huatanshaonian/EL-center/README.md

# MIS-01 复古终端：第一轮布局与零件模型

> **2026-10-20 注意：本文第 2、3 节描述的是第一轮布局，已经过时。** 现行资料：面板与斜面布局见 `面板方案.md`（布局 E11），整机分层与电源控制见 `MIS-01整机架构.md`，零件与型号见 `parts_list.csv`，机内空间见 `PCB安装与空间规划建议.md`，EL 显示见 `Sharp_LJ64K052_HDMI_EL_Engineering_Design_Note.md`。
> 与现状不符的主要几处：电源已是 **LRS-200-24 + NID100-12 + NID100-5**（不是 LRS-150-24 / NID65-12）；编码器等操作件已移到前下方斜面；盖革管定为 J305 + 自制盖革板（不是 SI-3BG / SBM-21）；仪表层控制器是 **ESP32-S3**。

单位均为 mm。生成工具为 CadQuery 2.8，所有零件都是参数化脚本，改 `parts.py` 里的 `SPEC` 后重新运行 `build_parts.py` 和 `assembly.py` 即可重新生成。

## 1. 文件

| 文件 | 内容 |
|---|---|
| `step/MIS-01_layout_assembly.step` | 整机布局装配体（AP214，105 个零件，带颜色）。SolidWorks 2020 中“打开 → STEP”会以装配体形式导入 |
| `step/parts/P01…P30_*.step` | 单个零件，局部坐标约定见 `parts.py` 文件头 |
| `png/` | 零件一览图、前/后等轴图、正视图、侧视图 |
| `parts.py` / `assembly.py` | 源码（每个零件函数里的 `SPEC` 是尺寸表） |

## 2. 布局方案（外形 320 W × 220 D × 420 H，2020 型材框架）

全局坐标：X 向右，Y 由前向后，Z 向上。框架前沿在 Y = 0，前面板外表面在 Y = −2。

| 区域 | Z 范围 | 内容 |
|---|---|---|
| 顶部 | 178–398 | **Sharp LJ64K052**，居中，前面板开有效显示区视窗；两侧 Z 形铝托架固定在立柱内侧槽上 |
| 管带 | 92–170 | 左侧 6 支 **IN-14**（管心 X = 33/56/83/106/133/156，按 HH:MM:SS 两两分组，管距 23），右侧水平放置的 **IV-18**（X 178–293）；前面板开 276 × 70 管窗 |
| 甲板（Z 90 处 2 mm 铝板） | 92–132 | 管后方是辉光管驱动板（6 片 K155ID1 + NCH6100HV），外加亚克力高压罩；IV-18 电源放在右侧 |
| 下舱 | 0–70 | 前部依次为 2 个 EC11 编码器、盖革管窗（SI-3BG + SBM-21，格栅开孔）、2 个按钮、2 个 SMA；后部左边是 **LRS-200-24**（端子端加亚克力罩），右边是 24 V 配电板 + NID100-12/NID100-5 载板 |
| 电脑层（Z 260 处铝板） | 262–300 | **Orange Pi 4**（接口朝后）、**Tang Primer 20K Dock + 核心板**（接口朝后）；后面板对应开接口窗 |
| 后面板 | — | 2 个 60 mm 排风扇（Z ≈ 340）、IEC C14 插座预留口（右下）、2 个 SMA 预留孔 |

这样布置的考虑：
- **高压隔离**：市电（LRS 端子）留在下舱后部，170 V 辉光管高压在甲板中部，两处都有罩子；前面板操作件只连接低压。
- **散热**：发热较多的 OPi、FPGA 和 EL 驱动板都在上层，靠后面板风扇排风、顶板开孔进风。LRS-200 是自然对流电源，放在底层，上方要留空间。
- **维护**：取下后面板就能拔插电脑层的线缆，三层托板各自可以独立拆装。

当前问题：屏幕背后（Y 30–200，Z 92–260）有大片空间没有利用。如果以后想把机身做小，可以把深度从 220 改到 180 左右，或者把电脑层降到甲板上。对应 `assembly.py` 里的 `D` 和 `Z_SHELF` 两个参数。

## 3. 零件状态（C = 资料确认，T = 暂定，需实物测绘或换官方模型）

| # | 零件 | 建模尺寸 | 状态与依据 | 建议 |
|---|---|---|---|---|
| P01 | Sharp LJ64K052 | 267×220×22 | 外形采用你提供的原厂图（C）；有效区 211.2×158.4 是按 640×480、0.33 点距推算的（T）；安装孔、接口位置为 T | 按原厂机械图修改 `SPEC`：孔位、有效区、接口 |
| P02 | Tang Primer 20K 核心板 | **67.6×30**×1.0 | 长宽为 C（Sipeed Datasheet V1.0，你表中写的 20 应为 30）；厚度和元件高度为 T | 用官方 3D 模型替换 |
| P03 | Tang Primer 20K Dock | 110×80 | **全部为 T**（官方页面没有给出板框尺寸） | **必须**用官方 3D 或实测数据替换 |
| P04 | Orange Pi 4 | 91×56 | 外形为 C；孔位暂按 58×49 孔距，接口位置为 T | 实测 |
| P05 | IN-14 | Ø19×55，13 根引线、长 35 | 外形、引线数为 C（tube-tester.com）；引线分布圆 Ø12 为 T | 实测引线分布 |
| P06 | IV-18 | 总长 115，Ø19 | 为 C（radiomuseum）；引线分布为 T | 实测 |
| P07 | SI-3BG | Ø10×55 | C（pocketmagic）；端帽为 T | — |
| P08 | SBM-21 | Ø6×16，总长 21 | C（pocketmagic） | — |
| P09 | K155ID1 | DIP-16 | 标准封装 | — |
| P10 | LRS-200-24（原 LRS-150-24） | 215×115×30 | 外形按规格书（见 parts_list.csv）；端子位置待实物核对 | 用 TraceParts STEP 替换 |
| P11/12 | NID100-5 / NID100-12（原 NID65-12；明纬正式型号是 NID100-5，没有"-05"） | 50.8×27.5×12 / 50.8×26×11 | 外形为 C；13 针 SIP、2.54 节距为 C；针在长边上的起始位置为 T | 按明纬图纸核对 |
| P13–15 | NCH6100HV、IV-18 电源、盖革高压 | 包络 | T（尚未选型） | 选型后替换 |
| P16, P26–30 | 配电板、EL 托架、管座 PCB、IV-18 PCB、驱动板、盖革 PCB | — | 自设计初版，尺寸由布局反推 | 导入嘉立创 EDA 作为板框参考 |
| P17–25 | 2020 型材、角码、T 螺母、铜柱、EC11、Ø16 按钮、SMA、风扇 | — | 截面和外形按常见规格简化 | 定下供应商后用厂家 CAD 替换 |

## 4. 需要自行下载的官方模型（本环境无法访问这些站点）

- Tang Primer 20K（核心板 + Dock）3D：https://dl.sipeed.com/shareURL/TANG/Primer_20K/08_Dimensions ，尺寸图在 `05_Dimensional_drawing`
- LRS-200-24 STEP：TraceParts 搜索 “LRS-200-24”，或者在明纬官网产品页下载
- 2020 型材、角码：MISUMI 型号 HFS5-2020 系列，或者你选定的国产供应商（注意 6 槽和 8 槽不通用）

替换方法：在 SolidWorks 中打开装配体，右键对应零件选择“替换零部件”，再按局部坐标约定重新配合。

## 5. 安全相关（布局阶段必须保留的）

- LRS 市电端子、IEC 插座到电源之间的走线全程绝缘，并且只在下舱后部走线；整机金属框架接 PE（FG 端子）。
- 170 V 辉光管电源、IV-18 的 20–30 V 电源，以及盖革管 350–460 V 电源都要加罩或者灌封，并在前面板背面留出爬电距离。
- 盖革管工作电压：SI-3BG 380–460 V，SBM-21 350–475 V（来源均为 pocketmagic）。两管电压范围有重叠，可以共用一路约 400 V 高压，但要各自串接阳极电阻。

## 参考

- Sipeed, *Tang Primer 20K Datasheet V1.0*（核心板 67.60 × 30.00 mm）
- MEAN WELL, *LRS-200 Series Specification*；*NID100 Series Specification*
- tube-tester.com, IN-14 data
- radiomuseum.org, IV-18
- pocketmagic.net, SI-3BG / SBM-21
