huatanshaonian/EL-center/Sharp_LJ64K052_HDMI_EL_Engineering_Design_Note.md

# Sharp LJ64K052：HDMI → EL 显示驱动工程设计笔记

版本：v0.3，设计输入 + PCB 任务书  
整理日期：2026-10-17 初稿；2026-10-18 按调研结果修订；2026-10-19 按 EL-IF D1.2 第一版 PCB 同步（Asia/Shanghai）  
目标平台：Orange Pi 4（HDMI 信号源）+ Tang Primer 20K 核心板 + Dock 底板 + 自制低压转接/电源板  
用途：作为原理图、PCB、FPGA 模块划分和分阶段调试的设计依据。**第 15 节是交给画板方（人或 AI）的完整 PCB 任务书，第 16 节是打板前的面包板验证方案。**

> **设计状态：架构已可展开；Dock 引脚分配已按官方原理图 3713 版给出（EL 用到的 Bank 3/7 VCCIO 已按原理图核实为 3.3 V，见 11.2.1）；电源方案已按实际库存（LRS-200-24 + NID100-12 + NID100-5）改写。上电波形验证完成前，不作为已验证的通电定稿。**
>
> **2026-10-20 实测：手上的 Dock 是 v3714，其 HDMI 口没有接收端接，不能直接收 Orange Pi 的 HDMI（见下方 v0.3.1）。**

### v0.3.1 实测更正（2026-10-20，FPGA 首次上板）

1. **Dock 实物为 v3714**（版本丝印在核心板插槽中间，要拔下核心板才看得到）。Sipeed 3714 原理图（2026-05-20，修改说明 "DVI optimize, SW0 and KEY4 pins were swapped"）与 3713 逐页对比：[S9]
   - **P004 HDMI：R15–R22 由 3713 的 49.9 Ω 上拉到 HDMI_3V3（接收端接）改为 499 Ω 下拉到 GND**（只适合做 HDMI 输出）。没有端接时 TMDS 线上没有摆幅：实测 Orange Pi 的 dw-hdmi PHY_STAT0 = 0x03（HPD=1、PHY 锁定、RX_SENSE 全 0），FPGA 的 TMDS 时钟脚完全没有信号（tang-monitor m5 调试程序报 PLL 未锁、重捕获次数 0）。v0.3 写的"3714 小改，此处相同"有误。
   - 第 5 颗键（丝印 S4）改接 **B10 = RECONFIG_N**，按下 FPGA 会重新从 Flash 加载；1 号拨码改接 C7（普通 IO）。"1 号拨码必须拨下"只对 3713 及更早成立。
   - S0–S2（T10/T3/T2）、6 个 LED、PMOD J5/J6/J14、HDMI 引脚分配、Bank 电压与 3713 相同，11.2.1 的分配不受影响。
   - tang-monitor 依据的是 3709 版原理图，它说的"零硬件改动"只在有 49.9 Ω 上拉的老板子上成立。
   - 对策：在 Orange Pi → Dock 的 HDMI 链路上补 8 × 约 50 Ω 上拉到 3.3 V，同时断开 18 脚（见 5.1）。
2. **U12 关闭**：Orange Pi 4（Armbian 26.11 trunk，内核 6.18.56）读得到 FPGA 的 EDID，但拒绝 25.175 MHz 的 640×480（模式列表为空、不输出）；换 27 MHz 自定义时序（总 858×525）后被接受，VPLL 与 dclk_vop0 均为 27 MHz。el_hdmi 给 Orange Pi 用时用 27 MHz 版 EDID。
3. **HDMI 18 脚反向供电**：Dock 的 HDMI_5V 由 +5V 经 D5 送到 18 脚。D5 只挡外部电流倒灌进 Dock，挡不住 Dock 往外送；Orange Pi 没上电时会被 Dock 经 18 脚供电（Pi 电源灯亮）。Pi 开机后它自己的 5V 更高，D5 截止。整机里这条 HDMI 链路应断开 18 脚。
4. apicula 生成的 .fs 缺少高云 `//` 注释头，高云 Programmer 加载不完成（报 "Error found!"）；`fpga/build.sh` 已自动补上（`fpga/scripts/fs_header.py`）。按键、LED（丝印编号与程序编号反序）、串口命令、帧缓存自检均已在实物上通过，详见 `fpga/el_hdmi/使用说明.txt` 第 8 节。

### v0.3 修订摘要（2026-10-19）

与 EL-IF D1.2 原理图和第一版 PCB 同步（详见 `el_driver/D1.2/变更记录_D1.2.txt`）：

1. PCB-1 尺寸由"≤ 80 × 60 mm"改为实际的 **100 × 100 mm**，安装孔中心距板边 5 mm（15.3）。
2. U_VD 限流电阻 RIL12 由 1.3 kΩ（无现货）改为 **1.2 kΩ**，限流 ≈ 2.78 A（原 ≈ 2.56 A）（10.1、15.3）。
3. J_PF 由 2 针改为 **3 针**：增加斜面"屏幕"开关输入 SCR_EN_3V3，开关拨到关时经 D4 硬件关 VD，并经 P3-12（J14-12）告诉 FPGA（11.2.1、15.2、15.3、15.5、15.7）。
4. 新增 J_LAMP：面板"屏幕供电"12 V 指示灯，跟随 +12V_EL（15.3）。
5. （2026-10-20）U03 关闭：按 Sipeed 核心板与 Dock 官方原理图，J5/J6/J14 所在 Bank 3/7 的 VCCIO 为 3.3 V，LVCMOS33 约束正确；v0.2 把 Bank 1 记成 2.5 V 有误，已更正（11.2.1、13）。

### v0.2 修订摘要（2026-10-18）

1. 查阅 Dock 官方原理图（3713）：HDMI 页标注 **HDMI_TX/RX**，接口侧 8 线各有 49.9 Ω 上拉到 HDMI_3V3（接收端接）、交流耦合电容、HPD/DDC/CEC 均接 FPGA；HDMI 5V 由 Dock 经肖特基 D5 输出，信号源 5V 不会反灌 Dock。tang-monitor 声称"零改动"可接收 640×480。[S9][S2]
2. tang-monitor 只报告了 Apple Silicon Mac 作信号源；**Orange Pi 4（RK3399）未验证**，旧版 Rockchip 内核对 25.175 MHz 像素时钟可能拒绝（见 5.1）。[S12]
3. Dock PMOD 电压已查清：J5、J6（B0–B4/HSYNC）、J14 在 Bank 3/7（3.3 V）；J6 的 VSYNC/DE 在 Bank 1（2.5 V），J12 为 DVP（可能 2.5 V）。引脚分配见 11.2。
4. 电源改为实际库存：LRS-200-24 → NID100-12（12 V 7.5 A）/ NID100-5（5 V 11 A）；Dock 自带 12 V DC 插座。见第 10 节。
5. 补充原厂遗漏点：模组内部保险 F1 800 mA、F2/F3 1.6 A（慢断），大容量电源或继电器直通上电的浪涌可能熔断 → **VD、VL 都必须软启动**。[S1，规格 p.16]
6. BSRAM 按块计算后双帧约占 38–40/46 块，偏紧（见 7.1）。
7. 屏型号已由用户确认为 **LJ64K052**（2026-10-18）；`parts.py`、`assembly.py`、`build_parts.py`、`parts_list.csv`、README、面板方案中的 LJ64H052 已统一改为 LJ64K052（3D 尺寸未改，见 11.3）。
8. 新增第 15 节 PCB 任务书、第 16 节面包板验证方案。
9. 术语："Dock"指 Tang Primer 20K 套件中的**扩展底板**（Sipeed 官方名 Tang Primer 20K Dock），FPGA 芯片在插于其上的 SO-DIMM 核心板上。本文"Dock 的 HDMI/PMOD"即底板上的接口。
10. 用户已有示波器，可调电源即将到位（2026-10-18），第 16 节据此调整。

## 1. 阅读规则与资料边界

全文使用以下标记，防止把参考实现和推算误当成屏幕规格：

- **[原厂]**：本次逐页查阅的 Sharp LJ64K052 原厂规格书中的事实，附章节/页码。
- **[参考]**：开源作者或开发板厂商对其板卡/项目的说明，仅在其适用范围内成立。
- **[方案]**：本工程建议采用的实现方式、器件候选和计算结果，尚未经本机实测。
- **[待核实]**：需要实物、完整电路审查、综合报告或仪器测试才能确定的内容。

对话来源为“确认UT61E加光耦USB”，会话 ID：`6ad23500-53d0-83ea-9579-66e5fe57986c`。本次读取接口只返回最后五轮，较早的屏幕讨论、原始上传件与助手正文未取回。因此：本文保留本次任务明确指定的 Tang Primer 20K + Dock、tang-monitor、HDMI2EL 路线；对引脚和参数重新查验公开原始资料，不声称完整复原了旧对话。末尾可见用户选定 ESP32-S3 开发板，但它在显示系统中的接口和职责尚不能从可见历史确认。

本次核心原厂资料为 **Sharp LJ64K052，LA-08203B，2000-08-08**，由第三方镜像保存的原厂扫描件，全文 25 个 PDF 页面。下文“规格 p.N”指纸面右上角页码，**PDF 页码 = 规格页码 + 4**。本文只摘录必要工程事实，原图、完整条件和公差仍以原件为准。[S1]

## 2. 首版设计结论

1. **[原厂]** LJ64K052 是 640 × 480 EL 自发光模组，已有显示控制和高压驱动电路；外部提供 +5 V、+12 V 和 11 路数字输入。项目以完整原装模组为前提，无需自行生成 EL 高压。[S1，规格 p.1、11]
2. **[方案]** 使用 Tang Primer 20K + **Dock** 的 HDMI 接口接收 640 × 480 视频；FPGA 内做单色化、整帧缓存和上下半屏并行扫描；外部转接板完成 5 V 电平输出、CN5 接线和电源控制。
3. **[原厂]** 该模组输入高电平下限为 **3.5 V**，低电平上限为 **1.5 V**。因此 FPGA 常见的 3.3 V/2.5 V 输出不能直接作为有保证的屏幕高电平，应做电平转换。[S1，规格 p.8]
4. **[原厂]** 8 路数据为 `UD[3:0]`、`LD[3:0]`，加 `CP2`、`CP1`、`S`；每个 CP2 下降沿同时送上、下半屏各 4 个像素；每行对 160 次传输，每帧 240 次行锁存。[S1，规格 p.6–9]
5. **[方案]** 首版采用 **1 bit/像素、双整帧缓存**；只做空间二值化/空间抖动。DDR3、时域灰度、更多输入分辨率暂留为扩展，避免首轮同时增加多个调试变量。
6. **[待核实]** 当前没有用户实物照片、板卡版本、负载波形和已验证 bitstream；本文提供设计依据和验收步骤，不代表该屏已点亮。

## 3. LJ64K052 原厂参数

### 3.1 面板与模组

| 项目 | 原厂规格 | 依据/说明 |
|---|---|---|
| 像素阵列 | 640 × 480 | 规格 p.1 |
| 有效区 | 211.1 × 158.3 mm | 规格 p.1、12；不采用简版目录中不同的舍入数值 |
| 点距 | 0.33 × 0.33 mm | 规格 p.1 |
| 模组外形 | 267 × 220 × 23.5 mm | 规格 p.1；详细公差、最大厚度见 p.12 |
| 质量 | 800 g | 规格 p.1 |
| 亮度 | 最小 25、典型 40 cd/m² | 规格 p.4，25°C、120 Hz、全亮条件；二手屏不保证仍达到此值 |
| 对比度 | 最小 33:1、典型 50:1 | 规格 p.4–5，指定测量条件 |
| 工作温度 | -5 至 +55°C | 规格 p.2 |
| 储存温度 | -40 至 +80°C | 规格 p.2 |
| 帧率 | 60–120 Hz | 规格 p.7；不要把 120 Hz 写成唯一允许值 |
| 供电 | 逻辑 +5 V；面板驱动 +12 V | 规格 p.1、3 |

以上为 **[原厂]** 数据。[S1]

### 3.2 电源与逻辑限制

| 项目 | 规定值 | 设计含义 |
|---|---|---|
| VL 正常工作范围 | 4.75–5.25 V | 在屏幕 CN5 引脚处验收，包含线束/开关压降 |
| VD 正常工作范围 | 11.4–12.6 V | 同上，不能只量适配器空载端 |
| IL | 30–300 mA，VL=5 V | 电源设计至少覆盖上限，另计转换器等负载 |
| ID | 最大 1800 mA，VD=12 V | 启动浪涌、动态峰值需另测 |
| 模组总功率 | 典型 12 W | 表格条件为 25°C、120 Hz；不是最大功率承诺 |
| 输入 VIH / VIL | ≥3.5 V / ≤1.5 V | 数字输入须有可靠的 5 V 电平驱动 |
| 信号绝对范围 | 下限 -0.3 V，上限 VL+0.3 V | 包括过冲、掉电时的外部驱动 |
| VL / VD 绝对最大值 | +7 V / +14 V | 不是允许长期工作的供电值 |

以上为 **[原厂]** 数据，规格 p.1、3、8。[S1] 数据表还注明输入信号停止时面板驱动电流约 10–20 mA，但这不能作为任意异常时序下都安全或“全黑功耗”的保证。

**[原厂] 模组内部保险（规格 p.16）：** F1 800 mA、F2 1.6 A、F3 1.6 A，均为慢断（S.O.C 制 MMCT）。原厂注明：电源容量大，或用继电器直接给模组上电时，浪涌电流可能使保险熔断；建议电源能提供保险额定值 1.5–2 倍的电流。**[方案]** 因此 VD、VL 两路都必须有受控软启动（dV/dt 限制），禁止用继电器/普通开关直接把 NID 模块输出接到 CN5。

**[原厂]** 模组内部存在约 200 V 的交流脉冲，断电后也可能残留高压；禁止带电插拔输入线束，不触碰背面驱动板。[S1，规格 p.13] 本工程测试点只布置在外部低压电源和逻辑接口，不把原模组高压部分引到自制板。

## 4. CN5 接口：可用于绘制屏幕侧符号的已核对引脚

以下为 **[原厂]** CN5 引脚分配，来自规格 p.10，**不是其他 Sharp EL 型号的通用接线表**。[S1]

| CN5 针号 | 信号 | 相对屏幕方向 | 建议网络名 |
|---:|---|---|---|
| 1 | UD1 | 输入 | EL_UD1_5V |
| 2 | UD0 | 输入 | EL_UD0_5V |
| 3 | UD3 | 输入 | EL_UD3_5V |
| 4 | UD2 | 输入 | EL_UD2_5V |
| 5 | LD1 | 输入 | EL_LD1_5V |
| 6 | LD0 | 输入 | EL_LD0_5V |
| 7 | LD3 | 输入 | EL_LD3_5V |
| 8 | LD2 | 输入 | EL_LD2_5V |
| 9 | CP2 | 输入，数据时钟 | EL_CP2_5V |
| 10 | GND | 电源回流/逻辑参考 | GND |
| 11 | CP1 | 输入，行锁存/扫描推进 | EL_CP1_5V |
| 12 | GND | 电源回流/逻辑参考 | GND |
| 13 | S | 输入，扫描起始 | EL_S_5V |
| 14 | GND | 电源回流/逻辑参考 | GND |
| 15 | GND | 电源回流/逻辑参考 | GND |
| 16 | GND | 电源回流/逻辑参考 | GND |
| 17 | +5 V | VL 电源输入 | +5V_EL |
| 18 | +5 V | VL 电源输入 | +5V_EL |
| 19 | +12 V | VD 电源输入 | +12V_EL |
| 20 | +12 V | VD 电源输入 | +12V_EL |

原厂排列图按行显示如下；此图仅说明编号关系，**不能替代实物插合视角和线束图**：

```text
奇数排： 1   3   5   7   9  11  13  15  17  19
偶数排： 2   4   6   8  10  12  14  16  18  20
```

### 4.1 连接器与线束

- **[原厂]** 模组侧针座：Hirose `DF11-20DP-2DS` 或等效品；配套线端壳：`DF11-20DS-2C`；规格书列出的压接端子：`DF11-2428SC`。[S1，规格 p.10]
- **[参考]** Hirose DF11 系列为 **2.0 mm 间距、双排**；20 位线端壳页面及系列资料见 [S7]。它不是普通 2.54 mm IDC 插头。
- **[原厂]** 电缆长度不超过 **50 cm**；全部信号、电源和 GND 端子均须连接。[S1，规格 p.10]
- **[方案]** 原型优先使用短线束，建议约 10–20 cm；分别并接 17/18、19/20，所有 GND 都落地。电源线径按总电流、温升和所选压接端子适配线规确定。
- **[待核实]** 确认屏幕实物是否保持原装 CN5；核对防呆结构、1 脚标记、线端出线面与插合面是否镜像。购买端子时核对完整后缀、镀层、线规和压接工具，不仅凭壳体名称。
- **[参考]** DF11-2428SC 端子额定 2 A/针，适配 AWG24–28；19/20 两针并联承载 VD 最大 1.8 A 有余量，电源线建议 AWG24。有分销商标注该端子停产，下单前确认货源（可买预压端子线）。[S14]
- **[方案]** 线束两端都用 DF11-20DS-2C 壳 + 端子，**按针号 1↔1 … 20↔20 直连**（按编号接线，不存在镜像问题）；自制板上用与模组相同的 DF11-20DP-2DS 针座。

线束交付件应有：两端连接器视图、1 脚位置、每根线的针号/网络、线色、线径、长度、通断测试表。CN5 带有 +12 V，方向错误可能直接损坏逻辑电路。

## 5. 系统架构与职责

以下整体为 **[方案]**：

```text
电脑 / NAS 配套主机的 HDMI 输出
              │ TMDS + DDC/EDID + HPD
              ▼
Tang Primer 20K + Dock（沿用板上 HDMI 电路）
  ├─ EDID/HPD 状态机：首版宣告 640×480 标准视频模式
  ├─ TMDS 时钟恢复、解串、字对齐、RGB/DE/同步解码
  ├─ 几何检查与 RGB → 单色二值化（可选空间抖动）
  ├─ BSRAM：1 bpp 双整帧缓存 + 跨时钟域所有权交接
  └─ 独立 EL 扫描：UD/LD + CP2 + CP1 + S
              │ 11 路，按实际 VCCIO 输出
              ▼
自制转接板
  ├─ 11 路单向 5 V 电平缓冲、默认关闭、源端串阻预留
  ├─ 屏幕电源开关 / 电源良好检测 / 故障处理
  ├─ 5 V 与 12 V 滤波、保护、测试点
  └─ CN5 对应的 20 芯线束接口
              ▼
原装 LJ64K052 模组（保留显示控制及高压电路）

LRS-200-24（24 V）→ PCB-3 配电板
   ├→ NID100-12（12 V）→ PCB-1 eFuse 软启动 → +12V_EL（VD）
   │                  └→ Dock 12 V DC 插座（Dock 自带降压到 5 V）
   ├→ NID100-5（5 V） → PCB-1 eFuse 软启动 → +5V_EL（VL、缓冲器）
   └→ 24 V 掉电预警比较器 → PFAIL_N → PCB-1（立即关 VD）/ Orange Pi

可选 ESP32-S3 ── UART / SPI ── FPGA：设置、状态、联网控制
```

首版建议把主机视频生成与硬件扫描分开：主机负责界面和动画，FPGA 负责稳定接收、缓存和点屏。**ESP32-S3 暂列可选控制器**，不放在 HDMI 实时解码或必需扫描链路中；其 Wi-Fi/NAS 协调功能可在主链路工作后加入。不得把可见历史中的开发板购买选择等同于已确定的 SPI 协议或接线。

### 5.1 HDMI 前端的边界

- **[参考]** tang-monitor 作者在 Tang Primer 20K + Dock 上报告了 HDMI 接收、EDID 和 TMDS 解码成功；原输出目标是 480 × 272 RGB LCD，不是 EL。[S2]
- **[方案]** 移植其 HDMI 前端和调试方法，在 RGB/DE 解码后接本工程缓存；移除其 480 × 272 缩放/LCD 输出路径。首版输入保持 640 × 480，不必缩放。
- **[待核实]** Dock 和核心板硬件版本、HDMI 接口耦合/终端/偏置、各 Bank 实际电压、所选工具链能否复现接收。接收成功经验不是 HDMI 电气合规认证。
- **[实测，2026-10-20]** 手上的 Dock 是 **v3714，HDMI 口无接收端接**（R15–R22 为 499 Ω 下拉，见 v0.3.1）。HDMI 信号源（RK3399 等）是电流型开漏输出，必须由接收端经 50 Ω 上拉到 3.3 V 才有摆幅。**[方案，待讨论]** 在 Orange Pi → Dock 链路的 Dock 端补 8 × 49.9 Ω 上拉到 3.3 V（3.3 V 由 Dock 18 脚 5V 经 LDO 得到，约 0.1 A），18 脚不往 Pi 方向传。Dock 上的 499 Ω 下拉保留时，线上静态约 3.0 V、单端摆幅约 450 mV，仍在 HDMI 接收范围内。临时验证可用 HDMI 公/母转接板手工连接。
- **[方案]** 初版限定未加密、兼容 DVI 视频的视频流；音频、CEC、HDCP、HDR 和高分辨率输入不列入验收目标。
- **[方案]** 无 HDMI 或失锁时继续输出本地黑场/测试图，不让外部视频失锁直接破坏 EL 行/帧时序。

**v0.2 补充：**

- **[参考/原理图]** Dock 3713 原理图 P004 页标题为 "HDMI_TX/RX"：接口侧 HD0–2/HCK 各有 49.9 Ω 上拉到 HDMI_3V3（+3V3 经 1N5819WS 得到），100 nF 交流耦合，FPGA 侧差分对之间 100 Ω；HPD 由 FPGA 经 22 Ω/5.1 kΩ 驱动；DDC/CEC 经 2N7002 电平转换，DDC 上拉到 HDMI_5V；HDMI_5V 由 +5V 经 1N5819WS（D5）提供，**信号源的 5V 不会反灌进 Dock**。[S9]
  **[2026-10-20 更正]** 以上 49.9 Ω 上拉只适用于 3713 及更早；**3714 改成了 499 Ω 下拉到 GND，没有接收端接**。另外 D5 不阻止 Dock 往 18 脚送 5V，未上电的信号源会被反向供电（v0.3.1）。
- **[参考]** tang-monitor README：直接把电脑插 Dock HDMI 口，零硬件改动；EDID 宣告 640×480 DVI-only；用 TLVDS_IBUF + rPLL ×5 + CLKDIV + IDES10；开源工具链 yosys/nextpnr-himbaechel/apicula；作者测试信号源为 Apple Silicon Mac；MIT 许可。其 pinmap 记录 HDMI 在 Bank 0/1（2.5 V），TMDS 时钟对不在 GCLK 脚上。[S2][S3]
- **[原厂，v0.3 更正]** 按核心板原理图，Bank 0/1 共用 VCCO0&1 = **3.3 V**，板上没有 2.5 V。约束里的 `BANK_VCCIO=2.5` 沿用自 Sipeed Cam2HDMI 例程，是写给工具看的标签，不是实际电压。Sipeed 的 `HDMI/dk_video.cst` 对同样的球位就用 LVCMOS33。Gowin DS102 表 2-2 允许 3.3 V bank 使用 LVDS25 差分输入；2.5 V 只是 LVDS 输出的要求。el_hdmi 暂时保持与 tang-monitor 相同的声明，因为电气上无害，而且已有实测成功的先例。等第一次上板 HDMI 锁定以后，再试改成 `BANK_VCCIO=3.3`。
- **[实测，U12 已关闭（2026-10-20）]** 旧版 Linux `dw_hdmi-rockchip.c` 的 `mode_valid` 要求像素时钟与 MPLL 表项**完全相等**，表项从 27 MHz 起，640×480 的 25.175 MHz 可能被拒。[S12] 实测 Orange Pi 4 的 Armbian 内核 6.18.56 仍然拒绝 25.175 MHz（读到 EDID 但模式列表为空），接受下面的 27 MHz 时序。
- **[方案，已采用] 27 MHz 时序：** EDID 只宣告一个自定义详细时序——有效 640×480、总 858×525、像素时钟 27.000 MHz（59.94 Hz）。FPGA 只按 DE 取有效像素，不受总时序影响。
- **[参考]** HDMI2EL 经验：Windows ClearType 灰边二值化后字体断笔（Linux 侧用点阵控制台字体/关闭抗锯齿）；BRAM 读延迟导致每行首组像素丢失（作者未修复）；输入 PTC 发热造成闪烁（作者短接了 PTC，本工程不照搬，改用 eFuse）；一片电平转换芯片损坏出现竖线。[S4]

## 6. 两个开源项目的复用范围

| 项目 | 已核对的参考范围 | 本工程拟复用 | 不可直接沿用 |
|---|---|---|---|
| [tang-monitor](https://github.com/kami4ka/tang-monitor) | 作者报告 Primer 20K + Dock 接收 HDMI，驱动 480×272 LCD | EDID/DDC、HPD、TMDS 接收、分层调试、Bank/约束排查 | LCD 时序、缩放比例、16 行环形缓存、genlock 比例 |
| [HDMI2EL](https://github.com/MNDJ777/HDMI2EL) | 作者目标是 LJ64HB34，640×400、120 Hz，Zynq-7020 平台 | EL 扫描发生器和帧数据组织的思路、转接板参考 | 屏幕型号、400 行、半屏 200 行、Xilinx IP/原语、引脚、供电实测值 |

以上为 **[参考]**，迁移策略为 **[方案]**。[S2][S4]

HDMI2EL 的 `rtl/timing_gen.v` 明确写有半屏 `Y_RES=200`，并有位序反转、固定地址计算和 RAM 延迟补偿。移植时必须检查全部相关计数宽度、地址深度、半屏偏移和同步条件；仅把一个参数改为 240 不等于完成适配。[S5]

**缓存差异是架构差异：** tang-monitor 的少量行缓存依赖其特定 LCD 扫描/同步关系。本屏同一时刻需要图像第 y 行和第 y+240 行的数据，首版使用整帧缓存更直接；不能把该项目“不需要整帧缓存”的结论照搬到本工程。

**[方案]** 开始 RTL 移植前固定两个仓库的 commit、工具链版本和板卡版本，存入工程 README；当前本文链接为可变的 `main`/仓库入口，未固定 commit。代码复用须按实际仓库 LICENSE 保留相关说明。

## 7. 帧缓存与单色化

### 7.1 容量核算

以下均为 **[方案/推算]**，1 KiB = 1024 bytes：

| 组织 | 容量 | 对本平台的意义 |
|---|---:|---|
| 640×480，1 bpp，单帧 | 307,200 bit = 38,400 B = 37.5 KiB | 可用于最初缓存测试 |
| 640×480，1 bpp，双帧 | 614,400 bit = 76,800 B = 75 KiB | 首版目标 |
| 640×480，2 bpp，单帧 | 614,400 bit = 75 KiB | 已等于 1 bpp 双帧；更多灰度会增加存储压力 |
| 640×480，8 bpp，单帧 | 2,457,600 bit = 300 KiB | 超过该 FPGA 的片上 BSRAM 规模 |

**[参考]** Sipeed 列出 GW2A-LV18PG256C8/I7 有 46 块 BSRAM、总量标为 828K bit。[S6] 不能把该值误读为 828 KB。1 bpp 双帧在原始容量上可行，但 RAM 宽深配置、块取整、接收 FIFO、EDID 和其他模块会额外占用资源；以实际综合和布局报告确认可用余量。

**[方案/推算] 按块取整：** 每块 18 Kbit，按 2K×8 配置时，把 UD nibble 与 LD nibble 拼成 8 bit 存同一地址，每帧 38,400 字 → 38,400/2,048 = 18.75 → **19 块/帧，双帧 38 块**；按 4K×4 分上下半屏存则每半屏 10 块，双帧 40 块。剩余 6–8 块给 EDID ROM 与接收侧，可行但偏紧。退路依次为：① 单帧缓存 + EL 帧率锁定输入（genlock，允许少量撕裂）；② 使用核心板 DDR3。

### 7.2 建议的存储布局

采用 A/B 两帧，每帧再分 upper/lower 两个半屏存储区，每个半屏：

```text
240 行 × 每行 160 组 × 每组 4 bit = 153,600 bit
地址 a = 160*y + g
y = 0..239，g = 0..159，地址范围 0..38,399（至少 16 bit）

upper[a] 保存整幅图像行 y、列 4*g..4*g+3
lower[a] 保存整幅图像行 y+240、列 4*g..4*g+3
```

写端按 HDMI 有效像素计数，4 像素聚成一个 nibble 再写入对应半屏；读端用同一地址同时取得 UD/LD 两组数据。两个视频时钟域通过双时钟 RAM 和明确的帧所有权协议隔离。也可用 8 bit 存储打包两个 nibble，但要重新核对读写宽度、读延迟和块资源；不能把存储布局变化隐含在位序接线里。

### 7.3 双缓存与跨时钟域交接

1. 写端只写 back buffer；只有接收完整、尺寸正确的一帧后才发布 `frame_ready` 和稳定的 buffer ID。
2. 读端只在 **EL 帧边界**切换 front buffer；前后两半屏必须同时切换。
3. 使用 request/acknowledge 或等效 toggle 同步协议；buffer ID 在握手期间保持不变，不能逐位随意同步一个正在变化的多位总线。
4. 写端收到“旧 front 已释放”的确认后才可复用它；未释放时跳过整幅输入帧，不能覆盖正在显示的帧或只写半帧。
5. 没有新完整帧就重复当前 front；HDMI 丢锁、截断帧和尺寸异常均不发布 `ready`。
6. 两域分别同步释放复位；RAM 未初始化时先显示本地图案，等待完整帧就绪。

60 Hz 输入、120 Hz 输出通常会重复图像，但真实输入可能是 59.94 Hz，不能依赖“每两次 EL 刷新一定对应一次新帧”。独立时钟下允许整帧丢弃/重复，验收目标是完整帧和无撕裂，而不是默认锁频。

### 7.4 像素处理

**[方案]** 首先使用可调阈值。可选整数亮度近似：`Y = (77*R + 150*G + 29*B) >> 8`，再用 `Y >= threshold` 产生单色像素。该公式为实现建议，不是面板要求。后续增加固定空间 Bayer 抖动；时域灰度需另行验证闪烁、帧率、亮度与功耗，不纳入首版。

## 8. 双扫描映射与 EL 时序

### 8.1 已核对的像素位序

**[原厂]** 根据规格 p.9，屏幕从左到右的每组四个像素依次对应 **UD3、UD2、UD1、UD0**，下半屏相同。[S1]

以软件/缓存采用零基坐标 `P(x,y)` 为例：

```text
UD3 = P(4*g + 0, y)       LD3 = P(4*g + 0, y + 240)
UD2 = P(4*g + 1, y)       LD2 = P(4*g + 1, y + 240)
UD1 = P(4*g + 2, y)       LD1 = P(4*g + 2, y + 240)
UD0 = P(4*g + 3, y)       LD0 = P(4*g + 3, y + 240)

g = 0..159；y = 0..239
```

第一组是原厂一基编号的上半屏第 1 行第 1–4 列与下半屏第 241 行第 1–4 列；最后一行对为第 240/480 行。不是奇偶行交织，也不是上下两半屏轮流发送。

若缓存定义 `nibble[3:0] = {最左、次左、次右、最右}`，则可直接对接 `UD[3:0]`/`LD[3:0]`；若缓存定义相反，要在读出端明确翻转一次。禁止在打包、RTL、原理图三处重复“纠正位序”。

### 8.2 信号含义与原厂时序边界

- **[原厂] CP2**：UD/LD 在下降沿被采样；数据 H 为亮、L 为灭。
- **[原厂] CP1**：下降沿进行行数据锁存并控制逐行扫描。
- **[原厂] S**：扫描起始信号，须在对应 CP1 下降沿前后满足建立/保持要求；不能简单当成标准 VGA VSYNC。
- **[原厂]** 每行对有 160 个 CP2 脉冲，每帧保留 240 个 CP1 脉冲；应尽量缩短垂直空白，以免中间第 240/241 行附近闪烁。

依据：规格 p.6–9。[S1]

| 量 | 原厂下限/范围 | 说明 |
|---|---:|---|
| 帧率 | 60–120 Hz | 完整 EL 帧 |
| CP2 周期 | ≥154 ns | 由此推算 CP2 上限约 6.49 MHz；不是建议贴近上限工作 |
| CP2 高、低电平宽度 | 各 ≥60 ns | 还需满足边沿要求 |
| CP1 周期 | ≥31 µs | 一次行对扫描的周期 |
| CP1 高电平宽度 | ≥60 ns | 不等于 CP1 的整个周期 |
| 数据建立时间 tSU | ≥50 ns | UD/LD 对 CP2↓；S 对 CP1↓，见图 |
| 数据保持时间 tH | ≥40 ns | 同上 |
| CP2↓ → CP1↑，tS21 | ≥0 ns | 最后一组数据与锁存的相对关系 |
| CP1↓ → CP2↓，tS12 | ≥200 ns | 下一行对首个采样边沿 |
| CP1↓ → CP2↑，tS13 | ≥100 ns | 下一行对首个时钟上升沿 |
| 时钟上升/下降时间 | ≤30 ns，且受周期公式约束 | 规格 p.7：`(TCP2 - tCWH - tCWL)/2` 不超过 30 ns |

所有时序验收点均为**经过电平转换和线束后的屏幕接口**，不能只量 FPGA 引脚。原厂时序图见 [S1，PDF 第 12 页/规格 p.8]。

### 8.3 可实施的首版时序候选

以下全部是 **[方案/推算]**，用于写状态机和检查预算，不是原厂推荐寄存器值：

- FPGA 内部 EL 时钟候选 54 MHz，由板上参考时钟生成；实际 PLL 参数和稳定性待验证。
- CP2 每周期 10 个内部 tick，高 5 tick、低 5 tick，得到 5.4 MHz；周期约 185.19 ns，高/低约 92.59 ns。
- 数据在 CP2 上升沿附近更新，下一下降沿采样。名义建立/保持约 92.59 ns，仍要扣除寄存器、缓冲延迟差和线束偏差。
- 一行对发 160 组，有效传输预算约 29.63 µs。
- 60 Hz：每行对 3750 tick，约 69.444 µs；120 Hz：每行对 1875 tick，约 34.722 µs；每帧固定 240 行对，无额外垂直空白。
- CP1 高脉冲可取 8 tick，约 148.15 ns；数据传完以后、行末产生 CP1 下降沿。
- 以 CP1↓ 为新行周期起点，至少等待 8 tick（148.15 ns）再发首个 CP2↑；再过 5 tick 才发生 CP2↓，合计约 240.74 ns，名义上覆盖 tS13/tS12 下限。
- 当刚传输完的行为 `y=0` 时，S 跨越其锁存 CP1↓ 为高；其他行锁存时为低。S 建立/保持均留出大于 50/40 ns 的余量。

状态机流程：`等待/保持 → 预取并输出160组UD/LD → 锁存前间隔 → CP1高 → CP1下降沿锁存 → 下一行对`。S 与首次有效行对锁存对齐；复位后先装载第一行数据再开始有效帧，不把 RAM 预取延迟造成的空数据当成第一行。

首轮在 60 Hz 下验证，之后再切到 120 Hz 检查电流、亮度和温升。不得把 HDMI 的 800×525 总时序或输入 H/V 消隐直接复制到 EL。

## 9. 电平转换与输出保护

### 9.1 器件候选

**[方案]** 使用两片 `SN74AHCT245`，共 16 路，覆盖 11 路单向输出；A 接 FPGA，B 接屏幕，DIR 固定为 A→B。一片处理 8 路 UD/LD，另一片处理 CP2/CP1/S；其余输入固定到有效电平，未用输出悬空。

**[参考]** TI 数据手册给出的 SN74AHCT245 工作电源为 4.5–5.5 V，VIH 最低 2 V，适于把 3.3 V 数字信号转换为 5 V 输出；DIR=H、/OE=L 时为 A→B。[S8] 其规格可支持此处的器件候选，但本板电压、温度、负载和时序仍须验算。

具体要求：

- 缓冲器电源采用与屏幕逻辑电源关联的 `+5V_EL`，防止屏幕 VL 断电但缓冲仍向其灌入高电平。
- FPGA 侧优先选择已确认的 3.3 V Bank；若使用 2.5 V 引脚，也必须核算 FPGA 最坏 VOH 对 2 V 输入门限的余量。1.5 V Bank 不能据此直接驱动 AHCT 输入。
- /OE 在 FPGA 未配置、复位、掉电和故障状态必须保持关闭（或输出恒低）。**v0.2 定案：** /OE 由 FPGA 的 OE_N 直接驱动、10 kΩ 上拉到 Dock 3V3，见本节末"v0.2 补充"；不要把 /OE 上拉到 5 V 再接 FPGA IO。
- /OE 的逻辑条件 `FPGA_CONFIGURED AND EL_TIMING_VALID AND NO_FAULT` 由 FPGA 内部实现；VL 条件由"缓冲器由 +5V_EL 供电"天然保证。
- 每片就近放置 100 nF 去耦，旁边预留局部储能电容；DIR、未用输入不得悬空。
- 输出靠缓冲器预留独立串阻焊位，初选 22–47 Ω/可替换 0 Ω；数值以屏幕端波形决定。屏幕原厂输入示意已有 11 路各 390 Ω 串联电阻，[S1，规格 p.15] 不应盲目叠加大阻值或电容。
- 两片器件间的传播延迟差、通道负载差须计入数据与 CP2 的建立/保持预算。

**[待核实]** 实际采购厂商、完整型号、封装、电源关断容忍能力、输出 VOH/VOL 与所选下拉电阻负载。本文不假定任意“74AHCT245 兼容品”都有相同掉电行为。普通 5 V 供电的 74HC 系列不能只凭名称相似替代 AHCT；开漏 I²C 小板也不作为此 11 路推挽视频接口的默认实现。

**v0.2 补充：**

- **[方案]** 74**HCT**245（VIH 2.0 V）与 74AHCT245 都可用；面包板阶段用 DIP-20 直插版，PCB 用 SOIC-20。
- **[方案]** 缓冲器由 +5V_EL 供电，其输出不可能高于 VL，"信号 ≤ VL+0.3 V"天然满足，因此 /OE 不需要再与 VL 状态做硬件与门。
- **[方案]** 缓冲器 A 侧（FPGA 侧）每路串 **1 kΩ**：若 AHCT 未上电而 FPGA 已输出 3.3 V，限制经输入保护结构的电流（≤3 mA）；1 kΩ × 约 4 pF ≈ 4 ns，对时序无影响。若确认所选器件规定了 Ioff 掉电隔离，可换 0 Ω。A 侧每路 100 kΩ 下拉，Dock 断电时输入为确定低电平。
- **[方案]** /OE 直接由 FPGA 的 **OE_N（低有效）** 驱动，10 kΩ 上拉到 Dock PMOD 的 3V3。FPGA 配置期间 Gowin IO 默认弱上拉 → /OE 为高 → 关闭，天然失效安全；Dock 断电时 /OE 为低但 A 侧全为 0，输出恒低，等同"无信号"。
- **[方案]** 不可用的器件：CD4000 系列（5 V 供电时 VIH≈3.5 V，3.3 V 认不出，且边沿远慢于 30 ns）；分立三极管电平转换（饱和存储时间 + 上拉 RC，边沿上百 ns，CP2 不满足 ≤30 ns）。

### 9.2 默认电平与控制信号

**[方案]** 预留屏幕侧弱下拉，使缓冲关闭时数据为 0、CP1/CP2/S 不浮动；候选 47–100 kΩ，最终按输入漏电、噪声和输出负载确认。配置前停止扫描且 VD 关闭，进入正常显示后持续产生完整时序；停机时先关 VD，再停止信号，最后关 VL。

除 11 路显示输出外，原理图还应预留缓冲使能、VD 开关使能及电源状态输入。HDMI、JTAG、调试 UART 与可选 MCU 的 IO 均须在引脚预算中单列。

## 10. 电源架构与上/下电

### 10.1 功率预算与电源树

> **v0.2：本节原"12 V 主电源 + 降压 5 V"方案作废，按实际库存改为下列电源树；原预算公式仍有效。**

**[参考] 库存电源（明纬 NID100 规格书 2024-10-30）[S10]：**

| 模块 | 输出 | 输入范围 | Remote（RC 对 COM） | 其他 |
|---|---|---|---|---|
| LRS-200-24 | 24 V / 8.8 A | AC 115/230 V | — | 市电侧必须接 PE |
| NID100-12 | 12 V / 7.5 A（90 W） | **20–53 V** | 1.2–12 V 或悬空 = 开；<0.4 V 或短路 = 关 | 过载 120–300 % 打嗝；建议输入保险 8 A |
| NID100-5 | 5 V / 11 A（55 W） | **10.5–53 V** | 同上 | 同上 |

**[方案] 电源树：**

```text
AC → LRS-200-24 → 24V ──┬─ F(8A) → NID100-12 → 12V ─┬─ PCB-1 U_VD(eFuse, 软启动, 限流≈2.8A) → +12V_EL → CN5 19/20
                        │                            ├─ Dock 12V DC 插座（DC-036A，Dock 板载降压到 5V）
                        │                            └─ 其他 12V 负载（按整机计划）
                        ├─ F(8A) → NID100-5 → 5V ───┬─ PCB-1 U_VL(eFuse, 软启动, 限流≈0.8A) → +5V_EL → CN5 17/18 + 缓冲器
                        │                            └─ Orange Pi 4 / 其他 5V 负载
                        └─ PFAIL 比较器（24V < 约21V → PFAIL_N 拉低）→ PCB-1 关 VD；另一路给 Orange Pi
```

**[推算] 掉电顺序天然有利：** NID100-12 输入低于 20 V 即失稳，NID100-5 可工作到 10.5 V，所以 24 V 跌落时 12 V 先掉、5 V 后掉，符合原厂"VD 先关、VL 最后关"。PFAIL 比较器在 21 V 时就硬件关 VD，使 VD 在信号停止前关闭（T4≥0）；Dock 由 12 V 供电，其板载降压在 12 V 塌陷后才停，信号随后停止；VL 最后掉（T2≥0）。以上为推算，须按阶段 B 实测波形确认。

**[参考/原理图]** Dock 3713 原理图 P007 页：DC-IN 插座 J13（DC-036A-2.5A-2.0）→ EUP3458 降压 → 经 DSK24 肖特基并入 +5V，与 USB 5V 二极管或接。[S9] 因此 Dock 可直接由 12 V 供电。**[待核实]** 12 V 与 USB 同时连接时，降压输出经 DSK24 并入 +5V 后是否会向电脑 USB VBUS 反灌，未从原理图确认（USB 口 VBUS 接法未逐网核对），按阶段 B 实测。

原"12 V 主电源"方案的器件选型要求（额定值、限流、浪涌、压降、热）仍适用于上述 eFuse 和端子。

按原厂各支路电流上限作保守预算：

```text
面板12V支路预算：12 V × 1.8 A = 21.6 W
面板5V逻辑预算： 5 V × 0.3 A = 1.5 W
合计支路预算：23.1 W（不等于原厂“最大总功率”规格）

12V输入电流预算 = 1.8 A
                + (面板5V功率 + Dock功率 + 缓冲/控制器功率)/(12 V × 降压效率)
                + 启动/动态余量
```

Dock 和可选 ESP32-S3 功耗尚未实测，5 V 降压器、输入保护、插头和线径不能在缺少此项时最终冻结。电源开关、保险/电子保险、降压器须同时检查额定值、限流特性、浪涌、压降及热条件。

**[方案]** 使用分支保护：输入反接/过流保护 → 原始 12 V；一路经受控高边开关到 `+12V_EL`，一路降压到 5 V，再分屏幕/缓冲与开发板支路。分别预留电流测量位置和电源良好信号；信号地和各供电回流共参考，避免 EL 大电流回流与 HDMI/逻辑共用细窄路径。

Dock 供电要核对官方原理图和 USB 接线，尤其是外部 5 V 与电脑 USB VBUS 是否可能互相反灌。HDMI 的 5 V 引脚不承担屏幕供电；PMOD 电源针也不直接承担 EL 的整机负载。

### 10.2 原厂明确要求的电源时序

**[原厂]** 规格 p.16 要求 T1–T4 ≥0，含义是：VL (+5 V) 的有效供电时间覆盖输入信号及 VD (+12 V) 的有效时间。图中没有给出一个通用的“必须延迟 10 ms”数值，也不能由此断言必须固定采用某个信号与 VD 的先后间隔。[S1]

**[方案]** 可按以下顺序实现，并在掉电/欠压时由硬件支持：

```text
上电：保持VD关闭、/OE关闭
   → 建立屏幕VL，确认稳定
   → FPGA配置完成，准备完整黑场扫描
   → 使能缓冲并确认时序有效
   → 使能VD

正常关机：关闭VD并确认下降
       → 停止/隔离输入信号
       → 最后关闭VL
```

若 12 V 主电源突然拔出，降压后的 5 V 可能比 VD 更早跌落，因此不能仅靠软件关机顺序。应设计 VD 快速关断、5 V 保持/放电、反向隔离或其他合适措施，使实际波形仍满足原厂关系；保持电容可按 `C ≥ I × Δt / ΔV` 初算，再结合整个支路、开关和欠压阈值验证。仅给电源网络命名不能保证时序。

**[原厂]** 规格 p.17 对 5 V 电源穿越 2.5–4.5 V 区域的上升/下降过程建议 ≤100 ms，图示掉电/重启间隔 `ti ≥1 ms`。[S1] 应按原图定义测量，不能把 ti 当成“任何节点低电平维持 1 ms 即可”。

**[待核实]** 软启动、限流阈值、保险型号、VD 放电、5 V 保持时间及原模组保险状态。HDMI2EL 的其他型号实测功率和其 PTC 调试处理不能用作本机电源定额，也不作为短接保险的设计依据。

**[方案] v0.2 硬件时序实现（详细电路见 15.3）：**

| 原厂要求 | 实现方式 |
|---|---|
| T1：VL 先于输入信号 | 缓冲器由 +5V_EL 供电，VL 不在时输出不可能有电平 |
| T3：输入信号先于 VD | VD 的 eFuse 使能 = FPGA 发出 `VD_ON_N=0`（FPGA 先输出完整黑场时序再开 VD）AND VL 正常 AND 24V 正常 |
| T4：VD 先于输入信号关闭 | FPGA 关机流程先置 `VD_ON_N=1`；突然掉电时由 PFAIL_N 硬件关 VD |
| T2：输入信号先于 VL 关闭 | VL 来自最后掉电的 NID100-5；VL 欠压监控同时硬件关 VD |
| 浪涌（保险 F1–F3） | 两路 eFuse 的 dV/dt 软启动 + 限流 |
| 5V 穿越 2.5–4.5 V ≤100 ms、ti ≥1 ms | U_VL 软启动时间取约 5 ms；阶段 B 实测掉电/重启 |

## 11. 原理图和 PCB 工作包

### 11.1 建议的原理图分页

| 页面 | 应包含内容 | 当前状态 |
|---|---|---|
| 01 系统/电源树 | 电源源头、使能关系、模块边界、接口方向 | 可按本文展开 |
| 02 FPGA/Dock 接口 | 11 路显示输出、OE/VD控制、状态、调试串口 | v0.2 已按 11.2.1 分配；VCCIO 已核实 3.3 V（v0.3） |
| 03 电平缓冲 | 两片 AHCT245、DIR/OE、去耦、串阻、默认电平 | 器件候选，待电气审查 |
| 04 EL/CN5 | 第4节20针映射、并联电源/地、线束接口 | 面板逻辑针号已核对；方向待实物复核 |
| 05 电源/保护 | 12 V输入、5 V降压、VL/VD时序、欠压处理 | 需预算、器件与波形定稿 |
| 06 可选 MCU | ESP32-S3、UART/SPI、复位与隔离 | 扩展预留，首版可不装 |

### 11.2 Dock 连接方案的冻结条件

**[方案]** 首选核对过电压与占用的 GPIO/PMOD 引出 11 路显示信号，通常需要超过一个 8 信号位的 PMOD。具体连接器编号、FPGA 球位和约束文件**尚未冻结**。也可使用 Dock RGB FPC 引出部分信号，但它包含 LCD 电源/背光相关针位，不能把 40P RGB 接口直接当成 EL 插座。

**[参考]** tang-monitor 的 `docs/pinmap.md` 提醒其板卡有 2.5 V、3.3 V、1.5 V Bank 混用及约束标注问题；官方 Wiki 又列出特定核心板默认供电说明。这些资料适用板卡/版本可能不同，应回到实际原理图并实测 VCCIO。[S3][S6]

引脚表冻结前逐项填写：

| 必填字段 | 内容 |
|---|---|
| 逻辑网络 | UD0–3、LD0–3、CP2、CP1、S、OE、VD_EN、PGOOD等 |
| Dock 端 | 连接器编号、针号、插合视图、板卡版本 |
| FPGA 端 | 球位、Bank、实测VCCIO、IO_TYPE、驱动强度 |
| 占用检查 | HDMI、DDR、JTAG、UART及板上外围是否共享 |
| 外部链路 | 缓冲器通道、串阻编号、CN5针号、默认状态 |

在以上字段完成之前，不填猜测的 PMOD 针号或复制 LCD 的球位来补空表。

#### 11.2.1 v0.2 引脚分配（依据 Dock 3713 原理图逐针核对）[S9]

**[参考/原理图]** Dock 共有 4 个 2×6、2.54 mm PMOD：J5、J6（RGB LCD 信号复用）、J12（DVP）、J14（麦克风阵列）。Sipeed 的 PMOD 针序与 Digilent 标准**不同**：**1、2 脚 = +3V3，3、4 脚 = GND，5–12 脚为信号**（奇数一排、偶数一排）。

**[方案] 选用 J5、J6、J14；不用 J12（DVP Bank 可能为 2.5 V）。** 使用这些引脚时不得插 40P RGB 屏 FPC（J7）和麦克风阵列 FPC（J15），因为它们共用同一组 FPGA 引脚。

| Dock 接口/针 | 原理图网络 | FPGA Bank/IO/球位 | 本工程网络 | 方向 |
|---|---|---|---|---|
| J5-5 | RGB_LCD_R0 | 3/IOR40B/**L9** | EL_LD3_3V3 | FPGA→板 |
| J5-6 | RGB_LCD_R1 | 3/IOR40A/**N8** | EL_LD1_3V3 | FPGA→板 |
| J5-7 | RGB_LCD_R2 | 3/IOR36B/**N9** | EL_LD2_3V3 | FPGA→板 |
| J5-8 | RGB_LCD_R3 | 3/IOR47B/**N7** | EL_LD0_3V3 | FPGA→板 |
| J5-9 | RGB_LCD_R4 | 3/IOR51A/**N6** | EL_UD0_3V3 | FPGA→板 |
| J5-10 | RGB_LCD_G0 | 7/IOL22A/**D11** | EL_UD3_3V3 | FPGA→板 |
| J5-11 | RGB_LCD_G1 | 7/IOL15A/**A11** | EL_UD1_3V3 | FPGA→板 |
| J5-12 | RGB_LCD_G2 | 7/IOL13A/**B11** | EL_UD2_3V3 | FPGA→板 |
| J6-5 | RGB_LCD_B0 | 7/IOL7B/**B12** | 不连接 | — |
| J6-6 | RGB_LCD_B1 | 7/IOL7A/**C12** | VD_HI_N_3V3 | 板→FPGA |
| J6-7 | RGB_LCD_B2 | 7/IOL8A/**B13** | 不连接 | — |
| J6-8 | RGB_LCD_B3 | 7/IOL8B/**A14** | VD_ON_N（低有效） | FPGA→板 |
| J6-9 | RGB_LCD_B4 | 7/IOL2A/**B14** | EL_CP2_3V3 | FPGA→板 |
| J6-10 | RGB_LCD_HSYNC | 7/IOL2B/**A15** | OE_N（低有效） | FPGA→板 |
| J6-11 | RGB_LCD_VSYNC | **1**/IOT44A/**D14** | EL_CP1_3V3（Bank 1，约束 LVCMOS25，见下） | FPGA→板 |
| J6-12 | RGB_LCD_DE | **1**/IOT44B/**E15** | EL_S_3V3（Bank 1，约束 LVCMOS25，见下） | FPGA→板 |
| J14-5 | MIC_LED_CLK | 3/IOR38B/**P9** | UART_TX（FPGA→Orange Pi） | FPGA→板 |
| J14-6 | MIC_LED_DAT = WS2812-DAT | 3/IOR38A/T9 | **不连接**（与板载 WS2812 共用） | — |
| J14-7 | MIC_DAT1 | 3/IOR42B/**T8** | SCR_EN_3V3（斜面"屏幕"开关，高 = 允许开屏） | 板→FPGA |
| J14-8 | MIC_DAT0 | 3/IOR42A/**P8** | VD_FLT_N_3V3 | 板→FPGA |
| J14-9 | MIC_DAT2 | 3/IOR29B/**R8** | VL_FLT_N_3V3 | 板→FPGA |
| J14-10 | MIC_DAT3 | 3/IOR29A/**T7** | VL_OK_3V3 | 板→FPGA |
| J14-11 | MIC_BCK | 3/IOR53B/**T6** | UART_RX（Orange Pi→FPGA） | 板→FPGA |
| J14-12 | MIC_WS | 3/IOR53A/**P6** | PFAIL_N_3V3 | 板→FPGA |
| J5/J6/J14 的 1、2 脚 | +3V3 | — | 3V3_FPGA（仅作上拉参考，**不得与任何 5V/12V 网络相连，不从此取大电流**） | — |
| J5/J6/J14 的 3、4 脚 | GND | — | GND | — |

**[方案，2026-10-22 起按 EL-IF D1.3]** 上表是 D1.3 的脚序：EL-IF 的 P1–P3 原来是 U 形编号，与 Dock 的奇偶交错编号不一致，用 2×6 延长线直插会让 3V3 对地短路；D1.3 改成和 Dock 一样的编号、1 脚对 1 脚连接，并为少改走线重排了信号（`el_driver/D1.3/变更记录_D1.3.txt`）。球号按 Dock 3714 原理图总图逐根连线核对。J6-11/12（D14/E15）在 Bank 1，与 HDMI 的 LVDS25 输入、LED0–3 同 bank，工具链要求同 bank 声明一致，CP1、S 约束为 LVCMOS25。Bank 1 实际 VCCIO 按下表为 3.3 V，输出高电平仍为 3.3 V；即使为 2.5 V，AHCT245 VIH 2.0 V 也满足。面包板实验 3 时用示波器量 CP1 高电平确认。

**[原厂，U03 已关闭（2026-10-20）]** Bank 电压按 Sipeed 官方原理图核实（核心板 `Tang_Primer_20K_SOM-3961_Schematic.pdf`、Dock `Tang_Primer_20K_Dock-3713_Schematics.pdf`，dl.sipeed.com/fileList/TANG/Primer_20K/02_Schematic；3710–3713 同一原理图。3714 已逐页对比：本表与上表引脚分配相同，但 HDMI 端接和 S4/1 号拨码有改动，见 v0.3.1）：

| Bank | VCCIO 来源 | 电压 |
|---|---|---|
| 3（J14、部分 J5） | 核心板直接接 +3V3 | **3.3 V**，固定 |
| 7（J6、部分 J5） | 核心板 R9（0 Ω）接 +3V3；SO-DIMM 170/174 在 Dock 上悬空 | **3.3 V**（只有拆 R9 才会变） |
| 0、1（含 J6-11/12 的 D14/E15） | 核心板 R5（0 Ω）接 +3V3，Dock 经 SO-DIMM 164/166 也给 +3V3 | 3.3 V |
| 2 | 核心板直接接 +3V3（JTAG） | 3.3 V，固定 |
| 4、5、6 | +1V5，与 DDR3 共用 | 1.5 V |

- Sipeed Wiki 的"bank 0、1、7 默认 3.3 V"只是因为这三个 bank 可以通过 R5/R9 改电压，并不表示其他 bank 不是 3.3 V。
- tang-monitor 记录的"Bank 6 为 3.3 V"不对（Bank 6 是 1.5 V），但本设计没有用 Bank 6。
- Sipeed 官方例程（TangPrimer-20K-example 的 `RGB_lcd/.../lcd.cst`、`Micarray/.../top.cst`）对 J5/J6/J14 这些球位都用 `IO_TYPE=LVCMOS33`。本工程 `el_hdmi.cst` 中 EL 相关输出/输入均为 LVCMOS33，与此一致。
- 唯一会改变电压的情况是有人改动过核心板 R5/R9。上电后量一个已输出高电平的 Bank 7 脚（D1.3 起如 J6-8 VD_ON_N，未开 VD 时为高）作最后复核即可。

### 11.3 PCB与装配约束

- **[方案]** 首版只做低压转接、电平缓冲和电源控制；HDMI 高速部分保留在现成 Dock 上。
- 转接板保持完整地参考，缓冲器靠输出连接器，CP2/CP1/S 与数据线短而清晰；串阻靠近驱动源放置。
- 去耦紧贴电源脚；降压器开关热回路远离 EL 时钟、FPGA 引线和 HDMI 接口区域。
- 12 V/5 V/GND 按最坏负载、铜厚和允许温升设计，连接器附近避免细颈；并联电源针均接入供电面。
- CN5 丝印标出型号、1脚、5V/12V方向；低压FPGA接口与CN5采用明显不同的外观/防呆，避免误插。
- 预留测试点：原始12V、+12V_EL、+5V_EL、GND、/OE、VD_EN、PGOOD、CP2/CP1/S及全部数据；示波器接地点靠信号测试点。
- **[原厂]** 模组安装使用8个通孔中的4个，具体孔径与位置见规格 p.12。[S1] **[待核实]** 外壳、支撑柱、CN5插拔空间、原板最高器件和背部高压区域的机械间隔。
- **[原厂] v0.2 摘录（规格 p.12）：** 外形 267±0.5 × 220 × 最大 23.5 mm（现 3D 模型按 22 mm，需改）；安装孔两组，Ø3.5 孔距 257×208（对称），Ø4.4 孔距 238×187（对称）；CN5 位于背面竖直中心线上、距中心约 59 mm（下方），背部元件区以中心为界上下各 63 mm。
- **[方案]** 即使机箱开放，也须让原模组背部高压部分免于手指/金属工具误触；电源切断后按实测放电情况安排操作。

### 11.4 首版 BOM 类别

Tang Primer 20K + Dock；两片指定厂商 AHCT245；匹配 DF11 壳体/端子与线束；合适的12 V电源；5 V降压器；VD高边开关及电源监控/保护器件；OE开漏控制器件；去耦/储能电容；串阻和默认电平电阻；调试接头和测试点。具体完整料号、封装、额定值和数量须随原理图定稿，本文不生成未经核验的采购清单。

## 12. 分阶段点亮与验证清单

以下均为 **[方案]**；每阶段保存波形、照片、构建版本和测试记录。检查项当前均未执行。

### 阶段 A：断电检查与资料冻结

- [ ] 核对实物铭牌 LJ64K052，原装控制/高压板完整；拍摄连接器与方向标记。
- [ ] 固定 LA-08203B 或实物对应规格版本；若发现修订差异，先更新本笔记。
- [ ] 完成20芯线束逐针通断、相邻针短路和反向检查，尤其是17–20脚。
- [ ] 核对 Dock/核心板版本，完成 IO/Bank/VCCIO 表，确认无 HDMI/JTAG 冲突。
- [ ] 电平缓冲方向、默认关闭和故障使能路径审查通过。

通过条件：所有电源/地/信号有明确对应，不存在靠插头外观猜编号的接线。

### 阶段 B：电源与缓冲独立测试（先不接屏）

- [ ] 用等效负载检查 VL、VD 在设计电流下的压降和温升。
- [ ] 记录开机、关机、拔电、欠压和复位时 VL/VD/OE 的相对波形。
- [ ] 验证 FPGA 未配置时缓冲关闭、无反灌、无意外 CP1/CP2 脉冲。
- [ ] 检查 USB 与外部电源同时连接的供电路径。
- [ ] 在连接器端检查5 V缓冲后的全部11路电平、过冲、边沿和默认状态。

通过条件：电源满足第3节范围，时序关系满足第10节，缓冲/线束不存在把5/12 V引到FPGA的路径。

### 阶段 C：FPGA基础与EL时序（仍先不接屏）

- [ ] LED/调试 UART、参考时钟、PLL与复位工作；Dock 核心使能开关按官方资料设置。[S6]
- [ ] 对扫描状态机检查每行160次CP2、每帧240次CP1、S只标记首行对。
- [ ] 仿真首/末行、首/末组、复位、60/120 Hz切换及RAM预取延迟。
- [ ] 屏幕端测点满足第8节建立/保持、脉宽、边沿和行/帧周期要求。

通过条件：波形与规格书一致；此阶段完成后再连接昂贵/不可替换的面板。

### 阶段 D：原装屏本地图案点亮

- [ ] 断电接屏，按上电顺序启动，先黑场，再短时低占空比图案。
- [ ] 显示单点/单列、左上标记和右下标记，确认方向和四像素位序。
- [ ] 上半屏亮/下半屏灭，再反向，确认UD/LD分配。
- [ ] 检查行0、239、240、479；重点观察屏幕中缝第240/241行。
- [ ] 用 `1000/0100/0010/0001` 周期条纹检查 nibble 是否镜像。
- [ ] 短时全亮记录两路电流、屏幕端电压、连接器/电源温升；之后恢复变化图案。
- [ ] 先60 Hz，验证后再120 Hz；异常闪烁、异响、过流或温升时关闭VD并检查。

通过条件：全幅640×480映射正确，无半屏交换/四点倒序/首末行错位，负载条件下电源稳定。

### 阶段 E：帧缓存与跨域验证

- [ ] 先用本地递增行号/帧号图案写缓存，核对所有地址和两半屏边界。
- [ ] 在快慢不同时钟下验证握手，正在显示的缓冲绝不被写覆盖。
- [ ] 检查RAM实际读延迟，无首组丢失、末组重复和偏移一组。
- [ ] 资源报告确认双帧+接收前端有余量；时序收敛，无未处理CDC问题。
- [ ] 输入中断/复位/不完整帧时，只保留完整旧帧或切换本地安全图案。

通过条件：移动斜线和帧号不撕裂，上下半屏显示同一帧。

### 阶段 F：HDMI前端独立复现与集成

- [ ] 先复现 tang-monitor 的 EDID/HPD、时钟恢复、三通道对齐和解码里程碑；不必先依赖其LCD输出。
- [ ] 主机读取EDID并选择640×480；核对实际分辨率、帧率和有效像素计数。
- [ ] RGB阈值图案、灰阶条、文字输入正确；必要时增加空间抖动。
- [ ] 将有效像素写入back buffer，在EL帧边界换帧。
- [ ] 测试HDMI插拔、源设备重启、失锁、模式改变、FPGA重配。
- [ ] 不支持的输入不发布错误帧；EL仍有稳定时序和清晰故障状态。

通过条件：主机桌面/图像稳定显示，重插可恢复，不需要手工重接屏幕线束。

### 阶段 G：整机与长期运行

- [ ] 在目标机箱和线束长度下测温升、压降、噪声及连续运行表现。
- [ ] 对黑场、稀疏图案、棋盘、全亮及视频分别记录电流。
- [ ] 检查掉电、快速重启和异常电源恢复，原厂时序关系始终成立。
- [ ] 验证避免长期固定高亮图案的界面策略；原厂提示亮度老化与图案残留风险。[S1，规格 p.13]
- [ ] 仅在主显示链路稳定后加入ESP32-S3通信/联网功能。

## 13. 待核实事项与冻结门槛

| ID | 未决项 | 决定方式 | 影响 |
|---|---|---|---|
| U01 | 实物屏版本、原板是否改动 | 铭牌/照片、CN5通断与规格比对 | 接线和供电前必须解决 |
| U02 | CN5实物方向、线束端子完整料号 | 插合图、样件压接、逐针验线 | 封装与线束下单前解决 |
| U03 | ~~Dock/Core板版本、全部输出球位及VCCIO~~ **已关闭（2026-10-20，原理图核实）**：EL 用到的 Bank 3/7 均为 3.3 V，见 11.2.1 末尾；上电时顺手量一下 J6-8（D1.3 起 VD_ON_N）输出高电平作复核 | 原理图、板上测量、约束审查 | FPGA接口PCB冻结前解决 |
| U04 | tang-monitor在本工具链和本板复现 | 分层构建与实测 | HDMI可用性 |
| U05 | 双帧缓存的实际BSRAM占用和RAM延迟 | 综合、布局时序、RAM仿真 | 是否保留DDR3后备路线 |
| U06 | OE、VD_EN及欠压硬件处理 | 电路审查、断电波形 | 上/下电可靠性 |
| U07 | 电源/开关/线束的连续和浪涌能力 | 负载、启动、全亮测试 | 电源及保护完整选型 |
| U08 | 缓冲器完整料号、负载、串阻与掉电行为 | 厂商规格、屏幕端波形 | 电气裕量 |
| U09 | 首版最终EL帧率与HDMI实际模式 | 60/120 Hz亮度、功耗、刷新比较 | 最终参数和EDID |
| U10 | ESP32-S3型号拼写、接口与供电职责 | 核对已购板资料及控制需求 | 扩展接口，不阻塞初次本地点亮 |
| U11 | 外壳支撑、高压防触碰及散热 | 机械样件和整机运行 | 装配与长期运行 |
| U12 | ~~Orange Pi 4（Armbian 内核）能否输出 640×480@60~~ | **已关闭（2026-10-20）：内核 6.18.56 拒绝 25.175 MHz，接受 27 MHz 自定义 EDID 时序；el_hdmi 用 27 MHz 版** | HDMI 链路 |
| U13 | AHCT245 未上电时 A 侧被 3.3 V 驱动是否安全（Ioff） | TI 数据手册；当前用 1 kΩ 串阻兜底 | 电气裕量 |
| U14 | Dock 板版本（3713 修正了 PMOD 间距） | **2026-10-20 确认为 v3714**（丝印在核心板插槽中间）；3714 的 PMOD 引脚与 3713 相同，"直插 Dock"仍需实测 J5/J6/J14 的相对位置 | 仅影响"直插 Dock"备选方案；默认排线连接不受影响 |
| U15 | ~~屏型号 LJ64K052 还是 LJ64H052~~ | **已关闭（2026-10-18）：用户确认为 LJ64K052** | 项目文件已统一改名 |
| U16 | NID100 RC 脚开路电压与短路电流 | 万用表实测 | 面包板阶段用 RC 控制 VD 时的下拉电阻取值 |
| U17 | eFuse 完整型号、EN 阈值、FLT/放电特性、国内货源 | TI 数据手册 + 立创查货 | PCB-1 BOM |
| U18 | ~~Dock 上 R15–R22（49.9 Ω）是否贴装~~ | **已关闭（2026-10-20）：v3714 上 R15–R22 是 499 Ω 下拉到 GND，无接收端接；需在 HDMI 链路上外加端接（5.1）** | HDMI 接收端接 |

**可以立即开展：** CN5符号、功能框图、两片缓冲器逻辑页、电源时序框架、缓存/扫描RTL模块和测试图案。

**原理图/PCB冻结前至少完成：** U01–U03、U06–U08 的设计审查与必要样件验证；把未决参数落为完整料号和明确连线。**接屏前必须完成：** 阶段A–C。**宣称整机验证完成前必须完成：** 阶段D–G中本版适用项目。

## 14. 参考资料与可追溯链接

以下均于2026-10-17查阅。标注“补充”者是本次重新查验增加的来源，无法证明曾在较早对话中逐一讨论。

- **[S1] Sharp LJ64K052 原厂规格书 LA-08203B，2000-08-08（补充核验原件）**：第三方保存的[完整PDF扫描件](https://www.beyondinfinite.com/lcd/Library/Sharp/LJ64K052.pdf)。关键定位：[机械/电气绝对值，PDF5](https://www.beyondinfinite.com/lcd/Library/Sharp/LJ64K052.pdf#page=5)、[工作电源，PDF7](https://www.beyondinfinite.com/lcd/Library/Sharp/LJ64K052.pdf#page=7)、[时序限值，PDF11](https://www.beyondinfinite.com/lcd/Library/Sharp/LJ64K052.pdf#page=11)、[时序图与逻辑门限，PDF12](https://www.beyondinfinite.com/lcd/Library/Sharp/LJ64K052.pdf#page=12)、[像素映射，PDF13](https://www.beyondinfinite.com/lcd/Library/Sharp/LJ64K052.pdf#page=13)、[CN5与线束，PDF14](https://www.beyondinfinite.com/lcd/Library/Sharp/LJ64K052.pdf#page=14)、[机械图，PDF16](https://www.beyondinfinite.com/lcd/Library/Sharp/LJ64K052.pdf#page=16)、[电源时序，PDF20](https://www.beyondinfinite.com/lcd/Library/Sharp/LJ64K052.pdf#page=20)、[VL变化，PDF21](https://www.beyondinfinite.com/lcd/Library/Sharp/LJ64K052.pdf#page=21)。
- **[S2] tang-monitor**：本次任务指定的[仓库与README](https://github.com/kami4ka/tang-monitor)。它提供此开发板HDMI接收路线的参考，不是LJ64K052验证报告。
- **[S3] tang-monitor 接线/Bank排查资料**：[docs/pinmap.md](https://github.com/kami4ka/tang-monitor/blob/main/docs/pinmap.md)。属于项目作者的板卡分析，需与实物版本交叉核对。
- **[S4] HDMI2EL**：本次任务指定的[仓库与README](https://github.com/MNDJ777/HDMI2EL)、[硬件目录](https://github.com/MNDJ777/HDMI2EL/tree/main/hardware)。目标屏LJ64HB34，不能作为LJ64K052规格替代。
  - **v0.2 硬件对照（2026-10-18 拉取 commit b3d9261，解析 `hardware/ProProject_EL_Driver_2024-06-29.epro` 网表，"EL Display_Con Rev.A"）：**
    - 电平转换：6 片 SN74LVC2T45DCU（VCCA=3V3 取自 PMOD，VCCB=5V，DIR 固定接 3V3），共 11 路；B 侧每路 33 Ω 串阻。无 /OE、无下拉，FPGA 一上电就直接驱动屏。
    - 屏侧 2×10 排针 CN1 针序与本文第 4 节 CN5 表**逐针一致**（1 UD1、2 UD0、3 UD3、4 UD2、5 LD1、6 LD0、7 LD3、8 LD2、9 CP2、11 CP1、13 S；10/12/14/15/16 GND；17/18 +5V；19/20 +12V），与 S15 互相印证。
    - 供电：USB-C 5V（CC 5.1 kΩ 下拉，丝印 "5V 3A MAX"）→ 1812L300 自恢复保险（3 A）→ 600 Ω 磁珠 → +5V（VL 与缓冲器）；同一 5V 经 SY7304 非同步升压（SS54 肖特基，反馈 200k/10.5k，0.6 V 基准 → 12.03 V）得 +12V_EL；升压芯片使能端接 10 kΩ/100 nF RC（约 1 ms 延时，按网表推断）；输出 4×22 µF + 屏端 220 µF；9.1 V 稳压管 + LED 作 "+12VOK" 指示。
    - 与本方案的差别：没有 eFuse 软启动、没有 VD/VL 时序保护、没有掉电预警；非同步升压在使能前就把约 4.6 V 经二极管送到 VD。该作者的屏在此条件下能工作，只是单个样本、不同型号，不作为放宽第 3 节时序要求的依据。
  - **README 记录的问题（可借鉴）：**
    - 早期用 2 A 自恢复保险，发热、压降大，导致升压掉压、闪屏，后来短接了该保险。启示：VD/VL 串联元件必须按满屏电流选型，不用自恢复保险。
    - 一片电平转换芯片内部失效，间歇输出高电平，造成不规则竖线。启示：缓冲器输出要留测试点，DIP 阶段可用插座。
    - LJ64HB34 满屏实测约 13 W。
    - 自定义 EDID 后可直接输出原生 640×400@120 Hz。
    - 二值化后，Windows ClearType 的灰边会让文字断续，关闭抗锯齿可解决。Linux 侧同理，用位图字体或关闭字体抗锯齿。
    - BRAM 读出有一拍延迟，导致每半屏第一组像素丢失。RTL 移植时注意地址对齐。
- **[S5] HDMI2EL RTL**：[timing_gen.v](https://github.com/MNDJ777/HDMI2EL/blob/main/rtl/timing_gen.v)、[display_ctrl.v](https://github.com/MNDJ777/HDMI2EL/blob/main/rtl/display_ctrl.v)。用于扫描/存储组织参考，迁移时重审全部地址、延迟和器件相关部分。
- **[S6] Sipeed 官方资料（补充）**：[Tang Primer 20K Wiki](https://wiki.sipeed.com/hardware/en/tang/tang-primer-20k/primer-20k.html)、[官方例程](https://github.com/sipeed/TangPrimer-20K-example)、[原理图下载目录](https://dl.sipeed.com/shareURL/TANG/Primer_20K/02_Schematic)。本次查阅Wiki/例程页面，未完成特定实物版本原理图逐网审查。
- **[S7] Hirose 原厂连接器资料（补充）**：[DF11-20DS-2C 产品页及图纸入口](https://www.hirose.com/en/product/p/CL0543-0509-7-00)。用于连接器系列、间距和配套图纸核对，不替代线束端子的完整选型。
- **[S8] TI 原厂器件规格（补充）**：[SN74AHCT245 数据手册](https://www.ti.com/lit/ds/symlink/sn74ahct245.pdf)，重点看推荐工作条件、电气特性、功能表和封装，不凭商品页标题选型。
- **[S9] Tang Primer 20K Dock 原理图 3713（2023-09-12，Rev 1.1，v0.2 逐页查阅）**：[下载目录](https://dl.sipeed.com/fileList/TANG/Primer_20K/02_Schematic/)，文件 `Tang_Primer_20K_Dock-3713_Schematics.pdf`。第 1 页总图（PMOD/LCD/MIC 网络到 FPGA 球位）、第 3 页 HDMI_TX/RX、第 4 页 RGB LCD 与 J5/J6、第 8 页 DVP 与 J12、第 9 页 DC-IN/按键/J14。**3714 版**（2026-05-20，Rev 1.3）：同目录 `Tang_Primer_20K_Dock_3714_Schematics.pdf`，2026-10-20 与 3713 逐页对比，差别见 v0.3.1。
- **[S10] 明纬 NID100 规格书（2024-10-30）**：[NID100-SPEC.PDF](https://www.meanwell.com/Upload/PDF/NID100/NID100-SPEC.PDF)。输出、输入范围、Remote 逻辑、建议保险、外接电容。
- **[S11] TI TPS25947 eFuse**：[产品页](https://www.ti.com.cn/product/zh-tw/TPS25947)。2.7–23 V、5.5 A、28 mΩ，电容设定斜率，限流可调，ILIM 兼作电流监测，FLT 输出。PG/EN 细节以数据手册为准。
- **[S12] Rockchip dw_hdmi mode_valid**：[Linux v4.19 源码](https://elixir.free-electrons.com/linux/v4.19.31/source/drivers/gpu/drm/rockchip/dw_hdmi-rockchip.c)、[删除精确匹配检查的补丁](https://patches.ctt.linaro.org/patch/554899)。
- **[S13] 7400.me《用ESP32驱动夏普LJ64H052 EL显示屏》**：[存档](https://web.archive.org/web/20240913152828/http://7400.me/2021/03/06/Sharp_LJ64H052/)，本地 PDF 已存于工程目录。3.3 V 直驱不稳、需 5 V 电平；CP1 脉宽要求严格；EL 烧屏明显。
- **[S14] DF11-2428SC 端子额定**：[Farnell](https://cpc.farnell.com/hirose-hrs/df11-2428sc/crimp-df11-awg-24-28/dp/CN14220)、[Future Electronics](https://www.futureelectronics.com/p/2001169)。2 A/针、AWG24–28。
- **[S15] LJ64H052 引脚说明（业余资料）**：[lj64h052.doc](https://www.phys.szote.u-szeged.hu/bbalazs/bb/lcd/lj64h052.doc)。UD0=2、LD0=6、CP2=9、CP1=11、S=13，与 LJ64K052 一致；非原厂资料。

## 15. PCB 设计任务书（交给画板方）

> **本节写给负责画原理图和 PCB 的人或 AI。** 请完整阅读第 3、4、8、9、10、11 节和本节后再动手。本节的网络名、引脚分配、电路结构是**已定方案**；标注 **[画板方核实]** 的项目需要查原厂数据手册确认后填入，**不得凭记忆或猜测填写器件引脚、阈值或封装**。遇到本节未覆盖、或与原厂数据手册冲突的地方，停下来列出问题交给用户，不要自行改方案。

### 15.1 总体与默认决定

一共三块板，**不做 HDMI 板**（Orange Pi 4 用短 HDMI 线直接接 Dock）。

| 板号 | 名称 | 优先级 | 一句话功能 |
|---|---|---|---|
| PCB-1 | EL 接口与电源时序板（EL-IF） | 必做 | FPGA 3.3 V 信号 → 5 V 驱动 CN5；VD/VL 软启动开关与时序保护 |
| PCB-2 | EL 假负载测试板（EL-DUMMY） | 强烈推荐 | 模拟屏幕 CN5，接屏前验证波形与电源时序 |
| PCB-3 | 24 V 配电板（PWR-DIST，即原计划 P16 的修订版） | 必做 | NID100-12/NID100-5 载板、分路保险、24 V 掉电预警 PFAIL |

以下为**默认决定**，用户可改，画板方不得自行改：

| 项目 | 默认 | 备选 |
|---|---|---|
| PCB-1 与 Dock 的连接 | 三根 12P 线（2×6 杜邦/PMOD 延长线，≤15 cm），PCB-1 上用 2×6 直针 | 直插 Dock（需 U14 确认 3713 版并实测 J5/J6/J14 相对位置） |
| VD 开关 | PCB-1 上的 eFuse | — |
| Dock 供电 | PCB-3 引出 12 V 到 Dock DC 插座 | Dock USB-C 5 V |
| 板材 | 双层、1.6 mm、1 oz 铜、嘉立创可加工规则 | — |
| 封装 | 电阻电容 0603（功率件按需），IC 尽量选 SOIC/SOT 等可手焊封装 | — |
| 交付工程格式 | 嘉立创 EDA 专业版或 KiCad 8/9 | — |

### 15.2 全局网络名（三块板统一）

| 网络 | 电压 | 来源 → 去向 | 说明 |
|---|---|---|---|
| +24V | 24 V | LRS-200-24 → PCB-3 | 仅 PCB-3 上存在 |
| +12V_IN | 12 V | PCB-3 NID100-12 → PCB-1 | eFuse 前 |
| +5V_IN | 5 V | PCB-3 NID100-5 → PCB-1 | eFuse 前 |
| +12V_EL | 12 V | PCB-1 U_VD 输出 → CN5 19/20 | 屏 VD |
| +5V_EL | 5 V | PCB-1 U_VL 输出 → CN5 17/18、U1/U2 VCC | 屏 VL |
| 3V3_FPGA | 3.3 V | Dock PMOD 1/2 脚 → PCB-1 | 只作上拉参考和反相器供电，总电流 <20 mA |
| GND | 0 V | 全部 | 单一地，不分割 |
| EL_UD0..3_3V3、EL_LD0..3_3V3、EL_CP2_3V3、EL_CP1_3V3、EL_S_3V3 | 3.3 V | Dock → PCB-1 缓冲器 A 侧 | 见 11.2.1 |
| EL_UD0..3_5V、EL_LD0..3_5V、EL_CP2_5V、EL_CP1_5V、EL_S_5V | 5 V | 缓冲器 B 侧 → CN5 | 见第 4 节 |
| OE_N | 3.3 V | Dock J6-10 → U1/U2 /OE | 低 = 输出使能 |
| VD_ON_N | 3.3 V | Dock J6-8 → U_NOR | 低 = 请求开 VD |
| EN_VD | — | U_NOR → U_VD EN | VD eFuse 使能节点 |
| VL_OK_3V3 | 3.3 V 开漏 | U_SUP → Dock J14-10 | 高 = +5V_EL 正常 |
| PFAIL_N | 开漏 | PCB-3 → PCB-1 | 低 = 24 V 正在掉电 |
| PFAIL_N_3V3 | 3.3 V | PCB-1 → Dock J14-12 | PFAIL_N 在 PCB-1 上拉到 3V3_FPGA 后的同一网络 |
| VD_FLT_N_3V3 | 3.3 V 开漏 | U_VD FLT → Dock J14-8 | 低 = VD eFuse 故障 |
| SCR_EN_3V3 | 3.3 V | 斜面"屏幕"开关 → PCB-1 J_PF-2 → Dock J14-7 | 高 = 允许开屏（PCB-1 上 10 kΩ 上拉）；低 = 关屏，经 D4 拉低 EN_VD |
| UART_TX / UART_RX | 3.3 V（FPGA 侧）/ 3.0 V（Orange Pi 侧） | Dock J14-5/11 ↔ Orange Pi UART4（40 针 19/21 脚，/dev/ttyS4） | PCB-1 只转接 |

### 15.3 PCB-1：EL 接口与电源时序板（EL-IF）

**尺寸与安装：** 100 × 100 mm（D1.2 第一版 PCB 实际尺寸；原定 ≤ 80 × 60 mm 放不下两颗 eFuse 的电源走线和测试点），双层 1.6 mm；四角 M3 安装孔（孔径 3.2 mm，孔中心距板边 5 mm）。元件、高度和出线方向见 `el_driver/D1.2/变更记录_D1.2.txt` 第三节。

**连接器：**

| 位号 | 型号/规格 | 针定义 |
|---|---|---|
| P1 | 2×6 直针 2.54 mm | 与 Dock J5 同针序（D1.3 起奇偶交错编号，1 脚对 1 脚）：1、2 = 3V3_FPGA；3、4 = GND；5 LD3、6 LD1、7 LD2、8 LD0、9 UD0、10 UD3、11 UD1、12 UD2（EL_*_3V3） |
| P2 | 2×6 直针 2.54 mm | 与 Dock J6 同针序（D1.3）：1、2 = 3V3_FPGA；3、4 = GND；5、7 = 不连接；6 = VD_HI_N；8 = VD_ON_N；9 = EL_CP2_3V3；10 = OE_N；11 = EL_CP1_3V3；12 = EL_S_3V3 |
| P3 | 2×6 直针 2.54 mm | 与 Dock J14 同针序（D1.3）：1、2 = 3V3_FPGA；3、4 = GND；5 = UART_TX；6 = 不连接；7 = SCR_EN_3V3（测试点 TP_SCR）；8 = VD_FLT_N_3V3；9 = VL_FLT_N_3V3；10 = VL_OK_3V3；11 = UART_RX；12 = PFAIL_N_3V3 |
| J_EL | Hirose DF11-20DP-2DS（直插针座，与屏 CN5 同型号）**[画板方核实封装尺寸、1 脚位置]** | 与第 4 节 CN5 表**完全一致**：1 UD1、2 UD0、3 UD3、4 UD2、5 LD1、6 LD0、7 LD3、8 LD2、9 CP2、11 CP1、13 S（均为 *_5V 网络）；10、12、14、15、16 = GND；17、18 = +5V_EL；19、20 = +12V_EL |
| J_PWR | 4P 端子，VH3.96 或 5.08 mm 螺钉端子，每针 ≥5 A | 1 = +12V_IN；2 = GND；3 = +5V_IN；4 = GND |
| J_PF | XH2.54 3P（与 XH 兼容的 A2501 3P） | 1 = PFAIL_N（来自 PCB-3）；2 = SCR_EN_3V3（斜面"屏幕"钮子开关，开关另一端接 3 脚）；3 = GND |
| J_LAMP | XH2.54 2P | 1 = +12V_EL；2 = GND。面板"屏幕供电"12 V 黄色指示灯，跟随屏的 VD |
| J_UART | XH2.54 3P | 1 = UART_TX；2 = UART_RX；3 = GND（引到 Orange Pi 4 的 UART4：40 针 19 脚 TX、21 脚 RX，Armbian 开 `rk3399-uart4` overlay 后为 /dev/ttyS4。**v0.3 更正：Orange Pi 4 排针 IO 是 3.0 V，不是 3.3 V**（2026-10-20 按官方原理图与 Armbian 设备树核实）。Orange Pi → FPGA 方向 3.0 V 高电平足够；FPGA → Orange Pi 方向 3.3 V 比对方电源高 0.3 V，靠 RTX 串阻限流，见 15.3 电路块 E） |

P1/P2/P3 的 3V3_FPGA 三处在板上并联；**3V3_FPGA 与 +5V_EL、+5V_IN、+12V_* 之间不得有任何直接或经电阻的连接**（只允许经开漏器件/肖特基隔离，见下）。

**电路块 A：电平缓冲（U1、U2）**

- U1、U2：SN74AHCT245DW（SOIC-20），备选 SN74HCT245。VCC = +5V_EL；DIR 直接接 +5V_EL（A→B）；/OE = OE_N。
- 通道：U1 的 A1–A8 = EL_UD0、UD1、UD2、UD3、LD0、LD1、LD2、LD3（_3V3），对应 B1–B8 输出同名 _5V；U2 的 A1 = EL_CP2_3V3、A2 = EL_CP1_3V3、A3 = EL_S_3V3，A4–A8 直接接 GND，B4–B8 悬空。
- 每路 A 侧：P1/P2 引脚 → **1 kΩ 串阻** → A 脚；A 脚处 **100 kΩ 下拉**到 GND。
- 每路 B 侧：B 脚 → **33 Ω 串阻**（靠近 B 脚放置）→ 走线 → J_EL；J_EL 端 **100 kΩ 下拉**到 GND。
- OE_N：**10 kΩ 上拉到 3V3_FPGA**，直接接 U1、U2 的 /OE。
- 去耦：每片 VCC 脚旁 100 nF（≤2 mm），两片之间再放 10 µF。
- 缓冲器尽量靠近 J_EL；11 路 5V 输出等长度不作要求，但 CP2 与数据线长度差 ≤20 mm。

**电路块 B：VL 支路（U_VL）**

- U_VL：eFuse，首选 TI TPS25947 系列 **[画板方核实完整后缀：选锁存或自动重试均可，在 BOM 写明；核实 EN/UVLO、dVdt、ILIM、FLT 引脚与计算公式]**。
- IN = +5V_IN，OUT = +5V_EL。
- 设定：限流约 **0.8 A**（模组 F1 为 800 mA 慢断，VL 最大 300 mA，再加两片缓冲器）；软启动输出上升时间约 **5 ms**（满足 2.5–4.5 V 穿越 ≤100 ms）。
- EN：用电阻分压从 +5V_IN 取，使 +5V_IN ≥ 约 4.5 V 时自动开启（VL 不受 FPGA 控制，上电即有）。预留一个 0 Ω 跳线位，将来可改为外部控制。
- 输入 10 µF + 100 nF；输出 10 µF + 100 nF（不要放大电容，以免加大浪涌）。输出侧放 SMBJ6.0A（或同类 5 V TVS）**[画板方核实]**。
- LED_VL：绿色 LED + 1 kΩ 接 +5V_EL。

**电路块 C：VL 欠压监控（U_SUP）**

- U_SUP：电压监控芯片，**开漏、低有效输出**，监测 +5V_EL，阈值 **4.5–4.65 V**（如 TPS3840DL46 / APX803 系列等效）**[画板方核实型号与阈值]**。
- 输出网络 VL_OK_3V3：10 kΩ 上拉到 3V3_FPGA → P3-8（给 FPGA 读）；同时经肖特基 **D2（BAT54 类，阴极接 VL_OK_3V3，阳极接 EN_VD）** 去拉低 EN_VD。
- 说明：+5V_EL 正常时 U_SUP 输出释放，VL_OK_3V3 = 3.3 V，D2 反偏不影响 EN_VD；+5V_EL 欠压时 VL_OK_3V3 被拉到 0，D2 把 EN_VD 钳到约 0.3 V，VD 关闭。Dock 断电时上拉消失，VL_OK_3V3 也为 0，同样关 VD。
- **[画板方核实]** U_SUP 输出灌电流 ≥5 mA 时 VOL ≤0.3 V（需同时吸收 10 kΩ 上拉和来自 EN_VD 的 1 kΩ 电流）。
- 注意：+5V_EL **完全没电**时 U_SUP 自身无电源，输出不能保证为低，这种情况由电路块 D 的 Q_VL 负责（见下）。

**电路块 D：VD 支路（U_NOR + Q_VL + U_VD）**

- U_NOR：单 2 输入或非门 74LVC1G02（SOT-23-5），**VCC = 3V3_FPGA**（输入可耐 5 V）。
  - 输入 A = VD_ON_N（并 10 kΩ 上拉到 3V3_FPGA）。
  - 输入 B = VL_ABSENT。
  - 输出经 **1 kΩ** 到 EN_VD。输出 = NOT(VD_ON_N OR VL_ABSENT)。
- VL_ABSENT 网络：10 kΩ 上拉到 3V3_FPGA；Q_VL（N-MOSFET，**Vgs(th) 最大 ≤1.5 V**，如 AO3400A 类，SOT-23）漏极接 VL_ABSENT、源极接 GND，栅极由 +5V_EL 经 10 kΩ/10 kΩ 分压驱动（VL 正常时栅压约 2.5 V，导通 → VL_ABSENT 为低）。+5V_EL 没电时 Q_VL 截止 → VL_ABSENT 为高 → EN_VD 为低。
- EN_VD：100 kΩ 下拉到 GND；另有 D2（来自 VL_OK_3V3）、**D3（BAT54 类，阴极接 PFAIL_N_3V3，阳极接 EN_VD）** 和 **D4（BAT54WS，阴极接 SCR_EN_3V3，阳极接 EN_VD）** 三路肖特基可以把它拉低。
- 真值（必须满足）：

| 状态 | EN_VD | VD |
|---|---|---|
| Dock 断电（3V3_FPGA = 0） | 低（U_NOR 无电源，100 kΩ 下拉） | 关 |
| FPGA 配置中（IO 弱上拉，VD_ON_N 为高） | 低 | 关 |
| FPGA 输出 VD_ON_N = 1 | 低 | 关 |
| +5V_EL 完全没电 | 低（Q_VL 截止 → VL_ABSENT 高） | 关 |
| +5V_EL 欠压（低于约 4.6 V） | ≈0.3 V（U_SUP 经 D2） | 关 |
| PFAIL_N 为低（24 V 掉电中） | ≈0.3 V（经 D3） | 关 |
| 斜面"屏幕"开关拨到关（SCR_EN_3V3 为低） | ≈0.3 V（经 D4） | 关 |
| FPGA 输出 VD_ON_N = 0，且 VL 正常，且 PFAIL_N 为高，且屏幕开关为开 | ≈3 V | **开** |

  **[画板方核实]** 所选 eFuse 的 EN 上升阈值最大值 < 2.5 V、下降阈值最小值 > 0.5 V，EN 脚耐压 ≥3.6 V；否则调整 1 kΩ/100 kΩ 或告知用户。

- U_VD：eFuse，与 U_VL 同系列。IN = +12V_IN，OUT = +12V_EL，EN = EN_VD。
- 设定：限流约 **2.8 A**（D1.2 用 TPS259470，R_ILM = RIL12 = 1.2 kΩ，I_LIM = 3334 / 1200 ≈ 2.78 A；原定 1.3 kΩ ≈ 2.56 A 无现货。VD 最大 1.8 A；模组 F2/F3 各 1.6 A）；软启动输出上升时间约 **10–20 ms**；FLT 开漏 → VD_FLT_N_3V3（10 kΩ 上拉到 3V3_FPGA）→ P3-9。
- ILIM 脚（兼作电流监测）引出测试点 TP_IMON。
- 输入 22 µF/25 V + 100 nF；输出 10 µF/25 V + 100 nF；输出侧 SMBJ15A TVS **[画板方核实]**；预留放电电阻 2.2 kΩ/0.5 W 焊位（默认不贴）。
- LED_VD：黄色 LED + 4.7 kΩ 接 +12V_EL。

**电路块 E：PFAIL 与 UART**

- J_PF-1（PFAIL_N，来自 PCB-3 的开漏输出）在 PCB-1 上 10 kΩ 上拉到 3V3_FPGA，形成 PFAIL_N_3V3 → P3-7，并经 D3 接 EN_VD。J_PF 未接时 PFAIL_N_3V3 为高（不阻止 VD），这是已知且接受的行为。
- J_PF-2（SCR_EN_3V3）：斜面"屏幕"钮子开关，另一端接 J_PF-3（GND）。PCB-1 上 **RSCR 10 kΩ 上拉到 3V3_FPGA**，接 P3-7（D1.3 起；原 P3-12）给 FPGA 读，同时经 D4 接 EN_VD。开关拨到关时 D4 直接把 EN_VD 拉低，不依赖 FPGA；J_PF 未插时为高（允许开屏）。
- J_PF 用一根 3 芯线与 PCB-3 的 J_PF 一一对应（1↔1）：1 = PFAIL_N，2 = SCR_EN，3 = GND。"屏幕"钮子先接到 PCB-3（整机接线 W16），由 PCB-3 转到 J_PF-2，PCB-3 只高阻读取开关状态送 ESP32-S3（2026-10-20 整机接线方案 D12 定；原写"线束在 PCB-1 侧合并"作废）。
- J_UART 只是把 P3-10/11 转到 XH 插座：FPGA 发送方向（UART_TX → Orange Pi RX）串 **RTX 1 kΩ**，接收方向串 RRX 100 Ω。v0.3（2026-10-20）RTX 由 100 Ω 改 1 kΩ：Orange Pi 4 排针 IO 为 3.0 V，FPGA 的 3.3 V 高电平高出 0.3 V，正好在其输入极限上，1 kΩ 把经输入保护二极管倒灌的电流限到 100 Ω 时的 1/10；115200 波特率不受影响。

**测试点（全部 1 mm 以上焊盘，丝印标名）：** +12V_IN、+12V_EL、+5V_IN、+5V_EL、3V3_FPGA、EN_VD、OE_N、VD_ON_N、VL_OK_3V3、PFAIL_N_3V3、VD_FLT_N_3V3、TP_IMON、全部 11 路 *_5V（在 J_EL 侧）、CP2/CP1/S 的 *_3V3、两个 SPARE（D1.2 为 J6-10、J14-5；D1.3 起这两脚改作 OE_N、UART_TX）、SCR_EN_3V3（TP_SCR）；至少 4 个 GND 测试钩（靠近 J_EL、缓冲器、两个 eFuse）。

**布局与布线：**

- 顶层元件、底层整面 GND，顶层空白处铺 GND 并打过孔缝合。
- +12V_IN → U_VD → +12V_EL → J_EL 19/20：线宽 ≥1.5 mm，19、20 两脚都接；+5V 路径 ≥1.0 mm，17、18 两脚都接；J_EL 的 5 个 GND 脚全部就近打过孔到底层地。
- 3.3 V 信号侧（P1–P3、1 kΩ、U_NOR、Q_VL）和 12 V 功率侧（J_PWR、U_VD）分区放置；CP2/CP1/S 走线远离 eFuse 和 J_PWR。
- eFuse 的散热焊盘按数据手册打过孔。
- 丝印：板名 "MIS-01 EL-IF v1"、J_EL 旁标 "TO LJ64K052 CN5 / PIN1"、"+12V ON PIN 19/20"；P1/P2/P3 旁分别标 "DOCK J5 / J6 / J14" 并标出每针网络简称；J_PWR 标 "+12 GND +5 GND"。

### 15.4 PCB-2：EL 假负载测试板（EL-DUMMY）

**用途：** 接屏前用真实线束插在它上面，验证 11 路信号在"屏端"的波形和电源时序，避免损坏无法替换的屏。

- 尺寸 ≤ 60 × 50 mm，四角 M3 孔。
- J_IN：DF11-20DP-2DS，针定义与屏 CN5 完全相同。
- 11 路信号（UD0–3、LD0–3、CP2、CP1、S）：每路 J_IN 脚 → 测试点 A → **390 Ω（0805）** → 测试点 B → **10 pF** 到 GND，并联 1 MΩ 到 GND。每路旁边放一个 GND 测试点（示波器短地线用）。
- VL 负载：+5V（17/18 并联）→ 跳线 JP1 → 16 Ω/2 W（或 2 × 33 Ω/1 W 并联）到 GND；LED（绿）+ 1 kΩ 指示。
- VD 负载：+12V（19/20 并联）→ 5.08 mm 2P 螺钉端子 J_LOAD，外接 12 V/21 W 车灯泡或电子负载；板上不放大功率电阻；LED（黄）+ 4.7 kΩ 指示。
- 测试点：+5V、+12V、GND × 4。
- 丝印 "MIS-01 EL-DUMMY v1 — NOT A DISPLAY"。

### 15.5 PCB-3：24 V 配电板（PWR-DIST，原 P16 修订）

- 尺寸沿用整机布局 P16（约 130 × 80 mm），以 `assembly.py` 中位置为准。
- 输入：J_24V（5.08 mm 螺钉端子 2P，≥10 A），来自 LRS-200-24 的 V+/V−；总输入保险座（5×20 玻璃管或 ATO 片式保险座）。
- 模块：NID100-12、NID100-5 各一，SIP 直插 **[画板方按 NID100 规格书核实引脚定义、Remote/COM 脚位、建议外接输入/输出电容、各模块输入保险 8 A]**。原 CSV/README 中的 NID65-12 改为 NID100-12。
- Remote 控制：两个模块的 RC 脚引到 J_RC（XH 3P：RC12、RC5、COM），默认用跳线帽悬空 = 开机；供将来接前面板钥匙开关。
- 输出（每路独立保险或自恢复器件按负载选取，**EL 支路不得使用 PTC**）：
  - J_EL_PWR（VH3.96 4P）→ PCB-1 J_PWR：+12V、GND、+5V、GND（针序与 PCB-1 J_PWR 一致，线束 1↔1）。
  - J_DOCK（2P）→ 12 V 到 Dock DC 插座（DC-036A，中心针 2.0 mm **[画板方核实 Dock 插座内针径与极性，线端由用户购买]**）。
  - J_OPI（2P，≥3 A）→ Orange Pi 4 的 5 V 供电。
  - 其他 5 V/12 V/24 V 支路按 MIS-01 整机计划（辉光管、IV-18、盖革管、风扇等）另列，本任务书不定义。
- **PFAIL 比较器：** LM393（SOIC-8），由 NID100-5 输出的 5 V 供电（24 V 跌落时 5 V 最后掉）。
  - 同相/反相输入：24 V 经分压与 2.5 V 基准（TL431 或 LM4040-2.5）比较；**阈值：24 V 下降到 21.0 V 时输出翻转，回差约 1 V**（上升 22 V 恢复）。分压比与回差电阻由画板方计算并在原理图上写出算式。
  - 通道 A 输出（开漏，LM393 本身为开漏）→ J_PF（XH 3P：PFAIL_N、SCR_EN、GND，与 PCB-1 J_PF 一一对应；2 脚为 PCB-3 转来的面板"屏幕"开关，见 15.3 电路块 E）。PCB-3 上不加上拉（上拉在 PCB-1）。
  - 通道 B 输出（开漏）→ J_PF_OPI（XH 2P）→ Orange Pi GPIO（上拉在 Orange Pi 侧，Orange Pi 4 排针 IO 为 3.0 V），供系统提前关机。
- 指示：+24V、+12V、+5V 各一 LED。
- 布线：24 V/12 V/5 V 大电流路径线宽按 1 oz 铜、温升 ≤10°C 计算（预计 ≥3 mm 或铺铜），分路保险靠近输出端子。

### 15.6 交付物与验收

画板方必须交付：

1. 三块板各自的原理图 PDF（每页带标题栏、版本号 v1、日期）。
2. 工程源文件（嘉立创 EDA 专业版或 KiCad）。
3. Gerber、钻孔、坐标文件（可直接下单嘉立创）。
4. BOM（Excel/CSV）：位号、数量、**完整原厂型号**、封装、立创商城编号、替代型号；标出所有 **[画板方核实]** 项的核实结论和数据手册页码。
5. 一张 PCB-1 的"连接器针 → 网络 → 器件引脚"对照表，覆盖 P1/P2/P3/J_EL 全部针。
6. 自查清单（逐条回答"是/否"）：
   - J_EL 针定义与第 4 节 CN5 表逐针一致；17/18 为 +5V_EL，19/20 为 +12V_EL。
   - 3V3_FPGA 与任何 5 V/12 V 网络之间没有直接连接。
   - 15.3 电路块 D 真值表中的全部状态均满足。
   - U1/U2 的 DIR、/OE、所有未用输入都有确定电平。
   - eFuse 设定的限流、软启动时间与本节数值一致，并附计算过程。
   - DRC 无错误；大电流路径线宽满足要求。

**画板方不得自行决定的事项**（需要先问用户）：更换电路结构、增减板子、把 HDMI 引到自制板、改变 11.2.1 的引脚分配、把 PTC/继电器放进 EL 电源路径、改用直插 Dock 的结构。

### 15.7 FPGA 侧配套要求（供写约束和 RTL 的人）

- 约束：11.2.1 表中所有用到的球位设为 LVCMOS33（Bank 3/7 = 3.3 V 已按原理图核实，U03 已关闭），输出驱动 8 mA，不开内部上拉（板上已有上/下拉）。
- 上电流程：配置完成 → 保持 `OE_N=1`、`VD_ON_N=1` → 开始输出完整黑场 EL 时序 → 读到 `VL_OK_3V3=1` 且 `PFAIL_N_3V3=1` → 置 `OE_N=0` → 至少 1 帧后置 `VD_ON_N=0`。
- 关机/故障：`PFAIL_N_3V3=0`、`VL_OK_3V3=0` 或 `VD_FLT_N_3V3=0` 时立即 `VD_ON_N=1`；之后至少 1 帧再 `OE_N=1`。
- 屏幕开关（`SCR_EN_3V3`，D1.3 起 J14-7 / T8，开内部上拉）：为低时立即 `VD_ON_N=1`，扫描和 OE 不变；回到高后去抖 20 ms、再等 100 ms 才允许 `VD_ON_N=0`（上电时同样先等）。已在 `fpga/el_hdmi` v0.2 的 `screen_switch.v` 中实现。
- 无 HDMI 信号超过 N 秒（默认 60 s，可由 UART 设置）：显示黑场并关 VD，防烧屏、省电；信号恢复后按上电流程重新开 VD。
- UART（115200 8N1）：Orange Pi 可设置二值化阈值、反色、抖动开关、60/120 Hz、超时时间，并读取状态位。

## 16. 面包板验证方案（打板前）

**结论：** 可以先在面包板上搭出电平转换 + 使能控制，点亮屏幕；但面包板阶段没有 eFuse（TPS25947 为 2 mm QFN，插不了面包板），改用 **NID100-12 的 Remote 脚当 VD 开关**，此时 NID100-12 只给 EL 屏供电。

### 16.1 现有库存可用 / 必须另购

| 必须买 | 原因 |
|---|---|
| 74HCT245 或 74AHCT245，**DIP-20**，4 片（2 用 2 备） | 库存无合适芯片：CD4000 系列 VIH≈3.5 V 且太慢；K155ID1 是辉光管译码器；分立三极管边沿达不到 ≤30 ns |
| DF11-20DS-2C 壳 + 预压 DF11 端子线（另一端裸线/杜邦） | CN5 为 2.0 mm 间距，不能用 2.54 杜邦母头硬插 |

| 建议买/借 | 原因 |
|---|---|
| 示波器 ≥50 MHz（**用户已有**） | 验证 30 ns 边沿、CP1 脉宽、建立/保持；探头用短接地弹簧，测 CP2 时带宽 ≥50 MHz 才能看清 ≤30 ns 边沿 |
| 可调电源（**即将到位**） | 点屏阶段直接给 VD/VL 供电并设限流，见 16.4 |
| 12 V/21 W 车灯泡 | 12 V 假负载（库存电阻功率不够） |
| 接线端子 / Wago 快插 | 5 V、12 V 大电流不走面包板触点（面包板约 1 A 上限、接触电阻大） |

| 库存件 | 用途 |
|---|---|
| 1 kΩ、100 kΩ、10 kΩ、33/47 Ω | A 侧串阻、下拉、上拉、B 侧串阻 |
| 330 Ω 或 470 Ω（库存无 390 Ω） | 面包板上的 11 路假屏幕输入负载 |
| 2N3904 / S9013 | NID100-12 Remote 控制 |
| 100 nF、100 µF/16 V、47 µF/25 V | 缓冲器去耦、5 V/12 V 局部储能 |
| LED + 1 kΩ / 4.7 kΩ | VL、VD 指示 |
| 10 A 保险管 | 24 V 输入保险（明纬建议每模块 8 A，可先用） |
| **不要用**：HK4100F 继电器、NTC 5D-15 | 继电器直通上电可能熔断模组保险；NTC 热态压降会让 VD 低于 11.4 V |

### 16.2 面包板电路要点

- U1/U2（DIP-20）按 15.3 电路块 A 接法，VCC 接 +5V_EL（NID100-5 输出经端子引来），每片 VCC 旁 100 nF；/OE 接 Dock J6-10（OE_N，D1.3 脚序）并 10 kΩ 上拉到 Dock 3V3。
- VD 控制（面包板专用）：NID100-12 的 RC 脚对 COM 接下拉电阻（默认关断，阻值按 U16 实测确定），由 +5V_EL 经一个受 FPGA 控制的三极管开关把 RC 拉到 1.2–12 V 范围内来开机。这样"5V_EL 存在 AND FPGA 命令"才开 12 V，5 V 掉电时 12 V 自动关。**先测 RC 脚开路电压与短路电流再定电路。**
- Dock 由电脑 USB-C 供电；**Dock 的 GND 必须与 NID 输出 GND 相连**（经 PMOD 3/4 脚）。
- 信号线 <10 cm；屏 GND 用粗线回到电源端子。

### 16.3 面包板分步

1. **只测电源，不接屏：** LRS-200-24 → NID100-5/NID100-12 全走端子；市电侧接 PE、端子加盖。测 RC 脚；接灯泡测 12 V 上升时间；拔市电观察 12 V 与 5 V 谁先掉（预期 12 V 先掉）。
2. **信号链，不接屏：** FPGA 输出测试时序（CP2 约 3 MHz），在 DF11 线束末端接 330 Ω 假负载测波形（或用 PCB-2）；验证 FPGA 未配置时无脉冲、OE_N 为高。
3. **接真屏：** 断电接线 → 上 5 V → FPGA 输出黑场 → OE_N=0 → 最后开 12 V；先显示本地测试图（第 12 节阶段 D），再上 HDMI。
4. 面包板只用于验证原理和点亮，长期运行改用 PCB-1/2/3。

### 16.4 用可调电源点屏（推荐的首次点亮方式）

有可调电源后，首次点亮**不必搭 NID100 Remote 控制电路**：用可调电源的限流功能代替 eFuse，人工按顺序开关输出。

- **双通道电源**：CH1 = 12 V 给 VD（CN5 19/20），CH2 = 5 V 给 VL（CN5 17/18）和缓冲器 VCC。两通道 GND 相连，并与 Dock 的 GND 相连。
- **单通道电源（用户实际情况，2026-10-18）**：可调电源只给 VD（12 V，CN5 19/20）。VL（CN5 17/18）和缓冲器 VCC 用另一路稳定 5 V，二选一：
  - NID100-5（由 LRS-200-24 供电）：先接好线束，再给 LRS 上市电，让 NID100-5 的输出自然爬升（相当于软启动）；**不要在 5 V 已经有电时再插 CN5 线束**。
  - 5 V/≥2 A 的 USB 充电头 + USB 接线端子小板：最简单、与市电隔离。
  - 两种方式都要在 CN5 端用万用表确认 4.75–5.25 V，并与可调电源 GND、Dock GND 相连。
  - **不要**用 Dock 板上的 5 V 给屏 VL 供电（Dock 板载降压容量未核实，且会把屏电流引进开发板）。
  - **不要**用可调电源的 12 V 再经 NID100-5 产生 5 V：这样 5 V 和 12 V 会同时上电、同时掉电，违反原厂顺序。
- **限流设定（[方案]，首次点亮）**：VL 限流 0.4 A；VD 先限 **1.0 A** 做黑场和稀疏图案测试，确认正常后再升到 **2.0 A** 做全亮测试。限流值均低于模组内部保险（F1 800 mA、F2/F3 1.6 A 慢断）的熔断能力，异常时电源先进入恒流。
- **上电顺序（人工）**：① 两路输出都关，接好线束；② 开 VL（5 V），万用表确认 CN5 17/18 端 4.75–5.25 V；③ Dock 上电、FPGA 加载、输出黑场完整时序，示波器确认 CP2/CP1/S 正常；④ 置 OE_N=0；⑤ **最后**开 VD（12 V）输出。
- **关机顺序（人工）**：① 先关 VD 输出，示波器或万用表确认 VD 已掉到 1 V 以下；② 停止 FPGA 时序或断开 Dock；③ 最后关 VL。
- 注意：
  - 很多可调电源"输出开"是阶跃，输出端还有电解电容，限流是唯一保护，不要把限流调到 3 A 以上。
  - 开 VD 前确认 FPGA 正在输出完整时序；先输出黑场，再切换图案。
  - 屏幕内部有约 200 V 交流高压，断电后也可能残留，任何时候不碰背面驱动板。
  - 可调电源调试通过后，再按 16.2 换成 NID100 供电，最终换成 PCB-1。

## 附录：工程记录最小模板

```text
测试日期/人员：
屏幕型号/序列号/模组版本：
核心板/Dock/转接板版本：
原厂规格书版本：
FPGA工程commit/工具链/约束文件版本：
电源型号、限流设定、线束长度：
实际HDMI有效尺寸/帧率：
EL帧率、CP1周期、CP2频率：
CN5端VL/VD最小最大值与两支路电流：
CP2/CP1/S与数据建立保持测量：
上电/拔电/欠压波形文件：
图案与结果、异常现象：
下一步与未关闭问题ID：
```
