huatanshaonian/EL-center/交接_2026-11-02_整机模型会话.md

# MIS-01 整机模型会话交接（2026-11-02）

写给接手的新会话。原会话负责整机 3D 模型、外壳加工图、钣金 / 打印件下单文件、架构与装配文档；画板、库存、焊接图由另一会话 **mis-01-5d** 负责。

---

## 1. 前面板观察窗亚克力：已完成（2026-11-02）

用户要求：亚克力只做前面板观察窗，每个窗口一块，共三块；市电端子罩、高压板绝缘罩都不做。模型和文档已经改好。

| 块 | 尺寸 W × H × T（mm） | 全局位置 x、z | 盖的窗口 |
|---|---|---|---|
| 管龛窗 | 152.5 × 86 × 1.5 | x 22.5–175、z 93–179 | NICHE（IN-14、IV-18，170 V） |
| 6E2 窗 | 54 × 59.75 × 1.5 | x 245–299、z 115.75–175.5 | EYE_WIN（250 V） |
| 盖革窗（必装） | 121.5 × 22.25 × 1.5 | x 177.5–299、z 93–115.25 | SBM_WIN（400 V） |

- **厚度从 2 改成 1.5**：窗口下沿 z 96.5 的正后方就是甲板前沿和盖革夹子板前沿（都在 y 2）。用 2 mm 再加胶层就会顶上；1.5 mm 加不超过 0.4 mm 的胶，背面在 y ≤ 1.9。
- **核对结果**：用 dump6 按胶厚 0、0.2、0.4 mm 各跑一遍，三块都不和任何零件重叠。最近的是甲板和夹子板（0.1–0.5 mm）、IV-18 玻壳（0.6–0.8 mm）。
- **装在外壳内部**：贴在前面板内表面（y 0），从里面盖住窗口，四边压在面板背面窗口外 1–5 mm 宽的实心边上。
- **四角 R1，没有开孔**。贴法：四周实心边点 UV 胶，或者用 ≤ 0.2 mm 的薄双面胶，不用整片 VHB。
- **6E2 窗和盖革窗之间只有 5 mm 横条**：两块在 z 115.5 分开，各压 2.25 mm，中间留 0.5 mm。6E2 窗那块右边只压 1 mm，因为右 EL 托架在 x ≥ 298、立柱在 x ≥ 300。
- **相关文件**：
  - 参数：`assembly_panel.ACRYLIC / ACRYLIC_T / ACRYLIC_R`；
  - 出图脚本：`fig_acrylic.py`；
  - 加工文件：`外壳加工/亚克力/` 里三份 DXF（CUT 层是切割外形）和 1 份 A3 1:1 PDF；
  - 位置图：png/34（不进 git）。
- 市电端子罩已从模型里删掉，装配说明第 2、3 步改成“端子裸露，先拔电源线”；整机架构和 PCB 安装建议改成“绝缘罩不做”。
- **还没做的**：整机渲染图 01–07、22 里的亚克力还是旧的两块。下次重建缓存、重出这几张图的时候顺手更新（22 在 git 放行名单里）。

## 2. 工作现场

| 项 | 内容 |
|---|---|
| 项目 | `E:/modeling/MIS-01`（GitHub huatanshaonian/EL-center，main） |
| 和 mis-01-5d 共用一个本地仓库 | 对方推送时会把本地所有提交一起推上去。对方的文件：`assembly_issues.py`、`build_guide_steps.py`、`el_driver/**`、`firmware/**`、`pi/**`，不要动 |
| 建模 Python | `.venv/Scripts/python.exe`（CadQuery 2.8、ezdxf、vtk），运行前设 `PYTHONIOENCODING=utf-8` |
| 表格 / PDF / shapely | `G:/anaconda/python.exe -X utf8`（pymupdf、openpyxl、shapely） |
| 整机构建 | `assembly.build()` 约 320 s |
| 零件缓存 | `C:/Users/TOP/AppData/Local/Temp/claude/C--Users-TOP--claude-projects-E--modeling-MIS-01-memory/2d95da52-d4d7-451c-9bed-c8d14cfb182a/scratchpad/dump6`（178 个零件 BREP + meta.json，含颜色，87f8166 之后建的）；用户同意继续用这个目录 |
| 缓存脚本（同一目录） | `build_dump_c.py <输出目录>` 重建缓存；`clash_all.py <dump> --only --gap 前缀…` 查干涉；`render_rest.py <dump>` 出 01–07、22、26；`render_silk_dump.py` 出丝印效果图；`inventory_step.py <step>…` 逐个数孔 |
| png 编号 | 先 `ls png`。30 = 丝印效果图，31 / 32 = mis-01-5d 的 MAX6921，33 = EL-IF 位置图，34 = 亚克力位置图；下一个空号是 35 |
| 进 git 的 png | 20、22、26、27、28、31、32（.gitignore 单独放行）；重新出这几张图时要一起提交 |
| Bash 的坑 | 在 heredoc 里写 Python 时，字符串里的 `\n` 会变成真换行；含 `\n` 的替换改用 Edit 工具 |
| 提交 | 提交说明要写清原因和改法，结尾加署名行；提不提交、提交哪些，按当次任务和用户商量 |

---

## 3. 本次提交的内容

已提交：装配说明“钣金到货先逐个试装面板件”（喷粉后孔会变小）；parts_list 加了“斜面电路板固定件（粘接）”；下单说明记下实际下单情况（侧板、背板没做，打印件 2 套），`外壳加工/下单说明.txt` 已重新生成；以及第 1 节的亚克力改动。

## 4. 已定事项摘要（详细内容在提交记录和文档里）

- **已下单的几何不能再改**：前壳、下巴托、IEC 小板、键盘座 + 背盖都已在生产。模型里这些件必须和 `外壳加工/` 里已下单的 STEP 保持一致。改到 `assembly_panel` / `assembly_shell` / `parts_dock` 相关参数时，先用 `export_enclosure.parts()` 重建，再和已下单 STEP 逐体比对（做差，体积应为 0）。b0ca528 就是这样核对的。
  - 例外：亚克力、铜柱这类零件不属于钣金件，可以改。
  - 到货后发现问题，只能手工补救，比如手钻、粘接。
- **外壳加工文件只在本机**：`外壳加工/` 不进 git，里面有钣金询价包、丝印 DXF（`丝印/`）、亚克力 DXF（`亚克力/`）、打印 STL、下单说明。
  - `键盘座_CNC询价/` 里的 PDF 是旧的 CNC 版，不要用。
  - 嘉立创工程师审图后，PDF 改过两处：压铆从内侧压（4513b6d），以及各件接地孔的具体位置（80c9ebe）。改好的 PDF 由用户自己发给客服。
- **外壳已下单**：嘉立创钣金做了前壳、下巴托、IEC 小板，米白哑光喷粉，前壳黑色单色丝印。侧板、背板没做。
- **打印件**：键盘座 + 背盖，PA12 天然灰（不染色），2 套。热熔铜螺母自己压。
- **斜面电路板固定**：前壳斜面没开安装孔。补救办法：板上沿两个 M3 孔各拧一根 M3×6 铜柱，加垫片，用 AB 胶粘在斜面内表面（b0ca528）。
- **EL-IF**：吊在电脑层板下、屏幕正后方，元件朝上（87f8166）。
  - DF11 屏线约 12 cm（用户只有一根 20 cm 的）；
  - 层板新开 Ø25 过线孔，在钻孔图 png/27 的 2-13；
  - 位置图：png/33。
- **IN-14**：电木底座直径 18.5。R_A 改到小板背面装，整机核对没有碰撞（698c538）。小板 D1.1 已换进模型核对。
- **模式开关 MFR01** 按 6 档用，丝印印 1–6（4aa2e1d）。

---

## 5. 其他没做完的

- **mis-01-5d 复查报告里请模型会话核对的条目**：在 `C:/Users/TOP/AppData/Local/Temp/claude/E--modeling-MIS-01/ca108497-3332-4449-9bef-3fa6dcc9cdd2/scratchpad/review2/*.txt`，看每份的第三节或 Q 节。
  - 已经答复的：SLANT-KBD N3、N4（喷粉孔径）、IN-14 相关、EL-IF 线长。
  - 第 1 节的亚克力设计已经解决了亚克力胶厚问题（GEIGER N2/Q1、IV18 三-1），但**还没回复 mis-01-5d**，要告诉它。
  - 还没答复的主要有：
  - GEIGER Q2–Q6：LS-601 夹口高、J4 插头空间、400 V 走线、PE 间距、VR 上方空间；
  - IV18 三-3～三-5：J1/J2 插头、扎带、IV-18 怎么装上机；
  - EYE-6E2 Q2、Q3；
  - SLANT-KBD 三-3～三-7：Pico 弯头、双口 USB 居中、旋钮、MFR01 尺寸、J_K 线的空间；
  - HARNESS N8（2×6 线长，EL-IF 挪位后要重算）、N10（BH1750 / LD2410 怎么装）、N3 / N6；
  - ELIF-HDMI 第 119 行。
- **还没实测的**（`零件实测记录.txt`）：5151 腔体喇叭、Pi 耳机插头、IN-14 底座厚度和引线伸出长度。另外 Dock 上 J5 / J6 / J14 分别对应 DISPLAY / CAM / TP / GPIO 里的哪个座，没有资料，PMOD 线长是按最坏情况算的。
- **联系画板会话**：用 SendMessage 发给 `mis-01-5d`。复查、库存、焊接图由它负责；牵涉整机几何的问题它会来问。
- **推送**：67e7578 和这份交接文档的后续提交都还没推送；推不推送、什么时候推送，按用户意见。
- **记忆**：用户的记忆快照 `C:/Users/TOP/agent-memory/releases/20261029-v2/MIS.md` 是固定版本，不要改。本文第 1、4 节的新情况都不在快照里，以仓库文档和本文为准。
