huatanshaonian/EL-center/MIS-01整机架构.md

# MIS-01 整机架构

> **名称**：MIS = Multi-Indicator Station（多指示器工作站），指整机把 EL 屏、IV-18 荧光管、IN-14 辉光管、6E2 电眼等几代显示器件放在一台机器上；-01 表示一号机。
> 2026-10-19 草案，2026-10-20 按《整机接线细化方案》v1.0（已定稿，D1–D13）更新。EL 显示子系统单独开发，本文只把它当一个黑盒，不展开。
> **本文只写结论。** 每根线、每个针、各控制器引脚，以接线方案页为准：https://claude.ai/artifact/BBVdXtcah9W9j4p5E1V7ue 。ESP32-S3 的引脚和功能以仓库 `firmware/esp32s3/ESP32-S3功能规格.txt` 为准（写程序的依据）。
> 相关文件：`面板方案.md`（面板布局）、`PCB安装与空间规划建议.md`（机内空间、孔位规则）、`procurement/MIS-01_直插件合单+面板输入_立创商城BOM.xlsx`（立创下单）、`procurement/MIS-01_自购清单.xlsx`（立创以外自己买的全部东西）。

---

## 1. 总览

整机分成四块，各自有一个控制器：

| 层 | 控制器 | 负责 | 跟主机的连接 |
|---|---|---|---|
| **主机层** | Orange Pi 4（Armbian） | 系统、应用、声音、语音控制（USB 麦克风阵列）、USB 外设 | — |
| **输入层** | Raspberry Pi Pico（在斜面电路板上） | 斜面上的按键、编码器、推子、模式开关 | USB HID，经一分四 Hub 模块 |
| **仪器层** | ESP32-S3（微雪 ESP32-S3-DEV-KIT，模组 WROOM-1U-N16R8） | 辉光钟、IV-18、6E2 猫眼、指针表头、盖革计数、传感器、RTC、蜂鸣器、电源管理 | USB（S3 原生 USB，Pi 上是 /dev/ttyACM0）+ 2 根 GPIO 关机握手 |
| **EL 显示** | Tang Primer 20K（FPGA）+ EL-IF | EL 屏 | HDMI + UART4（单独开发，不展开） |

每层自己处理实时的部分（扫描按键、刷新辉光管、数盖革脉冲），主机只收发高层消息。Orange Pi 死机或重启时，辉光钟还会走，盖革也还在计数。

信号与控制

**模块位置：** Orange Pi 4 和 FPGA Dock **已定**（2026-10-21 布置，10-23 用户确认，见 `assembly_computers.py`、png/20）：两块都放电脑层，HDMI 所在的边朝后，口面在 y 172.7（Dock）/ 174.2（Pi），离后面板内侧约 46 mm（同一条边上还有直头 DC 插头和 Pi 耳机插头，贴层板后沿只剩 22 mm 弯不过来）。Pi 在左（网口/USB 朝左，板 x 70–161、y 115.5–171.5），Dock 在右（板 x 167.5–262.5、y 99–172），Dock 用 M2.5×6 铜柱（板底 z 270）；Pi 用 M2.5×25 铜柱（板底 z 289）——用户的 Pi 4 排针焊在板子背面朝下，下面要插杜邦插头（2026-10-22）；孔位不在孔阵上要自己钻（层板已做好，2026-10-23 为让孔躲开孔阵和后走线孔，Pi 后移 1.5、Dock 左移 2.5；孔位见 png/27_drill_map.png）。两个 HDMI 口用 0.5 mm 20P 软排线两头小板相连（HDMI-PI D1 18×26、HDMI-DOCK D1 25×26，mis-01-56 已画完、STEP 已入模；插头插进 6.8 mm，板前沿 y 179.8（Pi）/ 178.3（Dock）），20 cm 同向排线在两口之间拱起（Pi 端高 19，两段竖直 34.6 / 53.6），拱顶 z 367。Pi 耳机插头要用包胶外径 ≤ Ø8 的细头（Ø10 只剩 0.1 mm）。EL 接口板吊在顶板下、Hub 在 Pi 前面、RK3399 散热片 + 风扇已放（暂定，见第 7 节第 5 条）；电脑层空间见 `PCB安装与空间规划建议.md` 第 3 节。

---

## 2. 主机层：Orange Pi 4

40 针排针的 IO 是 **3.0 V**（15、27–38、40 脚是 1.8 V，不用）。排针上只有一个可用串口 UART4（19/21 脚，开 `rk3399-uart4` overlay，会关掉 SPI1），已分给 FPGA；UART2 是调试控制台。

| 接口 | 接什么 | 说明 |
|---|---|---|
| HDMI | FPGA Dock → EL 屏 | 不展开 |
| USB 2.0 口 1 | ESP32-S3 | S3 原生 USB，/dev/ttyACM0（D1） |
| USB 2.0 口 2 | 一分四 USB2.0 Hub 模块 | Hub 下接：前面板 USB2 口、Pico、键盘座、USB 麦克风阵列（原备用口，Hub 四口用满）（D2、D3），见 2.1、2.2 |
| USB 3.0 A 口 | 上下叠放双口面板座（带耳延长线）其中一口 → 斜面左缺口 | 约 50 cm，从电脑层拉到斜面（2026-10-26 实测改为 1 个双口件） |
| Type-C 口 | 空着，调试 / 刷机用 | 双角色，带 USB 3.0 和 DP 1.2 输出；也能给板子供电，但不用 |
| 排针 19 / 21 | UART4 → EL-IF | /dev/ttyS4；EL-IF 上 RTX 已改 1 kΩ（D7） |
| 排针 16 | 运行状态 → ESP32 | 开机后 systemd 拉高；poweroff 后 RK808 断电自然变低 |
| 排针 22 | 关机请求 ← ESP32 | ESP 开漏拉低，Pi 侧服务执行 poweroff（D11） |
| 排针 2 / 6 / 18 | 风扇开关小板（W35，3 根杜邦）：5 V、GND、FAN_EN | 40×10 风扇经小板接 Pi，见下面“散热” |
| Hub 第 4 口 | USB 麦克风阵列（UAC 免驱） | 2026-10-21 用户加：语音控制在 Pi 上做；Pi 算出的音量经 ESP 协议 EYE B 命令显示在 6E2 猫眼 B（ESP 已无空脚，麦克风不接 ESP）。型号、面板位置待定，见 2.2 |
| 3.5 mm 耳机口 | PAM8403 功放 → 两只 4 Ω 腔体喇叭 5151 款（立体声） | 排针上没有模拟音频；喇叭在底层左右前角，出声面贴下层与甲板层 Y 梁内侧、朝外出声，从下巴托侧板的喇叭网出去；不用支架，耳朵朝上下，M3 + 锤头螺母锁两根 Y 梁内侧槽（2026-10-22 由单只 Ø40 改 3070，10-23 改 5151：本体 51×51×39.5、耳孔距 69，音腔约为 3070 的 4 倍） |
| 供电 | DC 口 4.0×1.7，5 V 3–4 A | 来自 PCB-3 主机电子保险 A，使能 = 主机钮子 或 ESP32 保持（见 5.1）。板上**没有电源键**，poweroff 后要重新上电才开机，正好配合电子保险断电 |

PWR_KEY 只在 24 针 FPC 座第 21 脚，暂不用，留作以后“不断电唤醒”的升级（D11）。

**散热**：电源板不做风扇口（2026-10-20 用户决定：机内总发热二三十瓦、左右两侧敞开，只有 Orange Pi 需要散热）。Orange Pi 用 RK3399 散热片 + 40×10 风扇（5 V），做**温控启停，不调速**：Pi 旁边贴一块约 2×2 cm 洞洞板（库存插件），S8050 低边开关，基极 680 Ω 接 Pi 18 脚（FAN_EN，高 = 转），10 kΩ 基极下拉，风扇两端并 1N4148 续流；电源取 Pi 排针 2 脚 5 V、地 6 脚（W35 Pi → 小板，W36 小板 → 风扇）。Armbian 上一个小服务 60 °C 开、50 °C 关。18 脚默认下拉，开机前风扇不转；软件没起来时靠 RK3399 自带的过热降频兜底。不跨层走线。另一个设想是被动散热：RK3399 经绝缘导热垫和铝块贴到 2020 型材上（机架接 PE），**待讨论**；布置 Pi 时尽量让 RK3399 正对某根立柱或横梁，给这个方案留余地。后面板两个 60 mm 风扇**不装**（2026-10-20 用户决定），原风扇孔留作通风孔。

### 2.1 前面的 USB 口

- **不做自制 USB 小板**，也不在斜面电路板上焊 USB 座。3D 核对：直插 USB-A 要求板到面板 ≥ 13 mm，推子只允许 6.5–10.5 mm，对不上（D2）。
- **Hub**：买现成的一分四 USB2.0 Hub 模块，带 DC 5 V 输入，用户已找到。5 V 来自 PCB-3 的主机电子保险 B，不从 Pi 取电。
- **前面的口**：用户买的是 1 个上下叠放双口 USB 面板座（带耳延长线，2026-10-26 实测：口部 15.5×14.5、本体 23×19.2×30、耳孔距 30 M3），
  装在斜面左缺口（中心 x 28、u 10），斜面开 15.8×14.8 方孔；两根线分别接 Pi 的 USB3.0 和 Hub。右缺口空着。
  斜面电路板 SLANT D1.1 的左缺口只到 u 17，本体高 19.2 放不下：到货后、焊元件前把左缺口切高到 u 20.5（png/28）。
- 立创单里已买的 USB-A 插座（C456018 / C6081374）不再需要。

### 2.2 USB 麦克风阵列（2026-10-21 加，型号未定）

- 现成的 USB 阵列麦克风，Linux 免驱（UAC），2–4 麦；机内有喇叭，最好板上自带回声消除和波束成形。
- 插在 Hub 的第 4 口；语音识别在 Pi 上跑。Pi 在线时约 20–30 次/秒发 EYE B 把音量送给 ESP，6E2 猫眼 B 显示声音大小（ESP32-S3 功能规格 v0.9 F10、第 6 节）。
- 装在前面板或斜面上开声孔，避开左侧面的喇叭和 Pi 的风扇；候选型号和位置给用户选定后再进采购单。

---

## 3. 输入层：Pico

Pico 焊在斜面电路板上，用 Micro-USB 短线接 Hub 模块，由 USB 5 V 供电；主机关时 Pico 也关，键灯全灭。Pico 枚举成 USB HID 设备，主机不需要装驱动；灯的状态由主机通过 HID 输出报告下发。

| 设备 | 数量 | 占用 I/O | 说明 |
|---|---|---|---|
| 24×18 带灯方键 | 6 | 6 入 + 6 出 | 每键一根 4 芯线（XH）到斜面电路板；灯 12 V，Pico 经 ULN2803 驱动；键帽可插菲林字片 |
| EC11 编码器（带按压） | 3 | 9 入 | 一排，x 98.5 / 123.5 / 148.5、u 63（2026-10-20 由 2 个改 3 个）；EC11E 没有螺纹套，**焊在斜面电路板上**，靠板子固定；ENC3 用 GP20/21/22 |
| 60 mm 推子 | 2 | 2 ADC | 10 kΩ 线性，比例式接法；外壳用 2×M2 锁在面板上，脚焊在斜面电路板上 |
| 模式开关 MFR01 | 1 | 1 ADC | 1 刀 6 位，**按 6 档接**（7 个 1 kΩ 分压链），软件也用 6 档（D8；2026-10-27 用户确认） |
| **合计** | | 数字 21、ADC 3 | GP20/21/22 也用上了，只剩 GP0/GP1（原留作调试串口）；**ADC 正好用完** |

**按键功能不是写死的。** 硬件写死的只有 3 个保护盖钮子开关（见 5.1）。6 个带灯方键（包括键上的灯）、3 个编码器、2 根推子、模式开关都只是 Pico 的普通输入，交给主机，功能由软件定，随时可以改；换一张菲林字片就能改键名。

Pico 各脚分配见接线方案 5.1 节。

---

## 4. 仪器层：ESP32-S3

ESP32-S3 管所有“仪表味”的东西。时间来自 DS3231 RTC，加 Wi-Fi 对时或从主机拿时间。和主机之间走 USB 串口命令。

### 4.1 各模块

| 模块 | 器件 | 驱动方式 | 高压 / 电源 |
|---|---|---|---|
| **辉光钟** | IN-14 ×6，按 HH:MM:SS 两两分组 | ESP32 → 4 片 **74AHCT595** 级联 → 6 片 K155ID1 → 阴极（第 4 片经 6 只 MPSA42 驱动右小数点）。AHCT 型是因为 595 用 5 V 供电，3.3 V 驱动普通 HC 不可靠 | **阳极 170 V**：自制“通用高压小板”（UC3843AN 直插，12 V 输入，150–280 V 可调，逐周期限流、过压钳位、泄放电阻；独立成板，插在主板上，可单独上桌调试），插在辉光驱动板上 |
| **IV-18 荧光管** | IV-18 ×1，在辉光管正下方 | MAX6921 串行驱动（VCC 3.3 V），DIN / CLK 和 595 共用 | 栅/阳极：原厂额定 50 V、最高 70 V，单段 ≤1.3 mA；**24 V 常电经 XL6009 升到约 35 V**，XL6009 输入经 ESP32 控制的开关，无人或夜间连同灯丝一起关。灯丝：5.0 V、85±10 mA（允许 4.3–5.5 V），1、13 脚；**交流方波 + 约 2 V 偏置**。BLANK 板上默认拉高，ESP 复位或死机即全灭。原厂寿命 ≥10000 h（D13） |
| **6E2 猫眼**（侧视条形指示管） | 6E2 ×2，竖放在表头右边 | 栅压控制光条长度：阴极接 12 V，栅极 0–12 V 正压驱动（ESP32 PWM 经 RC 滤波和三极管，不做负压）；北京 6E2 = EM87 | **阳极约 250 V**：同一款通用高压小板调到 250 V，插在 6E2 板上；两支灯丝串联取 HV-B 那路 12 V（高压关时灯丝也灭）；2 支共约 6 mA |
| **指针表头** | 85C1 0–1 mA 直流毫安表（64×56） | PWM 串 2.7 k + 1 k 微调直推动圈，表头两端并 10 µF | — |
| **盖革计数** | J305（实测总长 103.5、管身 Ø10、两端电极 Ø6.3；推荐 350 V，坪区 360–440 V） | **自制盖革板**，参考 MightyOhm 开源设计（CC BY-SA）：555 升压到约 400 V（电位器可调），开漏脉冲，ESP32 GPIO16 上拉到 3.3 V，中断计数 | **约 400 V**（板上自产） |
| **蜂鸣器** | **整机一只，在盖革主板上**：LS1 压电片 TDK PS1740P02E（C76872，配 R77 1 k）或 LS2 电磁式 YS-MBZ12085C05R42（C409842，配 D4 1N4148）二选一，两种焊位都留、都买，装机试听再定 | 盖革咔哒声由盖革板硬件直接产生；报警声（PFAIL、异常）由 ESP32 经 BUZZER 线（GPIO18）驱动同一只蜂鸣器；静音只关咔哒声，不关报警；开机默认不静音（BZ 线高或高阻 = 咔哒开，低 = 静音，方波 = 报警）；ESP32 底板上不放蜂鸣器 | — |
| **环境光** | BH1750 模块 | I²C（地址 0x23），每 1 s 读一次，用于 IV-18 自动亮度和 6E2 B 的本地内容（规格 F10） | — |
| **RTC** | DS3231 模块 | I²C（地址 0x68），和 BH1750 同一总线，纽扣电池保时间（D9） | — |
| **人体感应** | LD2410B | OUT 脚 + UART（256000）；排针 1.27 mm，要转接线 | 5 V |
| **电源管理** | 读 3 个钮子状态和 PFAIL；输出“保持”、HV_EN；和 Pi 之间的运行状态、关机请求 | 全部直接用 ESP 引脚（见 5.1） | — |

**引脚：** 已无空脚。**不用 PCA9555**，ESP 底板只留它的焊位，将来只给慢速功能扩展；高压、保持、扫描等关键信号一律直接用 ESP 引脚（D6）。不可用或另有用途的脚：GPIO0（BOOT）、45（启动配置，留作测试点）、19/20（原生 USB，经板载 Hub 接 Orange Pi）、35–37（N16R8 的 Octal PSRAM）、**38（板载 WS2812B RGB 灯，当状态灯）**、**43/44（板载 CH343P 串口，0 Ω 硬连，用作调试日志口）**。**IV-18 用 46（IV18_PWR_EN，启动配置脚，带下拉正好满足上电为低）和 48（灯丝方波）**。GPIO3 接 DS3231 SQW 秒脉冲；GPIO16 = GEIGER_IN，GPIO21 = PI_SHDN_REQ（v0.8 对调：21 无上电毛刺，ESP 重启不会误关 Pi）；GPIO18 = BZ（盖革板蜂鸣器）。逐脚分配以 `firmware/esp32s3/ESP32-S3功能规格.txt`（v0.9）第 1 节为准。新功能（如麦克风阵列）放在 Pi 侧，经规格第 6 节协议控制 ESP 的显示件。

### 4.2 高压一览

| 电压 | 给谁 | 来源 | 状态 |
|---|---|---|---|
| 170 V | IN-14 阳极 | 通用高压小板 #1（UC3843AN，12 V 输入，150–280 V 可调），接 HV-A（12 V） | 自制 |
| 约 250 V | 6E2 阳极 | 通用高压小板 #2（同上，调到 250 V），接 HV-B（12 V）；第 3 块备用 | 自制 |
| 约 35 V | IV-18 栅/阳极 | XL6009 升压模块，24 V 常电输入，经 ESP32 控制的开关（不受“高压”钮子控制）。先空载调到 35 V、电位器点胶再接板；到货后桌面实测，在扫描一直运行的状态下从 25 V 调到 35 V，按观感定最终电压。IV-18 板按最高 60 V 设计，以后嫌暗只换 45–50 V 模块 | 待买 |
| 约 400 V | J305 | 自制盖革板，接 HV-C（5 V） | 自制 |
| （EL 屏背面高压区） | EL 屏 | 屏模组内部 | 属 EL 子系统 |

HV-A、HV-B、HV-C 来自电源板上的高压受控电源，要“高压”钮子和 ESP32 的 HV_EN **同时**打开才有电（见 5.1）。高压板绝缘罩、市电端子罩不做（2026-11-02 用户定），前面板三个观察窗背后贴 1.5 mm 透明亚克力挡手指（fig_acrylic.py）。

---

## 5. 电源

电源树

```
市电 → IEC C14（保险 + 开关）→ LRS-200-24 → PCB-3 电源板
   PCB-3 ├→ NID100-12 → 12 V 常电：键灯、绿灯
         │             └→ EL 主机同步开关 → EL-IF +12V、Dock 12 V（与主机 5 V 同一使能）
         ├→ NID100-5  → 5 V 常电：ESP32-S3、LD2410B、IV-18 灯丝、PFAIL 电路
         │             ├→ 主机电子保险 A → Orange Pi 5 V（“主机钮子 或 ESP32 保持”）
         │             ├→ 主机电子保险 B → Hub 模块、PAM8403（同一使能）
         │             └→ EL 主机同步开关 → EL-IF +5V（同一使能）
         ├→ 高压受控电源（“高压钮子 与 HV_EN”）→ HV-A 高压小板 170 V（12 V）、HV-B 高压小板 250 V（12 V）、HV-C 盖革板（5 V）
         └→ 24 V：ESP32 控制的开关 → XL6009 → 约 35 V 给 IV-18、备用输出
```

- **功率：** LRS-200-24 能出 200 W，NID100-12 最大 90 W，NID100-5 最大 55 W。估算 24 V 约 4 A、12 V 约 3.4 A、5 V 常电约 1 A，都有一半以上余量；负载明细见接线方案第 7 节。
- **掉电顺序：** 24 V 往下掉时，12 V 先掉、5 V 后掉。这正好符合 EL 屏要求的顺序，细节见 EL 设计笔记第 10 节。
- **总开关**是后面 IEC 插座上的那个。只要插着电、总开关开着，ESP32 就一直有电，辉光钟、IV-18 照样走；Dock 和 EL-IF 不通电，随主机。

### 5.1 斜面三个保护盖钮子开关

钮子 MT-0-102 是 SPDT ON-ON，中间脚为公共端，公共端都接地。三个开关和绿、红灯用一根 8 芯线（W16）**直接拉到 PCB-3**，不经斜面电路板（D10）。由电源板上的电路去控制电源，ESP32 只是配合。

| 开关 | 电源板上的逻辑 | ESP32 做什么 | 指示灯 |
|---|---|---|---|
| **主机**（拨上 = 开） | 主机电子保险 A、B 和 EL 主机同步开关，使能 = **开关闭合 或 ESP32 保持** | Pi 运行期间一直拉高“保持”；开关拨下后请 Pi 关机，关完再松开 | 绿：12 V 常电经 AO3400，栅极接 Pi 的 5 V 输出（在 PCB-3 上） |
| **高压**（拨上 = 开） | 高压受控电源，使能 = **开关闭合 与 HV_EN** | 需要高压时拉高 HV_EN | 红：并在 HV-B 12 V 输出上 |
| **屏幕**（**拨下闭合 = 关屏**） | 经 PCB-3 高阻读取后转给 EL-IF（J_PF-2），状态同时送 ESP32（D12） | 只读状态 | 黄：EL-IF 的 J_LAMP（+12V_EL） |

**指示灯都接在被控电源的输出上**，灯亮就说明那路电真的有，不是“软件认为它有”。面板上所有灯统一用 12 V：三盏 Ø16 指示灯（灯头外径 19.5，三盏间距 21，背后 M16 螺母转成平边对平边）和 6 个带灯方键，都单独购买。

**主机：开关拨上**

主机 5 V 两路电子保险和 EL 主机同步开关同时打开：Pi、Hub、Pico、Dock、EL-IF 上电，绿灯亮。FPGA 起来后先输出黑场、VD 关。Pi 起来后把 16 脚拉高，ESP32 看到后拉高“保持”。HDMI 有画面后 FPGA 开 VD，黄灯亮。

**主机：开关拨下**

1. 因为“保持”一直是高的，电不会掉。ESP32 拉低 Pi 的 22 脚，请 Pi 关机。
2. Pi 的关机服务先经串口让 FPGA 关屏，再执行 `poweroff`；关完后 16 脚变低。
3. ESP32 看到它持续变低 5 秒，就松开“保持”，Pi 和 EL 一起断电，绿灯灭。
4. **兜底**：60 秒内没关完，ESP32 也松开“保持”。

**几条必须做到的细节**

- **“保持”必须在 Pi 运行期间一直有效**，不能等开关关了才拉。否则开关一断开电就掉了，ESP32 来不及接住。
- **ESP32 不在线时**（没烧程序、死机、复位），“保持”和 HV_EN 靠电源板上的 100 k 下拉自动无效。这时开关一关就直接断电，相当于退回普通开关，EL-IF 自带的保护兜底。
- **ESP32 开硬件看门狗**。死机后它会复位，复位时引脚松开，不会一直拉着“保持”。
- **软件里重启**：运行状态线只会短暂变低，不到 5 秒，不会被断电。
- **Pi 在软件里自己关了机，而开关还在“开”**：Pi 停在关机状态，绿灯仍亮（5 V 还在）。把开关拨到关再拨回开，就能重新开机。
- **突然断市电**：来不及软关机。PFAIL 先到，EL-IF 关 VD，ESP32 记一次异常断电。系统盘用只读根文件系统加 overlay。

**高压**

- 钮子触点和 HV_EN 控制的 N-MOS 串在三路 P-MOS 的栅极下拉回路里。单靠 ESP32 打不开高压，单靠开关也打不开。
- 三路高压都由自制板产生（两块通用高压小板、盖革板），电源板只控制给它们的低压输入：HV-A（高压小板 170 V，12 V）、HV-B（高压小板 250 V，12 V）、HV-C（盖革板，5 V）。

**屏幕**（EL 接口板由 EL 子系统负责，这里只写接口约定）

- J_PF 为 3 针：PFAIL_N、SCR_EN、GND，PCB-3 与 EL-IF 的针序 1↔1。
- SCR_EN 在 EL-IF 上 10 kΩ 上拉，钮子拨下拉低：经二极管直接关 VD（符合“VD 先关”的顺序），同时送 Dock J14-7（EL-IF D1.3 起；D1.2 是 J14-12），让 FPGA 走正常的待机流程。
- **FPGA 看到开关关闭后，要自己也撤掉 VD_ON_N。** 否则开关再打开时二极管一松，VD 会直接上电，跳过“先输出黑场、至少 1 帧后再开 VD”这一步。拨回后去抖 20 ms，再等 100 ms 才开 VD。

### 5.2 PCB-3 电源板

| 功能 | 内容 |
|---|---|
| 输入 | 24 V 输入端子（J_24V）、24 V 总保险 10 A（Mini / ATM 片式，红色；用户自有） |
| 模块 | NID100-12、NID100-5，各配 7.5 A 输入保险（Mini / ATM 片式，棕色；规格书建议 8 A）；R.C. 引到 3 针排针。输入范围 NID100-5 10.5–53 V、NID100-12 20–53 V；R.C. 脚开路 = 开、对 Com 短路 = 关；**输出外接容性负载上限：5 V 款 100 µF、12 V 款 68 µF（low-ESR）**，后级大电容要放在负载开关或 eFuse 之后；过载 hiccup 自恢复 |
| 掉电预警 | PFAIL 电路（原设计保留），输出给 EL-IF（J_PF）和 ESP32 |
| 主机 5 V | 两颗 TPS259470（与 EL-IF 同料）：A 给 Orange Pi，限流约 4.5 A；B 给 Hub 模块和功放，限流约 2.8 A；共用使能 = 主机钮子 或 ESP32 保持（D5） |
| EL 主机同步 | 两个 P-MOS 负载开关（12 V、5 V），给 EL-IF 和 Dock，与主机 5 V 同一使能（D4） |
| 高压受控电源 | 使能 = 高压钮子 与 HV_EN；三个输出口：HV-A（12 V，固定）、HV-B（12 V）、HV-C（5 V） |
| 常电 | 5 V、12 V、24 V 给 ESP 底板（J_INST_PWR），接在主机电子保险**前面** |
| 面板接口 | J_PANEL 8 芯：三个钮子、绿灯、红灯（D10） |
| ESP32 控制口 | J_CTL 8 芯：+5 V 常电、GND、HOLD、HV_EN、三路钮子状态、PFAIL_N；3.3 V 电平，HOLD / HV_EN 板上下拉 |
| 指示灯 | 绿灯 AO3400 驱动；红灯并在 HV-B |
| 其他输出 | 键灯 12 V（J_KEYLAMP）、Hub 5 V（J_HUB5V）、Dock 12 V（J_DOCK）、EL 电源（J_EL_PWR） |
| 备用输出 | 24 V、12 V、5 V 各两路，带保险。建议用贴片保险或小型插片保险，5×20 保险座太占地方 |
| 风扇口 | **不做**（Pi 风扇开关在 Pi 旁的洞洞小板上，见第 2 节“散热”） |
| 安装位置 | 架在 LRS-200 上方时，板底到 LRS 顶面留出空气层，板子不要完全盖住 LRS 顶面，免得挡它自然对流 |
| 尺寸 | 见 PCB-3 方案页 |

PCB-3 方案已定稿（v1.0）：https://claude.ai/artifact/ADPdRTHEehDAyfYCVwYqC9 ，原理图、插座、针序以方案页为准。

PCB-3 是下一步最先画的板子，插座编号和针序见接线方案第 4 节线缆表。

**NID100 插拔式**（2026-10-22 用户定，PWR-DIST D1.1）：板上焊 2.54 单排排母（塑高 8.5，每个模块 1×6 + 1×7），模块插上后用扎带捆在板上（板上有长条孔）。模块最低点 z 42.8，离 LRS-200 顶面 12.8 mm。

### 5.3 外壳与保护地（PE）

外壳件（2026-10-22 用户定，都在嘉立创钣金做，2 mm 铝）：

| 件 | 内容 | 固定 |
|---|---|---|
| 前壳 | 竖直前面板（加宽到 324）和斜面是一块板，斜面展开 90.8（2026-10-26 由 83 往下加长 7.8：铝脚垫 6 mm，键盘座整体下移），折 33°（内 R 1.7，嘉立创 2 mm 板外 R 3.7）；斜面两侧往里折 90° 翻边（从斜面外表面算 14 mm，u 8–64） | 前面板 M4 锁立柱、顶横梁；斜面翻边 M3 ×2/侧（压铆螺母）锁下巴托侧板 |
| 下巴托 | 底板 + 两块侧板（底板两边往上折），侧板在机架外侧（x −2..0 / 320..322），往后盖到 y 90，两侧板对着腔体喇叭（左 y 22–73、右 y 24–75，z 22–68）开喇叭网孔；底板后边往上折到 z 18（2026-10-26 起底板随下巴下移到 z −7.7..−5.7，翻边右段 x ≥ 238 降到 z 8 让开按钮焊片）；底板上装键盘转接小板 KBD-ADAPT | 侧板 M4 ×6/侧锁前立柱（×2）和下层、甲板层 Y 梁（各 ×2）外侧 T 槽；底板后翻边 M4 ×3 锁前下横梁 |
| 键盘座 | 嘉立创 3D 打印尼龙 MJF（PA12 天然灰、不染色，2026-10-27 用户定；2026-10-23 由 POM CNC 改：薄壁多面，CNC 难做），螺丝孔压 M3 热熔铜螺母，长 320，随斜面后仰、屏幕面与斜面共面；背面装 POGO 小板和磁铁后加背盖（2.0 厚、上沿 T 形加强防翘、全长 320、M2 ×4，下沿 46 宽出线口）| 两端各 M3 ×2 锁侧板；顶部 3 个舌片（高 10）从斜面下沿 M3 沉头锁（孔心离下沿 5，90° 沉头 Ø6.5） |
| IEC 小板 | 背面右下角一块 110×110 金属小板，装 IEC C14（SMA 2026-10-26 改装甲板） | M4 锁右后立柱、后下横梁 |
| 全高侧板、整块背板 | 纯盖板，不一定装（2026-10-22 用户），上面不固定任何东西；侧板让出下巴托侧板，背板让出 IEC 小板；开通风长孔 | M4 锁型材外侧 T 槽 |

加工文件：`export_enclosure.py` 出到 `外壳加工/`（不进 git）：每个零件折好弯的 STEP（嘉立创钣金要 3D、自己展开）、参考图 PNG、平板件 DXF、`下单说明.txt`（材料、表面处理、压铆、接地点）。

**保护地**：整机有外露金属（铝型材、前壳、下巴托、IEC 小板、LRS-200 外壳），必须接 PE。
- IEC 插座地脚 → 机架上一个总接地点（M4 + 齿形垫圈，咬穿型材氧化膜）。
- 总接地点用黄绿线分别接 LRS-200 的 FG 端子、前壳、下巴托、IEC 小板，每根线一个线鼻子。
- 喷塑、阳极氧化层都绝缘：接地点那一块要去掉涂层（下单时让钣金厂留不喷涂区，或者装的时候刮掉），不能只靠螺丝压着。

---

## 6. 自制板清单

| 板子 | 主要内容 | 高压 | 状态 |
|---|---|---|---|
| PCB-1 EL-IF | EL 接口与电源时序，100×100 | — | EL 子系统，D1.2 已完成 |
| PCB-3 电源板 | NID100 ×2、PFAIL、主机电子保险 ×2、EL 主机同步开关、高压受控电源、面板和 ESP32 接口、备用输出 | — | D1 PCB 已画完（150×100）；倒挂在甲板下、LRS-200 上方，M3×10 铜柱 |
| 斜面电路板 | Pico、ULN2803；EC11 ×3、推子 ×2 直接焊在板上（编码器 u 63 一排，推子 u 40 / 24）；方键、模式开关插座 | — | SLANT D1 已画完（mis-01-56，2026-10-21），STEP 已入模，碰撞检查通过。板子 x 17–166、u 0–78，板到斜面内表面 6.5 mm（推子贴死面板）；下沿 x 17–41（模式开关）、x 56–78（USB 母座）两个缺口到 u 17；孔 (29, 68)、(159, 72)、(159, 8)、(90, 8)；6 个键插座 XH-4 在 u 4；最紧处左上角离左前立柱 1.0 mm、模式开关 0.9 mm；设计记录 el_driver/SLANT_D1/ |
| ESP32-S3 底板 | 插微雪 ESP32-S3-DEV-KIT（两排排针中心距约 23，按 0.9 英寸 22.86 设计）；辉光驱动、IV-18、6E2、表头、盖革（含 BUZZER 报警线 GPIO18，蜂鸣器在盖革板上）、BH1750、DS3231、LD2410B、PCB-3 控制、Orange Pi 接口；PCA9555 只留焊位 | — | D1 已画完（mis-01-56，2026-10-21），STEP 已入模。平放在甲板驱动板后面 x 40–150、y 120–170（110×50；原定 90×50 放不下竖插的 DS3231，加宽），M3×6 铜柱，四孔 (45/145, 125/165) 都在孔阵上；开发板 USB-C 朝左（端面 x 42）接 Pi，U.FL 朝右，自带 IPEX→SMA 穿墙线（20 cm），SMA 座装甲板 (120, 187) Ø6.5 孔，棒状天线 15 cm 竖在甲板后部；DS3231 用 6P 弯针竖插在 J_RTC (125, 142)；PCA9555、J_EXP 不焊；设计记录 el_driver/ESP-BASE_D1/ |
| 辉光驱动板 | 4×74AHCT595、6×K155ID1（用 DIP 插座）、6×MPSA42（右小数点）、通用高压小板插座；前沿 6 个 2×7 排母，IN-14 小板直接插上 | 170 V | NIXIE-DRV D1 已画完（STEP 已入模）：150×80，M3×10 铜柱立在甲板上（x 20–170、y 40–120）；J_LOG XH-5 在 (37,116) |
| IN-14 管座小板 ×6（另做备用） | 管座、阳极电阻；21×40，底面 2×7 排针插驱动板，1 颗 M3 锁住，换管直接换板 | 170 V | IN14-SOCK D1 已画完（STEP 已入模）；板底 z 116.6 |
| IV-18 板 | 管座、MAX6921、灯丝交流方波驱动和偏置、XL6009 输入开关 | 约 35 V（按最高 60 V 设计：电容 ≥63 V，布线间距按 60 V） | D1 已画完（主板 IV18 D1 + 端板 IV18-END D1，mis-01-56 2026-10-21），STEP 已入模、碰撞检查通过；调研 el_driver/IV18_D1/调研_IV18.txt。管子调头：引线端朝右，芯柱端面 x 141，排气尖到 x≈26，管轴 y 12、z 106.6。主板 130×37（x 22–152、y 3–40），板底 z 95（1 mm 尼龙垫片，以贴片为主、板底剪平），元件只放 y 22–40、高 ≤10（y 38–40 高 ≤5）；竖立端板 x 143–144.6、y 3–36、z 96.6–114，22 根引线直接穿孔焊接、剪到 x ≤146.6，黑色阻焊，下沿两面各 11 个焊盘和主板 T 形焊、两个榫插主板槽；主板孔 (45, 35)、(135, 35)、(148, 8)（自钻，螺丝头离端板 0.6 mm），扎带槽 x 37 / 128；主板直插件（J1、J2、5 根测试针）焊脚在板底伸出 1.4–1.9 mm，板下只有 1 mm 垫片，焊完剪平到 ≤0.8 mm；J1 XH-14 接 ESP 底板 J_IV18，J2 XH-4 接 XL6009。XL6009 放不上，单独装在甲板 x 178–203、y 55–98（实测 43×25，对角两孔 (181, 61)(200, 92)） |
| 盖革主板 + 夹子长条板 | **自制**，参考 MightyOhm 开源设计：555 升压（约 400 V 可调）、脉冲整形、高压测试分压点、蜂鸣器（LS1/LS2 二选一）；J1 XH-2P 接 HV-C，J2 XH-4P 接 ESP32 底板（5 V 常电 / GND / PULSE / BZ），高压线主板 J_HV 直焊到夹子板 J_HVI；夹子长条板用 LS-601 6.3 mm 保险丝夹夹 J305 电极，检测电路在左端加宽处、4.7 MΩ 贴片阳极电阻在管下 | 约 400 V | D1 两块都已画完（STEP 已入模）。主板 60×70 平放在甲板 x 180–240、y 110–180，M3×6 铜柱，后两孔自钻；夹子长条板 L 形（长条 x 153–299、y 2–14，左端加宽到 y 40），板下垫高 3 mm、板底引脚剪到 1 mm 内，3 颗 M3×12 尼龙螺丝，每颗在板下垫 1 颗尼龙螺母 + 1 片尼龙垫片、甲板下再拧 1 颗螺母（M3×3 尼龙柱买不到，2026-10-23 改；右孔自钻）；首次通电前 VR1 拧到 10 Ω；料单 procurement/build_lcsc_bom_geiger.py；设计记录 el_driver/GEIGER_D1/ |
| Pi 风扇开关小板 | 约 2×2 cm 洞洞板：S8050、680 Ω、10 kΩ、1N4148，库存插件手焊 | — | 贴在 Pi 附近，不建模 |
| 键盘转接小板 | FH43BW-71S-0.2SHW(10) 座子（立创 C2840145，0.2 mm、71 针、下接，配 01AY247 原装排线）；从右数第 1–12 针和 GND、+5V 连片引到 2.54 排针；跳线默认接 XH 4P（1 5V、2 D−、3 D+、4 GND），D+/D− 可对调，检测脚留 10 kΩ 空焊位；约 35×25 | — | 方案已定（2026-10-20，用户实测引脚），座子交嘉立创贴片 |
| 6E2 板 | 管座 ×2（缺口转 18°，7 脚朝前）、栅极 0–12 V 正压驱动（ESP32 PWM → RC → 三极管，阴极接 12 V，不做负压）、灯丝串联取 HV-B 12 V、通用高压小板插座 | 约 250 V | D1 已画完（mis-01-56），STEP 已入模；90×90，x 210–300、y 15–105，M3×6 铜柱（四角孔都要自己钻）；管心 x 261 / 285、y 31；250 V 高压小板横放在管子后面 x 215–295、y 50–90；设计记录 el_driver/EYE-6E2_D1/ |
| 通用高压小板 ×3 | UC3843AN（直插，用户已买）升压，12 V 输入，150–280 V 可调；逐周期限流、过压钳位、泄放电阻 | 150–280 V | D1 已画完（80×40，8 只分压电阻要留间距）；做 3 块：170 V（辉光管）、250 V（6E2）、备用；排针插宿主板，叠高 11、M3×11 铜柱；料单 procurement/build_lcsc_bom_hv_6e2.py |

画图顺序：PCB-3 → 斜面电路板 → ESP32-S3 底板 → 高压板（辉光驱动、IV-18、盖革）。装法和孔位规则统一按 `PCB安装与空间规划建议.md`：长、宽取 10 的倍数，四角 M3 孔，孔心离板边 5。

---

## 7. 待定事项

1. ~~6E2 栅极驱动电路~~：已定，阴极接 12 V、栅极 0–12 V 正压，不做负压（2026-10-20）。
2. **ESP32-S3 开发板**：微雪 ESP32-S3-DEV-KIT（模组 N16R8），排针中心距约 23（按 22.86）已实测；板长、脚数和板载外设待查，查清再画 ESP32 底板、改 3D 模型 P32。
3. **6 个功能键、2 根推子的具体功能**（`面板方案.md` 第 5 节）。
4. **盖革板**：原理图按 5 V 输入重新核算升压参数。
5. **Orange Pi 4、FPGA Dock 的位置**：已定（2026-10-23 用户确认，见第 1 节）；层板手钻孔位 `fig_drill_map.py` → png/27。EL 接口板（2026-10-28 定）：吊在电脑层板下、屏幕正后方，元件朝上，板占 x 140–240、y 60–160、板面 z 230，M3×30 铜柱挂在孔阵孔上；DF11 屏线约 12 cm（用户只有 20 cm 一根），PMOD 线穿层板新开的 Ø25 过线孔 (225,85) 到 Dock，7–13 cm（png/33）；原先暂定的吊在顶板下 DF11 要 40–45 cm，不行。USB Hub 在电脑层前沿（Pi 前面）；RK3399 散热片 + 40×10 风扇（打印支架）。风扇开关小板不建模。装配顺序见 `MIS-01装配说明.md`。
6. **钮子保护盖**：没买到合适的，先不装（2026-10-26）。
7. **前面 USB 口**：已定（2026-10-26），1 个上下叠放双口件放左缺口 x 28，见 2.1。带灯按钮实测与模型一致（Ø16）。
8. **到货要实测的**：带灯方键端子、指示灯极性、键盘 POGO 触点、表头内阻（正泰 85C1，未到货）、Dock 12 V 实际电流、模式开关小电流下读数是否稳定。

已关闭：NCH6100HV 和 6E2 的 250 V 成品模块（都改为自制通用高压小板，不买）、时间来源（加 DS3231）、Orange Pi DC 口（4.0×1.7）。

---

## 8. 采购

**立创商城**

- 第一单（已下单）：`procurement/MIS-01_直插件合单+面板输入_立创商城BOM.xlsx`
- 第二批补单（PCB-3 直插件 + 通用高压小板 ×3 + 6E2 板，合并下单）：`procurement/MIS-01_第二批补单_立创商城BOM.xlsx`，由 `procurement/build_lcsc_bom_order2.py` 生成；PCB-3 的贴片件不在单里（在第四单，自己回流焊）。2026-10-21 加 C11107 20 cm 同向排线 ×5（HDMI 小板用 1 根，立创 5 根起订）。
- HDMI-PI D1（18×26）、HDMI-DOCK D1（25×26）：两层、1.6 mm，嘉立创**经济型 PCBA、单面贴装**；J1 夹板式 HDMI 公头（C711355，两面各一排 1 mm 脚距焊盘）不贴，用户自己拖焊；文件在 `el_driver/HDMI_FPC_D1/制板文件/`（Gerber、BOM、坐标）。贴片 BOM：两块各 C11073 ×1；Dock 板另有 C25120 ×8、C51118 ×1（U1 LDO，原 ME6211 C82942 嘉立创缺货换 AP2112K-3.3，e63d56f）、C15849 ×2、C14663 ×1。
- 贴片范围（2026-10-23 定，296af7a；下单细节以 `el_driver/嘉立创下单清单.txt` 为准）：嘉立创贴片每款收 50 元工程费，扩展库元件每种另收约 20 元换料费（每款单独收；PWR-DIST 一款 17 种扩展料，贴 2 套约 540 元），所以只有细间距排线座的 **KBD-ADAPT、HDMI-PI、HDMI-DOCK** 3 块交嘉立创经济型贴 2 套，PCBA 文件由 mis-01-5d（原 mis-01-56）出。
  - **EL-IF、PWR-DIST、IV-18 主板**：不勾贴片、PCB 订单也不勾钢网；三块板拼在一张简易钢片上（30×40 cm，只做顶层，`make_stencil_panel.py` 拼，4f309ed，已下单），用户刷 Sn63 锡膏、加热台回流焊；料在第四单。最难的是 PWR-DIST 的 TPS259470（VQFN-10 2×2，4 个）。
  - **HV-UNI ×3、IN-14 小板、盖革夹子板**：只有 1–2 个大焊盘贴片件，用户烙铁自焊；料在第三单。
  - 不贴的板原贴片文件都移到各板 `制板文件/贴片已取消_改自焊/`，焊接图里这些位号按手焊显示。
  - 回流焊工具（加热台、热风枪、锡膏等）在自购清单第二批第 41–47 项。
- 第三单（自焊贴片件）：`procurement/MIS-01_第三单_自焊贴片件_立创商城BOM.xlsx`，由 `procurement/build_lcsc_bom_order3.py` 生成，5 行：C711355 HDMI 夹板公头 ×10（4 用 6 备）、C10150 100 µH 功率电感 ×5（HV-UNI L1）、C27777 0.5 Ω 2512 ×20（HV-UNI RS1）、C172284 4.7 MΩ 250 V 2512 ×5（盖革 R2，原 C1694257 无货）、C17477 0 Ω 0805 ×100（IN-14 R_PR，也可用电阻腿代替）。
- 第四单（自贴三板贴片料）：`procurement/MIS-01_第四单_自贴三板贴片料_立创商城BOM.xlsx`，由 `procurement/build_lcsc_bom_order4.py` 生成，49 种，EL-IF、PWR-DIST、IV-18 主板各 2 套 + 备件（同规格只留一个编号：100 nF 0805 统一 100 V 的 C106243，0 Ω 用第三单的）。立创商城无货已换同规格件：1 µF 0805 → C91185、10 k 0603 → C98220、ME6211C33M5G-N → AP2112K-3.3TRG1 C51118（脚位相同）、IV-18 C3 100 nF/100 V → C106243（必须 100 V）。

第一单说明：

- 以 EL 驱动的《直插件合单》为底稿，格式不变，删掉 13 kΩ（C119350）和 1.3 kΩ（C28144345）两行。
- 第 27–37 行是面板输入器件：EC11 编码器 ×3、60 mm 推子 ×2、钮子开关 ×4、6 档旋转开关 MFR01 ×2（1 个备用）、USB-A 弯插 ×4 和直插 ×4、LD2410B、Pico、ULN2803（DIP-18）×2、DC 插头（Dock 用 / Orange Pi 用）各 2。型号、封装、品牌、编号都照立创商品页核对过（2026-10-19）。
- USB-A 插座在 D2 之后不再需要，已买的留作备件。

**自己买**：第一批 `procurement/MIS-01_自购清单.xlsx`（`make_buy_list.py`，2026-10-20 已买完，冻结）；之后新增的都进第二批 `procurement/MIS-01_自购清单_第二批.xlsx`（`make_buy_list_2.py`）。型号、尺寸都按规格书或厂家资料核过，出处写在表里。

第一批内容：

- 面板：带灯按钮 ×6、钮子翻盖 ×3、编码器旋钮 ×3、指针旋钮、推子帽 ×2、Ø16 指示灯 ×3、BH1750、LD2410B 转接线、POGO 小板。
- USB：一分四 USB2.0 Hub 模块（实测 66×50×16）、上下叠放双口 USB 面板座 1、Pico 用 Micro-USB 短线、键盘转接小板到 Hub 的 USB-A 公头转 XH 4P 成品线。
- 显示和高压：85C1 0–1 mA 表头、IV-18 用的 XL6009 ×2、9 脚管座、MAX6921、DS3231 模块。
- 其他：RK3399 散热片、PAM8403 和喇叭、40 mm 风扇、IEC 三合一插座和保险丝、型材和紧固件。

**自制板上的元件（2026-10-21 全部板子画完）**：立创第二批补单合成一张 `procurement/MIS-01_第二批补单_立创商城BOM.xlsx`（`build_lcsc_bom_order2.py`，数据源为 PCB-3、HV-UNI ×3 + 6E2、盖革、辉光驱动 + IN-14 小板、斜面板 + ESP32 底板 + IV-18 主板五份脚本），单里只有直插件，自己手焊；贴片件不在补单里（共 74 行）：KBD-ADAPT、HDMI 两块由嘉立创贴；EL-IF、PWR-DIST、IV-18 主板的贴片料在第四单，自己回流焊；HV-UNI 电感 / 检流电阻、盖革夹子板 4.7 MΩ、IN-14 小板 0 Ω、HDMI 夹板公头在第三单，烙铁自焊（见上）；已买过或自有的不在单里（Pico、ULN2803、EC11、推子、MAX6921、K155ID1、开发板、ZS-042，XH-2A/3A 第一单各买了 50）。整机线束（XH 胶壳、双头预压端子线、杜邦线）在自购清单第二批。
