huatanshaonian/EL-center/PCB安装与空间规划建议.md

# MIS-01 机内 PCB 安装与空间规划建议（讨论稿）

日期：2026-10-19　状态：**建议稿，等用户和画板方讨论后定稿**

这份文档回答三个问题：机箱里还有多少地方能放自制 PCB；板子的孔位按什么规则开；板子平放还是竖插、怎么固定。
所有尺寸单位 mm。图都在 `png/` 目录下，由整机模型自动算出来（脚本 `free_space.py`），布局改了可以重新生成。

---

## 1. 结论先说

1. **空间是够的。** 最大的一块是管座层后半区，约 278×164×168，整块是空的；电脑层现在整层空着（约 278×170×158），底层电源上方也还有大块空间（见第 3 节）。
   Orange Pi 4 和 FPGA Dock 已在电脑层暂定布置（2026-10-21，待用户确认）：HDMI 边朝后、口面 y 172.7，Pi 板 x 70–161、Dock 板 x 170–265，HDMI 软排线两头小板占位；下面第 3 节的空间分析是放它们之前做的。
2. **关键是统一孔位。** 建议所有自制板用同一条孔位规则：**长、宽都取 10 的倍数，四角 M3 孔，孔心离板边 5**。层板上开一片 10 mm 间距的孔阵，板子放在哪里四个孔都能对上（见第 4 节）。
3. **装法建议：** 管座层后半区做**竖插卡笼**（老式机箱那种一片一片竖着插），其他位置平放。竖插卡只比平放板多两条规则：高度统一 100、上下长边各留 3 mm 禁布（见第 5 节）。

---

## 2. 坐标和机箱基本尺寸

- **原点**：机箱左前下角（框架左前立柱的外角、底板上表面）。**X** 向右，**Y** 从前往后，**Z** 向上。
- **框架**：2020 铝型材，外形 320（X）× 220（Y）× 420（Z）。四根立柱占四个角（各 20×20），**框架内侧是 X 20–300、Y 20–200**。左右两侧没有侧板，是敞开的。
- **三层**：

| 层 | 层板 | 层板上表面 Z | 到上一层板底 Z | 最大高度 |
|---|---|---|---|---|
| 底层 | 3 mm 底板，全幅 | 0 | 90 | 90 |
| 管座层 | 2 mm 甲板，X 2–318、Y 2–198 | 92 | 260 | 168 |
| 电脑层 | 2 mm 层板，X 2–318、Y 30–198 | 262 | 420（顶板） | 158 |

- 竖直前面板外表面在 Y = −2，前下方还有一个往前伸出约 45 的斜面（装旋钮、推子、按键），斜面下沿装磁吸键盘座。
- 后面板在 Y = 220，上面有两个 60 mm 风扇（Z 310–370）和 IEC 电源插座（X 263–296、Z 24–84）。

---

## 3. 机内可用空间

### 3.1 怎么算的

整机模型里每个零件都投到 2 mm 网格上，算出每一格从层板往上有多高是空的。

- **只扣除已经定下来的东西**：电源、辉光管、IV-18、6E2、盖革管 J305、表头、EL 屏和托架、斜面器件、IEC 插座、喇叭、风扇、框架。Orange Pi 4 和 FPGA Dock 目前不在机内，不扣除。
- **还没画的自制板都不算**，所以下面的空间就是留给它们的。
- **高度从层板上表面算起**。PCB 的铜柱高度和 1.6 板厚要自己扣掉。

有两种情况：

- **贴层板放**：板子直接用铜柱装在层板上，可用高度是从层板到上方第一个东西的距离。
- **架高放**：板子用长铜柱或支架架到已有东西的上方（比如电源上方），可用高度是从那些东西的最高点到上一层板的距离。

### 3.2 空间列表

尺寸写作：长（X）× 宽（Y）× 可用高（Z）。

| 代号 | 位置 | X 范围 | Y 范围 | Z 范围 | 长×宽×高 | 说明 |
|---|---|---|---|---|---|---|
| A | 底层前条（电源前面） | 41–299 | 22–80 | 0–88 | **258×58×88** | 再往左（X 21–41）有喇叭，那一段只剩 25 高 |
| B | 底层电源右边 | 261–299 | 80–184 | 0–90 | 38×104×90 | 再往后是 IEC 插座 |
| C | 底层电源上方（架高） | 41–245 | 6–220 | 40–90 | **204×214×50** | 板底要在 Z ≥ 40（电源 30 高，端子防护罩 40 高） |
| C2 | 底层电源右上方（架高） | 245–299 | 34–184 | 40–90 | 54×150×50 | 同上 |
| D | 斜面下面的楔形 | 53–245 | −42–0 | 0–23 | 192×42×23 | 斜面器件的尾巴在上面，只适合很扁的东西 |
| E | 管座层后半区 | 21–299 | 56–220 | 92–260 | **278×164×168** | **整块是空的**，前面 Y < 56 是辉光管、IV-18、6E2、盖革管、表头 |
| E2 | 管座层表头后面 | 165–249 | 14–52 | 92–116 | 84×38×24 | 很小 |
| F | 电脑层整层 | 21–299 | 30–200 | 262–420 | **278×170×158** | Orange Pi 4、FPGA Dock 和要放这里的自制板一起布置。前边贴着 EL 屏背面（Y 26.5），屏背面有高压，**实际用时前边退到 Y ≥ 37**；后面板 Z 310–370 有两只 60 风扇（Y 205–220） |

### 3.3 图

**俯视高度图**：每层两张，上排是贴层板放，下排是架高放。颜色表示可用高度，框是能放下的最大空矩形，标注 长×宽×高。

机内可用空间俯视图

**立体示意：贴层板放**（从前面看，前面板、EL 屏已隐藏。橙色 = 底层，蓝色 = 管座层，绿色 = 电脑层）

贴层板放的空间

**立体示意：架高放**（从后面看）

架高放的空间

---

## 4. 建议的统一孔位规则（所有自制板）

PCB 统一规格与安装方式

| 项目 | 规则 | 原因 |
|---|---|---|
| 外形 | **长、宽都取 10 的倍数**，例如 100×100、100×60、80×60、40×40 | 配合层板孔阵；100×100 以内嘉立创打板最便宜 |
| 安装孔 | **四角各一个 M3 孔，孔径 3.2，孔心离两条板边各 5** | 孔距 = 板长 − 10，一定是 10 的倍数 |
| 孔周 | 孔心周围 Ø6 内不走线、不放元件；接地孔可以做金属化并接 GND | 留给铜柱、螺母、垫片 |
| 板厚 | 1.6 | 竖插导轨按 1.6 做槽 |
| 连接器 | 尽量都放在**同一条短边**上 | 竖插时这条边朝机箱后方，好插拔、好走线 |
| 铜柱 | 平放用 M3 铜柱，**不低于 6**（让开背面焊点） | |

**层板孔阵：** 层板激光切割时，在空着的区域开 Ø3.2 孔阵，**间距 10，孔心在 X、Y = 10 的倍数 + 5**（例如 X = 25, 35, 45…）。板子的边落在 10 的倍数上时，四个安装孔正好对上孔阵，所以**放在哪里、以后挪到哪里都不用重新打孔**。孔阵本身也起通风作用。

---

## 5. 安装方式

### 5.1 两种装法

| | 平放 | 竖插（卡笼） |
|---|---|---|
| 固定 | 铜柱拧在层板孔阵上 | 3D 打印的上下导轨夹住板子上下两条长边，后端用一个小角片锁住安装孔 |
| 多出来的规则 | 无 | 高度统一 **100**；上下长边各 **3 mm 禁布**（不放元件、不走线、不露铜，插进深 2.5 的槽里）；元件面统一朝 +X |
| 优点 | 最简单；重的元件（模块、大电容）没问题 | 单块板从后面直接拔出来调试；板子竖着，热气往上走；外观像老式机箱 |
| 缺点 | 叠起来以后，下面的板不好拆 | 要做导轨；元件高度受槽间距限制 |

### 5.2 管座层后半区的竖插卡笼（建议）

- **位置**：空间 E（X 21–299、Y 56–220、Z 92–260）。
- **结构**：两块侧立板加上下两条导轨，全部 3D 打印，下导轨用螺丝固定在甲板孔阵上。卡笼是独立的一个件，整体可以拆下来。
- **槽**：**8 个槽，间距 30**。卡的元件面一侧可用约 25 高，背面焊点 / 引脚不超过 3。
- **卡的尺寸**：高 100（Z 约 97–197），长 ≤ 160（沿 Y 方向）。
- **插入方向**：拆下后面板，从后往前插。连接器在卡的后边，接线都在机箱后部。
- **走线**：导轨顶上到电脑层板之间还有约 54 高，用来走线。
- **元件高度**：元件高于 25 的（大电解电容等）要卧倒装，或者占两个槽。NCH6100HV 约 22.5 高，放得下。

### 5.3 各块板的建议位置

这里只建议放哪儿、有什么限制，**板子尺寸由画板方按电路定**，只要符合第 4 节的规则就行。

| 板子 | 建议装法和位置 | 要注意的 |
|---|---|---|
| 24 V 配电板（PCB-3，带 NID100-5 和 NID100-12） | **倒挂在甲板下、电源上方**（元件朝下，M3×10 铜柱，四孔落在甲板孔阵 x 85/225、y 65/155；板占 x 80–230、y 60–160；元件最低 z 51，离电源顶 21） | NID100 模块 51.2×12×27.1，加针 4.5，高 31.6；电源输出端子在电源右端（X 约 215–237） |
| EL 接口板（PCB-1，实际 100×100，见 el_driver/D1.2/变更记录_D1.2.txt） | 吊在电脑层板下面、屏幕正后方（元件朝上，x 140–240、y 60–160，板面 z 230；2026-10-28 定） | 到 Dock 的排线 7–13 cm（穿层板 Ø25 过线孔）；到屏 CN5 的 DF11 约 12 cm |
| 辉光管驱动板（K155ID1 × 6 + 通用高压小板插座） | 甲板上、6 支 IN-14 后面平放（NIXIE-DRV D1，150×80，x 20–170、y 40–120，M3×10 铜柱） | **170 V 高压**；IN-14 小板用 2×7 排针直接插在它前沿，不走排线 |
| ESP32 底板 | 平放在甲板上、辉光驱动板后面：x 40–150、y 120–170（110×50，D1 已画完），M3×6 铜柱，四孔 (45/145, 125/165) 都在孔阵上 | 要连到 IV-18、表头、6E2、盖革板、Orange Pi 上电控制 |
| 盖革主板 + 夹子长条板（参考 MightyOhm；整机唯一的蜂鸣器在主板上） | 主板 60×70 平放在甲板上 x 180–240、y 110–180（6E2 板后面），M3×6 铜柱，四孔 (185/235, 115/175)，前两孔在孔阵、后两孔要自己钻；左后角压住甲板后走线孔右端约 4×4 mm；夹子长条板 L 形在 J305 正下方（长条 x 153–299、y 2–14，左端加宽到 x 153–186、y 2–40），垫 3 mm 尼龙柱、板底引脚剪到 1 mm 内，3 颗 M3 尼龙螺丝：左 (165,35)/(175,35) 在孔阵上，右 (296.5,10.8) 自钻 | **约 400 V 高压**；J305 管轴 x 186–289.5、y 8、z 105.3；夹子长条板到主板用短线 |
| 6E2 板（管座 ×2、栅极驱动、灯丝，插通用高压小板 250 V） | 90×90 平放在甲板上 x 210–300、y 15–105，M3×6 铜柱，管座顶面 z 111.6；250 V 高压小板横放在 x 215–295、y 50–90；后沿让开右后走线孔（y ≥ 120） | 约 250 V；管心 x 261 / 285、y 31；前面下方是 J305 和夹子长条板（y ≤ 14） |
| Pico 载板（含 CH334 USB Hub） | 平放，底层前条（空间 A）；或者贴在斜面板背后 | 离旋钮、推子、按键近 |
| 功放（PAM8403 小模块） | 底层，靠近喇叭（X 22–39、Y 30–70） | |
| IN-14 管座小板 × 6、IV-18 板 | 已在模型中定位，不在本规则内 | 按现有模型尺寸画；IN-14 小板 21×40 |

---

## 6. 需要一起讨论的问题

1. ~~CN5 排线怎么走~~：已定（2026-10-28）。EL 接口板吊在电脑层板下面、和 CN5（X 160、Z 229，用户确认位置）几乎同高，DF11 从板左边外面往前到屏背面，约 12 cm，不用穿层板。
2. ~~6E2 的 250 V 和 6.3 V 由哪块板出~~：已定，6E2 板 + 通用高压小板。
3. **管座层用竖插、其他平放**，这样可以吗？还是全部平放更省事？
4. **竖插卡的长度**：统一 100×100（最便宜），还是允许 100×160？
5. **板间连接**：首版建议每块卡用线缆直接连（连接器放在后边）。以后板子多了再考虑做背板。
6. **高压安全**：170 V、约 250 V、约 400 V 三路高压，还有 EL 屏背面的高压区。高压板绝缘罩不做（2026-11-02 用户定），靠前面板观察窗亚克力和机壳挡手指；竖插卡的元件面统一朝 +X，相邻两块板之间要留够间隙。

---

## 附：相关文件

| 文件 | 内容 |
|---|---|
| `png/08_free_space.png` | 每层俯视高度图 |
| `png/09a_free_space_3d_floor.png`、`png/09b_free_space_3d_raised.png` | 空间立体示意 |
| `png/10_pcb_standard.png` | 孔位规则、竖插卡、卡笼、层板孔阵示意 |
| `free_space.py` | 重新计算空间：`python free_space.py` 出俯视图和列表，`python free_space.py 3d` 出立体图 |
| `step/MIS-01_layout_assembly.step` | 整机模型（不含还没画的自制板） |
| `Sharp_LJ64K052_HDMI_EL_Engineering_Design_Note.md` 第 15 节 | EL 接口板、配电板的画板任务书 |
