huatanshaonian/EL-center/面板方案.md

# MIS-01 面板方案（布局 E11）

> 简图：`png/concepts/layout_E11.png`　|　整理日期：2026-10-18　|　状态：布局已定，各按键、推子的具体功能未定

---

## 1. 总体布局（正视，外形 320 W × 420 H；前面板加宽到 324，左右各盖住下巴托侧板 2 mm）

| 区域 | 内容 |
|---|---|
| 顶部边条 | 右上角光线 / 人体感应器；**可选**：屏幕上沿告警信号牌条（6–8 个字窗，约 267×14，未定） |
| 上部 | EL 屏 LJ64K052（10.4"），屏框 267×220 |
| 中部左侧管龛（窗 146×79.5，x 24–170、z 96.5–176） | 6 支 IN-14 横排，IV-18 横放在辉光管正下方 |
| 中部右侧 | 指针表头（85C1 类，64×56）；表头右边竖放 2 支 6E2 侧视指示管（面板开口 x 248–298、z 118–174，上下边和表头面框齐平）；下方横放盖革管 J305（窗 x 180–298、z 96.5–113）；表头底边向右延伸成一条横条，把 6E2 窗和盖革窗隔开；三个开口（管龛、6E2、盖革）背面都贴 2 mm 透明亚克力 |
| 底部斜面（展开 320×90.8，与竖直面约成 33°；2026-10-26 由 83 往下加长 7.8，器件位置不变） | 交互区，四组器件，见第 2 节。斜面和竖直前面板是一块铝板折出来的（2026-10-22） |
| 键盘座（接在斜面下沿，后仰） | X1 Tablet 磁吸键盘座：长 320，屏幕面与斜面外表面共面、一起后仰 33°，键盘连接条（5 mm，用户实测）吸在座子底面；内含 POGO 触点小板和磁铁。原来竖直的底座条取消（2026-10-22），连接方式见整机架构 5.3 |
| 侧面 / 后面 | 侧板、背板先不装（2026-10-22）；背面右下角只装一块约 105×110 金属 IEC 小板：IEC C14 电源座 AC-14-F12（SMA 2026-10-26 改装甲板 (120, 187)），小板接 PE（见整机架构 5.3） |
| 机内 | 两只腔体喇叭（立体声）在底层左右前角，从下巴托侧板的喇叭网出声，正面不开孔；麦克风暂缓 |

## 2. 斜面布局

坐标：x 从斜面左边缘向右量，u 从斜面下沿沿斜面向上量，单位 mm。
四组器件从左到右排布：**左边距和组间距都是 14，右边距 22**。右边多留的 8 mm 是因为最右列长方形键的键体深约 30，会碰到机架右前立柱（x ≥ 300）。三条对齐行线为 **u = 18 / 40 / 63**。

| 组 | x 范围 | 器件 | 中心位置 |
|---|---|---|---|
| ① 模式 | 14–60 | 6 档旋转开关 MFR01 + Ø32 指针旋钮（2026-10-27 定按 6 档用） | x 37，u 40 |
| | | 1 个上下叠放双口 USB 面板座（开孔 15.8×14.8 R0.5 + 2 个 M3 耳孔，孔距 30；2026-10-26 实测） | x 28，u 10（斜面电路板左缺口） |
| ② 调节 | 74–159 | 3 个 EC11 编码器 + 旋钮 Ø15（2026-10-20 由 2 个改 3 个） | x 98.5 / 123.5 / 148.5，u 63 |
| | | 2 根 60 mm 行程横推子（左侧留标签位） | 槽中心 x 123.5（槽 92.5–154.5），u 40 / 24（间距 16） |
| ③ 电源 | 173–230 | 3 个带保护盖的钮子开关 | x 180.5 / 201.5 / 222.5，螺纹孔 u 26 |
| | | 3 盏 Ø16 指示灯 12 V（各对应上方开关） | 同 x，u 63 |
| ④ 功能键 | 244–298 | 6 个 24×18 长方形带灯按键，3 排 × 2 列，键帽内放菲林字片 | x 256 / 286，u 63 / 40 / 18 |

以上坐标和 3D 装配（`assembly_panel.py`）一致。

## 3. 需要接线的设备与引脚预算

### 3.1 设备清单

"线数"指占用控制器的 I/O 数，电源线不计。

| 设备 | 数量 | 每个的接口 | 合计 I/O | 建议接到 | 备注 |
|---|---|---|---|---|---|
| 24×18 带灯按键 | 6 | 1 路按键输入 + 1 路灯 | 6 入 + 6 出 | Pico | 灯为 5–12 V 时经 ULN2803 驱动 |
| EC11 编码器（带按压） | 3 | A / B / SW | 9 入 | Pico | ENC3 用 GP20/21/22 |
| 60 mm 推子 | 2 | 模拟量 | 2 ADC | Pico | 选线性（B 型）10 kΩ |
| 6 档旋转开关 MFR01 | 1 | 电阻分压成 1 路模拟量 | 1 ADC | Pico | 6 个触点接 7 只 1 kΩ 分压链；也可以直接接 6 路数字输入 |
| 带保护盖钮子开关 | 3 | 硬件直接通断（主机 / 高压 / 屏幕） | 可选 3 路状态检测 | ESP32 | 建议用来控制继电器或 MOSFET 的使能端，不直接通断大电流 |
| Ø16 指示灯 12 V | 3 | 红、黄直挂被控 12 V；绿灯经 MOSFET 指示 Pi 的 5 V | 0 | — | 用户自购 |
| 指针表头 | 1 | PWM | 1 | ESP32 | |
| 6E2 指示管 | 2 | 栅极控制 PWM | 2 | ESP32 | 灯丝 6.3 V×2 串联接 12 V；阳极需 150–250 V |
| IN-14 + K155ID1 | 6 | 每支 4 位 BCD | 3（3 片 74HC595 级联） | ESP32 | 阳极 170 V 由自制通用高压小板提供（2026-10-20 改） |
| 高压使能（HV_EN，经 PCB-3 高压受控电源） | 1 | 数字输出 | 1 | ESP32 | |
| IV-18 + MAX6921 | 1 | DIN / CLK / LOAD / BLANK | 4 | ESP32 | DIN、CLK 可以和 595 共用，省 2 根 |
| 盖革板（J305，自制） | 1 | 脉冲输入（GEIGER_IN，GPIO16） | 1 | ESP32-S3 | 规格 v0.8 由 21 改 16 |
| 蜂鸣器（在盖革板上） | 1 | 数字输出（BUZZER，GPIO18） | 1 | ESP32 | 整机一只，装在盖革板上；咔哒声由盖革板硬件产生，报警声由 ESP32 驱动；静音只关咔哒声；型号待选、新买 |
| 光线传感器（BH1750） | 1 | I²C | 2 | ESP32 | |
| 人体感应（LD2410） | 1 | OUT 或 UART | 1–2 | ESP32 | |
| ESP32 ↔ Orange Pi | 1 | USB（S3 原生 USB）+ 2 根 GPIO 关机握手 | 2 | ESP32-S3 | 接线方案 D1 |
| 喇叭 | 2 | Orange Pi 音频输出 → 功放（立体声） | 0 | Orange Pi | **需要一块功放**（PAM8403 类，两路都用） |
| 前面 USB 口（模式旋钮下方，上下叠放双口件） | 2 | 一口直连 Pi USB3；一口经 Hub 模块 | — | Orange Pi | 接线方案 D2/D3 |
| X1 键盘座（斜面下沿，POGO 触点） | 1 | USB（用户实测：触点 1 GND、2 +5V、3 D−、4 D+、5 检测、6 GND；1 和 6 在键盘内连通） | — | Orange Pi | 经 USB Hub；磁铁位置等键盘实测 |
| Pico（输入层，已定） | 1 | USB HID | — | Orange Pi | 经 USB Hub；Pico 和 Pico 2 引脚兼容，二选一；不需要 W（无线）版 |
| EL 屏 | 1 | 并行数据 | — | FPGA | 不属于面板控制 |

### 3.2 各控制器引脚预算

| 控制器 | 已用 | 可用 | 余量 | 结论 |
|---|---|---|---|---|
| **Pico**（输入层） | 数字 21（按键 6 + 灯 6 + 编码器 9），ADC 3 | GPIO 26，其中 ADC 3 | 数字 2（GP0/GP1），ADC 0 | 够用。ADC 正好用完，以后再加模拟量要外接 ADC |
| **ESP32-S3**（仪器层，WROOM-1U） | 约 22–24 | 约 25（N16R8：GPIO35–37 被 Octal PSRAM 占用；另避开 USB、下载串口、启动配置脚、板载 RGB 灯） | 很少 | **用满**，不加 PCA9555（只留焊位，D6）；595 和 MAX6921 共用 DIN、CLK |
| **Orange Pi 4 的 USB** | Pico、键盘座、斜面 2 口，共 4 个 | 板载 USB-A 约 3 个（以实物为准） | 不够 | 买现成一分四 USB2.0 Hub 模块（带 DC 5 V），不自制（D2） |

## 4. 立创商城 / 嘉立创可买情况

价格来自立创商城（szlcsc.com）自营现货，2026-10-18 查询，单位人民币、含税；"10+"是买 10 个及以上时的单价。立创商城的货可以和嘉立创 PCB 订单一起付运费；嘉立创 SMT 贴片用的是同一个库存。价格和库存每天都在变，下单前再看一眼。

### 4.1 立创有现货

| 器件 | 推荐型号 | 立创编号 | 库存 | 1 个起 | 10+ | 说明 |
|---|---|---|---|---|---|---|
| 60 mm 推子 | Bourns PTA6043-2015DPB103 | C17555413 | 83 | ¥20.00 | ¥17.01 | 10 kΩ，线性（B） |
| 60 mm 推子（备选） | Alps RS6011SP6003 | C370993 | 1069 | ¥12.94 | ¥11.21 | 10 kΩ，更便宜，但阻值曲线要查规格书确认 |
| EC11 编码器 | Alps EC11E15244B2 | C470754 | 4108 | ¥14.60 | ¥12.55 | 带按压，和现有模型 EC11E15244G1 同一系列（G1 缺货，¥13.41） |
| 编码器（备选） | Bourns PEC11R-4215F-S0024 | C143790 | 5339 | ¥14.48 | ¥12.20 | 带按压 |
| 钮子开关 | 源丰 MT-0-102-A101-M200-RS | C1788492 | 8943 | ¥3.85 | ¥3.23 | MTS-102 类，M6 螺纹，单刀双掷 |
| 波段开关 | Alps SRBV160803（6 档） | C470374 | 310 | ¥19.49 | ¥16.60 | PCB 焊接型，能不能穿面板用螺母固定要看规格书 |
| 波段开关（便宜款） | 六钧 MFR01-A2F05L1S-R（1 刀 6 位：公共端 C + 触点 0–5；45° 一格、8 格分度，后两格无触点；M10×5.5 螺纹套；焊片） | C19077029 | 503 | ¥3.77 | ¥3.04 | 2026-10-19 更正：原写的 MFR01-A1F04L1S-N（C19076971）其实是 4 档 |
| Ø8 指示灯 | 台普 TP90801P24RA（红）/ TP90801P24GA（绿）/ TP90801P24YA（黄） | C19191314 / C19191315 / C19191317 | 60–90 | ¥12.78–13.35 | — | 型号里的 24 表示 24 V；电压要和接的电源轨对上 |
| MAX6921（SOIC-28W） | MAX6921AWI+ | C7459794 | 9 | ¥75.89 | — | 和现有模型同封装；淘宝约 ¥40，但真假难保证 |
| 灯驱动 | ULN2803A | C845537 | 35273 | ¥1.36 | ¥1.04 | |
| 移位寄存器 | 74HC595D | C5947 | 42966 | ¥0.68 | ¥0.54 | 辉光管要 3 片 |
| 高压三极管 | MPSA42 | C305411 | 71 | ¥0.25 | ¥0.20 | 6E2 / 辉光管驱动 |
| 555 | NE555DR | C7593 | 31607 | ¥0.70 | ¥0.56 | 盖革板升压 |
| USB Hub | CH334P | C5373042 | 22748 | ¥2.50 | ¥1.94 | 4 口 |
| 功放 | PAM8403 | C5122557 | 1363 | ¥1.73 | ¥1.39 | 喇叭用 |
| 光线传感器 | BH1750FVI-TR | C78960 | 41069 | ¥6.25 | ¥5.01 | 芯片；要现成模块的话淘宝更方便 |
| 人体感应 | HLK-LD2410B-P | C5183132 | 381 | ¥33.86 | ¥29.22 | 模块 |
| Pico | Raspberry Pi Pico | C7203002 | 825 | ¥43.71 | ¥37.48 | 也可以用 Pico 2（RP2350，C41407547），引脚兼容；内部下拉有已知问题，按键都接上拉即可 |
| ESP32 模组 | ESP32-WROOM-32E-N4 | C701341 | 3107 | ¥22.97 | ¥20.03 | 自己画底板时用 |
| DIP-16 插座 | 博穆 IC-16P 窄 | C2326 | 663 | ¥0.28 | ¥0.22 | K155ID1 用 6 个 |
| USB-A 母座 | 莱联 LAIL-TYPE-A-4P-03Y-ZC | C55553058 | 299 | ¥1.88 | ¥1.49 | 卧式还是立式需核对 |

### 4.2 立创没有或不合适，要另外买（淘宝 / 闲鱼）

| 器件 | 立创的情况 |
|---|---|
| 24×18 长方形带灯按键（可插菲林字片） | 只有施耐德 XB6EDW3B1P（C17296943），库存 2，¥214 一个，不现实 |
| 钮子开关保护盖（M6） | 没有 |
| 推子帽、编码器旋钮（Ø15）、Ø33 指针旋钮 | 没有 |
| 85C1 指针表头 | 只有德力西 42L6 大号交流电压表，不合适 |
| 6E2 的 9 脚管座（noval） | 没有（6E2 已买） |
| ESP32 开发板 | 已有 ESP32-S3（WROOM-1U 外接天线版），不再采购 |
| XL6009 模块 | 成品模块（NCH6100HV、成品盖革板已改为自制，不买） |
| X1 Tablet 键盘 POGO 触点小板（01AY247 / DA30000JU30）、磁铁 | 拆机件；小板不带磁铁，磁铁要另配 |
| 面板型波段开关（如 RS26，带螺纹套） | 如果 PCB 型波段开关不方便固定，就用这个 |

### 4.3 已有

IN-14 ×6、IV-18、K155ID1 ×6、CZN-15E 驻极体麦克风（原误记为蜂鸣器）、EL 屏、Orange Pi 4、Tang Primer 20K、明纬电源（LRS-200-24 / NID100-5 / NID100-12）、X1 Tablet 键盘。

## 5. 待定事项

1. 6 个功能键、2 根推子的具体功能
2. 屏幕上沿的告警信号牌条要不要做
3. 麦克风方案
4. 推子用 Bourns（¥20）还是 Alps（¥12.94，要先确认是线性）
5. 波段开关用 PCB 型还是面板型
6. ESP32 引脚偏紧：确认是否接受共用 DIN / CLK，或者把部分功能改用 I²C 扩展芯片
7. Orange Pi 4 的实际 USB 口数量（决定 Hub 要几口）
8. 键盘座的触点位置和磁铁位置（POGO 小板、键盘到货后实测）
