huatanshaonian/EL-center/el_driver/连接器与缓冲引脚表_D1.md

# 连接器与缓冲引脚表 D1

> **⚠ 本表已过时（2026-10-27 核对）：这是 D1.3 之前的旧针表，P1/P2/P3 脚号、FPGA 球位和 J_PF 都已改过。接线、查脚一律以 `el_driver\D1.3\EL_IF_D1.3.net` 和 `el_driver\D1.3\变更记录_D1.3.txt` 为准，不要按本表接线。** 按 D1.3 网表核实的关键差异：
> - P1（Dock J5）：旧表 P1-5…12 = UD0…LD3；现在 P1-5 LD3、6 LD1、7 LD2、8 LD0、9 UD0、10 UD3、11 UD1、12 UD2（FPGA 球位随之改，见变更记录第一节第 5 条）。
> - P2（Dock J6）：旧表 CP2/CP1/S = P2-5/6/7、OE_N = P2-8、VD_ON_N = P2-9、VD_HI_N = P2-10、P2-11/12 NC；现在 P2-6 VD_HI_N、8 VD_ON_N、9 CP2、10 OE_N、11 CP1、12 S，P2-5、P2-7 不连接。
> - P3（Dock J14）：旧表 PFAIL_N = P3-7、UART_TX/RX = P3-10/11、P3-6 NC；现在 P3-5 UART_TX、7 SCR_EN、8 VD_FLT_N、9 VL_FLT_N、10 VL_OK、11 UART_RX、12 PFAIL_N，P3-6 不连接。
> - J_PF：旧文写 J_PF-2 = GND；现在 J_PF-1 PFAIL_N_3V3、J_PF-2 SCR_EN_3V3、J_PF-3 GND。
> - 封装改为与 Dock 相同的奇偶交错编号（1、2 = 3V3_FPGA，3、4 = GND），2×6 杜邦线 1 脚对 1 脚，不能调头插。J_EL 针表未变。

日期：2026-10-18。D1 原生工程已导入嘉立创EDA：EL-IF 12页、PFAIL 3页；两套ERC均为0错误/0警告。旧298个已连接引脚、122个新增/替换预期连接及13个应保持NC脚检查通过。所有连接尚待实物通断、线束方向和波形核对。

|信号|Dock|板端|FPGA球位|A串阻|缓冲A脚|缓冲B脚|B串阻|CN5|
|---|---|---|---|---|---|---|---|---|
|UD0|J5-5|P1-5|L9|RA1 1k|U1.2|U1.18|RB1 33Ω|2|
|UD1|J5-6|P1-6|N8|RA2 1k|U1.3|U1.17|RB2 33Ω|1|
|UD2|J5-7|P1-7|N9|RA3 1k|U1.4|U1.16|RB3 33Ω|4|
|UD3|J5-8|P1-8|N7|RA4 1k|U1.5|U1.15|RB4 33Ω|3|
|LD0|J5-9|P1-9|N6|RA5 1k|U1.6|U1.14|RB5 33Ω|6|
|LD1|J5-10|P1-10|D11|RA6 1k|U1.7|U1.13|RB6 33Ω|5|
|LD2|J5-11|P1-11|A11|RA7 1k|U1.8|U1.12|RB7 33Ω|8|
|LD3|J5-12|P1-12|B11|RA8 1k|U1.9|U1.11|RB8 33Ω|7|
|CP2|J6-5|P2-5|B12|RA9 1k|U2.2|U2.18|RB9 47Ω（试值）|9|
|CP1|J6-6|P2-6|C12|RA10 1k|U2.3|U2.17|RB10 47Ω（试值）|11|
|S|J6-7|P2-7|B13|RA11 1k|U2.4|U2.16|RB11 47Ω（试值）|13|

每路 A 脚经 RPA1–RPA11（100kΩ）下拉；每路 CN5 信号经 RPB1–RPB11（100kΩ）下拉。

U1/U2：1 DIR、20 VCC → +5V_EL；10 GND → GND；19 /OE → OE_N；ROE 10kΩ → 3V3_FPGA。U2 的 5–9 脚（A4–A8）接地，11–15 脚（B8–B4）不连接。C1/C2 各 100nF 紧靠 20/10 脚，D1原理图与PCB候选均采用库存10µF/50V直插C3（C-02），共用一只；脚距、直径先量实物再冻结封装。U1/U2均为SN74AHCT245N PDIP-20。

## P1 全针表

|针|网络|
|---|---|
|1|3V3_FPGA|
|2|3V3_FPGA|
|3|GND|
|4|GND|
|5|EL_UD0_3V3|
|6|EL_UD1_3V3|
|7|EL_UD2_3V3|
|8|EL_UD3_3V3|
|9|EL_LD0_3V3|
|10|EL_LD1_3V3|
|11|EL_LD2_3V3|
|12|EL_LD3_3V3|

## P2 全针表

|针|网络|
|---|---|
|1|3V3_FPGA|
|2|3V3_FPGA|
|3|GND|
|4|GND|
|5|EL_CP2_3V3|
|6|EL_CP1_3V3|
|7|EL_S_3V3|
|8|OE_N|
|9|VD_ON_N|
|10|VD_HI_N|
|11|NC|
|12|NC|

## P3 全针表

|针|网络|
|---|---|
|1|3V3_FPGA|
|2|3V3_FPGA|
|3|GND|
|4|GND|
|5|VL_FLT_N_3V3|
|6|NC|
|7|PFAIL_N_3V3|
|8|VL_OK_3V3|
|9|VD_FLT_N_3V3|
|10|UART_TX|
|11|UART_RX|
|12|SPARE_J14_12|

## J_EL 全针表

|针|网络|
|---|---|
|1|EL_UD1_5V|
|2|EL_UD0_5V|
|3|EL_UD3_5V|
|4|EL_UD2_5V|
|5|EL_LD1_5V|
|6|EL_LD0_5V|
|7|EL_LD3_5V|
|8|EL_LD2_5V|
|9|EL_CP2_5V|
|10|GND|
|11|EL_CP1_5V|
|12|GND|
|13|EL_S_5V|
|14|GND|
|15|GND|
|16|GND|
|17|+5V_EL|
|18|+5V_EL|
|19|+12V_EL|
|20|+12V_EL|

P2-11/12、P3-6 必须保持 NC。P3的VL_OK、VD_FLT、VL_FLT和P2的VD_HI_N已接电源子电路。PFAIL来自外接J_PF：独立PFAIL图的PFAIL_DOCK_N接J_PF-1（PFAIL_N_3V3），GND接J_PF-2；不要把另一接收端PFAIL_OPI_N并入此网。完整NID电源分配板仍待补齐。3V3_FPGA 仅从 Dock 引入，不能接 5V。

依据：工程设计说明 §4、§11.2.1、§15.3；TI SN74AHCT245 数据手册 SCLS233S p.3。

新增测点：TP_VDH=VD_HI_N；TP_VLFLT=VL_FLT_N_3V3。EL-IF另32处测点含11路5V信号、3路时钟3.3V、输入/输出电源、EN/故障/ILM及4处GND。测点封装为2.4mm焊盘/1.0mm镀孔，PCB布局时将2处GND及信号测点放J_EL旁、另GND放eFuse旁。DF11-20DP-2DS(24)为弯插通孔座，机械方向和1脚仍以屏与线束实物确认。
