huatanshaonian/EL-center/el_driver/D0审查与D1改进建议.md

# EL-IF D0 审查结论与 D1 改进要求

日期：2026-10-18。审查对象：`MIS-01-EL-Driver-D0.epro2`（Schematic2，102 器件）、`EL_IF_D0.net`、`电源设计审查_D0.md`、`simulation/仿真报告_D0.md`、`面包板实验接线与验收_D0.md`、`购买清单与库存复用_D0.md`。

本文件写给负责出 D1 的人或 AI。上级依据仍是工程根目录的 `Sharp_LJ64K052_HDMI_EL_Engineering_Design_Note.md` 第 3、4、10、15、16 节；本文件与其冲突时，以本文件为准，并把冲突列给用户。

标记说明：
- **[原厂]**：来自厂家数据手册。
- **[必改]**：D1 必须做。
- **[建议]**：推荐做，不做要在交付说明里写明理由。
- **[核实]**：需要查原厂资料或实测后才能定。

---

## 1. 已核对通过，D1 不要改动

以下项目已逐项对照网表和 TI 数据手册（SLVSFC9C，2026-05 版），结论是正确的：

| 项目 | 核对结果 |
|---|---|
| P1/P2/P3 针表 | 与设计笔记 §11.2.1 一致；P2-11/12、P3-6 为 NC |
| J_EL 针表 | 与 CN5 原厂针序一致。另有一个独立来源也印证了这套针序：开源项目 HDMI2EL 的 LJ64HB34 转接板 CN1，针序与 CN5 逐针相同 |
| U1/U2 SN74AHCT245 | DIR=+5V_EL，/OE=OE_N，未用 A 输入接地，B 输出悬空 |
| U_VL/U_VD 引脚 | 1 EN/UVLO、2 OVLO、3 AUXOFF（NC）、4 FLT、5 IN、6 OUT、7 DVDT、8 GND、9 ILM、10 ITIMER（NC），与 TPS259470x 引脚表一致 |
| 限流 | [原厂] RILM = 3334/I：4.22k → 0.79 A；1.33k → 2.51 A |
| 软启动 | [原厂] CdVdt(pF) = 2000/SR(V/ms)：2 nF → 1 V/ms（5 V 约 5 ms）；2.7 nF → 0.74 V/ms（12 V 约 16 ms）。IdVdt 为 0.81–3.82 µA，实际时间会在约 0.6–2.7 倍范围内变化 |
| VL UVLO | 1.20 × 3.74 ≈ 4.49 V 上升；1.09 × 3.74 ≈ 4.08 V 下降 |
| OVLO | VL 1.20 × 4.57 ≈ 5.48 V；VD 1.20 × 11 = 13.2 V，均低于屏绝对额定（VL 7 V / VD 14 V） |
| 锁存复位 | [原厂] 锁存故障需 EN/UVLO 低于 VSD(F)（0.45–0.74 V）或 VIN 断电才能清除。FPGA 置 VD_ON_N=1 时，EN_VD 经 100k 下拉到约 0 V，可以复位。D2/D3 钳位时 EN_VD 约 0.3–0.66 V，低于 UVLO 下降阈值 1.09 V，可以关断 |
| 反向阻断 | [原厂] TPS25947 带反向电流阻断：+12V_IN 掉电后，+12V_EL 不会倒灌回输入 |
| U_SUP、U_NOR、Q_VL、D2/D3 | 网表连接正确，其中 BAT54WS 阴极接 VL_OK/PFAIL、阳极接 EN_VD |
| 失效安全 | Dock 3.3V 掉电时，NOR 输出为 0、VL_OK 为低，VD 关断；A 侧 100k 下拉使 B 侧输出为低 |
| J_EL 型号 | DF11-20DP-2DS(24) 是 2.0 mm 弯插通孔座（商城描述"2x10P 间距:2mm 弯插"），与屏上 CN5 同型号，可以使用。文档里"直插/弯插矛盾"的说法删掉即可；PCB 布局时按弯插确定出线方向 |

---

## 2. 纠正一处过严的要求（影响"能否接屏"的结论）

**问题：** D0 的 README 和电源审查把"VD 放电全过程中 VL 必须保持 ≥ 4.75 V"当成接屏前提，并据此写了"不可接屏"。

**[原厂] 实际要求（规格书 p.16，13(b) Power on/off sequence）：** 时序图只规定上电"VL → 信号 → VD"、下电"VD → 信号 → VL"，备注"T1–T4 ≥ 0"。图中没有给出任何电压门槛或放电时间要求。4.75–5.25 V 是正常工作范围，不是下电过程的约束。

**[必改] D1 文档改为以下工程规则（标为 [方案]，不是原厂要求）：**

1. 关机顺序：先关 VD，确认 VD 已降下来后再停扫描（信号拉低、OE_N=1），最后断 VL。
2. "VD 已降下来"的判据：VD_HI_N 变高（见第 3.2 节），然后再固定等待 T_VD_WAIT。T_VD_WAIT 的数值由实测 VD 衰减波形确定，留出 2 倍余量。
3. 意外断电时，靠以下两条保证顺序：
   - (a) PCB-3 的 PFAIL 在 24V 跌到约 21V 时硬件关断 VD；
   - (b) **NID100-5 的输入下限约 10.5 V，比 NID100-12 低很多**（NID100-12 在输入约 20 V 以下就停止输出），所以 24V 下降时 12V 先没、5V 后没，VL 天然比 VD 持续得久。[核实] 用 NID100 规格书确认两者的输入范围，并在样机上实测 24V 掉电时两路的掉电先后。
4. 删除"不可接屏"的表述，改为："按设计笔记 §16.4，用限流台式电源手动给屏上电点亮，同时测 VD 衰减；PCB-1 电源部分定版前，不用 PCB-1 给真屏供电。"

---

## 3. 原理图修改（D1）

### 3.1 [必改] U_VL 故障输出接出

- U_VL 第 4 脚（FLT）新建网络 `VL_FLT_N_3V3`，经 10 kΩ（0603）上拉到 3V3_FPGA。
- 连接到 P3-5，原 SPARE_J14_5 取消；TP_SP2 改为该网络的测试点。
- 同步更新连接器表：J14-5 = VL_FLT_N_3V3。

### 3.2 [必改] VD 存在检测 VD_HI_N

目的：让 FPGA 知道 VD 是否已经降下来。电路与 Q_VL 同结构，信号经开漏输出，12 V 不会进 FPGA 引脚。

| 位号 | 器件 | 连接 |
|---|---|---|
| RVHU | 100 kΩ 0603 1% | +12V_EL → VD_GATE |
| RVHD | 22 kΩ 0603 1% | VD_GATE → GND |
| Q_VH | AO3400A | G = VD_GATE，S = GND，D = VD_HI_N |
| RVHP | 10 kΩ 0603 | 3V3_FPGA → VD_HI_N |

- VD_HI_N 连接到 P2-10，原 SPARE_J6_10 取消；TP_SP1 改为该网络的测试点。
- 逻辑：VD 高于约 3–8 V 时，VD_HI_N 为低（低 = VD 仍有电）。这个范围由 AO3400A 的 Vgs(th) 0.65–1.45 V 决定，所以只作粗判，必须配合 T_VD_WAIT 使用。
- [核实] 12 V 时 Vgs ≈ 2.16 V。查 AO3400A 数据手册，确认此时能可靠把 10k 上拉拉到 0.4 V 以下。

### 3.3 [建议] VD 主动放电（预留，按实测决定是否焊）

要求：VD 关断后，即使 Dock 已经断电，也能放电。

| 位号 | 器件 | 连接 |
|---|---|---|
| U_INV | SN74AHCT1G04（SOT-23-5），VCC = +5V_EL | 输入 = EN_VD，输出 = DIS_G |
| RDISG | 100 Ω 0603 | U_INV 输出 → Q_DIS 栅极 |
| RDISPD | 100 kΩ 0603 | Q_DIS 栅极 → GND |
| Q_DIS | AO3400A | S = GND，D 经 R_DIS 接 +12V_EL |
| R_DIS | 100 Ω，2512 或 1206，脉冲额定 ≥ 1 W | +12V_EL → Q_DIS 漏极 |

- 选 AHCT 的原因：输入是 TTL 门限，VIH = 2.0 V，EN_VD 高电平 3.0 V 能可靠识别。**不能用 LVC1G04 接 5V**，它在 5V 供电时 VIH = 3.5 V，3.0 V 识别不了。
- 逻辑：EN_VD 高 → Q_DIS 关；EN_VD 低（包括 Dock 断电、PFAIL、VL_OK 故障）→ Q_DIS 开，经 100 Ω 放电，初始电流约 120 mA。
- U_INV、Q_DIS、R_DIS 标为可选器件（DNP 选项）。先实测不加放电时的 VD 衰减，决定是否焊接以及 R_DIS 的阻值。
- [核实] eFuse 关断瞬间与放电管导通会有短暂重叠，用示波器确认没有异常电流。

### 3.4 [必改] 输入、输出保护（按 TI 应用建议，SLVSFC9C 第 8 章 / 布局章节）

| 网络 | 器件 | 位置 | 理由 |
|---|---|---|---|
| +12V_IN | SMAJ15A（单向 TVS） | J_PWR 与 U_VD IN 之间，靠近 IN | Vc ≈ 24.4 V，低于 TPS25947 IN 的绝对最大值 28 V |
| +5V_IN | SMAJ6.0A（单向 TVS） | 靠近 U_VL IN | 保护 eFuse 输入 |
| +12V_IN | 100 µF / 25 V 电解 | J_PWR 旁 | 抑制线缆电感造成的输入振荡 |
| +5V_IN | 100 µF / 10 V 电解 | J_PWR 旁 | 同上 |
| +12V_EL | 肖特基二极管（如 SS34 / B340A，SMA 封装），阴极接 +12V_EL、阳极接 GND | 紧靠 U_VD OUT | [原厂] TI 建议在 OUT 对 GND 加肖特基，吸收关断时的负向尖峰 |
| +5V_EL | 同上 | 紧靠 U_VL OUT | 同上 |

- 说明：TVS 只负责保护 eFuse 本身。屏端的过压由 eFuse 的 OVLO 在 1.2 µs 内断开来保护。所以"TVS 钳位电压高于屏绝对额定"不是问题，不需要在屏端并 TVS。
- [核实] 电解电容的纹波电流和 ESR。

### 3.5 [必改] 测试点

当前只有 3 个 0.5 mm 测试点，示波器探头接不上。D1 改为 ≥ 1.5 mm 焊盘或测试环，网络如下：

- **电源**：+5V_IN、+5V_EL、+12V_IN、+12V_EL
- **控制**：EN_VL、EN_VD、VL_OK_3V3、VD_FLT_N_3V3、VL_FLT_N_3V3、VD_HI_N、OE_N、PFAIL_N_3V3
- **信号**：EL_CP2_5V、EL_CP1_5V、EL_S_5V、EL_UD0_5V（放在 J_EL 附近）
- **接地**：GND 测试环 ≥ 3 个，其中 2 个在 J_EL 旁、1 个在 eFuse 旁，用于示波器短接地

### 3.6 [建议] 串联电阻

- 0603 焊盘保持不变。D0 仿真是在 CN5 插针处取的波形，没有算上屏内部 390 Ω 串联电阻和屏输入电容的滤波作用，所以 33 Ω 的振铃比实际情况悲观。
- D1 原理图标注"值待面包板实测"。初值建议：CP2、CP1、S 用 47 Ω，数据线用 33 Ω；最终值由面包板实测决定（候选 33/47/68/82/100 Ω）。

### 3.7 [建议] 电压监控阈值

- 当前 4.50 V，可以接受。如果要提高，把 RVS2 改为 3.57 kΩ 0.1%：(100 + 3.57 + 10)/10 × 0.405 ≈ 4.60 V。
- 不要高于 4.65 V，否则 5V 正常波动时可能误报。
- [核实] 3.57k 0.1% 0603 的货源。

### 3.8 保持不变

- **Q_VL**：U_SUP 已改由 Dock 3.3V 供电，Q_VL 与它功能重复，但作为第二道保护保留，D1 不删。
- **U_VL 的 EN/UVLO**：仍由 +5V_IN 分压，VL 不受 FPGA 控制。

---

## 4. 文档与 BOM 修改

1. 按第 2 节改 README、电源设计审查：删除"VL 全程 ≥ 4.75V"的要求和"不可接屏"；"定版前仍须解决"表中 VL 保持、Dock 先掉电两项改为"由 PFAIL + NID100-5 下限更低 + 实测 T_VD_WAIT 解决，待实测确认"。
2. 连接器表更新：P2-10 = VD_HI_N，P3-5 = VL_FLT_N_3V3。
3. BOM 增加：Q_VH、U_INV、Q_DIS、R_DIS、两颗 TVS、两颗肖特基、两颗电解，以及新增电阻和测试点；可选器件标注 DNP。
4. 注明 U_VL/U_VD（2×2 mm、0.45 mm 间距 QFN）由嘉立创 SMT 贴片，不手焊。
5. 删除 DF11 "直插/弯插矛盾"的说法（见第 1 节）。

---

## 5. FPGA 侧需要配合的时序（写进交付说明，供写 RTL 的人使用）

**上电：**
1. 等 VL_OK_3V3 为高。
2. 输出全部置低，OE_N 置 0。
3. 开始扫描。
4. 稳定 ≥ 1 帧后，VD_ON_N 置 0。

**正常关机：**
1. VD_ON_N 置 1。
2. 等 VD_HI_N 变高，再等 T_VD_WAIT。
3. 停止扫描，输出置低。
4. OE_N 置 1。

**异常处理：**
- PFAIL_N_3V3 变低，或 VL_OK_3V3 变低：立即 VD_ON_N 置 1（硬件已同时关断）。只要 VL_OK 仍为高，就继续扫描。
- VD_FLT_N_3V3 或 VL_FLT_N_3V3 变低：VD_ON_N 置 1 并上报。不自动重试。复位由用户手动触发，置 VD_ON_N=1 ≥ 10 ms 后再重新上电。

---

## 6. 不在 D1 范围，但要记录

- **[核实] 开发板改用 5V 供电（可选，默认不改）**：如果开发板改由 NID100-5 供电，它会和 VL 同时掉电，时序更自然。但 Dock 3713 的 USB-C 5V 入口路径上有 1N5819 二极管（D24、D10），J1 一侧可能还有 F1 6V/300mA 自恢复保险。开发板总电流是否超过它，未核实。维持默认方案：开发板从 12V DC 插座供电。
- **PCB-3**（含 PFAIL 21 V/22 V 回差）和 **PCB-2**（假负载）仍待画。PFAIL 是第 2 节第 3 条的必要条件，PCB-3 优先。
- **HDMI2EL 的经验**（详见设计笔记 §14 S4）：
  - VD/VL 串联元件按满屏电流选型，不用自恢复保险；
  - 电平转换芯片曾单路失效，所以每路输出都要能测到。

## 7. 画板方不得自行决定的事项

- 不改变第 1 节已核对通过的连接和数值。
- 不删除 Q_VL，不改动 U_VL 的 EN 接法。
- 不把开发板改为 5V 供电。
- 串联电阻终值、R_DIS 是否焊接及阻值、T_VD_WAIT：都要等实测数据，不得凭仿真定版。
- 新增器件的型号、封装、引脚定义，必须查原厂数据手册后填写；查不到的列为问题交给用户。
