huatanshaonian/EL-center/el_driver/D1_设计改版与审查闭环.md

# D1 设计改版与审查闭环

日期：2026-10-18。依据用户审查文件与Sharp原厂资料实施；用户“直插优先、必要贴片交嘉立创”的要求优先。原审查文件保留不改。

## 交付范围和实证

已建立嘉立创EDA原生工程 MIS-01-EL-Driver-D1-TH，并导出根目录D1.epro2。EL-IF为12页151器件，PFAIL子电路为3页21器件，总172器件（含8件DNP、40个测试焊盘）。两套原生ERC均0错误/0警告。网表保留旧298个已连接脚，检查122个新增/替换预期连接；13个应保持NC脚仍未接，U_VL-4是明确授权从NC改为FLT的例外。证据位于D1/ERC_*.json和D1/netlist_check_D1.json。

两份PDF共15页来自原生工程导出并逐页渲染检查。PCB仍是80×60mm机械框架，未放置/布线；完整电源分配/NID/保险丝板和独立假负载板尚未完成。没有生产Gerber、下单或实物实验。PFAIL的页名虽带PWR-DIST，实际完成范围仅为检测子电路。

## 审查项处理

|审查条目|D1实施/保留|状态与依据|
|---|---|---|
|§1 既有正确连接|P1/P2/P3、J_EL、DIR/OE、未用脚、电源芯片针序保持；仅两处备用脚按§3新增用途|298旧连接核对；13 NC实查|
|§2 下电解释|删除“VD下降全过程VL必须≥4.75V”的推导；采用VD→信号→VL顺序|Sharp p16没有该全过程电压要求；正常工作范围仍须满足|
|§3.1 VL故障|U_VL-4→VL_FLT_N_3V3；RVLFP10k→Dock3V3；P3-5、TP_VLFLT|已画；上拉改为直插以符合用户偏好|
|§3.2 VD检测|RVHU100k、RVHD33k、Q_VH AOS AO3400A、RVHP10k；P2-10、TP_VDH|已画；33k替代22k，原因见下|
|§3.3 可选主动放电|SN74HCT04N DIP14、100Ω栅阻、100k下拉、AOS AO3400A、100Ω3W PR03、100n旁路；全6件DNP|已画预留，是否装/阻值/等待时间必须实测|
|§3.4 输入TVS|12V用ST P6KE15A，5V用Littelfuse P6KE6.8A，均直插单向|已画；阴极接输入，阳极GND；不以TVS直接保护屏正常电压|
|§3.4 输出负尖峰|两路用onsemi 1N5822RLG直插，阴极输出/阳极GND|已画；布局必须贴近OUT/GND、缩小环路|
|§3.4 电解|12V候选47µF/25V，5V候选68µF/16V；均DNP|不照抄两路100µF，先做NID总电容预算|
|§3.5 测试点|EL-IF共35处（含4处GND），PFAIL5处；2.4mm焊盘/1.0mm镀孔|已建真实通孔封装；布局位置待PCB实施|
|§3.6 串阻|CP2/CP1/S暂47Ω；8路数据暂33Ω；全为轴向直插|试值而非定版；保留33/47/68/82/100Ω实测选择|
|§3.7 监控阈值|RVS2保持1.2k0.1%，标称4.5036V|4.6V属可选建议，本版不提高；这是欠压/存在指示，不证明正常VL合规|
|§3.8 既有保护|保留Q_VL，U_VL EN仍输入分压；Dock默认仍12V供电|未更改为5V|
|§4 BOM|全172位号、55行零售合单、19类库存、9类21件基础SMT独立列出|并非只有5条物料；DNP和实验备件分别写清|
|§5 FPGA时序|上电、正常关机、PFAIL/VL_OK/FLT、手动复位规则写入实验单|RTL未编写、未实测，不称硬件时序已验证|
|§6 PCB-3优先|先补了PFAIL原生图与仿真|完整电源分配与假负载板在实验后继续|
|§7 待实测决策|串阻终值、R_DIS选装/阻值、T_VD_WAIT均未冻结|没有凭仿真定版|

## 对审查建议的必要修正

### VD检测与厂家限定

审查100k/22k在12V时栅压2.16V，AOS数据表没有在此电压给出导通电阻保证。D1改100k/33k，12V时约2.98V；11.4V及两电阻±1%相反偏差时仍高于2.5V。检测MOS漏极只有3.3V侧10k上拉，没有12V直入FPGA。

D0的C700953实际上是HUASHUO，不能继续套AOS的阈值/导通数据。D1的Q_VL/Q_VH及可选Q_DIS统一为AOS AO3400A C20917，项目内保留G1/S2/D3兼容脚序。替料必须重新核对厂家资料。Vgs(th)不等于特定上拉负载下的保证释放阈值，VD_HI_N只能粗判；实测释放后仍需T_VD_WAIT。[AOS原厂表](https://www.aosmd.com/res/data_sheets/AO3400A.pdf)。

### 电容预算与意外断电

NID100-5输入10.5–53V，NID100-12为20–53V；这是工作范围，不保证模块恰在10.5V/20V截止，也不保证硬断电后的两路保持时间。它提示可能有利的掉电先后，仍须对负载、线缆、慢降、硬拔和快速重启实测。不能把“输入下限不同”写成意外断电已解决。

原厂列出的最大外接负载电容：5V为100µF/16V，12V为68µF/25V。审查建议12V再并100µF已单独超过68µF。预算须合计NID模块外围、EL-IF输入和导通后输出、缓冲C3、屏、Dock/其它支路及电容正偏差。D1 CBULK5/12保持DNP，连库存电容也不能未经预算随手追加。现有必需下游负载是否已经超额仍待查明；必要时重新设计隔离/预充电/容量，不能靠把可选电容空着就宣称预算通过。[MEANWELL NID100](https://www.meanwell.com/Upload/PDF/NID100/NID100-spec.pdf)。

### 直插替换与瞬态保护的边界

SN74HCT04N具TTL输入门限，在5V供电时VIH=2V，匹配约3V EN_VD，故作为直插替代；不用5V供电的普通HC/LVC门。引脚14/7供电，1入2出；未用输入3/5/9/11/13接地，输出4/6/8/10/12NC。其供电来自+5V_EL，VL消失时无法保证继续主动放电，缓变输入与切换重叠需测。[TI HCT04](https://www.ti.com/lit/ds/symlink/sn74hct04.pdf)。

100Ω在12V下初始1.44W，选3W PR03并考虑温度降额、热间距和重复能量；仍为实验选装。[Vishay PR03](https://www.vishay.com/docs/28729/pr010203.pdf)。

ST P6KE15A在指定10/1000µs条件VC21.2V，在指定8/20µs条件VC27.2V；不能忽略浪涌电流、温度、引脚寄生或用P6KE18A规格混代。TVS、肖特基和OVLO共同构成待验证保护，OVLO典型响应时间不是保证任何输入阶跃下屏端都低于绝对额定。需在真实连接器端测峰值。[ST P6KE](https://www.st.com/resource/en/datasheet/p6ke.pdf)、[Littelfuse P6KE](https://www.littelfuse.com/~/media/electronics/datasheets/tvs_diodes/littelfuse_tvs_diode_p6ke_datasheet.pdf.pdf)、[onsemi 1N5822](https://www.onsemi.com/download/data-sheet/pdf/1n5820-d.pdf)、[TI TPS25947](https://www.ti.com/lit/ds/symlink/tps25947.pdf)。

### 信号模型与接屏条件

D0信号模型已经包括390Ω和10pF并1M，审查§3.6对此的描述不正确。D1保留原结果；内部滤波不会取消CN5插针处的过冲/负冲限制。串阻和建立/保持需实测，不能凭本次9组电源子模型认定信号已通过。

Sharp p16只规定上电VL→信号→VD、下电逆序，T1–T4≥0。4.75–5.25V是正常工作范围，不是整个下电过程强制门槛。按设计笔记§16.4可以用独立限流电源人工顺序点屏并记录VD衰减；PCB电源级定版前，不用未验证PCB-1给真屏供电。限流不会保证屏保险一定不熔断，电源输出储能也要考虑。1V为设计笔记中的实验判据，不伪称原厂阈值。

## 手焊与外包边界

SN74AHCT245N两片、普通/精密电阻、C1/C2/C3、PFAIL、TVS和功率肖特基均为通孔候选。C3只有一只库存10µF/50V，未再重复增加CBUF。库存直插件的脚距、外形、耐压、精度和2N3904厂家脚序在布板前测量；当前封装是候选尺寸。

基础SMT保留9类21件，含2颗TPS25947的2×2mm QFN、监控/逻辑/AOS MOS及必要旁路/定时电容和BAT54。全部交嘉立创配料焊接；可选Q_DIS另1颗DNP。不会让用户手焊QFN，也不会把裸QFN伪装成可插面包板的模块。没有核实完整适用的现成保护模块SKU，电源级实验载体仍须落实。

## 下一阶段

先做直插信号/PFAIL面包板及人工限流点屏；收集CN5波形、VD自然衰减、VD_HI_N释放尾段、PFAIL各掉电工况。电源级用适用已焊载体做假负载故障实验。之后冻结串阻、放电配置、等待时间和总电容预算，完善三块板并布局/布线、DRC、装配复核。当前仅为D1实验原理图交付。
