huatanshaonian/EL-center/el_driver/README_D0.md

> D1更新（2026-10-18）：本文件保留D0历史设计记录，当前改版、采购和实验请以[README_D1](README_D1.md)为准。原“VD下降全过程VL必须≥4.75V”的额外推导已撤销；人工限流点屏按设计笔记§16.4，未验证PCB电源级暂不给真屏供电。

# MIS-01 EL 驱动 D0 实验交付

日期：2026-10-18。

## 从哪里开始

1. 阅读[面包板实验接线与验收](面包板实验接线与验收_D0.md)，先搭假负载逻辑实验。
2. 按[购买清单与库存复用](购买清单与库存复用_D0.md)补齐首阶段缺件；已有LRS-200-24、NID100-5/12及直插电阻电容优先复用。
3. 阅读[仿真报告](simulation/仿真报告_D0.md)和[电源审查](电源设计审查_D0.md)。模型不能替代实测；人工限流点屏与未验证PCB电源供屏分开，见D1实验单。
4. 原理图审阅用 EL_IF_D0_原理图.pdf；编辑用 MIS-01-EL-Driver-D0.epro2，在嘉立创EDA专业版打开。

## 实际完成状态

|内容|状态|
|---|---|
|EL-IF原理图|Schematic2共8页、102个器件：Dock/CN5、AHCT缓冲、数据电阻、时钟/OE、电源芯片、电源电阻、电容/钳位、供电/PFAIL/UART/备用测试点|
|电气规则检查|0错误、0警告；只证明工具检查通过，不能替代器件和时序审核|
|网表比对|完整312个预期引脚连接通过；EL_IF_D0.net + netlist_check_D0.json|
|PCB起步|Board2关联Schematic2和PCB2；80×60mm外形，4个3.2mm NPTH孔，孔中心距各边5mm；仅机械草稿|
|PCB器件布局/布线/铜皮/DRC|未完成；层叠1.6mm双面1oz为目标，尚未配置/验证；安装与铜皮避让待后续|
|EL-DUMMY / PWR-DIST独立板|尚未完成EDA原理图和PCB；有假负载接法与PFAIL子电路候选仿真|
|仿真|官方仿真包内ngspice-42实际运算；4类子电路、6个串阻扫描，复跑共10次完成|
|面包板/实物波形|已提供接线方案；尚未实物搭建、测试|
|生产文件/下单|没有生成Gerber，没有打板或购买|

软件最初自动创建的Board1/Schematic1/PCB1是空白模板。本次实际设计是Board2下的Schematic2/PCB2。不要把默认空白模板误认为设计源文件。

## 仿真发现

- 假定200nH/50pF线缆和理想输出边沿时，33Ω串阻出现约−0.94至5.93V振铃；100Ω约0至4.99V，上升约12.6ns。这是模型示例，不是屏或AHCT实测。面包板对比68/82/100Ω，并检查建立/保持。
- PFAIL行为模型标称下降21.02V、恢复21.99V；比较器与参考误差尚未验证。
- VD使能行为模型正常约3.00V、故障约0.66V；真实器件温度和阈值误差仍需验证。
- 假设1000µF与2.2kΩ泄放，12V降至1V约5.47秒。真实面板电容未知，不能用“开关已断开”推断VD已经无电。

## D1已修正的接屏说明

约4.5V监控用于欠压/存在指示，不把4.75V正常工作下限要求强加整个下电过程。D1已加入PFAIL、VD检测与可选主动放电；PFAIL+NID不同输入范围提示有利顺序，仍须实测确认。按设计笔记§16.4可人工限流点屏，未验证PCB电源级暂不给真屏供电。先实验，再冻结参数并完成PCB。

## 工程与证据

- 原理图PDF由嘉立创EDA导出的2400像素图页合并，8页已渲染逐页检查；源epro2保留可编辑元件、网络和PCB框架。
- schematic_preview/：最新八页PNG；schematic_preview.zip：原始EDA导出包。
- schematic_components.json：102器件实际库型号与封装；购买清单含合并BOM。
- 连接器与缓冲引脚表_D0.md：Dock与CN5完整针序；原理图符号位置不等同于实体针序。
- PCB机械框架_D0.json / .svg：实际API回读坐标及几何复核示意，SVG不是软件截图，虚线6mm为审阅辅助圆，未应用实际铜皮禁布区。
- simulation/：.cir、采样JSON、日志、波形SVG/PNG及run_all.py。引擎来自官方安装包，保留在tools/lceda-sim/app/，没有系统安装。
- reference/：厂家资料与库存只读快照。新资料若与初始说明不一致，以审查记录说明为准。
- eda_execution_log.json：执行和检查记录，含诊断失败，不表示每次尝试都成功。

优先依据本README、最新网表、实际元件JSON和审查文件。signal_draft.netlist.json与EL_IF_SIGNAL.net是早期信号设计参考，不能代替完整EL_IF_D0.net；没有修改用户原始工程说明或库存表。
