huatanshaonian/EL-center/el_driver/README_D1.md

# MIS-01 EL 驱动 D1

2026-10-18，直插优先的实验原理图版。已在嘉立创EDA建立并打开MIS-01-EL-Driver-D1-TH，源工程为[MIS-01-EL-Driver-D1.epro2](MIS-01-EL-Driver-D1.epro2)。D0保留作历史比较，当前以本页列出的D1为准。

已完成：EL-IF 12页151器件、PFAIL子电路3页21器件，总172器件（含8件默认不装、40个PCB测试焊盘）。两套ERC均0错误/0警告；298旧连接、122个新增/替换预期连接、13个NC检查通过。新增9组NGspice运算完成，包含供电丢失边界，不代表整机实测通过。

主要改变：AHCT245改PDIP、电阻改轴向；C3复用单只库存10µF/50V；新增VL_FLT、VD_HI_N及大测试焊盘；增加直插TVS/肖特基；补全直插PFAIL；预留可选主动放电。Q_VL/Q_VH限定AOS AO3400A C20917，VD分压下臂改33k。必要基础贴片为9类21件，统一交嘉立创配料焊接。

## 文件

- [EL-IF原理图PDF](EL_IF_D1_原理图.pdf)与[PFAIL原理图PDF](PFAIL_D1_原理图.pdf)，共15页，已渲染检查。
- [改版与审查逐条处理](D1_设计改版与审查闭环.md)，含原厂依据、与审查建议的必要差异。
- [面包板接线与验收](面包板实验接线与验收_D1.md)及[完整引脚表](连接器与缓冲引脚表_D1.md)。
- [D1仿真报告](D1/simulation/仿真报告_D1.md)、[结果汇总](D1/simulation/summary_D1.json)。
- **当前采购只用：[单页商城采购BOM](MIS-01_D1_商城采购BOM.xlsx)**，55行，仅列直插元件、实验备料、线材和耗材；已排除库存复用项和交工厂处理的基础贴片料。在[商城配单](https://bom.szlcsc.com/)上传该文件，映射商品编号、型号、封装规格、数量；18行有C号，37行尚需按规格匹配或另配线询价，编号不保证现货。
- [嘉立创SMT标准BOM](MIS-01_D1_嘉立创SMT_BOM.csv)仅供后续PCB定版后随板配料/焊接，当前不用零售购买。依照[官方格式](https://www.jlc.com/portal/server_guide_48022.html)，包含Comment、Designator、Footprint、Quantity、嘉立创元件编号；9行21个基础贴片，DNP和直插件未作为SMT待贴件列入。当前未生成贴装坐标，不能据此直接开始生产。
- 原[综合总表](直插优先_合单采购总表_D1.xlsx)保留库存与172位号的审查记录；旧CSV同样保留，当前不再作为首选采购入口。没有向购物车导入、下单或支付。

## 实验与生产状态

先按实验单做直插信号/PFAIL。人工限流点屏按设计笔记§16.4，保持VL→扫描→VD及下电逆序；删除旧版“整个VD下降期VL必须≥4.75V”的额外推导。真实PCB电源级定版前不用其给屏供电。

NID100-5输入10.5–53V、NID100-12输入20–53V，是工作范围，不是精确UVLO或掉电顺序保证。总外接电容预算、硬拔插先后、串阻终值、主动放电选装、实测T_VD_WAIT仍待确认。8件DNP：U_INV、Q_DIS、RDISG、RDISPD、R_DIS、CINV、CBULK12、CBULK5；默认不装不等于无须备料，零售表已单列可选实验备料。

PCB目前仅机械框架，未放置/布线。完整NID电源分配/保险丝板和独立假负载板尚未绘完；PFAIL已经从待画项落实为原生子电路。先取得实物实验记录，再冻结参数并完成PCB/DRC。无Gerber、无订单、无付款。

核查证据在D1目录：ERC_EL_IF_D1.json、ERC_PFAIL_D1.json、netlist_check_D1.json和实际器件快照。交付文件哈希见delivery_manifest.json。

电阻采购数量已于2026-10-18按实际用量核减：原145只改为38只，其中390Ω假负载12只（11用1备）、精密/特殊阻值共23只（每种工作量加1只备用）、功率负载及可选放电3只。面包板与后续PCB复用同一批料；普通库存阻值不重复购买。销售起订倍数在实际匹配时核对，不能把统一10只误当成商城最低数量。
