huatanshaonian/EL-center/el_driver/电源设计审查_D0.md

> D1更新（2026-10-18）：本文件保留D0历史设计记录，当前改版、采购和实验请以[README_D1](README_D1.md)为准。原“VD下降全过程VL必须≥4.75V”的额外推导已撤销；人工限流点屏按设计笔记§16.4，未验证PCB电源级暂不给真屏供电。

# 电源设计审查 D0

日期：2026-10-18。用户已要求继续推进。当前状态是“电源保护实验草稿”，实物保护尚未验证；人工限流点屏按设计笔记§16.4，PCB电源级定版前不用其供真屏；这是尚有工程问题未闭环，并非等待重复授权。

## 当前已画入 EL-IF 的部分

- 两路 TPS259470LRPWR 锁存型 eFuse，分别控制 VL 5V、VD 12V；U_VL/U_VD 的 IN/OUT、OVLO、限流、DVDT、GND均已接线；AUXOFF和ITIMER按本候选方式不连接。
- VL UVLO上臂27.4k/下臂10k；VL OVLO35.7k/10k；VD OVLO100k/10k，均1%。这些为实验初值。OVLO是异常切断，不能保证输出始终位于正常工作范围。
- VL限流4.22k、VD限流1.33k，按3334/R近似分别0.79A、2.51A；必须加上器件误差及启动电流进行复核，不能仅据标称值认为内部保险丝受保护。
- VL DVDT用两个1nF并联；VD用2.7nF。输入输出各10µF及100nF，本地缓冲额外10µF；有效容量须核实直流偏压。
- U_SUP改为TPS3808G01DBVR，VDD=Dock3.3V，MR高、CT开路（标称20ms）；SENSE分压100k+1.2k/10k，三只0.1%。即使VL为0，只要Dock3.3V仍在，监控器仍有电。
- AO3400A感知VL存在，SN74LVC1G02形成正常条件与VD_ON_N低的使能逻辑；NOR输出经10k接EN_VD、100k下拉；VL_OK、PFAIL通过BAT54WS钳位EN。
- J_PF只接受外部PFAIL_N_3V3；外接开路默认无掉电互锁，不能在未安装PFAIL源时认为该功能存在。三个状态各10k上拉至Dock3.3V。

以上连接已通过电气规则检查，并纳入312个引脚的网表核对。ERC没有判断元件选值、阈值是否合理的能力。

## 定版前仍须解决

|问题|影响|下一步|
|---|---|---|
|VL监控下降约4.5V|欠压/存在指示，不保证正常VL合规|D1保留；撤销把4.75V工作下限强加整个下电过程的推导|
|VD开关断开后仍有储能|不能立即停扫描或关VL|测总电容/掉电负载，设计主动放电和受控关断；比较最坏能量|
|意外断电顺序|PFAIL及两NID不同输入范围有利，但不保证时序|D1已画PFAIL；实测两轨掉电、VD尾段并决定保持/隔离是否必要|
|Dock或3.3V先掉电|硬件关VD，可选放电由VL供电，FPGA不能继续扫描|D1预留放电；实测VD与VL先后、释放尾段和等待时间|
|肖特基低温压降与EN阈值配合|故障低电平可能不够低|验证实际BAT54WS及监控器灌电流，覆盖温度和阈值误差|
|输入长线瞬态、eFuse过压响应与寄生|峰值可能超过屏绝对额定|在eFuse输入侧设计抑制并测量真实输出峰值；不能用过高击穿TVS声称保护屏|
|保险丝与eFuse配合未闭环|大电容/限流响应可能熔断屏内保险丝|核对故障能量、I²t和真实启动/短路波形|
|NID100-5/12及PFAIL发生电路未画入独立板|整机电源链不完整|先核实模块针脚、封装和推荐外围，再完成PWR-DIST原理图|

## 已纠正的选型问题

原监控候选TPS3840DL46的回差及释放上限不合适；TPS3808G50同样不能直接满足最坏释放要求，未留在当前BOM。改用G01后，又把分压阻值从1M+12k/100k降低十倍，以降低SENSE漏电造成的误差。D1保留约4.50V作为欠压/存在信号；不能用于证明VL正常工作合规，也不再要求下电全过程保持4.75V。

普通SMBJ15V的钳位远高于屏VD14V绝对额定；SMBJ6V同样不能直接保证VL7V绝对额定。当前没有把这些TVS并在屏端冒充过压保护。

D1核实：DF11-20DP-2DS(24)为弯插通孔座，符合用户直插优先；没有“直插/弯插冲突”。布局前仍核Pin1、出线方向和插拔空间。

## 原始依据

- Sharp原始扫描件 LJ64K052.pdf：工作VL4.75–5.25V、VD11.4–12.6V，绝对VL7V/VD14V，开关电源顺序与扫描时序。
- [TI TPS25947](https://www.ti.com/lit/ds/symlink/tps25947.pdf)
- [TI TPS3808](https://www.ti.com/lit/ds/symlink/tps3808.pdf)
- [TI SN74LVC1G02](https://www.ti.com/lit/ds/symlink/sn74lvc1g02.pdf)
- [Diodes BAT54WS](https://www.diodes.com/assets/Datasheets/BAT54WS.pdf)：阴极色带；已另核对EDA符号1=K、2=A。
- [明纬 NID100](https://www.meanwell.com/Upload/PDF/NID100/NID100-SPEC.PDF)

仿真范围及结果见 simulation/仿真报告_D0.md，实测流程见 面包板实验接线与验收_D0.md。
