huatanshaonian/EL-center/el_driver/连接器与缓冲引脚表_D0.md

> D1更新（2026-10-18）：本文件保留D0历史设计记录，当前改版、采购和实验请以[README_D1](README_D1.md)为准。原“VD下降全过程VL必须≥4.75V”的额外推导已撤销；人工限流点屏按设计笔记§16.4，未验证PCB电源级暂不给真屏供电。

# 连接器与缓冲引脚表 D0

日期：2026-10-18。实际嘉立创EDA工程已通过ERC（0报错、0警告）；完整网表312个预期引脚连接核对通过。尚未实测，属于D0实验草稿。CN5 方向仍需实物核对。

|信号|Dock|板端|FPGA球位|A串阻|缓冲A脚|缓冲B脚|B串阻|CN5|
|---|---|---|---|---|---|---|---|---|
|UD0|J5-5|P1-5|L9|RA1 1k|U1.2|U1.18|RB1 33Ω|2|
|UD1|J5-6|P1-6|N8|RA2 1k|U1.3|U1.17|RB2 33Ω|1|
|UD2|J5-7|P1-7|N9|RA3 1k|U1.4|U1.16|RB3 33Ω|4|
|UD3|J5-8|P1-8|N7|RA4 1k|U1.5|U1.15|RB4 33Ω|3|
|LD0|J5-9|P1-9|N6|RA5 1k|U1.6|U1.14|RB5 33Ω|6|
|LD1|J5-10|P1-10|D11|RA6 1k|U1.7|U1.13|RB6 33Ω|5|
|LD2|J5-11|P1-11|A11|RA7 1k|U1.8|U1.12|RB7 33Ω|8|
|LD3|J5-12|P1-12|B11|RA8 1k|U1.9|U1.11|RB8 33Ω|7|
|CP2|J6-5|P2-5|B12|RA9 1k|U2.2|U2.18|RB9 33Ω|9|
|CP1|J6-6|P2-6|C12|RA10 1k|U2.3|U2.17|RB10 33Ω|11|
|S|J6-7|P2-7|B13|RA11 1k|U2.4|U2.16|RB11 33Ω|13|

每路 A 脚经 RPA1–RPA11（100kΩ）下拉；每路 CN5 信号经 RPB1–RPB11（100kΩ）下拉。

U1/U2：1 DIR、20 VCC → +5V_EL；10 GND → GND；19 /OE → OE_N；ROE 10kΩ → 3V3_FPGA。U2 的 5–9 脚（A4–A8）接地，11–15 脚（B8–B4）不连接。C1/C2 各 100nF 紧靠 20/10 脚，面包板C3用库存10µF/50V（C-02）；PCB草稿C3是10µF/25V 0805。

## P1 全针表

|针|网络|
|---|---|
|1|3V3_FPGA|
|2|3V3_FPGA|
|3|GND|
|4|GND|
|5|EL_UD0_3V3|
|6|EL_UD1_3V3|
|7|EL_UD2_3V3|
|8|EL_UD3_3V3|
|9|EL_LD0_3V3|
|10|EL_LD1_3V3|
|11|EL_LD2_3V3|
|12|EL_LD3_3V3|

## P2 全针表

|针|网络|
|---|---|
|1|3V3_FPGA|
|2|3V3_FPGA|
|3|GND|
|4|GND|
|5|EL_CP2_3V3|
|6|EL_CP1_3V3|
|7|EL_S_3V3|
|8|OE_N|
|9|VD_ON_N|
|10|SPARE_J6_10|
|11|NC|
|12|NC|

## P3 全针表

|针|网络|
|---|---|
|1|3V3_FPGA|
|2|3V3_FPGA|
|3|GND|
|4|GND|
|5|SPARE_J14_5|
|6|NC|
|7|PFAIL_N_3V3|
|8|VL_OK_3V3|
|9|VD_FLT_N_3V3|
|10|UART_TX|
|11|UART_RX|
|12|SPARE_J14_12|

## J_EL 全针表

|针|网络|
|---|---|
|1|EL_UD1_5V|
|2|EL_UD0_5V|
|3|EL_UD3_5V|
|4|EL_UD2_5V|
|5|EL_LD1_5V|
|6|EL_LD0_5V|
|7|EL_LD3_5V|
|8|EL_LD2_5V|
|9|EL_CP2_5V|
|10|GND|
|11|EL_CP1_5V|
|12|GND|
|13|EL_S_5V|
|14|GND|
|15|GND|
|16|GND|
|17|+5V_EL|
|18|+5V_EL|
|19|+12V_EL|
|20|+12V_EL|

P2-11/12、P3-6 必须保持 NC。P3的VL_OK、VD_FLT已接电源草稿；PFAIL来自外接J_PF，电源分配板的发生电路尚未画入。3V3_FPGA 仅从 Dock 引入，不能接 5V。

依据：工程设计说明 §4、§11.2.1、§15.3；TI SN74AHCT245 数据手册 SCLS233S p.3。
