huatanshaonian/EL-center/el_driver/面包板实验接线与验收_D0.md

> D1更新（2026-10-18）：本文件保留D0历史设计记录，当前改版、采购和实验请以[README_D1](README_D1.md)为准。原“VD下降全过程VL必须≥4.75V”的额外推导已撤销；人工限流点屏按设计笔记§16.4，未验证PCB电源级暂不给真屏供电。

# EL 信号面包板实验 D0

此版用于先验证3.3V→5V逻辑、假负载与信号质量。实物尚未搭建，实验数据尚未取得。当前电源保护草稿未放行，首轮不接Sharp屏，CN5的19/20脚12V不接入信号面包板。

## 1. 实验电路

两片 SN74AHCT245N（PDIP-20）跨面包板中沟，缺口朝上；左侧从上到下1–10脚，右侧从上到下20–11脚。不要按原理图符号两侧的位置猜实物针脚；以缺口/圆点和TI顶视图识别。SOIC-20 DW 是PCB用料，首轮用N直插。

若使用标准a–e/f–j分组的830孔面包板，可将U1两列脚插在e/f列第10–19行，U2插第30–39行；此行号仅是摆放建议，先用万用表确认同排五孔连通、中沟隔离及电源轨是否中断。每片IC的20脚接局部+5V、10脚接GND，100nF直接跨接20/10脚，连线尽量短；两芯片共用10µF/50V电解（正极5V、负极GND）。共地线应先接。

|项目|接法|
|---|---|
|U1、U2 pin1 DIR|固定接局部5V，A→B|
|U1、U2 pin20 VCC|台式限流电源5.0V；实测4.75–5.25V|
|U1、U2 pin10 GND|电源GND、Dock GND、假负载GND共地|
|两片pin19 /OE|并联OE_N，10k上拉到Dock3.3V；来自Dock J6-8|
|U2 pin5、6、7、8、9|接地，未用A输入不悬空|
|U2 pin11、12、13、14、15|悬空，不接其它电压|
|每路A输入|Dock信号→1k→A脚；A脚100k→GND|
|每路B输出|B脚→待选串阻→假负载连接端；该端100k→GND|
|每路假负载|连接端→390Ω→节点X；X→10pF→GND，X→1M→GND|

下表列出的B串阻33Ω是原理图候选初值。首轮动态实验从100Ω开始，与82Ω、68Ω对比；确认波形后再评估33Ω。保持CP2和数据路径长度相近。

|信号|Dock|板端|FPGA球位|A串阻|缓冲A脚|缓冲B脚|B串阻|CN5|
|---|---|---|---|---|---|---|---|---|
|UD0|J5-5|P1-5|L9|RA1 1k|U1.2|U1.18|RB1 33Ω|2|
|UD1|J5-6|P1-6|N8|RA2 1k|U1.3|U1.17|RB2 33Ω|1|
|UD2|J5-7|P1-7|N9|RA3 1k|U1.4|U1.16|RB3 33Ω|4|
|UD3|J5-8|P1-8|N7|RA4 1k|U1.5|U1.15|RB4 33Ω|3|
|LD0|J5-9|P1-9|N6|RA5 1k|U1.6|U1.14|RB5 33Ω|6|
|LD1|J5-10|P1-10|D11|RA6 1k|U1.7|U1.13|RB6 33Ω|5|
|LD2|J5-11|P1-11|A11|RA7 1k|U1.8|U1.12|RB7 33Ω|8|
|LD3|J5-12|P1-12|B11|RA8 1k|U1.9|U1.11|RB8 33Ω|7|
|CP2|J6-5|P2-5|B12|RA9 1k|U2.2|U2.18|RB9 33Ω|9|
|CP1|J6-6|P2-6|C12|RA10 1k|U2.3|U2.17|RB10 33Ω|11|
|S|J6-7|P2-7|B13|RA11 1k|U2.4|U2.16|RB11 33Ω|13|

所有EL端接线按表中的CN5针号；DF11为2.00mm，不能直接插进2.54mm面包板。采用转接板/预压线，先脱离屏幕测通断、编号和短路。详细56针连接器表见[连接器与缓冲引脚表](连接器与缓冲引脚表_D0.md)。

## 2. 先做静态实验

1. 断电布线，检查5V与GND无短路、IC无反插、5V未接任何Dock IO/3.3V。3.3V从Dock引入，仅作信号和OE上拉。P2的11/12、P3的6保持不连接。
2. 先不接Dock数据，断开OE控制线；在OE_N加临时10k到局部5V，使输出禁用。只用限流5V给两片芯片供电，空载可先把限流设50mA用于排查短路；异常发热或限流即断电检查。
3. 切断5V，移除临时5V上拉，再接Dock与正常3.3V上拉。先使Dock J6-8为高、J6-9 VD_ON_N为高，并让全部数据/时钟输出为低；测到状态正确后恢复局部5V。避免芯片无5V时持续向A端送高电平；1k不等于断电隔离。
4. OE高时，输出靠100k下拉应接近0V。OE低后，逐路用3.3V高/0V低验证表中对应B脚，检查没有串线、UD位序颠倒及短路。FPGA引脚只接3.3V逻辑。此时没有屏，也没有12V。

## 3. 再做动态假负载实验

先100kHz/1MHz单通道，再升到目标约5.4MHz CP2；同时输出已知数据交替码，最后采用完整扫描。面包板上长电源轨和杜邦线的寄生很大，若5.4MHz波形不合格，改短线焊接小转接板/洞洞板验证，不能只降低示波器带宽把振铃隐藏。

探头在假负载连接端（对应CN5）相对当地GND测量，用短接地弹簧，记录探头带宽和电容；不要把长鳄鱼地线产生的振铃当成真实信号。实测必须包含CP2与数据双通道相对时序。

|验收项|目标|数据|
|---|---|---|
|5V VL|4.75–5.25V，记录纹波/瞬态|待测|
|CN5逻辑高/低|高≥3.5V，低≤1.5V|待测|
|绝对峰值|−0.3V至VL+0.3V内，含过冲负冲|待测|
|10–90%上升/下降沿|≤30ns|待测|
|CP2周期|≥154ns|待测|
|CP2高、低宽度|各≥60ns|待测|
|数据对CP2下降沿建立/保持|≥50ns / ≥40ns|待测|
|禁用/复位|OE高输出低，无异常时钟|待测|
|扫描|每行对160组、240行对；帧率60–120Hz|待测|

串阻值、线长、假负载、频率、探头设置均写入实验记录。仿真中100Ω边沿约12.6ns，只对该假定模型成立，不能代替这一表的实测。

## 4. 电源保护单独实验

TPS25947是小封装功率器件，不能用杜邦线跨面包板承载屏的12V/1.8A；采用评估板或焊好并检查过的转接板，以粗线端子接电子负载。该部分元件、阈值和放电/保持仍需设计闭环，不按当前D0直接给屏供电。

先以16Ω≥5W假负载验证VL；VD用电子负载逐级增加，记录启动斜率、压降、最大浪涌和短路/过压动作。分别注入VD_ON_N高、PFAIL低、VL跌落、Dock复位/断电，四通道同时观察VL、VD、CP2、OE/EN。关断必须以VD实际衰减波形作为依据：VD尚未安全降下时仍要维持VL和有效扫描。

默认锁存故障只能在原因查明后按数据手册操作复位。台式电源限流并不能保证屏内保险丝不熔断，需考虑输出电容和故障能量。现阶段不开展真屏短路/故障实验。

## 5. 下一次继续PCB所需记录

请保留：面包板正反面清晰照片、DF11针1及线束通断表、库存实际芯片型号、示波器型号与探头参数、串阻对比波形、完整扫描波形、双电源启动/关断/故障波形。先把假负载信号验证结果和使用的仪器提供回来，再推进保护电源定版及PCB。

当前没有完成实物实验、没有生成生产Gerber，也没有下单。Board2已建立与Schematic2关联的PCB2：仅80×60mm外形及四个3.2mm非金属化安装孔，未导入器件、未布局布线。Board1是软件自动生成的空白模板。
