huatanshaonian/EL-center/el_driver/面包板图_D1.1/交付说明.txt

MIS-01 面包板实验文档 D1.1 交付说明
日期：2026-10-19

一、交付范围
1. ../面包板实验接线与验收_D1.1.md：PDF读法、两份PDF逐页导航、实验0–4、逐脚表、期望值与空白实测记录。
2. 本目录8张PNG（图2分为U1、U2两张）；全部宽度不小于2000像素，中文使用微软雅黑字体。
3. src/generate_diagrams.py、src/build_document.py：可复现生成；输入与校验资料也集中在src。
4. src/面包板D1.1_Claude交审包.zip：文档、8张图、本说明、校验结果、原始两份D1.1网表与两份PDF，保持相对路径。
5. 没有进行实物通电或整屏仿真，没有编写RTL，没有改原理图、网表、BOM或旧D1文档。

二、每张图的网表核对范围
图1_掉电检测PFAIL.png
- 以PFAIL_D1.1.net为准，独立端点清单核对13个网络全部46个连接端点。
- PF_REF：U_PF-2/6、U_REF-1/3、RREF-2；U_REF-2接GND。
- PF_SENSE：U_PF-3、RPFT-2、RPFB1-1、RPFH-2。
- PF_COMP：U_PF-1、RPFPU-2、RPFH-1、RPFIB-1。
- PF_DIV：RPFB1-2、RPFB2-1；PF_INV_B：RPFIB-2、Q_PFI-2。
- PF_INV：Q_PFI-3、RPFIP-2、RPFD_B-1、RPFO_B-1。
- PF_D_B、PF_O_B分别到两只输出管2脚；输出从各自3脚引出，不并接。
- 全部器件供电/地脚、CPF两端、5个测试点网络核对；U_PF-7无网络悬空。
- 图中测试点不画成PCB焊盘，直接用同网络测量位置代替。
- RREF1k、RPFT100k、RPFB113k、RPFB2150Ω、RPFH510k、RPFPU2.2k、RPFIB68k、RPFIP/RPFD_B/RPFO_B各10k均核对。
- 两只R_TEST_D/O=10k上拉是外接实验夹具，原生网表没有。只在不接任何处理器IO时上拉至USB5V。

图2A_U1_245顶视引脚.png / 图2B_U2_245顶视引脚.png
- 按EL_IF_D1.1.net逐脚标注两片全部40个位置。
- 两片1/20为+5V_EL，10为GND，19为OE_N。
- 11路A/B脚由独立信号表核对；U2的5–9脚接GND，11–15脚在网表中无连接，标为NC。
- 顶视脚号递增方向与DIP缺口一致。

图3_单路信号链与11路对照.png
- 独立核对11路，每路12个端点：P1/P2、RA1/2端、RPA1/2端、245 A/B、RB1/2端、RPB1/2端、J_EL。
- RA全部1k；RPA/RPB全部100k；RB1–8为33Ω，RB9–11为47Ω（器件值与网表一致）。
- 两片DIR/VCC/GND/OE、ROE两端、C1/C2/C3两端核对。图只展开U1的去耦，U2在图注和逐脚表中明确另装C2。
- C3=10µF，正端接5V。图形符号不是TO-92/DIP实际摆放照片。

图4_静态测试接线.png
- 保留图3固定连接；唯一变化是把RA输入源换成临时3.3V/GND跳线，把OE控制源换成跳线。
- ROE保留10k上拉3V3_FPGA，使能跳线只把OE_N接地，不硬短路3.3V。
- Dock仅提供3.3V/GND，不接其IO；这属于明确列出的实验夹具接法。
- 其余10路按同一结构与图3表重复。

图5_真屏供电端子接线.png
- J_EL/CN5 17/18=+5V_EL，19/20=+12V_EL；10/12/14/15/16=GND，全部核对。
- USB独立提供VL与缓冲VCC，单路电源只提供VD，全部共地。
- 本图是任务书要求的框图，电源保护级旁路只用于人工顺序控制的本轮实验，不表示最终PCB保护级已验证。

图6_DF11针号与待确认视向.png
- 所有20针功能逐针来自EL_IF_D1.1.net的J_EL。
- Hirose官方《DF11 Series Catalog》2026-08-01版印刷第5页/PDF第5页可核对2mm双排、DF11-20DS-2C、No.1/No.2与极性标记；第9页对应弯针插座系列。
- DF11-20DS-2C官方2D文档0000995267，第1页，共1页，链接在正文。
- 重要限制：官网文字可读取，但机械图栅格未能取得可目视核验的版本；也没有实际线束/屏插座视向证据。
- 因此图6仅为把1脚移至左上的编号归一化示意，不冒充已核实的屏插座正视图/线尾图。没有完成最终物理视向确认。这是待确认版，不能照图的左右位置直接接屏。
- 正式接屏前必须用官方原图、壳体标记/腔号和逐线通断确认实物；未完成前不进入实验3、4。

图7_面包板摆放分区.png
- 只指导两板分区、IC跨中央沟、独立5V/3.3V/GND轨，电气连接仍由图1/3/4与表决定。
- 没有把示意孔位当成已验证的真实逐孔布线；两片245旁的去耦需实物短线安装。
- PFAIL板3.3V轨预留空置；TO-92每条腿独占独立孔排。

三、与任务书的差异/补充及原因
1. 三极管：二极管档只能可靠找B/判断NPN，不能独立可靠分辨E/C。补充厂商封装资料或测试仪确认，不按“二极管档已证明EBC”交付。
2. 屏针号：蜂鸣核对三组电源针只作辅助；内部电容/半导体可能影响读数，不能靠一次蜂鸣认定1脚朝向。图6保留明确待确认条件。
3. 13k替代：12k+1.2k替换13k+150Ω整个下臂，而非替换13k后再叠加150Ω；网表本身的Remarks也给出上下分段备选。未改网表。
4. 第二替代（第1轮已改）：10k+1k+1k+1k串联只代替RPFB1=13k，RPFB2=150Ω照常，下臂仍为13.15k，门限同标称约21.0/21.9V。
5. 电阻来源（第1轮已改）：库存（1k/10k/100k各30，33k/68k/33/47/68/82Ω各20，100Ω 25）加商城补购件，用前逐只实测。
6. 测试探测次序：OE_N=1时输出禁用，CN5端无扫描；因此先在FPGA/A端确认，再OE_N=0，再确认CN5，最后开VD。
7. USB充电头无可设限流，没有照搬双路电源给VL限流的步骤，也不声称VD电源限流保证模组内部保险丝动作顺序。
8. 本次VD限流流程上限设2.0A；“不超过3A”仍为不可越过的边界，不作为鼓励增加电流的档位。
9. PF_INV在低压报警时受到两个10k基极支路加载，约2V可能正常，未把它写成必到5V。
10. 图形用带脚号方框作器件电气符号，各脚都画真实导线；顶视针脚图/供电框图/布局图按其各自用途绘制。
11. 任务要求交Claude审核：目前没有可调用的Claude审阅通道，已备交审包和审核任务文本；尚未送达Claude，也未获得Claude审核结论。

四、仍需实物或后续阶段确认
- DF11屏插座与所购线束的观察方向、1脚标记、逐针直通（实验3前置）。
- Dock实物J5/J6的1脚位置、对应3.3V/GND点及FPGA约束，不能只凭本文表格猜板上方位。
- 2N3904实际厂商脚序；TL431确为TI TL431AILP且中间2脚为ANODE。
- 元件到货数量、逐只实测值、面包板轨分段、USB满负载CN5端电压。
- 示波器/探头可用，CN5动态波形通过；面包板寄生可能使指标不合格。
- FPGA测试程序仍未完成。实验3/4尚不能执行，也没有点屏成功记录。
- 最终RB阻值由实验3决定；保护、电源和放电留PCB阶段验证。

五、校验与复现
运行src/generate_diagrams.py：网表端点断言通过后重生成8张PNG；使用Windows微软雅黑字体，需Python与Pillow。
运行src/build_document.py：读取同目录netlists.json/11路接线映射.json，重生成新D1.1文档。
src/接线校验结果.json：电气端点与参数核对结果；不等同于自动提取PNG的几何连通性。
src/交付自检结果.json：尺寸、图片引用、禁用旧参数词、输入哈希与实验结构核查。
已目视检查8张图，修正了文字压线、交点遗漏和电阻引线位置；后续Claude仍需独立复核。
原图1备份在src/图1_原稿_保留.png，供追溯，不用于新实验接线。

六、第1轮修改记录（2026-10-19，Claude 审核后直接修改；原文件备份为 *.bak_r0）
1. 电阻来源说法：正文第5行、实验1/3所需设备、本说明 三.5 改为“库存+采购件，用前逐只实测”。
2. 13k第二替代方案：改为 10k+1k+1k+1k 只代替 RPFB1，150Ω 保留，门限与标称相同；正文替代表、图1底注、本说明 三.4 同步。
3. 实验3记录表 CP1/S 时序依据页码 p.17 → p.8（PDF第12页）；p.17 是5V上升/下降过程。
4. 示波器：注明现有 ≥50MHz 可用于时序与电平，30ns 级边沿以 ≥100MHz 复测为准。
5. 图3/图4/图5 重画走线：不相连的线不再横穿信号线或电源线。
   - 图3/图4：OE_N 与 ROE 移到芯片上方，从芯片顶边进 19 脚；去耦电容改用就近接地符号。
   - 图5：VD 线单独走最上层；三路电源地经左侧地线汇到公共地点。
   电气连接未改变；generate_diagrams.py 的网表端点断言与 verify_delivery.py 自检均通过。
