huatanshaonian/EL-center/el_driver/商城配单使用与采购核查.md

> 当前采购入口：只用[MIS-01 D1单页商城采购BOM](MIS-01_D1_商城采购BOM.xlsx)。共55行，字段为商品编号、型号、封装规格、品牌、数量、单位、备注。18行有C号，37行需按规格匹配/询价。贴片件不在此采购表中，后续随PCB交嘉立创配料焊接。

# 商城配单使用与采购核查（D1）

更新：2026-10-18。当前以[README_D1](README_D1.md)和[直插优先合单总表](直插优先_合单采购总表_D1.xlsx)为准，旧“首轮实验_商城BOM配单.xlsx”的5行仅为历史首轮缺件，已由55行合单采购覆盖。

## 怎么买

1. 打开[立创商城BOM配单](https://bom.szlcsc.com/)，上传[当前单页采购BOM](MIS-01_D1_商城采购BOM.xlsx)。该CSV是55行零售备料，包含可选实验备料；库存复用和工厂SMT没有重复混入。
2. 按页面提示映射商品编号、型号/规格、数量。带C号仍核对厂家、型号、封装、发货与起订倍数；空C号按完整规格人工匹配，不能只让系统按阻值随意选贴片。
3. DF11成品线束、散热器和通用耗材可能需要另找配线商/商城类目，BOM配单不能保证每行自动成功。不要自动把DF11当普通2mm杜邦，也不要把XH2.5mm当2.54mm。
4. 可选主动放电和补充电容可作为同单实验备料；DNP表示默认不焊，尤其CBULK5/12必须通过NID总电容预算才允许装。已有47µF/25V先测，新增FR候选是有明确资料的对照备料。
5. 嘉立创SMT页为每块基础用量（9类21件，另Q_DIS可选1件DNP）；工厂配料/贴装时再匹配SMT库，不重复买一包裸QFN让用户焊。商城库存与SMT库存独立。

[商城官方说明](https://bom.szlcsc.com/bom.html)支持xls/xlsx/csv，文件≤10MB，表头可识别映射。本次提供UTF-8带BOM的CSV；尚未在用户账号实际上传验收、加购物车或支付。多页总表用于查阅与筛选，不把全172位号直接作为172个采购SKU上传。

## 55行、172件分别是什么意思

55行是零售合单：工作料、备件、实验假负载、线束、焊接/安装耗材；数量可能大于单块板需求。172行是原理图逐件BOM：每个位号1行，含8个DNP以及40个PCB测试焊盘，分别标库存/零售/工厂配料。测试焊盘由PCB制造，排针或铜线作探测柱，不再购买40个“同名测试点”。库存物料按表复用，不把库存数量当零再采购。

## 有没有买不到的

当前没有商城登录后的实时库存，因此不能承诺一站全现货或给出准确合单总价。C号主要是已核库型号的匹配线索，不是“保证有货”标记。

|项目|当前证据/风险|处理|
|---|---|---|
|SN74AHCT245N C1548096|TI公开页此前显示缺货，立创实时库存未确认|先匹配此DIP型号；缺货再找授权渠道/合适已焊转接，不能直接换74HC245|
|DF11成品线束|无已核实标准成品SKU|按表向配线商询价；成品含壳/端子，不重复买散件|
|精密直插电阻|已明确0.1%和≤25ppm/℃，未锁定统一商城SKU|逐项匹配精度/温漂；库存五色环不等于已确认0.1%|
|保护级完整焊好模块|未核实适用成品SKU|直插信号/PFAIL先做；电源级载体另落实，当前不假称已经可以买到|
|通用2×6P排针|旧EDA C9900165112未核实商品|CSV留空编号，按机械尺寸选料|
|AOS AO3400A|D1限定C20917；原C700953厂家不同|交工厂核SMT库，替料重新核原厂数据|
|其余C号项|库型号/封装已核或有商品页，未核实际现货|配单时查看库存、交期与销售倍数，自动替代须审查|

型号线索：[TI DIP AHCT245](https://www.ti.com/product/SN74AHCT245/part-details/SN74AHCT245N)、[10pF直插C0G](https://item.szlcsc.com/4265463.html)、[TPS25947](https://item.szlcsc.com/4230592.html)。SMT核料入口：[嘉立创SMT器件库](https://www.jlc-smt.com/lcsc/index)。

本轮只包括元器件、线材和耗材，不采购电子负载、示波器、台式电源等仪器。稳态功率测试用16Ω/7W及6.8Ω/50W配散热器；不能因此称动态、短路等测试已完成。

电阻采购数量已于2026-10-18按实际用量核减：原145只改为38只，其中390Ω假负载12只（11用1备）、精密/特殊阻值共23只（每种工作量加1只备用）、功率负载及可选放电3只。面包板与后续PCB复用同一批料；普通库存阻值不重复购买。销售起订倍数在实际匹配时核对，不能把统一10只误当成商城最低数量。
