huatanshaonian/EL-center/png/20_front_panel.png

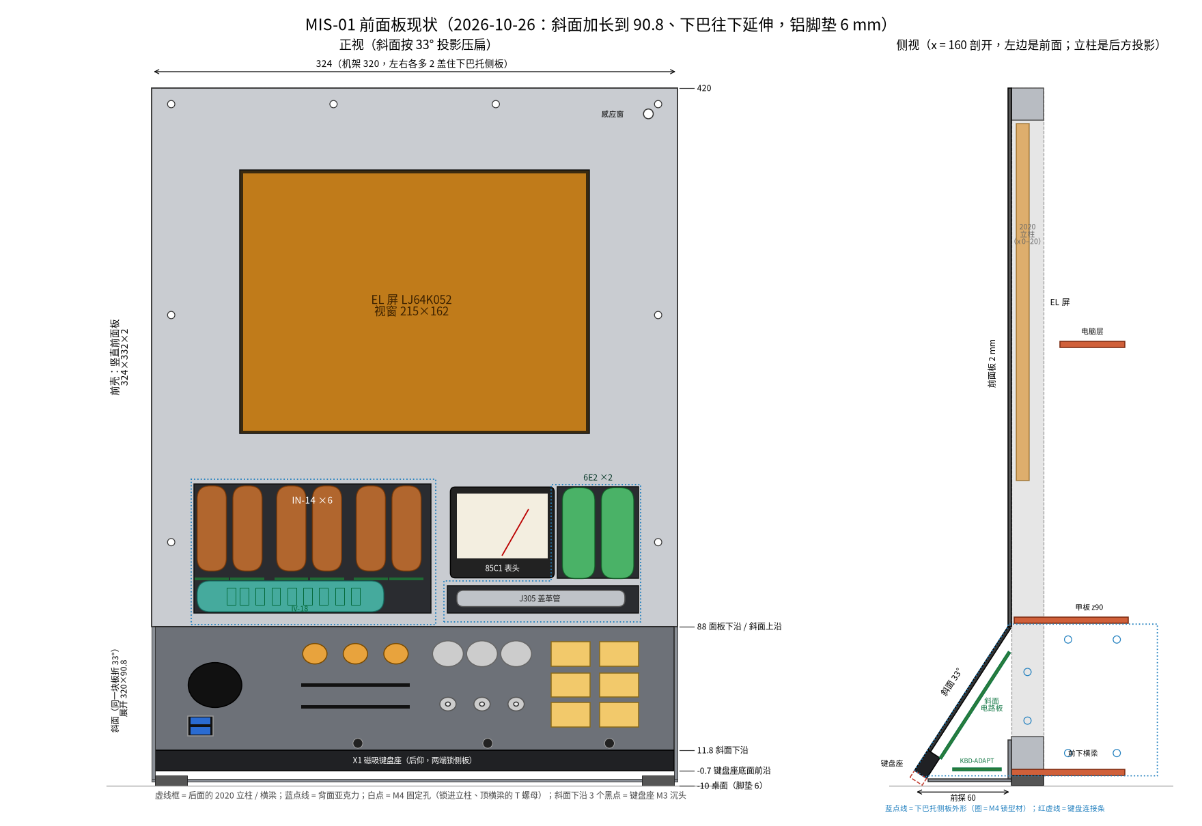
png/20_front_panel.png
