huatanshaonian/EL-center/png/22_exploded_front.png

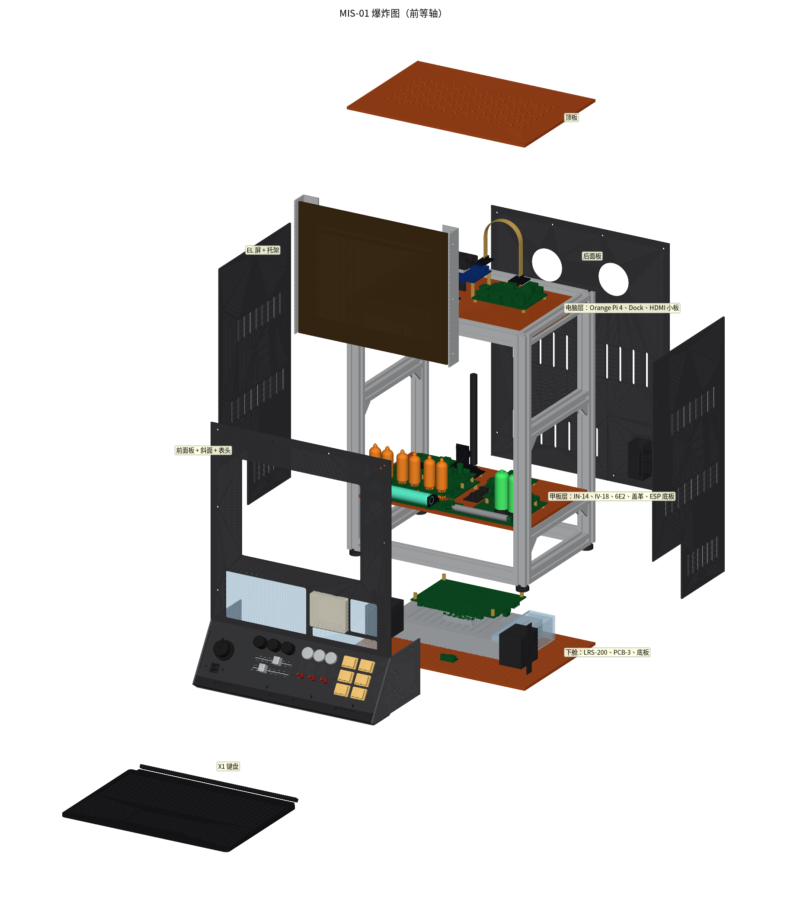
png/22_exploded_front.png
