huatanshaonian/EL-center/png/22_exploded_rear.png

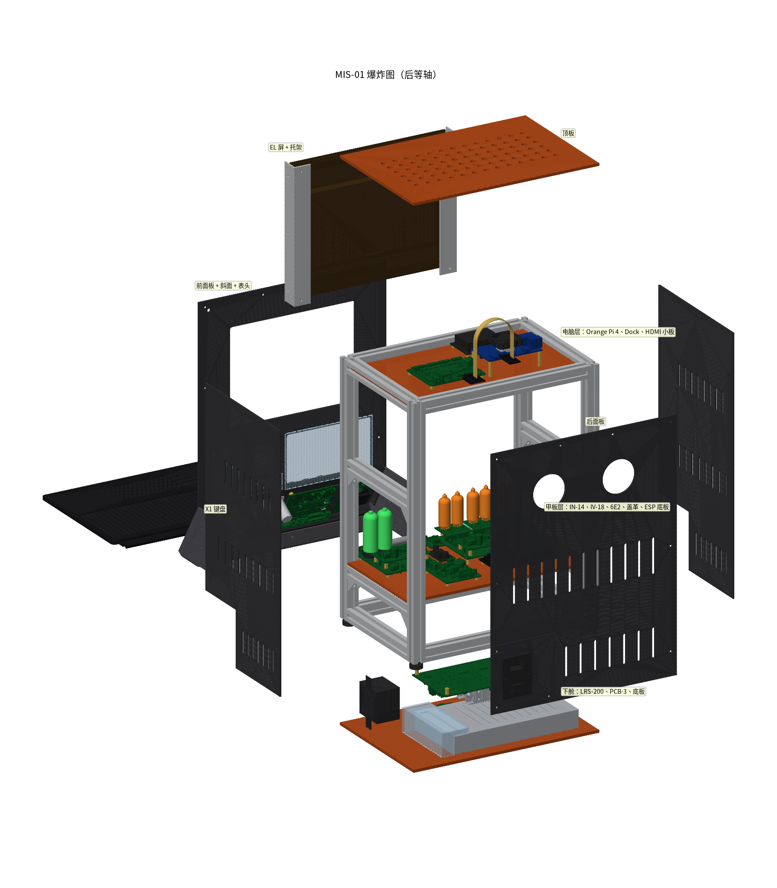
png/22_exploded_rear.png
