huatanshaonian/EL-center/png/26_chin_exploded.png

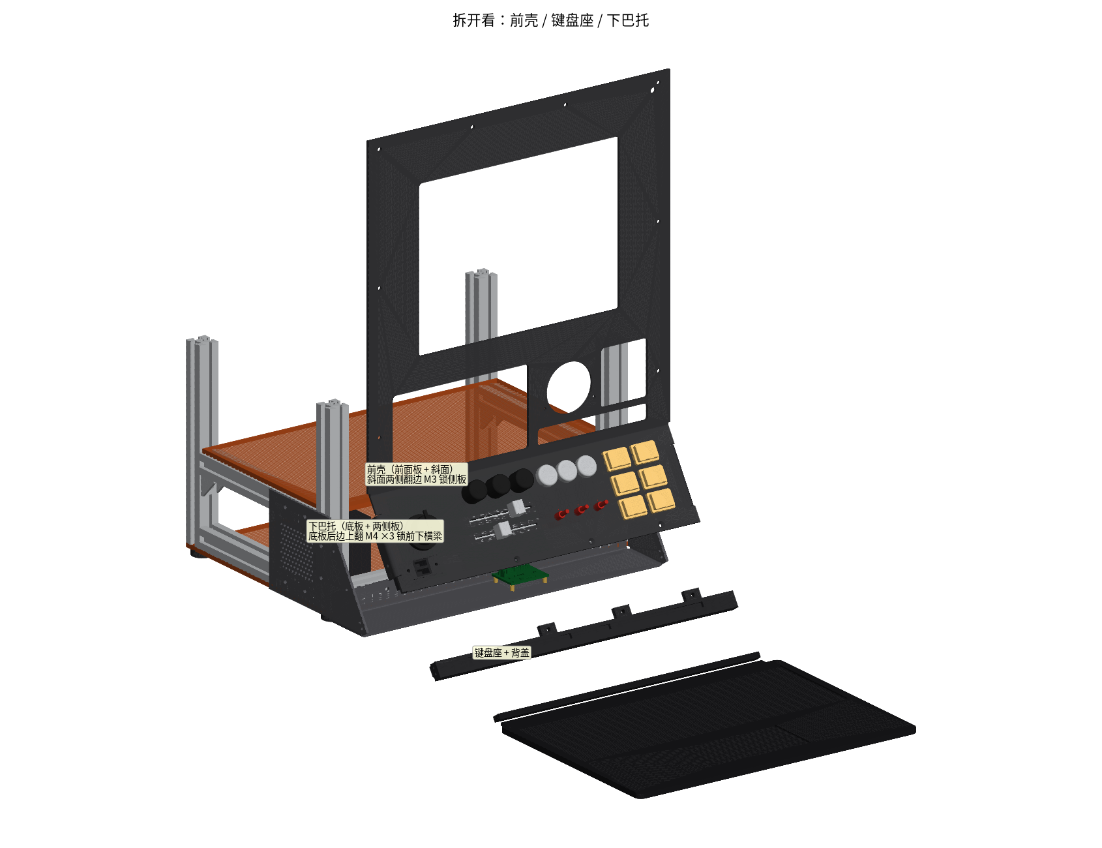
png/26_chin_exploded.png
