huatanshaonian/EL-center/png/26_chin_iso.png

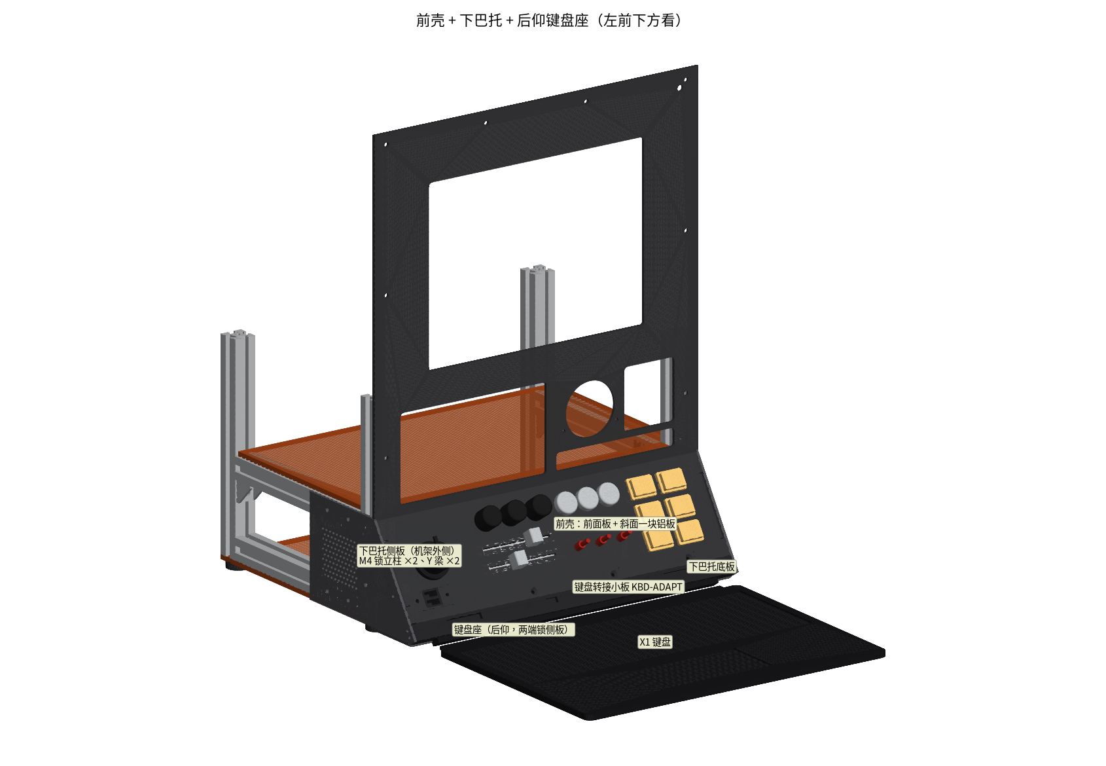
png/26_chin_iso.png
