huatanshaonian/EL-center/png/26_chin_side.png

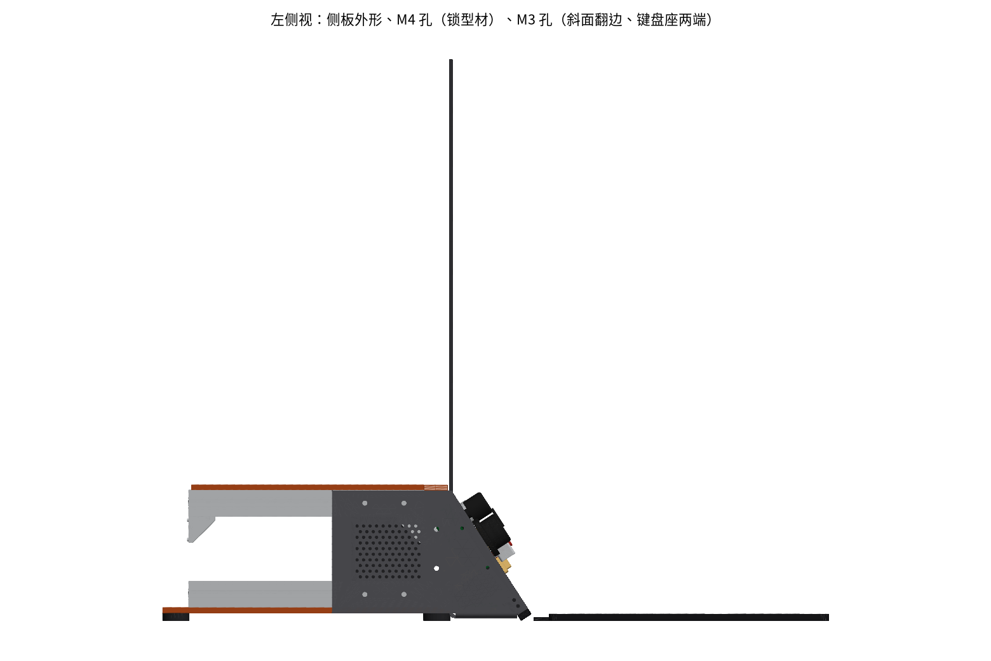
png/26_chin_side.png
