huatanshaonian/EL-center/png/27_drill_map.png

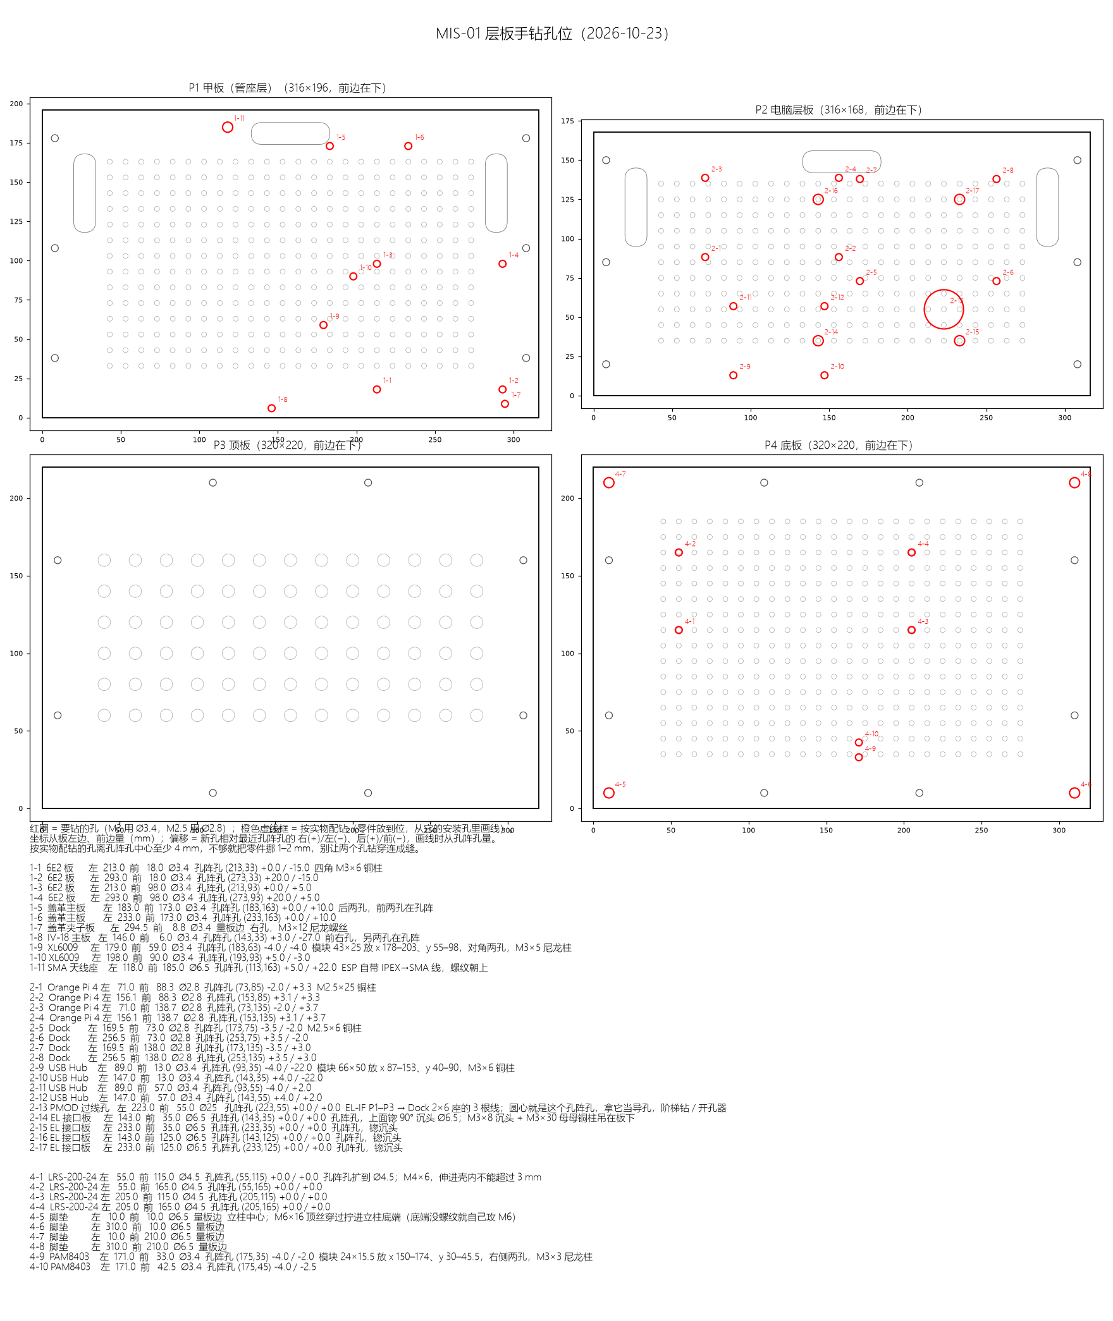
png/27_drill_map.png
