huatanshaonian/EL-center/png/28_slant_pcb_cut.png

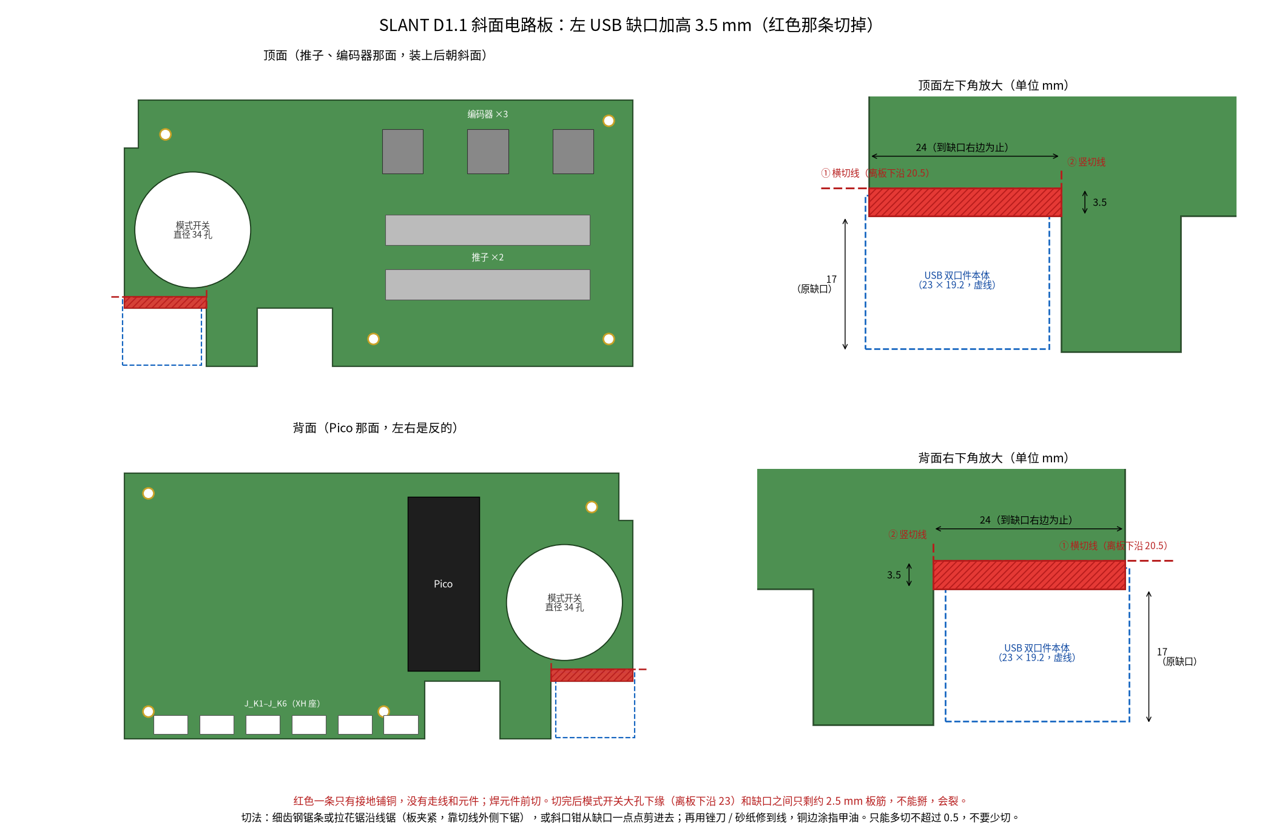
png/28_slant_pcb_cut.png
