huatanshaonian/EL-center/png/31_max6921_pinout.png

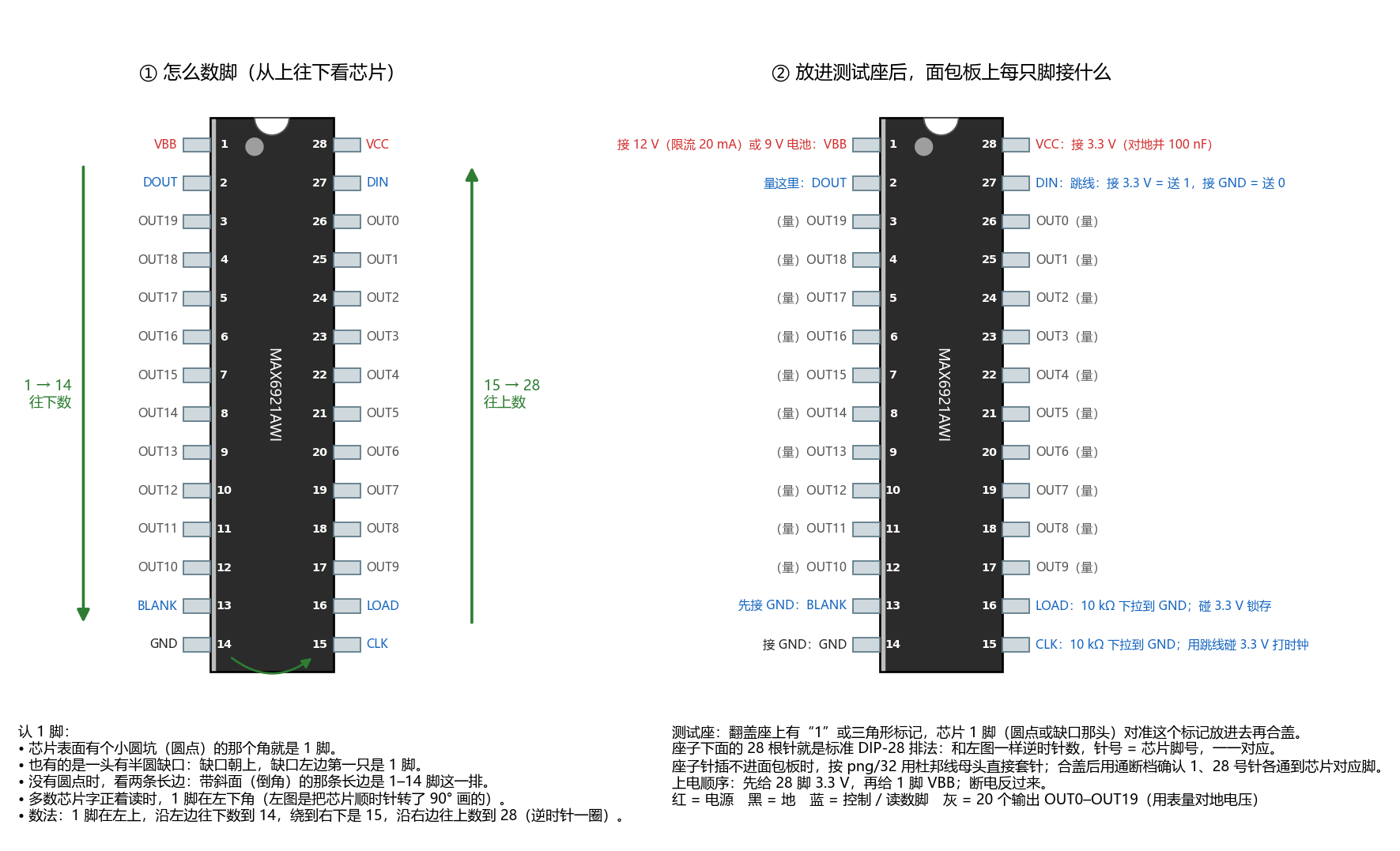
png/31_max6921_pinout.png
