huatanshaonian/EL-center/el_driver/嘉立创下单清单.txt

MIS-01 嘉立创下单清单（2026-10-22，10-23 改：01/02/06 改自己回流焊）
====================================================================
零、这一轮的单
  A. 嘉立创 PCB（15 款）+ SMT 贴片（只 03/04/05 三款）+ 钢网（01/02/06 拼成一张，单独下钢网单）：本文件。周期最长，先下。
  B. 立创商城第二批补单（74 行，直插件为主）：已下。
  B2. 立创商城第三单（自焊贴片件，5 行，约 40 元）：procurement\MIS-01_第三单_自焊贴片件_立创商城BOM.xlsx。
      08/09/13 不贴片、04/05 的 HDMI 插头 J1 自己用烙铁焊，料在这一单。
  B3. 立创商城第四单（01/02/06 自己回流焊的贴片料，49 种，2 套 + 备件；同规格不同编号已合并，0 Ω 0805 用第三单的）：
      procurement\MIS-01_第四单_自贴三板贴片料_立创商城BOM.xlsx（build_lcsc_bom_order4.py 生成）。
      B2、B3 都在立创商城 → BOM 配单上传，可以和 A 合并发货。
  C. 淘宝自购第二批：procurement\MIS-01_自购清单_第二批.xlsx。买 1–26、32–47 项（32 是喇叭固定用锤头螺母+螺丝；41–47 是回流焊工具，买了二合一拆焊台则 41 烙铁、43 热风枪不用另买）；27–31 是外壳件，见 D。
     另外买回流焊工具（见第五节）。
  D. 外壳（嘉立创钣金 / CNC）：..\外壳加工\下单说明.txt。等板子和喇叭到货试装后再下。

  为什么 01/02/06 不让嘉立创贴：嘉立创贴片除每款 50 元工程费外，扩展库元件每种另收约 20 元换料费（每款单独收）。
  02 一款 17 种扩展料，贴 2 套报价约 540 元（换料费 320）；01/02/06 三款换料费合计约 660 元。
  自己买料 + 钢网 + 加热台回流焊更便宜；03/04/05 有细间距排线座，自己焊易连锡，仍交嘉立创贴。

一、怎么下单
  1. 下单文件都在 el_driver\下单文件_20261022\，按序号分好文件夹；00_全部Gerber_批量上传 里是 15 个 Gerber 压缩包。
  2. 每块板一个订单项，全部加购物车一起付款、一起发货。
  3. 贴片（只 03/04/05）：PCB 订单里勾"需要 SMT 贴片"，审核后在贴片步骤上传 JLC_SMT_BOM_*.csv 和 JLC_SMT_CPL_*.csv
     （在 00_全部贴片BOM坐标 或各板文件夹里）。BOM 表头已改成中文（型号/位号/封装/嘉立创元器件编号），
     若仍弹"匹配度不高"对列框，各列对上就点确认。带"_全部"的文件、"不上传"文件夹里的文件都不要传。
  4. 贴片预览重点看有极性的元件：二极管、TVS、IC 的 1 脚、SOT-23 管子、排线座方向；看着不对截图给 Claude。
  5. 只用各板"制板文件"目录里的文件；"旧版D1_勿用"目录里的不要用。

二、打板参数（15 块都一样，例外见第四节）
  设计软件/文件格式  嘉立创EDA
  板材               FR-4（不用铝基板）
  层数 / 板厚        2 层 / 1.6 mm（04/05 必须 1.6）
  外层铜厚           1 oz（电源板也 1 oz，丝印"Cu 2oz"不管；2 oz 加价约 300，复核 1 oz 主干温升 10–20 ℃，见设计记录）
  阻焊 / 字符        绿色 / 白字（07 黑色）
  表面处理           有铅喷锡（免费）；04/05 可选沉金
  最小孔径           0.3 mm（免费档；13 是 0.7）
  拼板               不拼板
  数量               5 片（09 IN-14 小板 10 片）
  打叉板             不接受
  订单号标识         加嘉立创订单号（免费）；07 选"不加任何标识"（10 元）
  四线低阻测试       不要
  确认生产稿         只 04/05 勾，下载生产稿发 Claude 核对；备注"板前沿 J1 焊盘为夹板插头焊盘，请勿内缩"
  盲盒免费券         只能用在特价板（≤10×10、标准参数、经济型贴片、5 片）：先试 03

三、贴片与钢网
  贴片（03/04/05）   经济型；贴片面"顶层"；每款贴 2 套。
  钢网（01/02/06）   三块板的顶层锡膏层拼成一张（嘉立创钢网最小 30×40 cm，一块一张太浪费）：
                     01/02/06 的 PCB 订单里都不勾钢网；另下一张钢网单，上传
                     下单文件_20261022\00_钢网_三板合一\Stencil_ELIF_PWRDIST_IV18.zip（make_stencil_panel.py 生成，
                     拼板外形 150×267 mm：从下往上 PWR-DIST、EL-IF、IV18，间隔 15 mm）。
                     选最小尺寸、无框、只做顶层；备注"三款板拼在一张钢网上，按 GTP 文件开孔，板框层仅作参考不开孔"。
                     审核若不接受拼钢网，就退回 01/02/06 各自勾钢网。
                     这三块不勾 SMT 贴片。

四、逐块
  序 板子                  尺寸 mm    特殊参数                   贴片/钢网             自己焊的贴片件
  01 EL-IF D1.3            100×100                               拼钢网，自己回流焊    全部贴片件（第四单）
  02 PWR-DIST D1.1         150×100    1 oz                       拼钢网，自己回流焊    全部贴片件（第四单）
  03 KBD-ADAPT             40×30                                 经济型贴 2 套
  04 HDMI-PI D1            18×38.4    ★板厚1.6，确认生产稿       经济型贴 2 套（只 J2） J1 HDMI 插头（第三单）
  05 HDMI-DOCK D1          25×38.4    ★板厚1.6，确认生产稿       经济型贴 2 套         J1 HDMI 插头（第三单）
  06 IV18 D1               130×37                                拼钢网，自己回流焊    全部贴片件（第四单）+ U1 MAX6921；R17–R19 不焊
  07 IV18-END              36.5×19    ★黑色阻焊，不加标识        不贴
  08 HV-UNI D1             80×40                                 不贴                  L1、RS1（第三单）
  09 IN14-SOCK             21×40      ★数量 10                   不贴                  R_PR 0 Ω（第三单，或电阻腿短接）
  10 NIXIE-DRV D1.1        150×80                                不贴
  11 EYE-6E2 D1.1          90×90                                 不贴
  12 GEIGER-MAIN           60×70                                 不贴
  13 GEIGER-CLIP           146×38                                不贴                  R2 4.7 MΩ（第三单）
  14 SLANT D1.1            149×78                                不贴                  （Pico 插针装，焊排母）
  15 ESP-BASE D1           110×50                                不贴                  （U1 PCA9555 预留不焊）

  贴片元件数核对：03 = 6 个（2 种）、04 = 1 个、05 = 13 个（5 种）。
  自贴三板：01 = 22 个（10 种）、02 = 79 个（28 种）、06 = 37 个（22 种）；坐标与料表在 00_自贴三板_坐标料表_不上传。

五、自己回流焊要的工具（淘宝）
  恒温烙铁（T12/936 类）、加热台（台面 ≥200×200，02 板 150×100）、热风枪（858D 类，返修 QFN）、
  有铅锡膏 Sn63（熔点 183 ℃）、刮刀（或旧银行卡）、尖头防静电镊子、放大镜台灯或电子显微镜、洗板水/酒精。
  流程：只刮钢网上对应那块板的区域；钢网对准板子（用两块空板在旁边垫平卡位）→ 刮锡膏 → 对照焊接图摆件 → 加热台加热到锡膏发亮再停几秒 → 取下冷却
        → 检查连锡（烙铁 + 助焊剂 + 吸锡带修）→ 最后焊直插件。
  02 的 TPS259470（VQFN-10 2×2 mm，4 个）最难：锡膏要刷匀，焊完重点检查。

六、下单前最后核对
  1. 03/04/05 贴片件当天看一下库存，缺货告诉 Claude 换料。
  2. 第四单里有 4 个料因立创商城无货已换同规格件：1 µF 0805 → C91185，10 k 0603 → C98220，
     ME6211C33M5G-N → AP2112K-3.3TRG1 C51118（脚位相同），IV18 C3 100 nF/100 V → C106243。
