huatanshaonian/EL-center/el_driver/购买清单与库存复用_D0.md

> D1更新（2026-10-18）：本文件保留D0历史设计记录，当前改版、采购和实验请以[README_D1](README_D1.md)为准。原“VD下降全过程VL必须≥4.75V”的额外推导已撤销；人工限流点屏按设计笔记§16.4，未验证PCB电源级暂不给真屏供电。

# 缺件购买清单 D0

> 当前采购：[直插优先合单总表D1](直插优先_合单采购总表_D1.xlsx)，共55行零售备料；下方D0首轮清单不再用于合单。

日期：2026-10-18。库存依据：电子元器件完整库存与收纳表_新增LRS200-24.xlsx；只读取，没有修改库存数量。以下“采购”表示库存未记录或规格不满足，并非已下单。商城编号来自嘉立创EDA库检索，不代表当前价格、现货或替代料已审核。

## 先买：面包板与假负载实验

|物料|实验需求|建议购买|说明|
|---|---:|---:|---|
|TI SN74AHCT245N，PDIP-20|2|4|含2备件；C1548096；必须 AHCT/HCT TTL输入门限，普通74HC245在5V供电时不可直接替换|
|PDIP-20 IC座/合适面包板|2/1|按现有工具补齐|库存未记录工具；若已有不用买|
|DF11-20DS-2C母壳、匹配压接端子/预压线|1套20芯|2套+40根线|与屏CN5匹配；2.00mm；先核对实物型号、针1和额定电流，不用2.54mm杜邦头硬插|
|2.00mm 2×10转2.54mm引出板|1|1–2|实验转接；逐针通断测量，尤其两根5V、两根12V和5根GND|
|Dock 12芯转接线/排母|3组|3组|针序按引脚表，不按通用PMOD；短线≤15cm，逻辑回路尽量更短|
|10pF C0G/NP0电容 ≥25V|11|20|假负载；库存没有10pF。引脚/焊点寄生会使实际负载大于10pF|
|390Ω电阻 1% ≥0.125W|11|20|假负载输入串阻；库存330Ω仅供初步对比，不能冒充390Ω标准假负载|
|16Ω功率电阻 ≥5W|1|1–2|VL假负载约0.31A、1.56W；2W额定余量不足|
|12V可调电子负载|1|已有则0|首选，逐步0→0.5→1→1.8A；库存功率电阻不能代替|
|6.8Ω铝壳电阻 ≥50W及散热安装|可选1|电子负载已有则0|约1.76A、21.2W；必须满足厂家散热降额；是可选负载方案|
|示波器与短接地弹簧、万用表、可限流台式电源|1套|缺什么补什么|库存表未列仪器；30ns边沿与过冲验证需要合适带宽及探头，不凭肉眼LED判断|

## 面包板优先使用现有库存

|物料|本阶段占用|库存数量/收纳|用途|
|---|---:|---|---|
|1kΩ直插电阻|11|30 / R-K|FPGA→AHCT A脚串阻|
|100kΩ直插电阻|22|30 / R-K|11个A脚、11个输出下拉；余8只，后续电源实验另核算|
|10kΩ直插电阻|1|30 / R-K|OE_N上拉至Dock3.3V|
|33Ω、68Ω、82Ω、100Ω|每次11只一种|20、20、20、25 / R-Ω|B侧串阻对比；无需把各阻值全部同时装入|
|100nF瓷片|2|10 / C-01|U1/U2就近去耦|
|10µF/50V电解|1|6 / C-02|VL本地储能，注意极性|
|1MΩ直插电阻|11|25 / R-K|假负载10pF并联泄放|
|2N3904|预留2|10 / T-01|后续状态开漏输出；实际管脚以该厂家资料/实测为准|
|LRS-200-24、NID100-5、NID100-12|各1|各1 / P-01|保留用于后续电源分配实验；首轮信号面包板优先用台式5V限流源|

现有电阻精度、功率未逐只确认；普通电阻可以用于逻辑实验，不能拿未核实的色环电阻代替0.1%电源监控分压。现有100nF仅10只，当前PCB草稿共8只；实验和PCB若同时保留，不能重复扣同一批库存。

## PCB 电源草稿器件：先审核、实验，定版后采购

以下是当前 EL-IF D0 的候选采购规格；电源保护未定版，暂不按这些数量批量购买或做贴片订单。

|位号/用途|型号/规格|板上数量|建议含备件数量|库编号/备注|
|---|---|---:|---:|---|
|U1/U2|SN74AHCT245DW，SOIC-20宽体|2|4|C2863961；面包板N封装不能焊进DW封装|
|U_VL/U_VD|TPS259470LRPWR，锁存关断型|2|4|C3662793；WQFN需转接/热焊验证|
|U_SUP|TPS3808G01DBVR|1|2|C19653；阈值协调仍需修改，保留为候选|
|U_NOR|SN74LVC1G02DBVR|1|2|C16360|
|Q_VL|AO3400A|1|5|C700953|
|D2/D3|BAT54WS-7-F|2|10|C124205；阴极接故障状态，阳极接EN_VD|
|RVS1|100kΩ 0.1% 0603 RT0603BRD07100KL|1|10|C122538|
|RVS2|1.2kΩ 0.1% 0603 RT0603BRD071K2L|1|10|C136970|
|RVS3|10kΩ 0.1% 0603 RT0603BRD0710KL|1|10|C95204|
|CDV12|2.7nF C0G ≥25V|1|10|C343017，0805；库存无此值|
|CDV5A/B|1nF C0G ≥25V|2|10|C163508；库存1nF可做初步实验，介质需核实|
|C3及四个电源输入输出电容|10µF 25V X5R 0805|5|10|C15850；有效容量须考虑直流偏压；库存直插不是同一PCB封装|
|C1/C2、四个旁路、CSUP/CNOR|100nF 50V 0603|8|20|C14663；库存直插只用于面包板|
|J_EL，未来假负载板连接器|DF11-20DP-2DS(24)，弯插|当前1，后续另1|3|C7506813；说明书原文把2DS称直插，存在矛盾；若需直插应改2DSA并重核机械|
|J_PWR|XY128V-A-5.08-4P|1|2|C22450485；额定电流/线径及实物装配待审核|
|J_PF/J_UART|XH-2A / XH-3A，2.5mm|各1|各2|C2908600 / C2908601；不是精确2.54mm，线束须配套|
|P1/P2/P3|2×6 2.54mm排针|3|3–6|C9900165112；物理针序与线缆要逐根核对|
|其它0603电阻|按下方完整BOM|见BOM|每值最小包装|直插库存与贴片封装不可重复使用|

## 后续电源分配板待确定，不纳入已完成BOM

LM393B/精密2.5V参考、PFAIL 21/22V回差电阻、两路独立开漏输出、8A输入保险丝及座、NID100推荐低ESR输出电容（5V100µF/16V，12V68µF/25V）、VD主动放电与VL保持器件、电源指示LED及限流、输入瞬态抑制、线束及安装件。

库存10A保险丝的快慢断规格未知，不能当作厂家建议8A保险丝；库存普通电解的低ESR未确认。电源保持与放电未定版，不能先假定需要的电容值/放电管型号。电源分配板与假负载板还未完成嘉立创EDA原理图，也没有完成PCB。

## 当前 EL-IF D0 完整器件BOM

该表从实际工程102个器件合并生成，含贴片封装；用于审阅，不是生产放行表。

|型号|值/描述|封装|数量|位号|库编号|
|---|---|---|---:|---|---|
|PH2.54,2*6P|PH2.54,2*6P|HDR-TH_12P-P2.54-V-M-R2-C6-S2.54-EH|3|P1, P2, P3|C9900165112|
|DF11-20DP-2DS(24)|2x10P 间距:2mm 弯插|CONN-TH_DF11-20DP-2DS-24|1|J_EL|C7506813|
|SN74AHCT245DW|SN74AHCT245DW|SOIC-20_L12.8-W7.5-P1.27-LS10.3-BL|2|U1, U2|C2863961|
|CC0603KRX7R9BB104|100nF|C0603|8|C1, C2, CB5IN, CB5OUT, CB12IN, CB12OUT, CSUP, CNOR|C14663|
|0603WAF1001T5E|1kΩ|R0603|11|RA1, RA2, RA3, RA4, RA5, RA6, RA7, RA8, RA9, RA10, RA11|C21190|
|0603WAF1003T5E|100kΩ|R0603|24|RPA1, RPB1, RPA2, RPB2, RPA3, RPB3, RPA4, RPB4, RPA5, RPB5, RPA6, RPB6, RPA7, RPB7, RPA8, RPB8, RPA9, RPB9, RPA10, RPB10, RPA11, RPB11, ROV121, REND|C25803|
|0603WAF330JT5E|33Ω|R0603|11|RB1, RB2, RB3, RB4, RB5, RB6, RB7, RB8, RB9, RB10, RB11|C23140|
|0603WAF1002T5E|10kΩ|R0603|12|ROE, RUV2, ROV52, ROV122, REN, RVDP, RVAP, RVGU, RVGD, RVOK, RFLT, RPF|C25804|
|TPS259470LRPWR|2.7V至23V、5.5A、28mΩ真反向电流阻断电子保险丝|VQFN-10_L2.0-W2.0-P0.45-TL|2|U_VL, U_VD|C3662793|
|SN74LVC1G02DBVR|单路2输入正或非门|SOT-23-5_L3.0-W1.7-P0.95-LS2.8-BR|1|U_NOR|C16360|
|AO3400A|1个N沟道 耐压:30V 电流:5.2A|SOT-23-3_L2.9-W1.3-P1.90-LS2.4-BR|1|Q_VL|C700953|
|TPS3808G01DBVR|低静态电流、可编程延迟监控电路|SOT-23-6_L2.9-W1.6-P0.95-LS2.8-BR|1|U_SUP|C19653|
|0603WAF2742T5E|27.4kΩ|R0603|1|RUV1|C22964|
|0603WAF3572T5E|35.7kΩ|R0603|1|ROV51|C23027|
|0603WAF4221T5E|4.22kΩ|R0603|1|RIL5|C23042|
|0603WAF1331T5E|1.33kΩ|R0603|1|RIL12|C22838|
|RT0603BRD07100KL|100kΩ|R0603|1|RVS1|C122538|
|RT0603BRD071K2L|1.2kΩ|R0603|1|RVS2|C136970|
|RT0603BRD0710KL|10kΩ|R0603|1|RVS3|C95204|
|CL10C102JB8NNNC|1nF|C0603|2|CDV5A, CDV5B|C163508|
|C2012C0G1H272JT0H0N|2.7nF|C0805|1|CDV12|C343017|
|CL21A106KAYNNNE|10uF|C0805|5|C3, C5IN, C5OUT, C12IN, C12OUT|C15850|
|BAT54WS-7-F|电压:30V 电流:100mA|SOD-323_L1.8-W1.3-LS2.5-RD|2|D2, D3|C124205|
|XY128V-A-5.08-4P|1x4P 5.08mm 直插 排数:1 每排P数:4|CONN-TH_4P-P5.08_KF128-5.08-4P|1|J_PWR|C22450485|
|XH-2A|1x2P 间距:2.5mm 直插 系列:XH|CONN-TH_2P-P2.50_HCTL_XH-2A-X|1|J_PF|C2908600|
|XH-3A|1x3P 间距:2.5mm 直插 系列:XH|CONN-TH_XH-3A|1|J_UART|C2908601|
|0603WAF1000T5E|100Ω|R0603|2|RTX, RRX|C22775|
|Test Point||Test-Point-0.5mm|3|TP_SP1, TP_SP2, TP_SP3|裸测试焊盘|
