huatanshaonian/EL-center/parts_list.csv

区域 | 零件 | 数量 | 模型状态 | STEP 编号 | 采购 | 备注
显示 | Sharp LJ64K052 EL 屏 | 1 | 参数化占位 | P01 | 已有 | 外形 267×220×23.5、两组安装孔（Ø3.5 孔距 257×208 / Ø4.4 孔距 238×187）、CN5 位置按规格书 p.12；内部细节为示意
显示 | IN-14 辉光管 | 6 | 真实模型 | P05 | 已有/淘宝
显示 | IV-18 荧光管 | 1 | 真实模型 | P06 | 已有/淘宝 | 栅/阳极额定 50 V、最高 70 V，单段 ≤1.3 mA；灯丝 5.0 V 85±10 mA（1、13 脚）；栅/阳极 XL6009 升到约 35 V（≤35 V，原厂额定 50 V、最大 70 V）；灯丝交流方波 + 约 2 V 偏置（以 IV-18 板评审为准）；寿命 ≥10000 h，无人时熄灭
显示 | 指针表头 正泰 85C1 直流 0-1mA | 1 | 参数化占位 | P43 | 淘宝（未到货；内阻到货实测） | 面框 64×56，背面凸台 Ø49×2.5，2 颗 M3 螺柱孔距 52（表心下方约 13），板后深 47.5；模型和面板开孔已按此改（2026-10-20）
显示 | 6E2 侧视条形指示管（北京产，= EM87） | 2 | 参数化占位 | P50 | 已买 | 用户实测 2026-10-20：总高 62（不含插针）；发光条长约 39；发光条上端离玻壳底面 48.3、下端约 9.3（用户确认）；玻壳直径未量（模型按 Ø22.2）。方向：正对显示屏时缺口（空针位）在右边，7 脚在正前方 → 机内管座绕 Z 转 18°（缺口在 +x 往后偏 18°）。驱动：阴极接 12 V，栅极 0–12 V 正压，不做负压；两支灯丝串联取 HV-B 那路 12 V（高压关则灯丝灭）。冷态电阻：4–5 脚 2.98 Ω（灯丝好）；2–6、2–8 约 0.1 Ω（国产管 2、6、8 脚管内相连，都带 250 V）；1–3、3–9 不通（无碰极）。装法：竖放在表头右侧，管心 x 261 / 285、y 31（管座前耳要让开下方 J305），6E2 板 M3×6 铜柱，管座顶面 z 111.6，管顶 z 173.6；面板开口 x 248–298、z 118–174 与表头面框齐平（背面贴透明亚克力）。阳极约 250 V
显示 | 9 脚小型管座（noval，带耳扁焊片） | 2 | 参数化占位 | P51 | 已有 | 杏仁形：宽 21.6、耳到耳 34、高 10，耳孔 Ø3.6 孔距 28，缺口垂直于两耳连线；焊片 9 片宽 2.8 厚 0.5 伸出约 7，切向排在 Ø14 圆上（36° 一片，空一格为缺口），中心另有屏蔽弧片（宽约 3，接地）；对针脚看、显示面朝上时缺口朝右；焊片插 6E2 板长槽孔，两耳 M3 锁板；模型暂直接摆在甲板上，等 6E2 板画出来再改
探测 | J305 盖革管 | 1 | 参数化（用户实测） | P31 | 已有 | 总长 103.5，管身外径 10；两端电极 Ø6.3、长约 6.3（完整圆柱段约 6）；两头电极圆柱段最近端之间 94（用户确认），每头能夹约 4.75；正负极未知（2026-10-20 实测）。装法：管轴 x 186–289.5、y 8、z 105.3，横在盖革窗后；夹子长条板 GEIGER-CLIP D1 为 L 形（长条 x 153–299、y 2–14，左端加宽到 x 153–186、y 2–40 放检测电路），垫 3 mm 尼龙柱，板底引脚剪到 1 mm 内；LS-601（C182321）6.3 mm 保险丝夹，J305 夹子中心 x 187.25 / 288.25（HAC2311S 那组已删）；4.7 MΩ 贴片阳极电阻在管下；3 颗 M3 尼龙螺丝：左 (165,35)/(175,35) 在孔阵上，右 (296.5,10.8) 自钻
探测 | HAC2311S 盖革管 | 1 | 暂无 |  | 已有 | 南京核安（njhean.com）：起始 280–350 V，工作 350–500 V，推荐 400 V，坪长 ≥100 V，实测总长 91、电极 Ø6.3（与 J305 一样，夹子通用），死时间 75 µs，本底 15 cpm，Co-60 灵敏度 20 cps/(mR/h)；备用，不装（整机定用 J305）
主控 | Orange Pi 4（非 LTS） | 1 | 参数化占位 | P04 | 已有 | 电脑层暂定布置（待用户确认）：板 x 70–161、y 114–170，网口朝左、HDMI 长边朝后；板框/孔位/接口平面位置按官方 4 LTS DXF，高度估计，实物到手复核
主控 | Tang Primer 20K Dock + 核心板 | 1 | 真实模型 | P03 (P02) | 已有 | 电脑层暂定布置（待用户确认）：板 x 170–265、y 99–172，HDMI/网口/DC 一侧朝后；Dock 模型已含核心板
主控 | 微雪 Waveshare ESP32-S3-DEV-KIT（模组 ESP32-S3-WROOM-1U-N16R8，外接天线） | 1 | 参数化（按微雪官方尺寸图） | P32 | 已有 | 板 63.30×25.40（官方图；用户实测 63.5×25.5）；2×22 针，排针出厂已焊好（朝下）；排距按 0.9 英寸 22.86 设计（用户实测两排外侧 23.7 / 内侧 22.3，中心距约 23.0）；排针塑料座 2.6、板下针长 7（用户实测）；4 个 Ø2.0 孔（孔距 59.7×21.8）；USB-C ×1；模组与 IPEX 座位置为推断，待实物核对；天线随开发板附带（若是 IPEX 转 SMA 线 + 棒状天线，就装在后面板 SMA 孔；转接线要够到后面板；转接线长度未量）；2026-10-26：自带 IPEX→SMA 穿墙线 20 cm 到不了后面板，SMA 座改装甲板 (120, 187) Ø6.5，棒状天线 15 cm
主控 | Raspberry Pi Pico (RP2040) | 1 | 真实模型 | P33 | 立创 C7203002 | 输入层：焊在斜面电路板上，Micro-USB 线接 Hub 模块；按键、编码器、推子、模式开关
驱动 | K155ID1 (DIP-16) | 6 | 真实模型 | P09 | 已有 | 用 DIP 插座，先测后装
驱动 | MAX6921 | 1 | 真实模型 | P35 | 淘宝/立创 | 模型为 SOIC-28W，买到 PLCC 需换；建议多买 1 片
电源 | 明纬 LRS-200-24 | 1 | 参数化包络 | P10 | 已有 | 外形 215×115×30 按规格书；9 位端子（1 L、2 N、3 FG、4–6 −V、7–9 +V），可调 21.6–28.8 V，满载保持 16 ms@230 VAC；侧面 115/230 V 开关装机前拨 230 V；端子台位置待实物核对
电源 | 明纬 NID100-5 | 1 | 真实模型 | P11 | 已有 | 50.8×27.5×12 竖装，13 针 2.54；输入 10.5–53 V；外接容性负载 ≤100 µF；输入保险 8 A（STEP 文件名仍是 P11_MeanWell_NID100-05）
电源 | 明纬 NID100-12 | 1 | 真实模型 | P12 | 已有 | 与 NID100-5 同外壳；输入 20–53 V；外接容性负载 ≤68 µF；输入保险 8 A；EL 设计笔记 v0.2 由 NID65-12 改来
电源 | NCH6100HV 辉光管升压模块 | 0 | 参数化占位 | P13 | 不买 | 2026-10-20 改为自制通用高压小板（UC3843AN），不再使用；P13 模型留作参考
自制板 | 通用高压小板 HV-UNI D1（UC3843AN，12 V → 150–280 V 可调） | 3 | 整板 STEP |  | 嘉立创打板（全部手焊） | UC3843AN 用户自有，确认够 3 块用；80×40×1.6，四角 M3 (5,5)/(75,5)/(5,35)/(75,35)；排针朝下插宿主板排母，叠高 11，M3×11 铜柱；元件最高 TO-220 立装约 20。170 V 插辉光驱动板后右（x 85–165、y 77–117）；250 V 横放在 6E2 板上、管子后面（x 215–295、y 50–90，HV 输出在右端）；第 3 块备用。料单见 procurement/build_lcsc_bom_hvuni.py；STEP 在 el_driver/HV-UNI_D1/制板文件/
电源 | XL6009 可调升压模块 | 1 | 按实测建模 | P34 | 淘宝 | IV-18 栅/阳极：24 V 常电 → 约 35 V（≤35 V，原厂额定 50 V、最大 70 V）；输入经 ESP32 控制的开关；实测 43×25×13，对角两孔离短边 6、离长边 3；装甲板 x 178–203、y 55–98（长边沿 Y），孔 (181 | 61)(200 | 92) 自钻，M3×5 尼龙柱；买 2 个（1 备）
自制板 | PCB-3 电源板（PWR-DIST D1） | 1 | 整板 STEP |  | 嘉立创打板 + SMT | 150×100；元件朝下倒挂在甲板下、LRS-200 上方，M3×10 铜柱（甲板孔阵 x 85/225、y 65/155）；STEP 在 el_driver/PWR-DIST_D1/制板文件/；P16 为旧占位
自制板 | IN-14 管座小板 IN14-SOCK D1 | 6（另做 1 块备用） | 整板 STEP（去掉代替管子的排针） | P27 | 嘉立创打板 | 21×40，板原点 = 全局 (管心 x − 10.5 | 15)，板底 z 116.6；底面 2×7 排针插在辉光驱动板前沿的排母上，后部 1 颗 M3 锁住（M3×11 铜柱），换管直接换板
自制板 | 辉光驱动板 NIXIE-DRV D1 | 1 | 整板 STEP |  | 嘉立创打板 | 4×74AHCT595 + 6×K155ID1（DIP 插座）+ 6×MPSA42（右小数点）；150×80（x 20–170、y 40–120），HV-UNI 170 V 插在 x 85–165、y 77–117；M3×10 铜柱立在甲板上，孔 (25 | 115)(165 | 115)(70.5 | 45)(119.5 | 45)；J_LOG XH-5 在 (37 | 116)；前沿 6 个 2×7 排母接 IN-14 小板，不走排线
自制板 | IV-18 板 | 1 | STEP（IV18 D1 主板 + IV18-END D1 端板） | P28 | 嘉立创打板 | IV-18 在辉光管下方，管子调头（引线端朝右，芯柱端面 x 141）；主板 130×37（x 22–152、y 3–40，板底 z 95）+ 竖立端板 33.5×17.4（x 143–144.6，引线直接穿孔焊接，下沿和主板 T 形焊，黑色阻焊）；直插件焊脚剪平到 ≤0.8 mm（板下只有 1 mm 垫片）；MAX6921 用户自有；孔 (45 | 35)、(135 | 35)、(148 | 8)；按最高 60 V 设计（电容 ≥63 V、布线间距按 60 V）
自制板 | 盖革主板 + 夹子长条板 | 1 套 | STEP | P38 | 嘉立创打板 | GEIGER-MAIN D1 60×70 平放在甲板上（x 180–240、y 110–180，6E2 板后面），M3×6 铜柱，四孔 (185/235, 115/175)，后两孔自钻；升压、蜂鸣器（LS1 压电 / LS2 电磁二选一，都买）、J1 XH-2P 接 HV-C、J2 XH-4P 接 ESP32 底板（5 V 常电 / GND / PULSE / BZ）、J_HV 高压线直焊到夹子板 J_HVI。夹子长条板见 J305 行；料单 procurement/build_lcsc_bom_geiger.py；设计记录 el_driver/GEIGER_D1/
自制板 | ESP32-S3 底板 | 1 | STEP（ESP-BASE D1，开发板、DS3231 另建） |  | 嘉立创打板 | 插微雪 ESP32-S3-DEV-KIT（排针中心距按 22.86）；PCA9555、J_EXP 只留焊位不焊；接 DS3231（6P 弯针竖插 J_RTC）、BH1750、LD2410B 等；ESP-BASE D1 110×50 放甲板驱动板后面 x 40–150、y 120–170，M3×6 铜柱，四孔 (45/145 | 125/165) 都在孔阵上；设计记录 el_driver/ESP-BASE_D1/；开发板 USB-C 朝左，弯头线从电脑层左走线孔上去接 Pi；U.FL 朝右；SMA 天线座改装甲板 (120 | 187)
自制板 | HDMI 软排线两头小板（HDMI-PI D1 / HDMI-DOCK D1） | 2 | STEP |  | 嘉立创打板+贴片 | mis-01-56 2026-10-21 画完：Pi 端 18×26、Dock 端 25×26（多 8 只 49.9 Ω 上拉和 3.3 V 稳压），C711355 夹板式 HDMI 公头 + 立式 20P 0.5 mm 座 C11073；插头插进 6.8 mm 后板前沿在 y 178.3，板底 z 274.6；20 cm 同向排线 C11107 在两口之间拱起（拱顶 z 358）；设计记录 el_driver/HDMI_FPC_D1/
自制板 | EL 接口与电源时序板（EL-IF，PCB-1） | 1 | 整板 STEP（D1.3） |  | 嘉立创打板 | 100×100；吊在电脑层板下、屏幕正后方，元件朝上，M3×30 母母铜柱 ×4 + M3×8 沉头 ×4 + M3×6 盘头 ×4（2026-10-28 定）
自制板 | 斜面电路板 | 1 | STEP（SLANT D1，Pico 另建） |  | 嘉立创打板 | Pico、ULN2803，EC11×3、推子×2 焊在板上；板到斜面内表面 6.5；SLANT D1 板子 x 17–166、u 0–78，下沿模式开关（x 17–41）、USB 母座（x 56–78）两个缺口到 u 17；孔 (29 | 68)、(159 | 72)、(159 | 8)、(90 | 8)；设计记录 el_driver/SLANT_D1/
斜面 | EC11 编码器 + 旋钮 | 3 | 编码器真实 + 旋钮占位 | P21 | 立创 C470754 / 旋钮淘宝 | EC11E 无螺纹套，Ø6 D 型轴 20 mm，焊在斜面电路板上固定（安装脚间距 12.5）；3 个一排 x 98.5/123.5/148.5、u 63；旋钮 Ø15 带顶丝；立创买了 3 个，没有备件，建议补 1–2 个
斜面 | 波段开关 + 指针旋钮（模式） | 1 | 参数化（按六钧图纸） | P42 | 立创 C19077029 / 旋钮淘宝 | 六钧 MFR01-A2F05L1S-R：本体 Ø32×14 + 焊片 4.5，M10×5.5 螺纹，面板开 Ø10 + 2 个 Ø4.1 防转孔（距 22）；1 刀 6 位，按 6 档接；旋钮为占位
斜面 | 正泰 LA16 系列 24×18 长方形带灯按钮（键帽可插菲林字片） | 6 | 参数化占位 | P49 | 淘宝（用户已选） | 3 排 x 2 列；开 Ø16 圆孔（LA16 类通用 Ø16 +0.2，具体以实物为准）；灯 12 V，Pico 经 ULN2803 驱动；身长、开关元件尺寸到货实测
斜面 | 带保护盖钮子开关 | 3 | 参数化占位 | P40 | 立创 C1788492 / 保护盖淘宝 | 主机 / 高压 / 屏幕；M6 螺纹套，保护盖买 6 mm 孔款
斜面 | Ø16 指示灯 | 3 | 参数化占位 | P41 | 用户自购 | 12 V，灯头外径 19.5，开孔 Ø16，绿/红/黄；红、黄直挂被控 12 V 支路，绿灯经 MOSFET 指示 Pi 的 5 V（立创只有 24 V 款）
斜面 | 60 mm 行程直滑推子 | 2 | 参数化占位 | P48 | 立创 | Bourns PTA6043-2015DPB103（C17555413，线性 10k）；推子帽淘宝
机内 | 腔体喇叭 3 W 4 Ω（5151 款） | 2 | 参数化占位 |  | 淘宝（第二批自购） | 立体声：底层左右前角，出声面贴下层与甲板层 Y 梁内侧朝外（x 20 / 300）；不用支架，耳朵朝上下 M3 + 锤头螺母锁两根 Y 梁内侧槽；从下巴托侧板喇叭网出声；PAM8403 两路
面板 | CZN-15E 驻极体麦克风（约 Ø10×7） | 1 | 参数化占位 | P36 | 已有 | 用途待定（2026-10-20 用户确认实物是麦克风，不是蜂鸣器）；整机唯一的蜂鸣器装在盖革板上（咔哒声 + ESP32 GPIO18 报警），型号待盖革板调研后加进立创补单
斜面 | 上下叠放双口 USB 面板座（带耳延长线） | 1 | 按实测建模 | P52 | 淘宝 | 2026-10-26 实测：口部 15.5×14.5、本体 23×19.2×深 30、耳孔距 30（M3）；斜面左缺口 x 28、u 10，开 15.8×14.8 方孔；一口直连 Pi USB3，一口接 Hub；斜面电路板左缺口要切高到 u 20.5（png/28）
机内 | 一分四 USB2.0 Hub 模块（DC 5 V 输入） | 1 | 按实测建模 |  | 淘宝（用户已找到） | 实测 66×50×16，M3 ×4 孔距 58×44；电脑层 Pi 前面 x 87–153、y 40–90，M3×6 铜柱，孔 (91/149 | 43/87) 自钻；Pi USB2.0 口 2 → 前面 USB 口、Pico、键盘座、备用；5 V 来自 PCB-3 主机电子保险 B
面板 | 光线/人体感应 | 1 | 暂无 |  | 淘宝 / 立创 | BH1750 模块（GY-302）+ LD2410B（立创 C5183132）
主控 | DS3231 RTC 模块 | 1 | 参数化（用户实测外形） | P54 | 淘宝 | 板 38×22，带弯针总长 45，总高 14；ESP32-S3 I²C，地址 0x68；6P 弯针竖插在 ESP32 底板 J_RTC (125 | 142)，模块顶约 z 149
键盘 | X1 Tablet 三代磁吸键盘 | 1 | 参数化占位 | P47 | 已有 | 宽 300 已量；深度、厚度仍为估计
键盘 | POGO 触点小板 01AY247 + 原装排线 | 1 | 暂无（按孔位） |  | 淘宝/拆机 | 实测板厚连触点 3.7；排线和小板连成一体约 13 cm，宽 20、扭着走占约 45；从键盘座背盖下沿出线口出来接下巴托底板上的 KBD-ADAPT
键盘 | 磁吸键盘座（仿 X1 Tablet 底边） | 1 | 按实测建模（部分 T） | P53 | 嘉立创 3D 打印尼龙 MJF（不用铝：POGO 触点会短路） | 槽、触点孔、螺丝孔、限位孔、磁铁开孔与屏幕面磁铁槽按实测；总厚 8.9、高 15；长 320（2026-10-22 由 300 改）；随斜面后仰 33°，两端各 M3 ×2 锁下巴托侧板、顶部 3 舌片由斜面下沿 M3 沉头锁；背面加背盖（1.5 厚，M2 ×4，下沿 46 宽出线口）；POGO 小板、磁铁条拆机装入
键盘 | 键盘转接小板 KBD-ADAPT D1 | 1 | STEP |  | 嘉立创打板 | 40×30，四角 M2；转 180° 排线座朝前，M2×5 铜柱立在下巴托底板 x 170–210、y −36…−6；XH-4 出 USB 接 Hub
机械 | 铝合金脚垫 | 4 | 参数化 |  | 淘宝 | 高 6 + 1 mm 垫圈，M6 螺孔；M6×16 顶丝穿底板四角 Ø6.5 孔拧进立柱底端（立柱底端已攻 M6）；模型按 6 算键盘连接条离桌面高度，换高度要重算
机械 | 斜面电路板固定件（前壳斜面没开孔，粘接） | 1 套 | 参数化（铜柱） |  | 自备 / 淘宝 | M3×6 六角铜柱 ×2 + M3×5 螺丝 ×2 + M3 平垫片 ×2 + AB 胶（慢干）；铜柱拧在板上沿两孔，垫片粘斜面内表面（先打毛喷粉），见装配说明第 7 节（2026-10-28）
后面板 | 60x15 风扇 | 0 | 真实模型 | P24 | 不买 | 2026-10-20 用户决定不装；后面板原 Ø56 风扇孔留作通风孔
主控 | 40x10 风扇 Noctua NF-A4x10 5V（Orange Pi 4 直吹） | 1 | 真实模型 | P25 | 淘宝（用户选定） | 配散热片装在 RK3399 上方；5V 款，经 Pi 旁的洞洞小板（S8050 低边开关）接 Pi 排针 2/6/18 脚，温控启停
甲板 | SMA 穿墙母座 | 1 | 真实模型（曲面） | P23 | 随 ESP32-S3 开发板 | ESP32-S3 自带 IPEX→SMA 穿墙线；装甲板 (120 | 187) Ø6.5，螺纹朝上；原 IEC 小板的 2 个 SMA 孔取消（射频预留不要了，2026-10-26）
后面板 | IEC C14 三合一电源座 AC-14-F12 | 1 | 参数化（按商品图纸） | P46 | 淘宝（用户选定） | 内置双保险丝（L、N 各一，5×20 T3.15A）+ 双极开关；开孔 28×60，耳孔距 40（M3）；开孔中心 x 276、z 54；面板后约 35.4，离市电防护罩 3.5
机械 | 2020 欧标型材 | 若干 | 参数化占位 | P17 | 淘宝 | 截面简化
机械 | 2020 角码 | 8 | 真实模型 | P18 | 淘宝
机械 | M4 T 螺母 | 若干 | 真实模型 | P19 | 淘宝
机械 | M3 六角铜柱 | 若干 | 参数化占位 | P20 | 淘宝 | Dock 需 M2.5
机械 | EL 屏托架 | 2 | 参数化占位 | P26 | 自制 | 2 mm 铝板 Z 形；屏用 Ø3.5 孔 M3 锁到托架，托架 M4 锁到立柱
机械 | 前壳（前面板 + 斜面）/ 下巴托（底板 + 侧板）/ 层板 / 防护罩 | - | 装配内参数化 |  | 前壳、下巴托：嘉立创钣金 2 mm 铝；层板电木；观察窗亚克力 1.5 ×3（不做市电 / 高压防护罩） | 前壳 324 宽、折 33°；下巴托侧板在机架外侧锁型材（见架构文档 5.3）；层板（甲板、电脑层、顶板、底板）为橘红色电木 4 mm，见 frame_spec.py 与 png/15
