huatanshaonian/EL-center/MIS-01装配说明.md

# MIS-01 装配说明（简版，2026-10-22；2026-10-26 按零件实测更新）

按模型 `assembly.py` 的布置写，坐标单位 mm（X 向右、Y 由前向后、Z 向上，框架前沿 Y = 0）。细节以这几份为准：接线看接线方案页和 `MIS-01整机架构.md`，上电看 `el_driver/上电测试清单.txt`，外壳下单看 `外壳加工/下单说明.txt`。图：`png/22_exploded_*`（爆炸图）、`png/26_chin_*`（下巴）、`png/20_front_panel.png`（前面板）。

**原则**：从下往上、从里往外装；前壳和下巴托最后装，因为它们挡住手。每装一层，先把这层的线插好、捆好，留出往上走的余量。

## 0. 先准备

- 加工件：前壳、下巴托、IEC 小板（嘉立创钣金，2 mm 铝）；键盘座 + 背盖（嘉立创 3D 打印尼龙 MJF；7 个螺丝孔先用烙铁压 M3×4 热熔铜螺母，背盖用 4 颗 M2×6 自攻）；4 块电木层板（`procurement/电木隔板_DXF/`）。喇叭不用支架（5151 耳朵直接锁 Y 梁内侧槽）。
- 自己钻的孔（孔位、离最近孔阵孔的偏移见 `png/27_drill_map.png`；离孔阵孔中心要 ≥ 4 mm，别钻穿连成缝）：层板上不在孔阵上的板孔（6E2 板 4 个、盖革主板后 2 个、夹子板右 1 个、XL6009 2 个、甲板 SMA 天线座 Ø6.5、IV-18 板 (148, 8)、Orange Pi、Dock、USB Hub 各 4 个）；电脑层板上 PMOD 过线孔 Ø25（png/27 的 2-13，圆心就是一个孔阵孔，拿它当导孔，阶梯钻或开孔器）和 EL 接口板 4 个孔阵孔（2-14～2-17）上面锪 90° 沉头；顶板上原来给 EL 接口板留的 4 个 M3 孔不用了，空着；底板上 LRS-200 4 个孔阵孔扩 Ø4.5、四角脚垫 Ø6.5 ×4、PAM8403 2 个。先钻孔再装板，别装好再钻。
- 紧固件：M4 螺丝 + 2020 弹片 T 螺母（型材上所有东西都用它）；M3 铜柱、螺丝；M2.5 铜柱（Pi、Dock）；M2×5 铜柱 ×4（键盘转接小板）；M6×16 顶丝 ×4（脚垫）。

## 1. 机架

1. 2020 型材：4 根立柱 420，前后上下 4 根 X 梁 280，左右 4 层 Y 梁 180（底、甲板层 z 70–90、电脑层、顶）。甲板层和电脑层的 Y 梁端头加角码。
2. 底板（电木 4 mm）垫在最下层型材下面。四个铝脚垫（高 6 + 1 mm 垫圈）装在四根立柱正下方：M6×16 顶丝穿过底板四角 Ø6.5 孔拧进立柱底端的 M6 螺纹（已请卖家攻好），脚垫拧在顶丝下端，滴螺纹胶。
3. **T 螺母要先塞**：之后要锁东西的槽里先放够 T 螺母，包括立柱外侧、下层和甲板层 Y 梁外侧、下层和甲板层 Y 梁内侧（左右各 2 颗 M3 锤头螺母锁喇叭，y 约 47）、前下横梁正面、右后立柱、后下横梁。装好横梁后有些槽就塞不进去了。

## 2. 下舱（底板上，z 0–90）

1. LRS-200-24 靠后放（x 22.5–237.5、y 82.5–197.5），端子在右端；底面 4 颗 M4×6（内六角或盘头，伸进壳内不能超过 3 mm）锁进底板扩成 Ø4.5 的孔阵孔 (55/205, 115/165)；侧面 115/230 V 开关拨到 230 V。
2. 市电端子罩不做（2026-11-02 用户定）：LRS-200 输入端子开盖调试时是裸露的 220 V，先拔 IEC 电源线再动手。
3. 两只 5151 腔体喇叭：出声面朝外贴在下层和甲板层 Y 梁内侧，耳朵朝上下，上下各 1 颗 M3×8 锁进两根 Y 梁内侧槽里预先塞好的 M3 锤头螺母（喇叭占左 y 22–73、右 y 24–75，本体 z 20–70）。
4. PAM8403 功放模块（24×15.5）放底板前部 x 150–174、y 30–45.5，右侧两孔 M3×3 尼龙柱锁底板 (171, 33)(171, 42.5)；3.5 音频座朝左。
5. PCB-3 电源板：先插好两个 NID100（插排母、扎带捆紧，扎带头拧到侧面），再元件朝下倒挂在甲板底下（M3×10 铜柱）。**先接好 LRS → J_24V 的线再挂上去**，挂好后很难够到。

## 3. 背面 IEC 小板 + 保护地

1. IEC 小板（右下角 110×110）：装 IEC C14 三合一座（M3 耳孔），再用 M4 锁右后立柱和后下横梁。（SMA 不装这里了，改装甲板，见第 4 节。）
2. 保护地：IEC 地脚 → 机架总接地点（M4 + 外齿垫圈，咬穿型材氧化膜）→ 黄绿线分别接 LRS-200 FG 端子、IEC 小板、前壳、下巴托（各零件标了接地孔，孔背面不涂层或刮掉）。装侧板 / 背板的话也要接。
3. 市电线：IEC → LRS-200 L / N / FG，端子螺丝拧紧，线头不露铜（没有端子罩）。

## 4. 甲板层（甲板面 z 94）

装之前先把甲板翻过来，装好下面的 PCB-3（第 2 步）。

1. 辉光驱动板（x 20–170、y 40–120，M3×10 铜柱）→ 插 170 V 高压小板 → 6 块 IN-14 小板插在前沿排母上（各 1 颗 M3 锁住）→ 插 IN-14 管。IN-14 小板背面引脚剪到 ≤ 2 mm（下面是 IV-18 玻壳）。
2. IV-18 板（x 22–152、y 3–40）：1 mm 尼龙垫片坐在甲板上，板底焊脚剪平 ≤ 0.8 mm；管子装在板上，用扎带固定。
3. XL6009（43×25，长边前后放，x 178–203、y 55–98；对角两孔 (181, 61)(200, 92)，M3×5 尼龙柱）。
4. 6E2 板（x 210–300、y 15–105，M3×6）→ 管座 → 6E2 ×2（250 V，最后装管）。
5. 盖革：夹子长条板（3 mm 尼龙柱）→ J305 夹上；盖革主板（x 180–240、y 110–180，M3×6）。
6. ESP32 底板（x 40–150、y 120–170，M3×6）→ 插开发板 → DS3231 竖插。
7. 天线：开发板自带的 IPEX→SMA 穿墙线（20 cm）从 U.FL 经后走线孔（x 135–185、y 176–190）下到甲板底，SMA 座从下往上穿甲板 (120, 187) 的 Ø6.5 孔，上面拧螺母、装 15 cm 棒状天线（竖着顶到约 z 256，离电脑层板 4 mm；碰的话往后折 90°）。

## 5. 电脑层（层板顶 z 264；Pi、Dock 位置还是暂定）

1. Orange Pi 4（x 70–161、y 114–170，网口朝左，**M2.5×25 铜柱**架高）：排针在板子背面朝下，先把杜邦线插好再装上去；贴 RK3399 散热片，风扇用打印支架架在上面往下吹。
2. Tang 20K Dock（x 170–265、y 99–172，M2.5×6）。
3. 两块 HDMI 小板分别插到 Pi、Dock 的 HDMI 口，20 cm 同向排线在上方拱起来连接。
4. USB Hub（66×50，Pi 前面 x 87–153、y 40–90，M3×6 铜柱，四孔 (91/149, 43/87) 自钻）。
5. EL 接口板吊在电脑层板下面、屏幕正后方（元件朝上，J_EL 在左、P1–P3 在右；2026-10-28 定）：4 颗 M3×8 沉头从层板上面穿孔阵孔（png/27 的 2-14～2-17），下面拧 M3×30 母母铜柱，板子用 M3×6 盘头锁在铜柱上。**要在装 Pi、Dock、Hub 之前装**（其中 3 颗沉头在它们下面）。装之前先把线插好：DF11 屏线（20 cm）插 J_EL，从板左边外面往前走到屏 CN5，多出来的盘一圈扎好；3 根 PMOD 线插 P1–P3，从 Ø25 过线孔穿上去，等 Dock 装好再插 J5 / J6 / J14（1 脚对 1 脚）；J_PWR、J_PF、J_LAMP 三根自己压的线也先插好再吊上去。

## 6. EL 屏

屏用 Ø3.5 孔 M3 锁到两块 Z 形铝托架，托架用 M4 锁左右前立柱（托架上沿顶到前上横梁下面）。屏的线先接好。

## 7. 前壳（前面板 + 斜面一块）

1. 先在前壳上装好：三块透明亚克力窗（1.5 mm，`外壳加工/亚克力/`，位置见 png/34；贴在面板背面，只在四周实心边点 UV 胶或 ≤ 0.2 mm 薄双面胶，不用整片 VHB——背后甲板、盖革夹子板前沿离面板只有 2 mm；盖革窗那块必须装），85C1 表头、感应窗。
2. 斜面装面板件：模式开关、上下叠放双口 USB（左缺口，口部凸出面板的部分先削平）、3 个钮子（不装保护盖）、3 个指示灯、6 个方键；编码器、推子焊在斜面电路板上。
   **钣金到货先逐个试装**：喷粉单边约 0.06–0.1 mm，原来只比零件大 0.1–0.2 的孔可能插不进——编码器 Ø7.2（套筒 Ø7）、模式开关 Ø10.1（M10）、钮子 Ø6.2（M6）、指示灯 / 方键 Ø16.2（M16）、推子槽宽 2（拨杆 1.2）。插不进就用同号钻头手捻扩孔口，扩完补一点漆。
   USB 双口件的线尾朝后下方，离下巴托后翻边只有约 15 mm，装的时候线一出来就往上弯，从斜面电路板和后翻边之间往上走。
3. 斜面电路板（Pico 在背面，USB 口朝上沿；焊元件前先按 `png/28_slant_pcb_cut.png` 把左缺口切高 3.5）：插好 Micro-USB **90° 弯头线**（往插头宽边那侧出线，线朝机内），再装到斜面背后。
   **固定（前壳斜面没开安装孔，用粘的）**：电路板上沿两个 M3 孔（板上 (12,68)、(142,72)，在斜面 (29,68)、(159,72)）各拧一根 M3×6 铜柱，螺丝 M3×5 从板背面拧入，铜柱另一头套一个 M3 平垫片。斜面内表面对应位置用砂纸打毛（去掉喷粉的光面），擦干净。垫片上抹 AB 胶，把板子按正常位置装上：编码器轴插进 Ø7.2 孔、推子拨杆插进槽，板子自己就对准了。夹住或压重物，等胶完全固化（按胶的说明，一般 24 h）再装别的。下沿两个板孔 (73,8)、(142,8) 不用：背面螺丝头会压到 J_K1、J_K6 插座。
4. 前壳整体靠上去：前面板 M4 锁左右前立柱和前上横梁（共 8 颗）。

## 8. 下巴托 + 键盘座

1. 先在下巴托底板上装键盘转接小板 KBD-ADAPT（4 颗 M2×5 铜柱，板转 180°：排线座朝前），接好到 Hub 的 USB-A 转 XH 线。
2. 下巴托从下面套上：两侧板贴在机架外侧，每侧 6 颗 M4 锁前立柱和下层、甲板层 Y 梁；底板后翻边 3 颗 M4（x 60 / 160 / 225）锁前下横梁。底板离桌面约 2 mm。
3. 斜面两侧翻边的 4 个压铆螺母，从侧板外面用 M3 沉头锁住。
4. 键盘座：到货先用手钻把小孔通一遍（MJF 小孔会缩小或堵）：4 个自攻凸台底孔 Ø1.3（贯穿到槽面）、两端块背面 4 个 Ø1.7（深 6）；再压 7 个 M3 热熔铜螺母。背面先装 POGO 触点小板和磁铁条（压 1 mm 铁皮、自攻锁住），原装排线从背盖下沿的出线口（46 宽）穿出，盖背盖（4 颗 M2 自攻）；排线插到 KBD-ADAPT。然后从下面推到斜面下沿：两端各 2 颗 M3 沉头从侧板外面锁进去，斜面下沿正面打 3 颗黑色 M3 沉头锁进舌片。

## 9. 收尾

1. 顶板盖上，M4 锁顶层型材（顶板上原来给 EL 接口板留的 4 个 M3 孔空着）。
2. 可选：全高侧板 ×2、整块背板，各用 M4 锁型材外侧。装不装都不影响机器，装上后靠侧板和背板上的通风孔散热。
3. 上电前按 `el_driver/上电测试清单.txt` 逐项查，尤其是三路高压（170 V、250 V、约 400 V）和保护地通断。

## 还没定 / 没建模（装之前确认）

- 层板已做好，手钻孔位见 `png/27_drill_map.png`（`fig_drill_map.py`）；EL 接口板吊在电脑层板下、屏幕后面（2026-10-28 定，png/33）；Hub、XL6009、PAM8403 已按实测尺寸放好（2026-10-26），风扇支架还是估计。
- 键盘座、下巴托按铝脚垫 6 mm 算：键盘连接条最低点离桌面约 0.2 mm。换脚垫高度要重算（`assembly_panel.FEET_H`、`SLANT_EXT`）。
- 麦克风阵列型号未定；线束没建模，走线时注意别压在高压板上，高压线用硅胶高压线。
