huatanshaonian/EL-center/fpga/el_test/使用说明.txt

MIS-01 EL 屏测试时序程序（Tang Primer 20K + Dock）  使用说明
====================================================================
版本：v0.2（2026-10-19）：模块移到 ../common/rtl；可用开源工具链编译；LED 约束改 LVCMOS25；扫描时序改为预取取数
用途：面包板实验 3（动态波形）、实验 4（首次点屏）。输出 LJ64K052 完整扫描时序和 8 种测试图案，
      并按规定顺序控制 OE_N、VD_ON_N。
状态：已通过电脑仿真；2026-10-20 已在实物上烧录运行，按键、LED、开关机顺序正常（见第 6 节）；
      CN5 端波形还没用示波器测过。

--------------------------------------------------------------------
1. 时序参数（设计笔记 §8.3）
--------------------------------------------------------------------
  内部时钟 54 MHz（27 MHz 晶振经 PLL ×2）
  CP2      5.4 MHz，高/低各 92.6 ns；每行 160 个
  CP1      高 148 ns；周期 69.44 µs
  帧       240 行、无垂直空白，60.0 Hz
  CP1↓ → 首个 CP2↑ 148 ns，→ 首个 CP2↓ 241 ns
  数据     在 CP2↑ 时更换；对 CP2↓ 的建立/保持各 92.6 ns
  S        在锁存第 0 行的那次 CP1↓ 前后为高：建立 444 ns、保持 74 ns

--------------------------------------------------------------------
2. 文件
--------------------------------------------------------------------
  el_test.gprj                    高云工程文件（可选：用 Gowin EDA 打开）
  impl/project_process_config.json 高云工程设置（与 Sipeed 官方 RGB 屏例程相同：SSPI 脚当普通 IO 用）
  src/el_test_top.v               顶层，只负责连线
  src/el_test.cst                 引脚约束（开源工具链与高云 EDA 通用）
  src/el_test.sdc                 时钟约束（高云 EDA 用）
  ../common/rtl/                  与 HDMI 程序共用的模块：el_pll（27→54 MHz）、reset_gen、input_sync、key_press、
                                  el_scan_timing（时序）、el_pattern（图案）、el_power_seq（上下电）、led_status
  sim/                            仿真测试（只用于验证，不进 git）

--------------------------------------------------------------------
3. 编译与烧录
--------------------------------------------------------------------
  准备
    - Gowin Programmer（已下载在 D:\gowin）。高云 EDA 可以不装：我用开源工具链编好 .fs 给你。
    - Dock 板上的 1 号拨码开关拨下，否则核心板不工作，且 LED0、LED1 常亮（Sipeed Wiki）。
      这条只对 v3713 及更早的 Dock 成立；v3714 上 1 号拨码改成普通 IO，RECONFIG_N 改接到按键 S4。
    - USB-C 线接 Dock 的“USB-JTAG&UART”口（板载 BL702 下载器，不用另买）。
    - 不要插 40P RGB 屏排线（J7）和麦克风阵列排线（J15），它们和 J5/J6/J14 共用 FPGA 引脚。

  编译（任选其一）
    A. 开源工具链（默认，已验证可编译）：在 WSL 里运行
         bash /mnt/e/modeling/MIS-01/fpga/build.sh el_test
       产物：build/el_test_top.fs
    B. 高云 EDA：File → Open Project → el_test.gprj → Run All，产物 impl/pnr/el_test.fs。
       （2026-10-20 用 V1.9.11.03 教育版 gw_sh 编译通过，唯一警告是 el_pattern 被并入上层，属正常；
        该 .fs 在实物上 SRAM 加载正常，可作为排查烧录问题时的对照。）
       如果报某个引脚是“复用脚/已被占用”（dual-purpose pin），在 Project → Configuration → Place & Route →
       Dual-Purpose Pin 里勾选对应项，但不要勾 JTAG：勾了以后下载器会认不出 FPGA。

  烧录（测试阶段用 SRAM，断电即丢，最安全）
    1. 打开 Gowin Programmer → Scan Device（或 USB Cable Setting 里选 USB Debugger A）。
    2. 认出 GW2A-18C 后，Operation 选 “SRAM Program”，File 选上面生成的 .fs。
    3. Program/Configure。完成后程序立即运行，4 个状态灯应全灭。
       成功时 Programmer 显示 Status Code 0x00006020。开源工具链的 .fs 若没有开头的 // 注释头，会进度走完后报
       "Error found!" 且加载不完成；build.sh 已自动补头（scripts/fs_header.py）。
       命令行：programmer_cli.exe --device GW2A-18C --run 2 --fsFile <.fs 完整路径>
    4. 断电后 FPGA 回到空白状态：所有脚弱上拉，OE_N 为高，屏信号输出保持关闭。
    确认程序没问题后，才考虑烧进 Flash（Operation 选 exFlash 相关项）。

--------------------------------------------------------------------
4. 按键与状态灯
--------------------------------------------------------------------
  按键（2026-10-20 实测：T10 = 板上丝印 S0，T3 = 丝印 S1）
    RUN（T10，S0）：OFF 时按 = 开机；运行中按 = 关机；故障停机后按 = 清除故障
    PAT（T3， S1）：切换下一个测试图案，0→7 循环；上电默认 0（全黑）
    S4 不要按：v3714 上它接 RECONFIG_N，会丢掉 SRAM 里的程序、改从 Flash 加载出厂程序。

  状态灯（LED0..LED3 = 引脚 L16、L14、N14、N16，在 2.5V bank，按 LVCMOS25 约束；LED4/LED5 不用）
  板上丝印编号与这里相反：LED0、LED1、LED2、LED3 = 丝印 5、4、3、2（实测）。
    LED0 亮 = OE 已使能（OE_N=0）
    LED1 亮 = 正在扫描
    LED2 亮 = VD_ON_N=0。面包板阶段 VD 由人工开关，这盏灯亮表示“现在可以开 VD”
    LED3 快闪（4 Hz）= eFuse 故障；慢闪（1 Hz）= 发生过 24V 掉电（PFAIL）
    按 PAT 后 1 秒内，LED0..LED2 改为显示图案号（二进制：LED0 = 最低位）
  灯的亮灭和上面说的正好相反时：说明 Dock 的灯是高电平点亮。把 el_test_top.v 里
  LED_ACTIVE_LOW 改成 0 再编译，并告诉我。

  测试图案（按点亮面积从小到大）
    0 全黑
    1 稀疏点（每 16×16 一个点）
    2 边框 + 左上角 32×32 实心方块 + 上下半屏交界（第 240/241 行）横线：查方向、镜像、上下半屏
    3 8×8 棋盘格
    4 每 8 列一条竖线
    5 每 8 行一条横线
    6 4 像素宽竖条、逐行反相：每根数据线每个 CP2 都翻转，测波形最严酷
    7 全亮（电流最大，VD 限流 2.0A 时才用）

--------------------------------------------------------------------
5. 操作顺序（与面包板文档实验 3、4 对应）
--------------------------------------------------------------------
  开机：按 RUN →
    ① OE 使能（LED0 亮），信号全低，等 1 ms
    ② 开始扫描（LED1 亮）
    ③ 稳定扫描 2 整帧（约 33 ms）后，VD_ON_N=0（LED2 亮）
    实验 3：此时 VD 保持关闭，用示波器在 CN5 端测波形，可按 PAT 换图案。
    实验 4：LED2 亮后，再手动打开可调电源的 VD 输出。

  关机：先手动关 VD 输出，等 CN5 端 VD 降到 1V 以下，再按 RUN →
    ① VD_ON_N=1（LED2 灭），扫描继续
    ② 再等 1 秒（T_VD_WAIT，暂定值，PCB 阶段按实测改）
    ③ 扫完当前整帧后停止扫描（LED1 灭）
    ④ OE 禁用（LED0 灭）
    最后再拔 USB 5V（关 VL）。

  保护（面包板阶段这些线悬空，FPGA 内部上拉读作“正常”，不会触发；上 PCB 后才起作用）
    VL_OK 变低     ：立即关 VD、停扫描、禁用 OE
    PFAIL_N 变低   ：立即关 VD，VL 还在就继续扫描，按关机流程走完；LED3 慢闪
    VD/VL_FLT_N 变低：立即关 VD，走完关机流程后停在故障状态，LED3 快闪；故障线恢复后按 RUN 清除

--------------------------------------------------------------------
6. 仿真验证（已通过）
--------------------------------------------------------------------
  运行：在 WSL 里执行  bash /mnt/e/modeling/MIS-01/fpga/el_test/sim/run_sim.sh
  tb_scan_timing  逐条检查 CP2/CP1/S 的宽度、周期、建立/保持、tS12/tS13；
                  每行 160 组、每帧 240 行、帧周期 60 Hz；全部像素与独立参考模型逐个比对；
                  停止时扫完整帧、中止时 2 个时钟内全部输出变低。共 4 帧、825 行。
  tb_power_seq    正常开关机顺序、VD 未降时一直扫描、PFAIL / 故障 / VL 掉电三种保护、
                  不满足条件时不能开机；全程检查“VD 开时必须在扫描且 OE 使能”。
  tb_top          顶层连线、复位状态、按键、LED 极性、开机到关机全过程。
  另外故意改坏两处（首个 CP2 提前、像素位序反了）重跑，测试都能报错，说明检查有效。

  实物验证（2026-10-20，Dock v3714，只接 USB-C，开源工具链编译的 .fs 与高云 EDA 编译的 .fs 各试一次，结果相同）
    - 烧录后 LED 全灭：LED 低电平点亮，与假设一致，LED_ACTIVE_LOW 不用改。
    - PAT（S1）：图案号 1..7 依次显示为 丝印5、4、5+4、3、3+5、4+5、3+4+5，约 1 秒后恢复，二进制正确。
    - RUN（S0）开机：丝印 5、4、3（OE、扫描、VD_ON_N）亮；再按关机：3 先灭，约 1 s 后 5、4 一起灭，顺序正确。

  仿真不能代替的事项
    - 高云工具的实际编译、引脚复用设置、时序报告（第一次编译后把报告给我看）
    - 实物 LED 极性、按键位置
    - CN5 端真实波形（经 245、串阻和线束后）——实验 3 必须用示波器测

--------------------------------------------------------------------
7. 以后要改的参数（el_test_top.v 顶部）
--------------------------------------------------------------------
  VD_WAIT_CYCLES  关 VD 后等多久停扫描，默认 54000000（1 s）；按实测 VD 衰减时间 ×2 改
  SCAN_FRAMES     开 VD 前稳定扫描的整帧数，默认 2
  LED_ACTIVE_LOW  LED 极性
  120 Hz 测试：把 el_scan_timing 的 LINE_TICKS 从 3750 改成 1875（行周期 34.7 µs，仍满足 ≥ 31 µs）
