huatanshaonian/EL-center/png/32_max6921_test_circuit.png

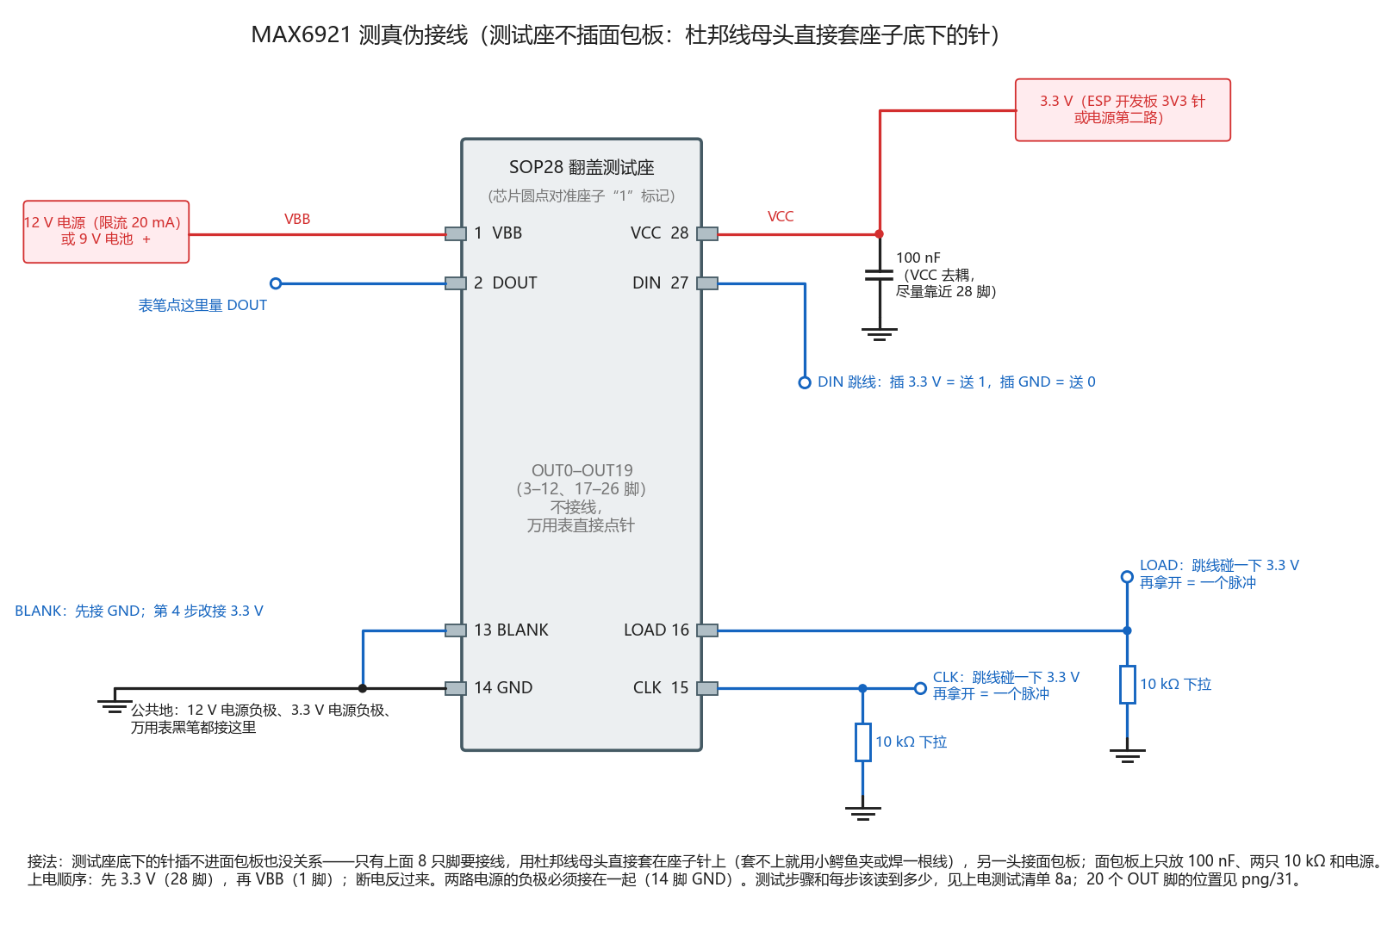
png/32_max6921_test_circuit.png
