huatanshaonian/EL-center/el_driver/GEIGER_D1/sim/bz2_em_fix.cir

bz2_em_fix
.include E:/modeling/MIS-01/el_driver/GEIGER_D1/sim/models.lib
V5 v5s 0 5.0
RV5 v5s v5 0.2
C12 v5 0 47u
C13 v5 0 100n
XU4 0 gm o4 en cv4 mt mt v5 TLC555B params: VRST=1.1
C73 cv4 0 100n
R70 v5 mt 10k
C70 mt 0 100n
R75 o4 qb6 2.2k
R76 qb6 0 10k
Q6 bzn qb6 0 S8050
RLS2 v5 ls2x 42
LLS2 ls2x bzn 3m
D4 bzn v5 D1N4148
R71 bz bzp 1k
R72 bzp 0 100k
R73 bzp en 100k
C71 en 0 1u
C72 bz ac 1u
D3 0 ac D1N4148
R74 ac qb6 1k
VBZ bzd 0 PWL(0 3.3 0.1 3.3 0.100000100 3.3 0.100244141 3.3 0.100244241 0.0 0.100488281 0.0 0.100488381 3.3 0.100732422 3.3 0.100732522 0.0 0.100976563 0.0 0.100976663 3.3 0.101220703 3.3 0.101220803 0.0 0.101464844 0.0 0.101464944 3.3 0.101708984 3.3 0.101709084 0.0 0.101953125 0.0 0.101953225 3.3 0.102197266 3.3 0.102197366 0.0 0.102441406 0.0 0.102441506 3.3 0.102685547 3.3 0.102685647 0.0 0.102929688 0.0 0.102929788 3.3 0.103173828 3.3 0.103173928 0.0 0.103417969 0.0 0.103418069 3.3 0.103662109 3.3 0.103662209 0.0 0.103906250 0.0 0.103906350 3.3 0.104150391 3.3 0.104150491 0.0 0.104394531 0.0 0.104394631 3.3 0.104638672 3.3 0.104638772 0.0 0.104882813 0.0 0.104882913 3.3 0.105126953 3.3 0.105127053 0.0 0.105371094 0.0 0.105371194 3.3 0.105615234 3.3 0.105615334 0.0 0.105859375 0.0 0.105859475 3.3 0.106103516 3.3 0.106103616 0.0 0.106347656 0.0 0.106347756 3.3 0.106591797 3.3 0.106591897 0.0 0.106835938 0.0 0.106836038 3.3 0.107080078 3.3 0.107080178 0.0 0.107324219 0.0 0.107324319 3.3 0.107568359 3.3 0.107568459 0.0 0.107812500 0.0 0.107812600 3.3 0.108056641 3.3 0.108056741 0.0 0.108300781 0.0 0.108300881 3.3 0.108544922 3.3 0.108545022 0.0 0.108789063 0.0 0.108789163 3.3 0.109033203 3.3 0.109033303 0.0 0.109277344 0.0 0.109277444 3.3 0.109521484 3.3 0.109521584 0.0 0.109765625 0.0 0.109765725 3.3 0.110009766 3.3 0.110009866 0.0 0.110253906 0.0 0.110254006 3.3 0.110498047 3.3 0.110498147 0.0 0.110742188 0.0 0.110742288 3.3 0.110986328 3.3 0.110986428 0.0 0.111230469 0.0 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
SGM gm 0 gmctl 0 SWX
.save v(bz) v(bzp) v(en) v(gm) v(o4) v(qb6) v(bzn) v(ac) i(vbz)
.ic v(en)=0 v(mt)=0 v(cv4)=0
.options method=gear reltol=1e-4 abstol=1e-11 vntol=1e-5 itl4=50
.end
