huatanshaonian/EL-center/el_driver/GEIGER_D1/sim/bz2_pz_fix_alarm.cir

bz2_pz_fix_alarm
.include E:/modeling/MIS-01/el_driver/GEIGER_D1/sim/models.lib
V5 v5s 0 5.0
RV5 v5s v5 0.2
C12 v5 0 47u
C13 v5 0 100n
XU4 0 gm o4 en cv4 mt mt v5 TLC555B params: VRST=1.1
C73 cv4 0 100n
R70 v5 mt 10k
C70 mt 0 100n
R75 o4 qb6 2.2k
R76 qb6 0 10k
Q6 bzn qb6 0 S8050
CLS0 v5 bzn 16n
LLSm v5 lsm1 0.99
CLSm lsm1 lsm2 1.6n
RLSm lsm2 lsm2x 1244
VLSm lsm2x bzn 0
R77 v5 bzn 1k
R71 bz bzp 1k
R72 bzp 0 100k
R73 bzp en 100k
C71 en 0 1u
C72 bz ac 1u
D3 0 ac D1N4148
R74 ac qb6 1k
VBZ bzd 0 PWL(0 3.3 0.1 3.3 0.100000100 3.3 0.100125000 3.3 0.100125100 0.0 0.100250000 0.0 0.100250100 3.3 0.100375000 3.3 0.100375100 0.0 0.100500000 0.0 0.100500100 3.3 0.100625000 3.3 0.100625100 0.0 0.100750000 0.0 0.100750100 3.3 0.100875000 3.3 0.100875100 0.0 0.101000000 0.0 0.101000100 3.3 0.101125000 3.3 0.101125100 0.0 0.101250000 0.0 0.101250100 3.3 0.101375000 3.3 0.101375100 0.0 0.101500000 0.0 0.101500100 3.3 0.101625000 3.3 0.101625100 0.0 0.101750000 0.0 0.101750100 3.3 0.101875000 3.3 0.101875100 0.0 0.102000000 0.0 0.102000100 3.3 0.102125000 3.3 0.102125100 0.0 0.102250000 0.0 0.102250100 3.3 0.102375000 3.3 0.102375100 0.0 0.102500000 0.0 0.102500100 3.3 0.102625000 3.3 0.102625100 0.0 0.102750000 0.0 0.102750100 3.3 0.102875000 3.3 0.102875100 0.0 0.103000000 0.0 0.103000100 3.3 0.103125000 3.3 0.103125100 0.0 0.103250000 0.0 0.103250100 3.3 0.103375000 3.3 0.103375100 0.0 0.103500000 0.0 0.103500100 3.3 0.103625000 3.3 0.103625100 0.0 0.103750000 0.0 0.103750100 3.3 0.103875000 3.3 0.103875100 0.0 0.104000000 0.0 0.104000100 3.3 0.104125000 3.3 0.104125100 0.0 0.104250000 0.0 0.104250100 3.3 0.104375000 3.3 0.104375100 0.0 0.104500000 0.0 0.104500100 3.3 0.104625000 3.3 0.104625100 0.0 0.104750000 0.0 0.104750100 3.3 0.104875000 3.3 0.104875100 0.0 0.105000000 0.0 0.105000100 3.3 0.105125000 3.3 0.105125100 0.0 0.105250000 0.0 0.105250100 3.3 0.105375000 3.3 0.105375100 0.0 0.105500000 0.0 0.105500100 3.3 0.105625000 3.3 0.105625100 0.0 0.105750000 0.0 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
