huatanshaonian/EL-center/el_driver/HV-UNI_D1/sim/step_170_20to0.cir

* HV-UNI D1
.include E:/modeling/MIS-01/el_driver/HV-UNI_D1/sim/models/uc3843a_beh.lib
.include E:/modeling/MIS-01/el_driver/HV-UNI_D1/sim/models/sihf840.lib
.include E:/modeling/MIS-01/el_driver/HV-UNI_D1/sim/models/uf4007.txt
.include E:/modeling/MIS-01/el_driver/HV-UNI_D1/sim/models/misc.lib
VSRC src 0 12
VIIN src src1 0
RSRC src1 vin 0.3
C1 vin c1e 47u
RC1 c1e 0 0.3
C2 vin 0 100n
R23 vin leda 4.7k
D2 leda 0 DLED
R1 vin vcc 10
C3 vcc 0 10u
C4 vcc 0 100n
C5 vref 0 100n
R2 vref rtct 33k
C6 rtct 0 1n
XU1 comp vfb isns rtct 0 drv vcc vref UC3843A
R3 drv gate 22
R4 gate 0 10k
VIL vin l1a 0
L1 l1a l1b 100u
RL1 l1b sw 0.22
CL1 l1a sw 8p
VQD sw qd 0
XQ1 qd gate sns irf840
RS1 sns 0 0.5
VD1 sw d1a 0
XD1 d1a hv D1WRAP
C8 hv c8e 4.7u
RC8 c8e 0 3
C9 hv c9e 100n
RC9 c9e 0 0.03
.subckt D1WRAP a k
D1 a k UF4007
.ends
R7 sns isns 1k
C7 isns 0 1n
R20 ovc isns 1k
R8 hv fb1 470000
R9 fb1 fb2 470k
R10 fb2 vfb 470k
R11 vfb fb3 12k
RV1 fb3 0 9044.78
R12 comp cmp1 47000
C10 cmp1 vfb 1e-07
R13 hv ov1 470k
R14 ov1 ov2 470k
R15 ov2 ovs 470k
R16 ovs ov3 10k
R17 ov3 0 1k
XU2 ovs ovk 0 TL431B
R19 ovb ovk 2.2k
R18 vref ovb 10k
Q2 ovc ovb vref Q2N3906
R21 hv bl1 220k
R22 bl1 0 220k
RLX hv rlx 8500
SLX rlx 0 ctl 0 SWL
VCTL ctl 0 PWL(0 1 0.005 1 0.005001 0 0.065 0 0.065001 1)
.model SWL SW(Ron=0.1 Roff=1e9 Vt=0.5 Vh=0)
.ic v(src1)=12 v(vin)=11.93518 v(c1e)=0.04571963 v(leda)=1.879226 v(vcc)=11.73411 v(vref)=4.99991 v(rtct)=1.358806 v(xu1.uvx)=1
.ic v(xu1.uv)=1 v(xu1.vri)=5 v(xu1.vrj)=5 v(xu1.dx)=1 v(xu1.dd)=1 v(xu1.ea)=2.947208 v(vfb)=2.499886 v(comp)=2.947207
.ic v(xu1.vth)=0.5157358 v(xu1.csx)=0 v(isns)=-0.002700746 v(xu1.cs)=6.014725e-17 v(xu1.qx)=1 v(xu1.q)=1 v(xu1.on)=6.169687e-09 v(xu1.onf)=-2.359256e-06
.ic v(xu1.oi)=0 v(xu1.oj)=0 v(drv)=0.06526884 v(gate)=0.543907 v(l1a)=11.93518 v(l1b)=11.15505 v(sw)=11.14575 v(qd)=11.14575
.ic v(xq1.9)=11.1285 v(xq1.7)=0.6192249 v(xq1.8)=0.009572016 v(sns)=0.00958156 v(xq1.4)=0 v(xq1.5)=10.488 v(xq1.10)=10.50927 v(xq1.11)=10.50927
.ic v(xq1.6)=10.50927 v(d1a)=11.14575 v(hv)=169.9563 v(c8e)=-0.06022361 v(c9e)=-1.610575e-06 v(ovc)=-0.002737292 v(fb1)=114.1375 v(fb2)=58.31868
.ic v(fb3)=1.074419 v(cmp1)=2.944835 v(ov1)=113.7389 v(ov2)=57.52157 v(ovs)=1.304225 v(ov3)=0.1185659 v(xu2.x)=-1.190775 v(xu2.y)=-1.190772
.ic v(ovk)=4.999019 v(ovb)=4.999242 v(bl1)=84.97813
.options method=gear reltol=1e-3 abstol=1e-9 vntol=1e-5 itl4=100 chgtol=1e-14
.end
