huatanshaonian/EL-center/el_driver/HV-UNI_D1/sim/step_250_6to2.cir

* HV-UNI D1
.include E:/modeling/MIS-01/el_driver/HV-UNI_D1/sim/models/uc3843a_beh.lib
.include E:/modeling/MIS-01/el_driver/HV-UNI_D1/sim/models/sihf840.lib
.include E:/modeling/MIS-01/el_driver/HV-UNI_D1/sim/models/uf4007.txt
.include E:/modeling/MIS-01/el_driver/HV-UNI_D1/sim/models/misc.lib
VSRC src 0 12
VIIN src src1 0
RSRC src1 vin 0.3
C1 vin c1e 47u
RC1 c1e 0 0.3
C2 vin 0 100n
R23 vin leda 4.7k
D2 leda 0 DLED
R1 vin vcc 10
C3 vcc 0 10u
C4 vcc 0 100n
C5 vref 0 100n
R2 vref rtct 33k
C6 rtct 0 1n
XU1 comp vfb isns rtct 0 drv vcc vref UC3843A
R3 drv gate 22
R4 gate 0 10k
VIL vin l1a 0
L1 l1a l1b 100u
RL1 l1b sw 0.22
CL1 l1a sw 8p
VQD sw qd 0
XQ1 qd gate sns irf840
RS1 sns 0 0.5
VD1 sw d1a 0
XD1 d1a hv D1WRAP
C8 hv c8e 4.7u
RC8 c8e 0 3
C9 hv c9e 100n
RC9 c9e 0 0.03
.subckt D1WRAP a k
D1 a k UF4007
.ends
R7 sns isns 1k
C7 isns 0 1n
R20 ovc isns 1k
R8 hv fb1 470000
R9 fb1 fb2 470k
R10 fb2 vfb 470k
R11 vfb fb3 12k
RV1 fb3 0 2242.42
R12 comp cmp1 47000
C10 cmp1 vfb 1e-07
R13 hv ov1 470k
R14 ov1 ov2 470k
R15 ov2 ovs 470k
R16 ovs ov3 10k
R17 ov3 0 1k
XU2 ovs ovk 0 TL431B
R19 ovb ovk 2.2k
R18 vref ovb 10k
Q2 ovc ovb vref Q2N3906
R21 hv bl1 220k
R22 bl1 0 220k
RLOAD hv 0 125000
RLX hv rlx 62500
SLX rlx 0 ctl 0 SWL
VCTL ctl 0 PWL(0 1 0.005 1 0.005001 0 0.065 0 0.065001 1)
.model SWL SW(Ron=0.1 Roff=1e9 Vt=0.5 Vh=0)
.ic v(src1)=12 v(vin)=11.9681 v(c1e)=0.02274351 v(leda)=1.879446 v(vcc)=11.77668 v(vref)=4.999932 v(rtct)=2.612748 v(xu1.uvx)=1
.ic v(xu1.uv)=1 v(xu1.vri)=5 v(xu1.vrj)=5 v(xu1.dx)=1 v(xu1.dd)=0.9028205 v(xu1.ea)=2.583594 v(vfb)=2.49991 v(comp)=2.583593
.ic v(xu1.vth)=0.394531 v(xu1.csx)=0 v(isns)=-0.0008493113 v(xu1.cs)=1.145025e-29 v(xu1.qx)=1 v(xu1.q)=0.9028205 v(xu1.on)=0.08429708 v(xu1.onf)=0.1023774
.ic v(xu1.oi)=1.0521 v(xu1.oj)=1.0521 v(drv)=0.9934998 v(gate)=0.5637662 v(l1a)=11.9681 v(l1b)=1.373864 v(sw)=1.371473 v(qd)=1.371473
.ic v(xq1.9)=1.371816 v(xq1.7)=0.4965072 v(xq1.8)=0.01540916 v(sns)=0.01506872 v(xq1.4)=0 v(xq1.5)=0.8757322 v(xq1.10)=0.8753091 v(xq1.11)=0.8753091
.ic v(xq1.6)=0.8753091 v(d1a)=1.371473 v(hv)=249.9256 v(c8e)=-0.02049116 v(c9e)=-5.10795e-07 v(ovc)=-0.0008920529 v(fb1)=167.4504 v(fb2)=84.97514
.ic v(fb3)=0.3936022 v(cmp1)=2.580235 v(ov1)=167.2564 v(ov2)=84.58713 v(ovs)=1.9179 v(ov3)=0.1743546 v(xu2.x)=-0.5770995 v(xu2.y)=-0.5770987
.ic v(ovk)=4.998704 v(ovb)=4.998974 v(bl1)=124.9628
.options method=gear reltol=1e-3 abstol=1e-9 vntol=1e-5 itl4=100 chgtol=1e-14
.end
