huatanshaonian/EL-center/el_driver/HV-UNI_D1/sim/step_250_6to2_new.cir

* HV-UNI D1
.include E:/modeling/MIS-01/el_driver/HV-UNI_D1/sim/models/uc3843a_beh.lib
.include E:/modeling/MIS-01/el_driver/HV-UNI_D1/sim/models/sihf840.lib
.include E:/modeling/MIS-01/el_driver/HV-UNI_D1/sim/models/uf4007.txt
.include E:/modeling/MIS-01/el_driver/HV-UNI_D1/sim/models/misc.lib
VSRC src 0 12
VIIN src src1 0
RSRC src1 vin 0.3
C1 vin c1e 47u
RC1 c1e 0 0.3
C2 vin 0 100n
R23 vin leda 4.7k
D2 leda 0 DLED
R1 vin vcc 10
C3 vcc 0 10u
C4 vcc 0 100n
C5 vref 0 100n
R2 vref rtct 33k
C6 rtct 0 1n
XU1 comp vfb isns rtct 0 drv vcc vref UC3843A
R3 drv gate 22
R4 gate 0 10k
VIL vin l1a 0
L1 l1a l1b 100u
RL1 l1b sw 0.22
CL1 l1a sw 8p
VQD sw qd 0
XQ1 qd gate sns irf840
RS1 sns 0 0.5
VD1 sw d1a 0
XD1 d1a hv D1WRAP
C8 hv c8e 4.7u
RC8 c8e 0 3
C9 hv c9e 100n
RC9 c9e 0 0.03
.subckt D1WRAP a k
D1 a k UF4007
.ends
R7 sns isns 1k
C7 isns 0 1n
R20 ovc isns 1k
R8 hv fb1 470000
R9 fb1 fb2 470k
R10 fb2 vfb 470k
R11 vfb fb3 12k
RV1 fb3 0 2242.42
R12 comp cmp1 680000
C10 cmp1 vfb 2.2e-08
CHF comp vfb 1e-10
R13 hv ov1 470k
R14 ov1 ov2 470k
R15 ov2 ovs 470k
R16 ovs ov3 10k
R17 ov3 0 1k
XU2 ovs ovk 0 TL431B
R19 ovb ovk 2.2k
R18 vref ovb 10k
Q2 ovc ovb vref Q2N3906
R21 hv bl1 220k
R22 bl1 0 220k
RLOAD hv 0 125000
RLX hv rlx 62500
SLX rlx 0 ctl 0 SWL
VCTL ctl 0 PWL(0 1 0.005 1 0.005001 0 0.025 0 0.025001 1)
.model SWL SW(Ron=0.1 Roff=1e9 Vt=0.5 Vh=0)
.ic v(src1)=12 v(vin)=11.97276 v(c1e)=0.02087759 v(leda)=1.879478 v(vcc)=11.78076 v(vref)=4.999932 v(rtct)=2.523852 v(xu1.uvx)=1
.ic v(xu1.uv)=1 v(xu1.vri)=5 v(xu1.vrj)=5 v(xu1.dx)=1 v(xu1.dd)=0.9946086 v(xu1.ea)=2.523405 v(vfb)=2.499898 v(comp)=2.523412
.ic v(xu1.vth)=0.3744708 v(xu1.csx)=0 v(isns)=-0.0009367334 v(xu1.cs)=3.517105e-33 v(xu1.qx)=1 v(xu1.q)=0.9946086 v(xu1.on)=0.005043827 v(xu1.onf)=0.06087759
.ic v(xu1.oi)=0.6258681 v(xu1.oj)=0.6258681 v(drv)=0.604386 v(gate)=0.4468509 v(l1a)=11.97276 v(l1b)=1.448691 v(sw)=1.44838 v(qd)=1.44838
.ic v(xq1.9)=1.449581 v(xq1.7)=0.4222775 v(xq1.8)=0.004343635 v(sns)=0.004242947 v(xq1.4)=0 v(xq1.5)=1.028784 v(xq1.10)=1.027303 v(xq1.11)=1.027303
.ic v(xq1.6)=1.027303 v(d1a)=1.44838 v(hv)=251.0375 v(c8e)=-0.02065811 v(c9e)=-1.386665e-06 v(ovc)=-0.0009583561 v(fb1)=168.1917 v(fb2)=85.34578
.ic v(fb3)=0.3936004 v(cmp1)=3.021062 v(ov1)=168.0005 v(ov2)=84.96347 v(ovs)=1.926433 v(ov3)=0.1751303 v(xu2.x)=-0.5685665 v(xu2.y)=-0.5685654
.ic v(ovk)=4.99867 v(ovb)=4.998934 v(bl1)=125.5188
.options method=gear reltol=1e-3 abstol=1e-9 vntol=1e-5 itl4=100 chgtol=1e-14
.end
