huatanshaonian/EL-center/el_driver/HV-UNI_D1/sim/hr_296_10mA_ideal.cir

* HV-UNI D1
.include E:/modeling/MIS-01/el_driver/HV-UNI_D1/sim/models/uc3843a_beh.lib
.include E:/modeling/MIS-01/el_driver/HV-UNI_D1/sim/models/sihf840.lib
.include E:/modeling/MIS-01/el_driver/HV-UNI_D1/sim/models/uf4007.txt
.include E:/modeling/MIS-01/el_driver/HV-UNI_D1/sim/models/misc.lib
VSRC src 0 12
VIIN src src1 0
RSRC src1 vin 0.3
C1 vin c1e 47u
RC1 c1e 0 0.3
C2 vin 0 100n
R23 vin leda 4.7k
D2 leda 0 DLED
R1 vin vcc 10
C3 vcc 0 10u
C4 vcc 0 100n
C5 vref 0 100n
R2 vref rtct 33k
C6 rtct 0 1n
XU1 comp vfb isns rtct 0 drv vcc vref UC3843A
R3 drv gate 22
R4 gate 0 10k
VIL vin l1a 0
L1 l1a l1b 100u
RL1 l1b sw 0.22
CL1 l1a sw 8p
VQD sw qd 0
XQ1 qd gate sns irf840
RS1 sns 0 0.5
VD1 sw d1a 0
XD1 d1a hv D1WRAP
C8 hv c8e 4.7u
RC8 c8e 0 3
C9 hv c9e 100n
RC9 c9e 0 0.03
.subckt D1WRAP a k
D1 a k UF4007
.ends
R7 sns isns 1k
C7 isns 0 1n
R20 ovc isns 1k
R8 hv fb1 470000
R9 fb1 fb2 470k
R10 fb2 vfb 470k
R11 vfb fb3 12k
RV1 fb3 0 10.2215
R12 comp cmp1 47000
C10 cmp1 vfb 1e-07
R13 hv ov1 470k
R14 ov1 ov2 470k
R15 ov2 ovs 470k
R16 ovs ov3 10k
R17 ov3 0 1k
XU2 ovs ovk 0 TL431B
R19 ovb ovk 2.2k
R18 vref ovb 10k
Q2 ovc ovb vref Q2N3906
R21 hv bl1 220k
R22 bl1 0 220k
RLOAD hv 0 29600
.ic v(src1)=12 v(vin)=11.95111 v(c1e)=0.05015898 v(leda)=1.879333 v(vcc)=11.74145 v(vref)=4.999933 v(rtct)=2.791173 v(xu1.uvx)=1
.ic v(xu1.uv)=1 v(xu1.vri)=5 v(xu1.vrj)=5 v(xu1.dx)=0 v(xu1.dd)=5.190227e-291 v(xu1.ea)=3.030543 v(vfb)=2.499889 v(comp)=3.03054
.ic v(xu1.vth)=0.5435133 v(xu1.csx)=0 v(isns)=-0.003976599 v(xu1.cs)=1.558908e-21 v(xu1.qx)=0 v(xu1.q)=-7.63787e-128 v(xu1.on)=4.563444e-129 v(xu1.onf)=4.900809e-99
.ic v(xu1.oi)=5.01914e-98 v(xu1.oj)=5.01914e-98 v(drv)=-0.03372125 v(gate)=-0.2810104 v(l1a)=11.95111 v(l1b)=27.46341 v(sw)=27.47032 v(qd)=27.47032
.ic v(xq1.9)=27.48201 v(xq1.7)=-0.3199236 v(xq1.8)=-0.009124281 v(sns)=-0.009068138 v(xq1.4)=0 v(xq1.5)=27.81634 v(xq1.10)=27.80193 v(xq1.11)=27.80193
.ic v(xq1.6)=27.80193 v(d1a)=27.47032 v(hv)=295.5973 v(c8e)=-0.03246384 v(c9e)=-2.855416e-05 v(ovc)=-0.003964897 v(fb1)=197.8981 v(fb2)=100.199
.ic v(fb3)=0.002127572 v(cmp1)=3.016378 v(ov1)=197.821 v(ov2)=100.0447 v(ovs)=2.26838 v(ov3)=0.2062163 v(xu2.x)=-0.2266205 v(xu2.y)=-0.2266141
.ic v(ovk)=4.998956 v(ovb)=4.999127 v(bl1)=147.7986
.options method=gear reltol=1e-3 abstol=1e-9 vntol=1e-5 itl4=100 chgtol=1e-14
.end
