huatanshaonian/EL-center/el_driver/HV-UNI_D1/sim/ss_170_8k5_nochf.cir

* HV-UNI D1
.include E:/modeling/MIS-01/el_driver/HV-UNI_D1/sim/models/uc3843a_beh.lib
.include E:/modeling/MIS-01/el_driver/HV-UNI_D1/sim/models/sihf840.lib
.include E:/modeling/MIS-01/el_driver/HV-UNI_D1/sim/models/uf4007.txt
.include E:/modeling/MIS-01/el_driver/HV-UNI_D1/sim/models/misc.lib
VSRC src 0 12
VIIN src src1 0
RSRC src1 vin 0.3
C1 vin c1e 47u
RC1 c1e 0 0.3
C2 vin 0 100n
R23 vin leda 4.7k
D2 leda 0 DLED
R1 vin vcc 10
C3 vcc 0 10u
C4 vcc 0 100n
C5 vref 0 100n
R2 vref rtct 33k
C6 rtct 0 1n
XU1 comp vfb isns rtct 0 drv vcc vref UC3843A
R3 drv gate 22
R4 gate 0 10k
VIL vin l1a 0
L1 l1a l1b 100u
RL1 l1b sw 0.22
CL1 l1a sw 8p
VQD sw qd 0
XQ1 qd gate sns irf840
RS1 sns 0 0.5
VD1 sw d1a 0
XD1 d1a hv D1WRAP
C8 hv c8e 4.7u
RC8 c8e 0 3
C9 hv c9e 100n
RC9 c9e 0 0.03
.subckt D1WRAP a k
D1 a k UF4007
.ends
R7 sns isns 1k
C7 isns 0 1n
R20 ovc isns 1k
R8 hv fb1 470000
R9 fb1 fb2 470k
R10 fb2 vfb 470k
R11 vfb fb3 12k
RV1 fb3 0 9044.78
R12 comp cmp1 680000
C10 cmp1 vfb 2.2e-08
R13 hv ov1 470k
R14 ov1 ov2 470k
R15 ov2 ovs 470k
R16 ovs ov3 10k
R17 ov3 0 1k
XU2 ovs ovk 0 TL431B
R19 ovb ovk 2.2k
R18 vref ovb 10k
Q2 ovc ovb vref Q2N3906
R21 hv bl1 220k
R22 bl1 0 220k
RLOAD hv 0 8500
.ic v(src1)=12 v(vin)=11.94136 v(c1e)=0.04534026 v(leda)=1.879267 v(vcc)=11.73461 v(vref)=4.999931 v(rtct)=2.452931 v(xu1.uvx)=1
.ic v(xu1.uv)=1 v(xu1.vri)=5 v(xu1.vrj)=5 v(xu1.dx)=1 v(xu1.dd)=1.004475 v(xu1.ea)=2.895709 v(vfb)=2.498981 v(comp)=2.895712
.ic v(xu1.vth)=0.4985706 v(xu1.csx)=0 v(isns)=-0.001453245 v(xu1.cs)=1.750673e-20 v(xu1.qx)=1 v(xu1.q)=1.004475 v(xu1.on)=0 v(xu1.onf)=0.02979161
.ic v(xu1.oi)=0.3049055 v(xu1.oj)=0.3049055 v(drv)=0.3533228 v(gate)=0.7083832 v(l1a)=11.94136 v(l1b)=1.545342 v(sw)=1.54027 v(qd)=1.54027
.ic v(xq1.9)=1.52823 v(xq1.7)=0.7643603 v(xq1.8)=0.003319556 v(sns)=0.003343877 v(xq1.4)=0 v(xq1.5)=0.749021 v(xq1.10)=0.7638698 v(xq1.11)=0.7638698
.ic v(xq1.6)=0.7638698 v(d1a)=1.54027 v(hv)=170.3117 v(c8e)=-0.06080746 v(c9e)=-1.010312e-05 v(ovc)=-0.001475208 v(fb1)=114.3741 v(fb2)=58.43655
.ic v(fb3)=1.07403 v(cmp1)=3.06248 v(ov1)=113.9768 v(ov2)=57.64186 v(ovs)=1.306952 v(ov3)=0.1188139 v(xu2.x)=-1.188048 v(xu2.y)=-1.188044
.ic v(ovk)=4.998818 v(ovb)=4.999071 v(bl1)=85.15584
.options method=gear reltol=1e-3 abstol=1e-9 vntol=1e-5 itl4=100 chgtol=1e-14
.end
