huatanshaonian/EL-center/el_driver/HV-UNI_D1/sim/ss_170_8k5_pcb_new.cir

* HV-UNI D1
.include E:/modeling/MIS-01/el_driver/HV-UNI_D1/sim/models/uc3843a_beh.lib
.include E:/modeling/MIS-01/el_driver/HV-UNI_D1/sim/models/sihf840.lib
.include E:/modeling/MIS-01/el_driver/HV-UNI_D1/sim/models/uf4007.txt
.include E:/modeling/MIS-01/el_driver/HV-UNI_D1/sim/models/misc.lib
VSRC src 0 12
VIIN src src1 0
RSRC src1 vin 0.3
C1 vin c1e 47u
RC1 c1e 0 0.3
C2 vin 0 100n
R23 vin leda 4.7k
D2 leda 0 DLED
R1 vin vcc 10
C3 vcc 0 10u
C4 vcc 0 100n
C5 vref 0 100n
R2 vref rtct 33k
C6 rtct 0 1n
XU1 comp vfb isns rtct 0 drv vcc vref UC3843A
R3 drv gate 22
R4 gate 0 10k
VIL vin l1a 0
L1 l1a l1b 100u
RL1 l1b sw 0.22
CL1 l1a sw 8p
LSW sw swd 9e-09
LD swd qdp 4.5e-09
VQD qdp qd 0
XQ1 qd gate qs irf840
LS qs qsp 7.5e-09
LSRC qsp sns 9e-09
RS1 sns rsm 0.5
LRS rsm 0 1n
VD1 sw d1a 0
XD1 d1a d1k D1WRAP
LHV d1k hv 1.3e-08
C8 hv c8e 4.7u
RC8 c8e c8l 3
LC8 c8l gc 15n
C9 hv c9e 100n
RC9 c9e c9l 0.03
LC9 c9l gc 8n
LGND gc 0 2.2e-08
.subckt D1WRAP a k
D1 a k UF4007
.ends
R7 sns isns 1k
C7 isns 0 1n
R20 ovc isns 1k
R8 hv fb1 470000
R9 fb1 fb2 470k
R10 fb2 vfb 470k
R11 vfb fb3 12k
RV1 fb3 0 9044.78
R12 comp cmp1 680000
C10 cmp1 vfb 2.2e-08
CHF comp vfb 1e-10
R13 hv ov1 470k
R14 ov1 ov2 470k
R15 ov2 ovs 470k
R16 ovs ov3 10k
R17 ov3 0 1k
XU2 ovs ovk 0 TL431B
R19 ovb ovk 2.2k
R18 vref ovb 10k
Q2 ovc ovb vref Q2N3906
R21 hv bl1 220k
R22 bl1 0 220k
RLOAD hv 0 8500
.ic v(src1)=12 v(vin)=11.9372 v(c1e)=0.04414019 v(leda)=1.879239 v(vcc)=11.73238 v(vref)=4.999931 v(rtct)=2.513826 v(xu1.uvx)=1
.ic v(xu1.uv)=1 v(xu1.vri)=5 v(xu1.vrj)=5 v(xu1.dx)=1 v(xu1.dd)=0.9927405 v(xu1.ea)=2.949088 v(vfb)=2.499856 v(comp)=2.949089
.ic v(xu1.vth)=0.5163629 v(xu1.csx)=0 v(isns)=0.0007355397 v(xu1.cs)=2.716721e-21 v(xu1.qx)=1 v(xu1.q)=0.9927405 v(xu1.on)=0.007209019 v(xu1.onf)=0.04996229
.ic v(xu1.oi)=0.5112334 v(xu1.oj)=0.5112334 v(drv)=0.5727602 v(gate)=1.023957 v(l1a)=11.9372 v(l1b)=12.79872 v(sw)=12.78986 v(swd)=12.78994
.ic v(qdp)=12.78998 v(qd)=12.78998 v(xq1.9)=12.77345 v(xq1.7)=1.095133 v(xq1.8)=-0.01883064 v(qs)=-0.01882657 v(xq1.4)=0 v(xq1.5)=11.65793
.ic v(xq1.10)=11.67831 v(xq1.11)=11.67831 v(xq1.6)=11.67831 v(qsp)=-0.006840106 v(sns)=0.007543647 v(rsm)=-0.001597532 v(d1a)=12.78986 v(d1k)=170.052
.ic v(hv)=170.052 v(c8e)=-0.06020392 v(c8l)=1.110353e-05 v(gc)=2.980417e-06 v(c9e)=-1.021839e-06 v(c9l)=-2.68122e-07 v(ovc)=0.0007058149 v(fb1)=114.2013
.ic v(fb2)=58.35058 v(fb3)=1.074407 v(cmp1)=2.983635 v(ov1)=113.803 v(ov2)=57.55398 v(ovs)=1.30496 v(ov3)=0.1186327 v(xu2.x)=-1.19004
.ic v(xu2.y)=-1.190037 v(ovk)=4.998914 v(ovb)=4.999167 v(bl1)=85.02602
.options method=gear reltol=1e-3 abstol=1e-9 vntol=1e-5 itl4=100 chgtol=1e-14
.end
