huatanshaonian/EL-center/fig_front_panel.py

"""前面板简图（正视 + 中线侧剖）→ png/20_front_panel.png
坐标、尺寸全部取自 assembly_panel.py / assembly.py；斜面在正视图里按 cos33° 压扁投影。
运行：.venv/Scripts/python.exe fig_front_panel.py"""
import matplotlib
matplotlib.use("Agg")
import matplotlib.pyplot as plt
from matplotlib.patches import Circle, Ellipse, Rectangle, Polygon, FancyBboxPatch
import render as R
import assembly_panel as AP
import assembly as A
import parts_dock as PD
from assembly_base import W, D, H, Z_DECK, Z_SHELF, Z_SCREEN, PLATE_T

F = R.FONT
CA, SA = AP.CA, AP.SA
PANEL, CHIN, CUT, GLASS = "#c9ccd1", "#6d7178", "#2a2c30", "#9fd3e6"


def label(ax, x, y, t, fs=8, **kw):
    kw.setdefault("ha", "center")
    ax.text(x, y, t, va="center", fontproperties=F, fontsize=fs, **kw)


def rect(ax, x, z, w, h, **kw):
    ax.add_patch(Rectangle((x, z), w, h, **kw))


def slant_z(u):
    return AP.Z_BASE + u * CA


def front_view(ax):
    ax.set_xlim(-40, W + 45); ax.set_ylim(-28, H + 20); ax.set_aspect("equal"); ax.axis("off")
    ax.set_title("正视（斜面按 33° 投影压扁）", fontproperties=F, fontsize=12)
    # 机架立柱 / 横梁（虚线，在面板后面）
    for x in (0, W - 20):
        rect(ax, x, 0, 20, H, fc="none", ec="#999", ls="--", lw=0.8)
    for z in (0, H - 20):
        rect(ax, 20, z, W - 40, 20, fc="none", ec="#999", ls="--", lw=0.8)
    # 竖直前面板 z 88–420
    z0 = AP.Z_CHIN
    rect(ax, AP.SHELL_X0, z0, AP.SHELL_W, H - z0, fc=PANEL, ec="#333", lw=1.2)
    # EL 视窗 + 屏
    sx0 = (W - 267) / 2
    aa_w, aa_h = 211.2, 158.4
    ex, ez = sx0 + (267 - aa_w) / 2 - 2, Z_SCREEN + (220 - aa_h) / 2 - 2
    rect(ax, ex, ez, aa_w + 4, aa_h + 4, fc="#3a2a10", ec="#111")
    rect(ax, ex + 2, ez + 2, aa_w, aa_h, fc="#d98a1c", ec="none", alpha=0.85)
    label(ax, ex + aa_w / 2, ez + aa_h / 2, f"EL 屏 LJ64K052\n视窗 {aa_w + 4:.0f}×{aa_h + 4:.0f}", 11, color="#3a2000")
    # 管龛：IN-14 ×6 + IV-18
    nx, nz, nw, nh = AP.NICHE
    rect(ax, nx, nz, nw, nh, fc=CUT, ec="#111")
    # IN-14 只画玻壳（底 = 小板底 + 板厚 + 4 mm 引线根），引线在小板以下看不见
    z_in14 = A.Z_IN14_PCB + 1.6 + 4
    for x in A.TUBE_X:
        rect(ax, x - 10.5, A.Z_IN14_PCB, 21, 1.6, fc="#1f6b35", ec="none")          # 小板侧边
        ax.add_patch(FancyBboxPatch((x - 9, z_in14), 18, 174.7 - z_in14, boxstyle="round,pad=0,rounding_size=8",
                                    fc="#e07a2e", ec="#7a3500", alpha=0.75))
    # IV-18：玻壳 Ø19，芯柱端面在 IV18_STEM_X，总长 115 含排气尖；字位第 1 位离芯柱端 17.5、位距 9.8，特殊位在第 8 位左 8
    zc = A.Z_IV18_PCB + 11.6
    sx = A.IV18_STEM_X
    ax.add_patch(FancyBboxPatch((sx - 115, zc - 9.5), 115, 19, boxstyle="round,pad=0,rounding_size=8",
                                fc="#4fd6c2", ec="#11695c", alpha=0.75))
    digits = [sx - 17.5 - 9.8 * k for k in range(8)] + [sx - 17.5 - 9.8 * 7 - 8]
    for dx in digits:
        rect(ax, dx - 2.7, zc - 5.25, 5.4, 10.5, fc="none", ec="#063", lw=0.6)
    label(ax, nx + nw / 2, 166, "IN-14 ×6", 9, color="white")
    label(ax, sum(digits[:8]) / 8, zc - 7.5, "IV-18", 7, color="#063")
    # 表头
    mx, mz = AP.METER
    ax.add_patch(FancyBboxPatch((mx - 32, mz - 28), 64, 56, boxstyle="round,pad=0,rounding_size=3", fc="#222", ec="#000"))
    rect(ax, mx - 28, mz - 16, 56, 40, fc="#f3eee0", ec="none")
    ax.plot([mx, mx + 16], [mz - 14, mz + 14], color="#b00", lw=1.2)
    label(ax, mx, mz - 22, "85C1 表头", 7.5, color="white")
    # 6E2 窗
    wx, wz, ww, wh = AP.EYE_WIN
    rect(ax, wx, wz, ww, wh, fc=CUT, ec="#111")
    for x in AP.EYE_X:
        ax.add_patch(FancyBboxPatch((x - 10, 111.6 + 6), 20, 173.6 - 117.6, boxstyle="round,pad=0,rounding_size=8",
                                    fc="#55e07a", ec="#0a5a20", alpha=0.75))
    label(ax, wx + ww / 2, wz + wh + 6, "6E2 ×2", 8, color="#032")
    # 盖革窗 + J305
    gx, gz, gw, gh = AP.SBM_WIN
    rect(ax, gx, gz, gw, gh, fc=CUT, ec="#111")
    ax.add_patch(FancyBboxPatch((186, A.SBM_Z - 5), 103.5, 10, boxstyle="round,pad=0,rounding_size=4", fc="#bfc3c8", ec="#555"))
    label(ax, 237, A.SBM_Z, "J305 盖革管", 7.5, color="#222")
    # 亚克力（虚线）
    ax.add_patch(Rectangle((22.5, 89), 173 - 22.5, 179 - 89, fc="none", ec="#1f7fbf", ls=":", lw=1.2))
    ax.add_patch(Polygon([(178, 91), (299, 91), (299, 175.5), (244, 175.5), (244, 116), (178, 116)],
                         closed=True, fc="none", ec="#1f7fbf", ls=":", lw=1.2))
    # 感应器、固定孔
    ax.add_patch(Circle(AP.SENSOR, 3, fc="white", ec="#333"))
    label(ax, AP.SENSOR[0] - 22, AP.SENSOR[1], "感应窗", 7)
    holes = [(x, z) for x in (10, W - 10) for z in (140, 280, 410)] + [(x, H - 10) for x in (110, 210)]
    for x, z in holes:
        ax.add_patch(Circle((x, z), 2.25, fc="white", ec="#333", lw=0.8))
    # 斜面（投影）
    zb, zc = slant_z(AP.U_EDGE), AP.Z_CHIN
    rect(ax, 0, zb, W, zc - zb, fc=CHIN, ec="#222", lw=1.0)
    for x in PD.SPEC["tongue_x"]:                                                      # 键盘座舌片 M3 沉头
        ax.add_patch(Circle((W / 2 + x, slant_z(AP.U_EDGE + PD.SCREW_U)), 3, fc="#222", ec="#aaa", lw=0.6))
    for x, u in [AP.SEL]:
        ax.add_patch(Ellipse((x, slant_z(u)), 33, 33 * CA, fc="#111", ec="#000"))
    for x, u in AP.USB:                                                                # 上下叠放双口
        rect(ax, x - 7.9, slant_z(u) - 7.4 * CA, 15.8, 14.8 * CA, fc="#111", ec="#999")
        for sz in (-1, 1):
            rect(ax, x - 6.25, slant_z(u + sz * 3.6) - 2.55 * CA, 12.5, 5.1 * CA, fc="#2a6bd1", ec="none")
    for x, u in AP.ENC:
        ax.add_patch(Ellipse((x, slant_z(u)), 15, 15 * CA, fc="#e8a33d", ec="#7a4b00"))
    for u in AP.FADER_U:
        rect(ax, AP.FADER_X - 33.5, slant_z(u) - 1, 67, 2, fc="#111", ec="none")
    for x in AP.TOG_X:                                                                 # 钮子（不装保护盖）+ Ø16 指示灯（灯头 19）
        ax.add_patch(Ellipse((x, slant_z(AP.TOG_U)), 10, 10 * CA, fc="#ccc", ec="#555"))
        ax.add_patch(Ellipse((x, slant_z(AP.TOG_U)), 3, 3 * CA, fc="#eee", ec="#333"))
        ax.add_patch(Ellipse((x, slant_z(AP.LAMP_U)), 19, 19 * CA, fc="#ccc", ec="#666"))
    for x in AP.KEY_X:
        for u in AP.KEY_U:
            rect(ax, x - 12, slant_z(u) - 9 * CA, 24, 18 * CA, fc="#f2c96b", ec="#8a6a1a")
    # 键盘座（后仰，屏幕面接着斜面往下）+ 下巴托两侧板（在机架外侧，正面只看到 2 mm 边）
    zd = slant_z(AP.U_EDGE - PD.SPEC["H"])
    rect(ax, 0, zd, W, zb - zd, fc="#202124", ec="#000")
    label(ax, W / 2, (zb + zd) / 2, "X1 磁吸键盘座（后仰，两端锁侧板）", 7.5, color="white")
    zt = AP.TRAY_Z
    for x in AP.SIDE_X:
        rect(ax, x, zt - 2, 2, zc - zt + 2, fc="#8a8f96", ec="#333", lw=0.6)
    rect(ax, AP.SHELL_X0, zt - 2, AP.SHELL_W, 2, fc="#8a8f96", ec="#333", lw=0.6)
    desk = -PLATE_T - AP.FEET_H
    for x in (0, W - 20):                                                             # 铝脚垫（立柱正下方）
        rect(ax, x, desk, 20, AP.FEET_H, fc="#555", ec="#222", lw=0.6)
    ax.plot([-30, W + 30], [desk, desk], color="#999", lw=0.8)
    # 尺寸
    ax.annotate("", (AP.SHELL_X0, H + 10), (AP.SHELL_X0 + AP.SHELL_W, H + 10), arrowprops=dict(arrowstyle="<->", lw=0.8))
    label(ax, W / 2, H + 15, f"{AP.SHELL_W:.0f}（机架 {W}，左右各多 2 盖住下巴托侧板）", 9)
    for z, t in ((H, f"{H}"), (zc, f"{zc:.0f} 面板下沿 / 斜面上沿"), (zb, f"{zb:.1f} 斜面下沿"), (zd, f"{zd:.1f} 键盘座底面前沿"),
                 (desk, f"{desk:.0f} 桌面（脚垫 {AP.FEET_H:g}）")):
        ax.plot([W + 3, W + 12], [z, z], color="#333", lw=0.8)
        ax.text(W + 14, z, t, va="center", fontproperties=F, fontsize=8)
    label(ax, -22, (zc + H) / 2, f"前壳：竖直前面板\n{AP.SHELL_W:.0f}×332×2", 9, rotation=90)
    label(ax, -22, (zb + zc) / 2, f"斜面（同一块板折 33°）\n展开 {W}×{AP.SLANT_L:g}", 8, rotation=90)
    ax.text(0, -18, "虚线框 = 后面的 2020 立柱 / 横梁；蓝点线 = 背面亚克力；白点 = M4 固定孔（锁进立柱、顶横梁的 T 螺母）；斜面下沿 3 个黑点 = 键盘座 M3 沉头",
            fontproperties=F, fontsize=8, color="#444")


def side_view(ax):
    ax.set_xlim(-75, 100); ax.set_ylim(-28, H + 20); ax.set_aspect("equal"); ax.axis("off")
    ax.set_title("侧视（x = 160 剖开，左边是前面；立柱是后方投影）", fontproperties=F, fontsize=11)
    # 机架：立柱（侧面）、前下 / 前上横梁、甲板、电脑层、底板
    rect(ax, 0, 0, 20, H, fc="#e6e6e6", ec="#999", ls="--", lw=0.8)
    label(ax, 10, 330, "2020\n立柱\n（x 0–20）", 7, color="#666")
    rect(ax, 0, 0, 20, 20, fc="#b8bcc2", ec="#555")
    rect(ax, 0, H - 20, 20, 20, fc="#b8bcc2", ec="#555")
    label(ax, 35, 10, "前下横梁", 7, ha="left")
    rect(ax, 2, Z_DECK, 70, PLATE_T, fc="#d0603a", ec="#7a2a10")
    label(ax, 48, Z_DECK + 10, "甲板 z90", 7)
    rect(ax, 30, Z_SHELF, 40, PLATE_T, fc="#d0603a", ec="#7a2a10")
    label(ax, 50, Z_SHELF + 10, "电脑层", 7)
    rect(ax, 0, -PLATE_T, 70, PLATE_T, fc="#d0603a", ec="#7a2a10")
    # EL 屏
    rect(ax, 3, Z_SCREEN, 8, 220, fc="#d98a1c", ec="#7a4b00", alpha=0.6)
    label(ax, 30, Z_SCREEN + 110, "EL 屏", 8)
    # 前面板
    rect(ax, -2, AP.Z_CHIN, 2, H - AP.Z_CHIN, fc="#555", ec="#000")
    label(ax, -12, 250, "前面板 2 mm", 8, rotation=90)
    # 斜面（2 mm 厚）、底座条、下底板
    (yb, zb), zc = AP.slant_pt(AP.U_EDGE, 0), AP.Z_CHIN
    nx, nz = CA * 2, -SA * 2      # 斜面法向（朝里）
    ax.add_patch(Polygon([(-2, zc), (yb, zb), (yb + nx, zb + nz), (-2 + nx, zc + nz)], closed=True, fc="#333", ec="#000"))
    label(ax, (yb - 2) / 2 - 10, (zb + zc) / 2 + 4, "斜面 33°", 8, rotation=57)
    # 键盘座（屏幕面接着斜面往下）、X1 连接条、下巴托底板（后边上翻锁前下横梁）、脚垫
    dh, dd = PD.SPEC["H"], PD.SPEC["D"]
    sp = AP.slant_pt
    e = AP.U_EDGE
    ax.add_patch(Polygon([sp(e - dh, 0), sp(e, 0), sp(e, dd), sp(e - dh, dd)], closed=True, fc="#202124", ec="#000"))
    ax.add_patch(Polygon([sp(e - dh - 5, 0), sp(e - dh, 0), sp(e - dh, dd), sp(e - dh - 5, dd)], closed=True, fc="none", ec="#c0392b", ls="--"))
    label(ax, yb - 22, zb - 8, "键盘座", 7)
    zt = AP.TRAY_Z
    rect(ax, AP.TRAY_Y0, zt - 2, -AP.TRAY_Y0, 2, fc="#8a8f96", ec="#333")
    rect(ax, -2, zt, 2, 18 - zt, fc="#8a8f96", ec="#333")
    kx, ky = AP.KBD_XY                                                             # 键盘转接小板（x 170–210）
    rect(ax, ky, zt + AP.KBD_STANDOFF, 30, 1.6, fc="#2f7d3a", ec="#174")
    label(ax, ky + 15, zt + AP.KBD_STANDOFF + 6, "KBD-ADAPT", 6, color="#174")
    desk = -PLATE_T - AP.FEET_H
    rect(ax, 0, desk, 20, AP.FEET_H, fc="#555", ec="#222")
    ax.plot([-75, 100], [desk, desk], color="#999", lw=0.8)
    # 斜面电路板（离斜面内表面 6.5）
    u0, u1 = AP.PCB_U
    off = 2 + AP.PCB_D
    p = lambda u, o: (yb + u * SA + o * CA, zb + u * CA - o * SA)
    ax.add_patch(Polygon([p(u0, off), p(u1, off), p(u1, off + 1.6), p(u0, off + 1.6)], closed=True, fc="#2f7d3a", ec="#174"))
    label(ax, -12, 40, "斜面\n电路板", 7, color="#174")
    # 下巴托侧板外形（在机架外侧 x −2..0 / 320..322）
    import assembly_shell as SH
    pts = SH.side_outline()
    ax.add_patch(Polygon(pts, closed=True, fc="none", ec="#1f7fbf", ls=":", lw=1.2))
    for y, z in AP.SIDE_M4:
        ax.add_patch(Circle((y, z), 2.25, fc="none", ec="#1f7fbf", lw=0.8))
    label(ax, -10, -24, "蓝点线 = 下巴托侧板外形（圈 = M4 锁型材）；红虚线 = 键盘连接条", 7, color="#1f7fbf")
    # 尺寸
    yf = sp(e - dh, 0)[0]
    ax.annotate("", (yf, -14), (0, -14), arrowprops=dict(arrowstyle="<->", lw=0.8))
    label(ax, yf / 2, -17.5, f"前探 {-yf:.0f}", 7.5)


def main(fname="png/20_front_panel.png"):
    fig, (a1, a2) = plt.subplots(1, 2, figsize=(16, 11), dpi=110, gridspec_kw=dict(width_ratios=[3.2, 1.25]))
    front_view(a1); side_view(a2)
    fig.suptitle("MIS-01 前面板现状（2026-10-26：斜面加长到 90.8、下巴往下延伸，铝脚垫 6 mm）", fontproperties=F, fontsize=15)
    fig.tight_layout(); fig.savefig(fname, facecolor="white"); plt.close(fig)
    print("saved", fname)


if __name__ == "__main__":
    main()
