huatanshaonian/EL-center/build_guide_steps.py

"""MIS-01 组装 / 调试流程的内容（make_build_guide.py 读它生成网页）。

每个阶段：
  id      网页里勾选状态的键，改了会丢已勾选的记录，别随便改
  title   标题
  why     为什么排在这里、这一阶段要学会什么
  boards  焊接图（el_driver/焊接图/<tag>.html）
  tests   嵌入上电测试清单的哪几节（按节号，如 '4'、'8a'）
  steps   一步一个勾；写“（叫我）”的是要我在电脑上做的（编译烧录、写配置等）
  figs    插在这一阶段里的示意图 [(png/ 下的文件名, 说明)]，文件要已放行进 git（.gitignore）
各板的元件作用、焊接注意在焊接图里，测试数值在上电测试清单里，这里只排顺序、串起来，不重复抄数值。
"""

GENERAL = [
    '每块板的焊接顺序：先矮后高——电阻、二极管 → IC 座 / 芯片 → 瓷片电容 → 排针排母、XH 座 → 电解电容 → 大件（电感、TO-220、管座）。'
    '矮件先焊，板子翻过来压在桌上时元件不会掉。',
    '有极性的件焊之前对一下丝印：二极管色环端 = 阴极；电解电容白条 = 负极；IC 缺口 / 圆点 = 1 脚；库存三极管先用万用表二极管档定 E、B、C。',
    '一组料焊完就在焊接图上打勾；点开那一行能看到每个元件是干什么的，点“电路说明”看这一块的原理——焊之前先看一遍。',
    '焊完一块板：放大镜看一遍焊点（光亮、圆锥形、没有连锡和虚焊），用 IPA 刷洗助焊剂，晾干。高压板再刷三防漆（焊接图和清单里写了刷哪里）。',
    '每块板第一次通电都用可调限流电源，限流设到“正常电流 × 1.5”。电流不对、读数不对就停下，先别往下做。',
    '高压板（HV-UNI、辉光、6E2、盖革）：断电 → 等 3–4 s → 用表量高压点 < 30 V → 再碰；单手操作，表笔先夹地。',
]

STAGES = [
    dict(id='s0', title='阶段 0　准备：工具、来料检查、MAX6921 测真伪',
         why='后面每块板都要用这些工具；斜面板的缺口必须在焊元件之前切；淘宝的 MAX6921 要先确认是真货，再决定焊不焊到 IV-18 板上。',
         boards=[], tests=['0', '8a'],
         figs=[('28_slant_pcb_cut.png', '斜面板左缺口：切掉哪一条'),
               ('31_max6921_pinout.png', 'MAX6921 脚怎么数、测试时每只脚接什么'),
               ('32_max6921_test_circuit.png', 'MAX6921 测真伪接线（座子针插不进面包板时用杜邦线母头套针）')],
         steps=[
             '焊接工具：恒温烙铁、加热台（台面 ≥ 200×200、能到 250 ℃）、热风枪（返修用）、防静电镊子、放大镜台灯或电子显微镜。',
             '回流材料：钢网（01/02/06 三板合一那张）、Sn63 针筒锡膏 + 点胶针头、刮刀 + 高温胶带；助焊膏、吸锡带、99% IPA + 刷子、三防漆。',
             '仪器：数字万用表（10 MΩ 输入阻抗、有 DC 1000 V 档）、示波器 DS1102Z-E。',
             '可调限流电源（0–30 V、限流能设到 0.1 A）：每块板第一次通电都靠它保护。手上没有就先买一台——焊接可以先做，通电前必须有。',
             '自制放电棒：10 kΩ 5 W 电阻两头接绝缘鳄鱼夹线。另备几只 10 kΩ 1/4 W（临时上拉）、56 Ω 1 W 或 4 只 220 Ω（IV-18 灯丝假负载）、8.5 kΩ 5 W（HV-UNI 带载，可选）。',
             '嘉立创贴好的三款（键盘转接板、HDMI-PI、HDMI-DOCK）：对着焊接图 / 设计记录看贴片件齐全、方向对、没有连锡。',
             '裸板目测：板边、焊盘有没有划伤；对着灯看有没有明显断线。',
             '斜面板：焊任何元件之前切左 USB 缺口（本地 x 0–24、y 17–20.5；细齿锯或斜口钳剪，再锉到线，不能掰，见 png/28_slant_pcb_cut.png）。',
             'MAX6921 ×4：用 SOP28 翻盖测试座按下面清单 8a 逐片测（脚怎么数见 png/31_max6921_pinout.png，接线图见 png/32_max6921_test_circuit.png；座子针插不进面包板就用杜邦线母头套针），挑 2 片好的给 IV-18 板（1 用 1 备），坏的单独装袋写上“坏”。',
             '每块板打开焊接图点“按格子排”，把这块板的料一格一格取出来；标红“库里没找到 / 不够”的先解决。',
         ]),
    dict(id='s1', title='阶段 1　直插热身：键盘转接板 + IN-14 小板 ×7',
         why='没有高压、元件少，用来练手：烙铁温度、上锡量、焊点形状。键盘板的贴片件嘉立创已贴，只焊两个直插件；'
             'IN-14 小板 7 块一模一样，焊到第 7 块手就熟了。',
         boards=['KBD-ADAPT_D1', 'IN14-SOCK_D1.1'], tests=['3b'],
         steps=[
             '键盘转接板：焊 H_TEST（13 针排针）和 J_USB（XH-4A）——塑料座在正面（和 J_FPC 同面），短针穿到背面，在背面焊；背面针脚剪 ≤ 3 mm（板下是 M2×5 铜柱，只有 5 mm 空间）。',
             '键盘转接板：按清单 3b 先量 USB 线针序（1 = 5 V、4 = GND），对了再插键盘排线；反接 5 V 会烧键盘。',
             'IN-14 小板用 D1.1（10-28 返工重画，要重新下单）：旧 D1 板的 R_A、R_PR 在管子底座下面，不要用；旧板留着也没用（孔位已用旧板试插确认，D1.1 沿用）。',
             'IN-14 小板 D1.1 ×7：先 R_PR（0805 0 Ω，背面贴、背面焊），R_PL 不焊 → R_A（本体贴背面，从背面插入、在正面焊）→ J1 2×7 排针（塑料座贴背面，焊点在正面）。每行元件旁边都标了“正面/背面”，照着那一面焊。',
             'IN-14 小板：管子（V1）先不焊，等阶段 6a 驱动板测好再焊。',
             '洗板：IPA 刷掉助焊剂。',
         ]),
    dict(id='s2', title='阶段 2　HV-UNI 高压小板 ×3（第一次接触高压）',
         why='辉光板（180–185 V）和 6E2 板（250 V）的高压都来自它，必须先单独调好电压再插到宿主板上。'
             '这是第一块高压板，借它把安全习惯练熟；焊接图“电路说明”里有升压原理（电感储能 → MOS 关断 → 二极管送到输出电容）。',
         boards=['HV-UNI_D1'], tests=['4'],
         steps=[
             '焊接：先焊 L1、RS1 两只大焊盘贴片件，再按“先矮后高”焊其余；UC3843 直接焊；Q1 立装，散热片带高压，套热缩管。',
             '料的注意：R3 用库存 20 Ω（BOM 写 22 Ω）；C10 脚距 2.5 mm，掰开到 5.0 mm 再插；R21/R22 量一下本体，不是迷你体。',
             '2N3906、LED 焊前用万用表定脚。',
             '三块分别贴纸标签：#1 辉光 180–185 V、#2 6E2 250 V、#3 备用。',
             '按清单 4 逐块调：RV1 先拧到最低电压 → 12 V / 0.5 A 限流上电 → 慢慢调到目标 → 断电看 3 s 内降到 30 V 以下。',
             '（可选）按清单 4 第 4 步验过压保护、第 5 步带载。',
             '刷三防漆：Q1 三只脚之间、高压焊盘一圈。',
         ]),
    dict(id='s3', title='阶段 3　回流焊三块板：IV-18 → 电源板 → EL 接口板',
         why='三块板的贴片件用同一张钢网刷锡膏、上加热台一起熔化（回流）。先做 IV-18（最难的是 SOIC-28，脚距 1.27 mm），'
             '练熟了再做电源板（4 颗 2×2 mm 的 VQFN 电子保险最难）和 EL 接口板。每块板先把贴片全部回流完、检查过，再焊直插件。',
         boards=['IV18_D1', 'PWR-DIST_D1.1', 'EL-IF_D1.3'], tests=[],
         steps=[
             '锡膏：冰箱里拿出来的先放室温回温 2 小时再开盖（冷的锡膏会吸水汽，回流时溅锡珠）。',
             '刷锡膏：板子四周用同厚度的废板或胶带围住定位；钢网对准焊盘后用高温胶带固定；刮刀约 45° 用力一次刮过，'
             '垂直揭起钢网。看每个焊盘都有锡膏、相邻焊盘没连在一起，不好就用 IPA 擦掉重刷。',
             '摆件：对着焊接图，从中间往外、从小到大；IC 1 脚对丝印圆点，二极管 / 电解看极性；VQFN 对准后用镊子轻轻按一下。'
             'IV-18 板的 U1 用阶段 0 测过真伪的 MAX6921。',
             '回流：板放加热台中间，约 150 ℃ 预热 60–90 s，再调到约 220–230 ℃；看锡膏全部变亮、元件被拉正后再等 10–20 s，'
             '关热，把板平移到隔热垫上自然冷却，别碰、别吹。',
             '检查：放大镜看连锡、立碑（小电阻一头翘起）、少锡；连锡用烙铁 + 助焊膏 + 吸锡带修。VQFN 底下看不到，用万用表量电源对地、相邻脚不短路。',
             '通电前量短路：电源板 +24 V / +12 V / +5 V / +3V3 对 GND；IV-18 板 +5 V、+24 V、VBB 对 GND；EL 接口板 +5V_EL、+12 V、3V3 对 GND——都不能接近 0 Ω。',
             '再焊直插件（先矮后高）。IV-18：J1、J2 和 5 根测试针焊完把板底焊脚剪平到 ≤ 0.8 mm。电源板：NID100 排母、保险座、端子、PFAIL 直插区。'
             'EL 接口板：先焊 DIP-20 座再插 SN74AHCT245N（缺口对丝印），电阻排、DF11、排针。',
             '三块板都用 IPA 洗板；IV-18 板的 35 V 段线间距只有 0.1 mm，测完（阶段 6d）刷三防漆。',
         ]),
    dict(id='s4', title='阶段 4　电源板上电测试（整机的电都从它出）',
         why='后面所有板子都从这块板取电，所以它先单独测通。先用限流电源模拟 24 V，全过了再接明纬 LRS-200（这一步才碰 220 V 交流）。',
         boards=['PWR-DIST_D1.1'], tests=['1'],
         steps=[
             '两个 NID100 插到排母上（1 脚对方焊盘），扎带穿两侧长条孔捆住。',
             '插保险：F_MAIN 10 A 红色（车上找的 Mini 片式），F_N5、F_N12 7.5 A 棕色（A12后）。',
             '按清单 1 用限流电源 24 V / 0.5 A 逐项测（不是 LRS-200）。PFAIL 那一步记得临时接 10 kΩ 上拉。',
             'LRS-200-24 单独接市电试：断电接线，IEC 座的地线（PE）接好，L/N 端子盖好；空载量输出 24 V。',
             '断电后再把 LRS-200 接到电源板 J_24V，复测一遍清单 1 第 1 步。',
         ]),
    dict(id='s5', title='阶段 5　ESP32 底板 + 烧固件（所有仪表板的控制中心）',
         why='辉光、6E2、盖革、IV-18、表头都由 ESP32 控制，后面每块显示板都要接到它上面调，所以它排在显示板前面。'
             '固件已经在裸开发板上测过 197 项，这里主要验底板接线和默认电平。',
         boards=['ESP-BASE_D1'], tests=['2'],
         steps=[
             '焊接：先矮件（电阻、小电容），再排母、XH 座、电解；U1（PCA9555）、J_EXP 不焊；JP_BZ 插跳线帽。开发板插上后电阻就看不见了，焊完先量一遍。',
             '烧正式固件（叫我）：开发板 USB 接这台电脑，我编译烧录 mis01_fw（COM7），烧完用 DBG OUT 确认。'
             '台架烧固件时先拔 J_CTL、J_INST（电脑的 5 V 会经开发板倒灌整条 +5 V）。',
             '按清单 2：不插开发板先量各口电压 → 插开发板量 3.3 V 和复位时的默认电平。',
             '外设：DS3231（装电池前拆充电电阻 / 二极管）、BH1750（线要交叉）、LD2410B（转接线按两头丝印单独焊，量过再插）。',
             '表头：VR1 先拧到最大阻值，固件输出 100 %，调到满偏 1.000 mA。',
             'Wi-Fi（叫我）：用 cfgsync 把 pi/esp_local.conf 写进 ESP（COM8）。',
         ]),
    dict(id='s6a', title='阶段 6a　辉光驱动板 + IN-14 ×6（用 HV-UNI #1）',
         why='数字从 ESP → 74HCT595 移位寄存器 → K155ID1 译码 → 拉低对应阴极，阳极 180 V 经 22 kΩ 限流点亮；焊接图“电路说明”里有这条链。'
             '先不插高压测逻辑，再插 HV-UNI 点一只管，最后全插。',
         boards=['NIXIE-DRV_D1.1', 'IN14-SOCK_D1.1'], tests=['5'],
         steps=[
             '焊驱动板：6 个 DIP-16 座（K155ID1 插座，缺口对丝印）、595、MPSA42 ×6、排母；HV-UNI 的 J_HP / J_HH 排母。',
             '按清单 5 第 1–2 步：不插 K155ID1 和高压先量电压，再插 K155ID1 由 ESP 发帧测译码。',
             '焊 IN-14 管到小板 D1.1 上：电木底座对准正面丝印 Ø18.5 圈平贴板面，1 脚方焊盘在后；背面焊，每脚 ≤2 s、隔脚焊，剪脚 ≤ 2 mm。先装一块试亮（清单 5 第 3 步），数字和小数点都对了再焊其余 5 块。',
             'HV-UNI #1 确认已调到 180–185 V 再插；量 R_A 两端电压算阳极电流（清单 5 第 4 步）。',
             '刷三防漆：Q1–Q6 和 RDP 一带（小数点网络截止时浮到 110–150 V）。',
         ]),
    dict(id='s6b', title='阶段 6b　6E2 猫眼板（用 HV-UNI #2）',
         why='6E2 的光条长短由栅极电压控制：ESP 的 PWM 经三极管开关、再经 RC 滤成直流加到栅极，占空比 0 时光条最短、约 79% 两段合拢。先只通灯丝，再插高压，最后做 11 点校准。',
         boards=['EYE-6E2_D1.1'], tests=['6'],
         steps=[
             '焊接：管座用自己买的 GZC9-F（BOM 写 GZC9-A）；R_HA / R_HB 默认不焊；后耳孔和 HV 小板铜柱孔用尼龙垫片。',
             '按清单 6：先只接灯丝量两支各 5.7–6.6 V → 插 HV-UNI #2（已调 250 V）→ 插管扫 PWM。',
             '记 11 点校准写进 ESP（EYE CAL，叫我）。',
             '栅极是高阻节点：焊后清洗 + 刷三防漆，否则零点会漂。',
         ]),
    dict(id='s6c', title='阶段 6c　盖革主板 + 夹子板（400 V）',
         why='TLC555 振荡 + KSP44 + 电感把 5 V 升到约 400 V，LM393 + TL431 闭环稳压；J305 每捕到一个粒子放电一次，'
             '夹子板把阴极电流变成脉冲，一路去咔哒、一路给 ESP 计数。这是电压最高的一块，按清单一步一步来。',
         boards=['GEIGER-MAIN_D1', 'GEIGER-CLIP_D1'], tests=['7'],
         steps=[
             '焊前：R90–R93 四只 22 MΩ 逐只量并记下（算 TP1 读数系数用）；Q6（S8050）定脚。',
             '焊主板：VR1 焊好后拧到 10 Ω（丝印“1st: VR1=10R”），VR2 拧到 0。',
             '按清单 7 第 2 步调高压：先 VR1 调到约 430–440 V 就停，再 VR2 设 400 V。',
             '焊夹子板：R2 是 WR25W4704FTL（2512 贴片，自焊），先焊 R2 再焊管夹；400 V 线两头焊点套热缩。',
             '台架测咔哒要插 JP1（接 ESP 前拔掉）；单板量 PULSE 要临时接 10 kΩ 上拉。',
             '刷三防漆：分压链、阴极检测一带、高压焊盘一圈。',
         ]),
    dict(id='s6d', title='阶段 6d　IV-18 板 + XL6009 + 端板',
         why='IV-18 是荧光管（VFD）：灯丝通交流发电子、栅极和阳极加 35 V 让对应笔画发光，MAX6921 负责轮流选位和选段。'
             '灯丝电路带看门狗：方波停了就自动断电、强制熄屏，测试时要验证这一点。',
         boards=['IV18_D1'], tests=['8'],
         steps=[
             'J2 到 XL6009 IN+ 的线上串一只 2.2 Ω 2 W 电阻（套热缩），防上电冲击电流烧 Q1。',
             'XL6009 模块先空载调到 35 V（输出电解耐压不够 50 V 的先换掉），调好点胶。',
             '按清单 8：先不装端板不插管，接灯丝假负载测灯丝方波和看门狗 → 接 XL6009 测 VBB → 示波器看栅极扫描。',
             '装端板（T 形焊 22 个焊点，逐个量通、量相邻不短路）→ 穿管、焊引线 → 刷三防漆 → 先 25–30 V 看，再调到 35 V。',
         ]),
    dict(id='s7', title='阶段 7　斜面板（按键、编码器、推子、6 档模式开关）',
         why='全是低压输入件，没有危险；Pico 读所有输入，ULN2803 驱动按键灯。Pico 的固件还没写，到这一步告诉我，我先写一个测试程序把所有输入读出来。',
         boards=['SLANT_D1.1'], tests=['3'],
         steps=[
             '确认左 USB 缺口已切（阶段 0）。',
             '先焊背面两条 1×20 排母（用 Pico 当定位夹具，见清单 3 装配），再焊背面其余元件，最后焊正面的编码器、推子。',
             'ULN2803 直接焊（DIP-18，缺口对丝印）。',
             '模式开关压线：旋钮转到左下 1 档，用万用表找出和公共片相通的焊片接 J_MODE 2 脚，顺时针逐档依次接 3–7 脚。',
             'Pico 测试程序（叫我）：按清单 3 第 2–3 步读按键、编码器、推子、模式开关，逐个点亮键灯。',
         ]),
    dict(id='s8', title='阶段 8　EL 屏链路（最后做：屏坏了买不到）',
         why='Pi 的 HDMI → 软排线小板 → Dock 上的 FPGA 把画面转成 EL 屏要的格式 → EL 接口板把 3.3 V 信号放大到 5 V 并控制屏的两路电源。'
             '屏只有一块，所以先不接屏，把信号和上电时序全部验对了才接。',
         boards=['EL-IF_D1.3'], issue_keys=['HDMI'], tests=['9b', '9'],
         steps=[
             'HDMI 两头小板：拖焊 J1（夹板式 HDMI 插头，正反两面各一排，脚距 1 mm）：多上助焊膏，刀头带锡拖过，连锡用吸锡带吸掉。',
             '按清单 9b 量通断（每块板 J1 ↔ J2 对应脚，18 脚不通），插排线再量一遍。',
             'FPGA 烧 D1.3 脚表的 el_test（叫我 / FPGA 会话）。',
             'EL 接口板按清单 9：不接屏，示波器看 J_EL 侧时钟和数据是 5 V、时序对；VD 开关顺序用测试点确认。',
             '对照实物确认屏线排线 1 脚方向。',
             '以上全过再接屏：先 el_test 测试图案，再切 HDMI 看 Pi 的画面。',
         ]),
    dict(id='s9', title='阶段 9　整机装配与联调',
         why='所有板子单独都测过了，再装进机架、做线束、按顺序一块一块接上去，每接一块看一次 24 V 总电流，哪一块出问题马上就能知道。',
         boards=[], issue_keys=['HARNESS'], tests=['10'],
         figs=[('22_exploded_front.png', '整机爆炸图（前）'), ('22_exploded_rear.png', '整机爆炸图（后）'),
               ('26_chin_exploded.png', '下巴托 + 键盘座爆炸图'), ('26_chin_iso.png', '下巴托 + 键盘座'),
               ('26_chin_side.png', '下巴托侧视'), ('27_drill_map.png', '层板上要自己钻的孔'),
               ('20_front_panel.png', '前面板')],
         steps=[
             '机械装配按 MIS-01装配说明.md：从下往上（机架 → 下舱 → IEC 小板 + 地线 → 甲板 → 电脑层 → EL 屏 → 前壳 → 下巴托 + 键盘座）。外壳件还没下单的部分先空着。',
             '线束：XH 端子线按各板针脚做，做一根量一根（两头 1 脚对 1 脚），贴上标签。',
             '按清单 10 联调：电源板 + ESP 开关机时序 → 依次接斜面板、辉光、6E2、盖革、IV-18、表头、传感器。',
             '拔 IEC 模拟断电：PFAIL 先到，ESP 关高压、IV-18 熄屏、记日志，EL 接口板关 VD。',
             'Pi 侧程序（mis01d、电台）已装好，最后连起来看整机功能（叫我一起查）。',
         ]),
]
