huatanshaonian/EL-center/assembly_issues.py

"""2026-10-28 全板复审查出的“焊前 / 装配时必看”事项（板子不用重做，但不照做会装不上、装错或有隐患）。

按板子（焊接图的 tag）分组；make_solder_map.py 显示在各板焊接图顶部，make_build_guide.py 显示在装配流程对应阶段。
每条一句话说清“做什么”，括号里是原因。完整证据在复审报告（scratchpad\\review2\\<组名>.txt）。
"""

ISSUES = {
    'EL-IF_D1.3': [
        '2×6 线必须做成“镜像线”：把 EL-IF 那头胶壳里每列上下两根对调（1↔2、3↔4…11↔12），胶壳上标“EL-IF 端”。'
        '（两头插座同手性，普通延长线必然上下两排对调；D1.3 改编号时没考虑镜像。）',
        '接线后不上电量：J5-5↔P1-5、J6-8↔P2-8、J14-5↔P3-5 都要通才算对。不能掉头插（3.3 V、GND 会顶到 FPGA 输出脚）。'
        '原来清单写的“P1-1 与 J5-1 通”查不出错（1、2 脚在板上本来就连着）。',
        'U1/U2 封装两排孔距 7.94 mm，DIP-20 座是 7.62 mm：焊前把座子空插进孔试；插不进就把座子两排脚各往外掰一点。',
        'U1/U2 的 1 脚丝印只有一小横，装座子后会被盖住：座子缺口朝板上边（C1/C2 那头），焊前先用记号笔标好。',
        '先焊 C1、C2（C2 夹在两个座子之间，C1 贴着 U1 上端，各只剩 0.5 mm），电容立正贴板，再焊座子。',
        'J_PWR 端子焊前看实物进线口朝哪：如果朝着 DTV5/DTV12，就把端子转 180° 再焊，接线仍按焊盘编号。',
        'J_LAMP 丝印“+12”印在 2 脚上方，实际 1 脚才是 +12 V，按焊盘编号接线。',
        '安装位置（10-28 定）：电脑层板下面、EL 屏背后，元件朝上，用 4 根 M3×30 母母铜柱吊在层板孔阵 (145,65)(235,65)(145,155)(235,155) 下；'
        '层板自己开 1 个 Ø25 过线孔（圆心 (225,85)，用孔阵孔当导孔，4–32 阶梯钻或 25 开孔器）给 2×6 线穿到 Dock；'
        '4 个孔在层板上面用 90° 倒角器锪沉头、配 M3×8 沉头螺丝（加工图 P2 第 2-13～2-17 项）。'
        'EL-IF 要在装 Pi、Dock、Hub 之前吊上去，线先插好。',
        '线长：DF11 屏线约 12 cm（20 cm 线多出的盘起来扎好）；2×6 线 7–13 cm；J_PWR、J_PF 约 45 cm、J_LAMP 45–50 cm（自己压线，各加 10 cm 再剪）；'
        'J_PF 走甲板右后过线孔 (291,145)，绕开 XL6009 和 6E2 高压区。',
    ],
    'HDMI': [
        'HDMI-PI 小板 +X 边离香橙派的 3.5 mm 音频插头只有 0.1–1.1 mm：音频线用插头外径 ≤ 8 mm 或 90° 弯头的；还碰就把小板 +X 边锉掉约 1 mm（那里只有地铜）。',
    ],
    'PWR-DIST_D1.1': [
        '焊保险座前先试插：普通 Mini(ATM) 片要能插到底、倒过来轻拉不掉。（3557 座规格书只写配标准 ATO 和低矮型 Mini-LP。）不行就换低矮型 Mini 或标准 ATO 片。',
        '捆 NID100 的扎带要 3×150 mm（一圈约 101 mm，100 mm 的捆不上）。',
        'C_IN5、C_IN12 两只 470 µF 离 NID100 末端只有约 0.8 mm：贴板竖直焊、略往 +x 偏，最好把模块插上再焊。',
        'NID100 插反或错一位也插得进，会把 24 V 短到地：插好后数针（13 针全进孔、排母没有空孔），上电前量 +24V 对地不短；焊排母时把模块插在上面一起焊。',
        'TPS259470 的 IN–OUT 焊盘只隔 0.2 mm，连锡等于保险被短接：回流后每颗量 IN–OUT 之间不能短路；清单 1 第 3 步“钮子断开三路都是 0 V”不能跳。',
        'C_DVC 用 3.3 nF：它和 1 nF、2.2 nF 都在贴片阻容盒、没有印字，摆件时只从 3.3 nF 那条编带上取。',
        '做 4.9 A 限流测试时，24 V 电源限流要从 0.5 A 调到约 2 A。',
    ],
    'IV18_D1': [
        '端板两个榫头 2.0 mm 宽，插不进主板 Ø2.2 孔：T 形焊之前把榫头锉到 ≤ 1.5 mm 宽，干插确认端板下沿贴平主板。',
        '不用扎带固定管子（会顶到上方 IN-14 小板）：引线焊好后在玻壳下 x≈37、x≈128 两处点中性硅胶。',
        '装管前用卡尺量玻壳最大直径（设计按 Ø19，大于 19.5 告诉我）；先用备用端板试穿 22 根引线，确认 7 脚朝前。',
        '引线拉直、剪到 6–8 mm 再穿端板，在桌上装好再放进机器；300–330 ℃、每脚 ≤ 2 s、隔脚焊，先焊 1、13 脚定位。',
        '钢网刷锡膏前用胶带盖住 R17–R19 的开口（这三只不焊）。',
        '灯丝假负载测完，把 TA4/TA9 焊盘上的锡吸平，否则端板放不平。',
        '管窗亚克力用 UV 胶或 ≤ 0.2 mm 的薄胶带，不用 VHB（VHB 太厚会顶到玻壳和板边）。',
        '装机顺序：先装 IV-18 板（两颗固定螺丝在 IN-14 小板下面），J1/J2 插好、线压平沿 x 方向走，最后才装 IN-14 小板（背面 R_A 带 170 V，线皮别贴着）。',
        '量灯丝电流用 1 Ω 电阻加示波器（清单原写 0.1 Ω 或钳表）。',
    ],
    'NIXIE-DRV_D1.1': [
        'C12（47 µF，5×11）会顶到上方 HV-UNI 板边：朝 −x 方向卧倒装（那边 x 50–61 是空地）。',
        'U1/U2 附近没有去耦电容：上电如果数字乱跳，在背面 U1、U2 的 16 脚和 8 脚之间各补一只 100 nF。',
        'IN-14 小板用 D1.1，旧 D1 作废（底座会压元件）。',
    ],
    'IN14-SOCK_D1.1': [
        '背面 DP 线从 J1 两排针之间穿过，只有约 0.3 mm：焊完洗净后背面刷三防漆。',
        '装机顺序：IV-18 的 J1/J2 线先插好压平，再装这块小板（背面 R_A 两端带 170 V）。',
    ],
    'HV-UNI_D1': [
        '裸板第一步就用加热台或热风焊 L1、RS1（焊盘只比电感本体多 0.55 mm，烙铁很难焊）；RS1 必须在 Q1 之前焊。',
        '板底所有插件脚剪到 ≤ 1.5 mm（6E2 板上的 Q_A 正好在 U1 7、8 脚下面）。',
        'J1/J2 排针：先把宿主板排母焊好，HV-UNI 插上、拧好四根 M3×11 铜柱，再焊排针，保证叠高 11 mm。',
        '泄放电阻 R21/R22：库存 220 k 是迷你体就要换；文档里的 C119374 没买，用库存 CCO 510 k 代替，这时断电后要等 ≥ 5 s 再碰。',
        'C6/C7（村田 1 nF）焊前看脚距，是 2.5 mm 就像 C10 一样掰到 5.0 mm。',
        'Q1 散热片就是漏极高压：带载测试时不要用手摸 Q1（清单原写“摸着温热”）；接负载前先断电。',
        'OVP 的 Q2 在未过压时可能微导通：TL431 关断时阴极实测只有约 4.2 V，经 R19/R18 把 Q2 基极抬到约 4.35 V（Vbe≈0.65 V），'
        '输出会在 200 V 出头被钳住。实测把 R19 2.2 k 改 10 k 单独不够（U2 阴极反而从 4.2 V 降到 3.69 V，Q2 仍导通）；'
        '必须在 OVK 与 VREF 之间加一只 2.2 kΩ 直插上拉（R19 拆下来的那只；没有 2.2k 贴片，2×4.7k 0603 并联≈2.35k 也可）：'
        '不用焊 U2 的小脚，直接在 R19.2（OVK）与 R18.1（VREF）'
        '两个并排焊盘之间跨焊，底部相距约 2.6 mm。2.2 k 让 TL431 过压时有约 1.5 mA 阴极电流；'
        '10 k 约 0.46 mA，刚过 TL431AILP 的 400 µA 最小阴极电流（余量小）；2.2 k 约 1.5 mA，余量大。R19 保持原来的 2.2 k 或 10 k 都可以；其他板只加上拉，不用拆 R19；'
        'R18 10 k 改 4.7 k 可作无飞线备选，需实测。没加上拉之前断开 R20 只能做测试，不能长期断开（OVP 是 322 V 的保护）。',
    ],
    'EYE-6E2_D1.1': [
        '焊任何元件前，先拿实物 GZC9-F 管座（3 只都试）插光板：9 个焊片能进槽（中间那片最紧，插不进就剪掉，它不接线），两耳孔对上 28 mm 的孔。',
        '试插时量耳朵厚度和耳下离板面的间隙：悬空就垫同高的尼龙柱，先锁螺丝再焊焊片（直接拧紧会把陶瓷耳拉裂）。',
        '右前角 V_B 前耳孔离角孔只有 6 mm：这两处的螺母和螺丝头下不要加 Ø7 垫片。',
        'R_BL1/R_BL2 用库存 470 k：焊前量本体，迷你体（< Ø1.8）就换库存的 CCO 510 k。',
        '2、8 脚焊片不焊也带 250 V：一样剪到 ≤ 2 mm 并刷三防漆。',
        'Q_A/Q_B 贴板装（顶高 ≤ 7 mm），正上方是 HV-UNI 的 U1 引脚。',
        '量灯丝电压前要先把两支管插好（清单原来写到第 3 步才插管）。',
    ],
    'GEIGER-MAIN_D1': [
        '右前角 (235,115) 的铜柱两头都用尼龙螺丝（离 400 V 太近），J_HV 板底焊点剪平、套热缩。',
        '通电时调 VR1 要用塑料调节棒（Q1 集电极 400 V 以上离 VR1 只有 2.4 mm）；断电时量 VR2 的 1–2 脚确认是 0 Ω 再开始调。',
        'J2 ↔ ESP 底板 J_GM 的线要 1 对 1 同向（反了会把 ESP 的 GPIO18 接到 +5 V）。',
        '如果选电磁式 LS2：R74 用库存 470 Ω，C72 用 1 µF 电解（“+”接 R74 那侧，板 (19,50)）；LS1、LS2 焊上后互相盖住，先试听再焊。',
    ],
    'GEIGER-CLIP_D1': [
        '两只夹子在长槽里各往外挪 0.5–1 mm 再焊（夹子实宽 7.5，按中心焊会压到玻壳过渡处）；顺便量一下 J305 两端金属帽的圆柱段长度。',
        '夹着管子时每只夹子只点焊 1 个脚，取下管子再焊满（别把热传给管子）。',
        '夹子板前沿贴着前面板亚克力：亚克力用 ≤ 0.2 mm 的胶，或把夹子板 x ≥ 25 那段前沿锉掉 0.5–1 mm（最近的铜在 1.65 mm 处）。',
        '右孔板下的尼龙螺母平边朝左装，阳极夹右脚的焊点板底剪平、别堆锡。',
        '盖革窗的亚克力必须装：窗后 4.5 mm 就是 400 V 的焊线盘。',
    ],
    'SLANT_D1.1': [
        '背面 J_12V 和 J_K4 塑料座重叠 1.3 mm：先焊 J_K4，J_12V 不装 XH 座，12 V 线直接焊进两个孔（1 脚 (107.25, 9.5) 是 +12 V）。',
        'C12A 本体压到 J_K1 外框：先焊 J_K1，C12A 抬高约 1 mm、往 +y 方向掰开；它的正极是靠近 J_K1 那个孔 (67, 8.5)。',
        '板子固定（前壳已下单不开孔）：上沿两个 M3 孔各装 M3×6 铜柱，前端套垫片用 AB 胶粘在斜面内表面（先打毛喷粉）；编码器轴进孔、推子拨杆进槽，板子自动对正，夹住等胶干。下沿两孔不用。',
        '编码器先插在板上不焊，把板扣到面板上、三个套筒都进孔后再焊（套筒 Ø7 进 Ø7.2 孔，喷粉后更紧）；插不进就用 Ø7.5 钻头扩孔。',
        '编码器旋钮底面离面板要 ≥ 5 mm（套筒伸出 3 mm + 按压行程）。',
        '左缺口切完会露出 GND 铜：切口涂指甲油或三防漆。双口 USB 右耳螺丝最长 M3×6。',
        'RKS1–RKS6 改焊 10 kΩ（键线压错时防 12 V 灌进 Pico）；插 Pico 之前量每个 J_K 的 1 脚对地不是 12 V。',
        '模式开关 CM 改焊 10 nF（读数更稳）。',
    ],
    'KBD-ADAPT_D1': [
        'USB 线序检查：实测 J_USB-2 = 键盘 D+、3 = D−（与网传相反）；按 XH1 红 5V / XH2 绿 D+ / XH3 白 D− / XH4 黑 GND 压线，线色不可信，先用表认线。',
        'M2 固定螺丝用小头的（螺丝头和 H_TEST 塑料座角重叠 0.1–0.2 mm）。',
    ],
    'ESP-BASE_D1': [
        'J_PI、JP_BZ 焊上后看不出 1 脚：焊前用记号笔标好；接 Pi 前用蜂鸣档确认 J_PI-3 和 GND 通（插反会把 Pi 16 脚短到地）。',
        'J_INST、J_I2C、J_GM 的 1 脚在最右，J_E2、J_MTR 的 1 脚靠前，和旁边的插座方向相反、也没有方焊盘：按丝印槽口焊、标“1”；第一次插 J_INST 前先量线束这头最右一脚是 +24 V。',
        'C5（100 µF）贴着开发板天线端的角：焊 C5 前先把开发板插上比一下，必要时略往 +x 斜。',
        '焊开发板两条排母时把开发板插着一起焊，让排母间距自己对上（实物约 23.0，板上 22.86）。',
        'J_RTC 旁没有“32K”丝印：DS3231 模块的 32K 脚对方焊盘（左边）那头。',
        '联调辉光和 IV-18 时用示波器看 SCK 波形，有台阶或振铃先在固件里降 GPIO 驱动和 SPI 速度。',
    ],
}

# 不属于某一块板、在装配流程里单独列的
HARNESS = [
    '板间线束全部自己压线（XH 胶壳 + 端子 + 压线钳），长度按实际量，没有 30/50 cm 的限制。',
    'EL-IF ↔ Dock 的 2×6 线做成镜像线（见 EL-IF 那一条），装之前量信号脚确认。',
    'EL 屏 DF11 线只有 20 cm：EL-IF 已改到电脑层板下面、屏背后（10-28 定），屏线约 12 cm 够用。',
    '每根线做完都量一遍两头 1 脚对 1 脚，贴标签写明两头接哪块板、哪个插座。',
]
