huatanshaonian/EL-center/frame_spec.py

"""
MIS-01 机架下料与加工数据（型材 + 隔板），供 fig_frame_drawing.py 出图、procurement/make_frame_list.py 出清单共用。
连接方式（2026-10-20 用户选“端面攻丝”）：
- 左右横梁 280 ×4、甲板/电脑层前后纵梁 180 ×4：两端端面攻丝，螺丝从立柱外侧穿过立柱通孔锁入。
  原图写 M5；实物卖家攻的是 M6（2026-10-26 用户量锁横梁的螺丝外径 6，这款 2020 中心孔约 Ø5）。立柱通孔、螺丝长度没量，下面按 M6 推算。
- 四根立柱底端也攻了 M6（2026-10-26），装铝脚垫：M6×16 顶丝穿底板四角 Ø6.5 孔拧进去。
- 底、顶的前后纵梁 180 ×4：和左右横梁在同一高度接同一根立柱，两颗螺丝会在立柱中心相撞，所以这 8 个接头改用 L 型角码。
尺寸来源：assembly.py frame()、assembly_base.py（W×D×H = 320×220×420，甲板 90，电脑层 260）。
"""
from assembly_base import W, D, H, Z_DECK, Z_SHELF, PLATE_T

PROFILE = "2020 欧标铝型材（6 槽）"
TAP = dict(thread="M6", depth=15)                                  # 端面攻丝：实物 M6（原图 M5，见上）
HOLE = dict(d=6.5, cb_d=11.0, cb_depth=6.5)                        # 立柱通孔 + 沉孔（按 M6 内六角圆柱头推算，实物未量）
SCREW = "M6×25 内六角圆柱头（长度按图推算，实物未量）"

# 立柱上的孔：高度从立柱下端量起（mm）
POST_X_HOLES = (10.0, H - 10.0)                                   # 接左右横梁（前下/前上 或 后下/后上），孔沿左右方向
POST_Y_HOLES = (Z_DECK - 10.0, Z_SHELF - 10.0)                    # 接甲板、电脑层纵梁，孔沿前后方向

POSTS = [  # 编号, 位置, 横梁孔沉孔面, 纵梁孔沉孔面
    ("A1", "前左", "左侧面（朝外）", "前面"),
    ("A2", "前右", "右侧面（朝外）", "前面"),
    ("A3", "后左", "左侧面（朝外）", "后面"),
    ("A4", "后右", "右侧面（朝外）", "后面"),
]

# 编号, 名称, 长度, 数量, 加工, 用在哪
PROFILES = [
    ("A", "立柱", H, 4, f"按 A1–A4 图打孔：每根 4 个 Ø{HOLE['d']:g} 通孔，一侧沉孔 Ø{HOLE['cb_d']:g} 深 {HOLE['cb_depth']:g}；"
                        f"底端端面攻 {TAP['thread']}（装脚垫）", "四角立柱"),
    ("B", "左右横梁", W - 40, 4, f"两端端面攻 {TAP['thread']}，深 {TAP['depth']}", "前下、前上、后下、后上"),
    ("C", "前后纵梁（甲板、电脑层）", D - 40, 4, f"两端端面攻 {TAP['thread']}，深 {TAP['depth']}", f"甲板层（顶面高 {Z_DECK}）、电脑层（顶面高 {Z_SHELF}），左右各一"),
    ("D", "前后纵梁（底、顶）", D - 40, 4, "只切长度，不攻丝（用 L 型角码连接）", "底层、顶层，左右各一"),
]

# 隔板：编号, 名称, 长(左右) x 宽(前后) x 厚, 材料, 切角, 安装孔 [(x, y)]（板自身坐标，原点=左前角）, 孔径, 说明
_rail_y = lambda y0, ys: [(8.0, y - y0) for y in ys] + [(W - 4 - 8.0, y - y0) for y in ys]   # 搭在左右纵梁中心线（全局 x=10 / 310）
PLATES = [
    ("P1", "甲板（管座层）", (W - 4, D - 24, PLATE_T), "橘红色电木板（酚醛层压板）4 mm", "前两角各切 18×18 让开立柱",
     _rail_y(2, (40, 110, 180)), 4.5, f"放在 C 纵梁上，顶面高 {Z_DECK}；板从全局 y=2 到 198"),
    ("P2", "电脑层板", (W - 4, D - 52, PLATE_T), "橘红色电木板（酚醛层压板）4 mm", "无",
     _rail_y(30, (50, 115, 180)), 4.5, f"放在 C 纵梁上，顶面高 {Z_SHELF}；板从全局 y=30 到 198"),
    ("P3", "顶板", (W, D, PLATE_T), "橘红色电木板（酚醛层压板）4 mm", "无",
     [(10, 60), (10, 160), (W - 10, 60), (W - 10, 160), (110, 10), (210, 10), (110, D - 10), (210, D - 10)], 4.5,
     "盖在顶层一圈型材上；中间通风孔 Ø8 × 78 个（x 40–280、y 60–160，间距 20）"),
    ("P4", "底板", (W, D, PLATE_T), "橘红色电木板（酚醛层压板）4 mm", "无",
     [(10, 60), (10, 160), (W - 10, 60), (W - 10, 160), (110, 10), (210, 10), (110, D - 10), (210, D - 10)], 4.5,
     "垫在底层一圈型材下面；电源等安装孔以后按布置再加"),
]
VENTS = [(40 + i * 20, 60 + j * 20) for i in range(13) for j in range(6)]
# 零散 M3 孔（板自身坐标）：P3 顶板上原计划吊 EL 接口板的 4 个孔。顶板已按这个做好（带着这 4 孔）；2026-10-28 EL 接口板改吊电脑层板下，这 4 孔空着不用
EXTRA_M3 = {"P3": [(165, 45), (255, 45), (165, 135), (255, 135)]}

# 电路板孔阵（PCB安装与空间规划建议.md 第 4 节）：Ø3.2，间距 10，孔心在全局 X、Y = 10 的倍数 + 5；
# 自制板长宽取 10 的倍数、四角 M3 孔离板边 5，放在哪都能对上。范围避开型材和隔板固定孔。
GRID_D = 3.2
GRID = {  # 编号: (板左前角的全局 x, y), 孔阵范围（全局 x0, x1, y0, y1，含端点）——左右以 x=160 对称，前后以板中线对称，离板边约 33 以上
    "P1": ((2, 2), (45, 275, 35, 165)),      # 甲板 y 2–198，中线 100
    "P2": ((2, 30), (45, 275, 65, 165)),     # 电脑层板 y 30–198，中线 114≈115
    "P4": ((0, 0), (45, 275, 35, 185)),      # 底板 y 0–220，中线 110
}

# 层板已做好（2026-10-23），下面这些孔装配前自己钻（全局坐标）：编号: [(x, y, 孔径, 名称, 说明)]
# 孔径 None = 按实物配钻（把板/模块放到位，从它的孔里画线）。和孔阵孔中心距都 ≥ 3.8（中间留 ≥ 0.8 电木）。
# Pi / Dock 孔来自 assembly_computers（Pi 口面 174.2、Dock 口面 172.7、DOCK_X0 167.5；2026-10-23 Pi 后移 1.5、Dock 左移 2.5 躲孔阵和后走线孔）
DRILL = {
    "P1": [(215, 20, 3.4, "6E2 板", "四角 M3×6 铜柱"), (295, 20, 3.4, "6E2 板", ""), (215, 100, 3.4, "6E2 板", ""), (295, 100, 3.4, "6E2 板", ""),
           (185, 175, 3.4, "盖革主板", "后两孔，前两孔在孔阵"), (235, 175, 3.4, "盖革主板", ""),
           (296.5, 10.8, 3.4, "盖革夹子板", "右孔，M3×12 尼龙螺丝"),
           (148, 8, 3.4, "IV-18 主板", "前右孔，另两孔在孔阵"),
           (181, 61, 3.4, "XL6009", "模块 43×25 放 x 178–203、y 55–98，对角两孔，M3×5 尼龙柱"), (200, 92, 3.4, "XL6009", ""),
           (120, 187, 6.5, "SMA 天线座", "ESP 自带 IPEX→SMA 线，螺纹朝上")],
    "P2": [(73.03, 118.29, 2.8, "Orange Pi 4", "M2.5×25 铜柱"), (158.14, 118.29, 2.8, "Orange Pi 4", ""),
           (73.03, 168.74, 2.8, "Orange Pi 4", ""), (158.14, 168.74, 2.8, "Orange Pi 4", ""),
           (171.5, 103.0, 2.8, "Dock", "M2.5×6 铜柱"), (258.5, 103.0, 2.8, "Dock", ""),
           (171.5, 168.0, 2.8, "Dock", ""), (258.5, 168.0, 2.8, "Dock", ""),
           (91, 43, 3.4, "USB Hub", "模块 66×50 放 x 87–153、y 40–90，M3×6 铜柱"), (149, 43, 3.4, "USB Hub", ""),
           (91, 87, 3.4, "USB Hub", ""), (149, 87, 3.4, "USB Hub", ""),
           (225, 85, 25.0, "PMOD 过线孔", "EL-IF P1–P3 → Dock 2×6 座的 3 根线；圆心就是这个孔阵孔，拿它当导孔，阶梯钻 / 开孔器")]
          + [(x, y, 6.5, "EL 接口板", "孔阵孔，上面锪 90° 沉头 Ø6.5；M3×8 沉头 + M3×30 母母铜柱吊在板下" if (x, y) == (145, 65) else "孔阵孔，锪沉头")
             for x, y in ((145, 65), (235, 65), (145, 155), (235, 155))],
    "P3": [],                                                  # 原吊 EL 接口板的 4 个 M3（EXTRA_M3，顶板已做好带着）2026-10-28 起不用
    # LRS-200-24 底面 4-M4（明纬规格书 Case 207：离端子端 32.5、孔距 150；离长边 32.5、孔距 50；螺丝伸入壳内 ≤ 3）
    # 电源放 x 22.5–237.5、y 82.5–197.5，四孔正好落在孔阵 (55/205, 115/165) 上：只把这 4 个 Ø3.2 孔扩成 Ø4.5，M4×6 内六角或盘头（底板已做好不锪窝；脚垫 6 高，螺丝头 ≤ 4 碰不到桌面）；最长 M4×7
    "P4": [(x, y, 4.5, "LRS-200-24", "孔阵孔扩到 Ø4.5；M4×6，伸进壳内不能超过 3 mm" if (x, y) == (55, 115) else "")
           for x in (55, 205) for y in (115, 165)]
          + [(x, y, 6.5, "脚垫", "立柱中心；M6×16 顶丝穿过拧进立柱底端（底端没螺纹就自己攻 M6）" if (x, y) == (10, 10) else "")
             for x, y in ((10, 10), (310, 10), (10, 210), (310, 210))]
          + [(171, 33, 3.4, "PAM8403", "模块 24×15.5 放 x 150–174、y 30–45.5，右侧两孔，M3×3 尼龙柱"), (171, 42.5, 3.4, "PAM8403", "")],
}

# 层间走线长圆孔（全局坐标）：编号: [(中心 x, 中心 y, 宽 x, 长 y)]；宽 14 够穿线束和 XH 插头
SLOTS = {
    "P1": [(29, 145, 14, 50), (291, 145, 14, 50), (160, 183, 50, 14)],
    "P2": [(29, 150, 14, 50), (291, 150, 14, 50), (160, 179, 50, 14)],
}


def slots(code):
    """返回走线孔（板自身坐标）：[(中心 x, 中心 y, 宽, 长)]"""
    if code not in SLOTS:
        return []
    ox, oy = GRID[code][0]
    return [(x - ox, y - oy, w, h) for x, y, w, h in SLOTS[code]]


def grid_holes(code):
    """返回该板孔阵孔心（板自身坐标）；没有孔阵返回 []"""
    if code not in GRID:
        return []
    (ox, oy), (x0, x1, y0, y1) = GRID[code]
    return [(x - ox, y - oy) for x in range(x0, x1 + 1, 10) for y in range(y0, y1 + 1, 10)]

# 五金：名称, 规格, 数量, 用途
HARDWARE = [
    ("内六角圆柱头螺丝", SCREW, 16, "立柱通孔锁入 B、C 端面（8 + 8）"),
    ("2020 L 型角码", "20 系列 L 角码（带定位凸台），建议买套装", 8, "D 纵梁两端（底、顶 8 个接头）"),
    ("角码螺丝 + T 螺母", "M5×10 内六角 + 2020 M5 旋入式（船型）T 螺母", 16, "每个角码 2 套（套装一般自带）"),
    ("隔板螺丝 + T 螺母", "M4×10 内六角（4 mm 板；2 mm 板用 M4×8）+ 2020 M4 旋入式（船型）T 螺母", 28, "P1 6 + P2 6 + P3 8 + P4 8"),
    ("M4 旋入式 T 螺母（多备）", "2020 M4 旋入式（船型）", 30, "前后面板、EL 屏托架、以后挂支架和线夹；旋入式能在装好后从槽口放进去"),
    ("M4 螺丝套装", "M4×8 / ×10 / ×12 内六角，各约 20", 1, "面板、托架、隔板"),
    ("接地螺丝 + 环形端子 + 齿形垫圈", "M4 螺丝 + M4 T 螺母 + M4 环形端子（配 1–1.5 mm² 线）+ M4 外齿垫圈", 2, "市电安全必备：IEC 插座地线、LRS-200 的 FG 接到机架；型材阳极氧化膜绝缘，齿形垫圈咬破氧化膜才导电（或先把接触点磨亮）"),
    ("脚垫", "铝合金脚垫 高 6、M6 螺孔 + 1 mm 垫圈 + M6×16 顶丝（无头内六角）", 4, "四根立柱底下：顶丝穿底板 Ø6.5 孔拧进立柱底端（立柱底端要攻 M6）"),
    ("（可选）2020 槽封条", "黑色或银色，按需剪", 1, "左右两侧敞开，露在外面的槽卡上更整齐"),
    ("（可选）型材线夹 / 扎带座", "2020 槽用", 10, "固定机内走线"),
]
