huatanshaonian/EL-center/weld_special.py

"""每个位号的“特殊焊法 / 装配方向”，焊接图在元件行里标橙色的“特殊焊法”标签。

只收录不照做会装不上、装错或顶到别的件的元件级注意；整板的注意事项在 assembly_issues.py
（页面顶部“焊前必看”）。键是焊接图的板名 tag，和 assembly_issues.py 的 ISSUES 一致。
"""

SPECIAL = {
    'NIXIE-DRV_D1.1': {
        'C12': '朝 −x 方向卧倒装（5×11 会顶到上方 HV-UNI 板边；x 50–61 是空地）。',
        'J_HH': '单针排母垂直贴板，否则 HV-UNI 插不正。',
        'J_HP': '排母垂直贴板，否则 HV-UNI 插不正。',
    },
    'HV-UNI_D1': {
        'C6': '脚距是 2.5 mm 就像 C10 一样把两脚掰到 5.0 mm 再插。',
        'C7': '脚距是 2.5 mm 就像 C10 一样把两脚掰到 5.0 mm 再插。',
        'C10': '脚距 2.5 mm：两脚掰到 5.0 mm 再插。',
        'C8': '400 V 电解，极性不能反。',
        'Q1': '立装，散热片就是漏极高压，套热缩管。',
        'L1': '大焊盘贴片：裸板先用加热台或热风焊，再焊插件。',
        'RS1': '大焊盘贴片：裸板先用加热台或热风焊，再焊插件；必须在 Q1 之前焊。',
    },
    'PWR-DIST_D1.1': {
        'C_IN5': '470 µF 离 NID100 末端只有 0.8 mm：贴板竖直焊、略往 +x 偏，最好把模块插上再焊。',
        'C_IN12': '470 µF 离 NID100 末端只有 0.8 mm：贴板竖直焊、略往 +x 偏，最好把模块插上再焊。',
        'C_DVC': '3.3 nF 和 1 nF、2.2 nF 都在贴片阻容盒、没有印字：只从 3.3 nF 那条编带取。',
    },
    'SLANT_D1.1': {
        'C12A': '本体压 J_K1 外框：先焊 J_K1，C12A 抬高约 1 mm、往 +y 方向掰开；正极是靠近 J_K1 的孔 (67, 8.5)。',
        'J_12V': '不装 XH 座：12 V 线直接焊进两个孔（1 脚 (107.25, 9.5) 是 +12 V）。',
    },
    'EL-IF_D1.3': {
        'C1': '先焊，立正贴板（贴着 U1 上端，只剩 0.5 mm）。',
        'C2': '先焊，立正贴板（夹在两个座子之间，只剩 0.5 mm）。',
    },
    'IN14-SOCK_D1.1': {
        'R_A': '本体贴背面，从背面插入、在正面焊；焊点在底座圈外。',
        'J1': '塑料座贴背面，焊点在正面（管子那面）。',
        'V1': '底座在正面平贴板面，引线穿到背面焊，剪脚 ≤ 2 mm。',
        'R_PR': '0805 背面贴、背面焊；R_PL 默认不焊。',
    },
    'KBD-ADAPT_D1': {
        'H_TEST': '塑料座在正面，短针穿到背面焊；背面针脚剪 ≤ 3 mm。',
        'J_USB': '塑料座在正面，焊点在背面。',
    },
    'EYE-6E2_D1.1': {
        'V_A': '先拿实物 GZC9-F 管座插光板试，焊片剪到板下 ≤ 2 mm。',
        'V_B': '先拿实物 GZC9-F 管座插光板试，焊片剪到板下 ≤ 2 mm。',
        'Q_A': '贴板装，顶高 ≤ 7 mm（正上方是 HV-UNI 的 U1 引脚）。',
        'Q_B': '贴板装，顶高 ≤ 7 mm（正上方是 HV-UNI 的 U1 引脚）。',
    },
    'GEIGER-MAIN_D1': {
        'J_HV': '板底焊点剪平、套热缩（400 V，离右前尼龙柱很近）。',
    },
    'GEIGER-CLIP_D1': {
        'CLA1': '两只夹子在长槽里各往外挪 0.5–1 mm 再焊，别压到玻壳过渡处。',
        'CLK1': '两只夹子在长槽里各往外挪 0.5–1 mm 再焊，别压到玻壳过渡处。',
    },
    'IV18_D1': {
        'J1': '焊完把板底焊脚剪平到 ≤ 0.8 mm。',
        'J2': '焊完把板底焊脚剪平到 ≤ 0.8 mm。',
    },
    'ESP-BASE_D1': {
        'C5': '贴着开发板天线端的角：焊前先插上开发板比一下，必要时略往 +x 斜。',
    },
}
