huatanshaonian/EL-center/(commit log)

2026-10-18 初始化仓库：MIS-01 整机建模脚本、EL 驱动设计资料、EL 屏测试时序 FPGA 程序
    仓库范围：只收代码和文字。STEP/PDF/渲染图/嘉立创 .epro2/Excel 等大文件不进仓库，
    按版本另存在本地；仿真测试（sim/）与编译产物（build/、impl/）按约定不进仓库。
    内容：
    - 根目录：整机 3D 建模 Python 脚本（assembly*.py、parts*.py、render*.py 等）、
    parts_list.csv、EL 屏工程设计笔记、面板方案。
    - el_driver/：EL 接口板 D0/D1/D1.1 各轮文字资料、D1 与 D1.1 导出网表（.net，便于对比改版）、
    D1.1 变更记录；面包板实验文档 D1.1 及 7 张接线图和生成脚本。
    面包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
    [parts_list.csv]
2026-10-18 新增 HDMI → EL 完整 FPGA 程序（el_hdmi），并改用开源工具链编译
    功能（fpga/el_hdmi/，使用说明见 el_hdmi/使用说明.txt）：
    - HDMI 接收：EDID（自报 “MIS-01 EL”，只宣告 640×480）、HPD、TMDS 时钟恢复/解串/对齐/解码。
    复用 tang-monitor（commit 1239ace，MIT，已在同款 Dock 上实测），代码头部保留出处与许可；
    hdmi_clk_rx 删掉原工程给 LCD 用的第二个 rPLL。另备 27 MHz 版 EDID（设计笔记 U12 退路）。
    - 转黑白 pixel_mono：Y=(77R+150G+29B)>>8 与阈值比较；可选 4×4 Bayer 抖动、反色。
    - fb_writer（像素时钟域）：按 DE 间隙识别帧边界（不依赖 VSYNC 极性）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
2026-10-19 EL 接口板 D1.2 第一版 PCB；FPGA 增加斜面"屏幕"开关输入（J14-12）
    EL-IF 原理图 D1.1 → D1.2（详见 el_driver/D1.2/变更记录_D1.2.txt）：
    - RIL12 1.3k 无现货改 1.2k，eFuse 限流 2.56 A → 2.78 A
    - J_PF 改 3 针：PFAIL_N / SCR_EN_3V3（屏幕开关）/ GND；新增 RSCR 10k 上拉、
    D4 BAT54WS（开关关时把 EN_VD 拉低，硬件关屏）；P3-12 由空闲脚改为 SCR_EN_3V3 送 FPGA
    - 新增 J_LAMP（+12V_EL / GND）给面板黄灯
    EL-IF PCB（100×100 两层板）布局布线完成，DRC 0 间距/连接错误：
    - 修复：自动布线漏接两颗 TPS259470 的 IN/OUT（0.3 mm 长条焊盘进不去 1.0 mm 以上电源线宽，
    四周又被信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
    [el_hdmi_top.v, screen_switch.v]
2026-10-19 设计笔记 v0.3：按 EL-IF D1.2 第一版 PCB 同步 §10/§11/§15
    设计笔记仍按 D1.1 之前的方案写，与已提交的 D1.2 原理图/PCB（e2f044c）有四处不一致，本次统一：
    - 15.3 PCB-1 尺寸：≤80×60 mm → 实际 100×100 mm，安装孔中心距板边 5 mm
    （原尺寸放不下两颗 eFuse 的电源走线和测试点）。
    - U_VD 限流：RIL12 1.3k 无现货改 1.2k，I_LIM = 3334/1200 ≈ 2.78 A；
    10.1 电源树与 15.3 电路块 D 的"≈2.5 A"改为"≈2.8 A"并写出算式。
    - J_PF 2P → 3P：2 脚 SCR_EN_3V3 接斜面"屏幕"开关（RSCR 10k 上拉，D4 拉低 EN_VD），
    同步修改 11.2.1 J14-12、15.2 网络表、15.3 连接器表/电路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
2026-10-19 EL-IF D1.2 下单前整理：丝印重排、测试点标名、Gerber 核对、库存核对；Dock VCCIO 核实
    PCB（嘉立创工程内修改，制板文件只存本地）：
    - 丝印：原有 160 处位号压焊盘/互相重叠（三排插件电阻位号压在相邻电阻焊盘上，制板会被裁掉）。
    插件电阻位号改到本体中间；其余元件程序自动摆放（不压焊盘/过孔/文字，且离自己最近），
    eFuse 附近 5 个手工指定；35 个测试点补网络简称；J_UART/J_PF/J_LAMP 加针脚说明。复查 0 冲突。
    - TP12（VD_ON_N）焊盘 Ø2.4→Ø1.8：位于测试点阵中间，原尺寸放不下标签；铺铜已重灌，DRC 无新增错误。
    -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
2026-10-19 EL-IF D1.2 变更记录：插件按库存 + 10-20 立创订单逐项核对配齐
    - 全部插件已有来源（库存或在途），无需再买。
    - P1–P3 以已买的 PZ254V-12-12P（C45384664）为准，原 BOM 的 C9900165112 是嘉立创占位条目。
    - J_PF 改 3P 后用已买的 XH-3A（C2908601）；10-19 订单的 XH-2A 是按旧 2P 下的，改用于 J_LAMP。
    - 嘉立创贴片件中缺货的只有 U_NOR、CDV12，替换料待确认。
    - 订单已并入本地库存表（不进 git）：总库存加在途行、新增采购记录页、概览改公式统计。
2026-10-19 EL-IF D1.2 变更记录：贴片缺货件暂不换料，改为下单前按清单复查
    U_NOR（SN74LVC1G02DBVR）、CDV12（2.7nF C0G 0805）2026-10-20 缺货，打板可能在一周后，库存会变。
    料号先不改，备选料号和复查方法写在 制板文件/下单前核对.txt（本地，不进 git）。
2026-10-19 README：标注第 2、3 节为第一轮布局已过时，更正电源型号
    用户要求文档与新信息不符时及时修正。README 仍描述第一轮布局（编码器在下舱、SI-3BG 盖革管、
    LRS-150-24 + NID65-12），已与 面板方案.md（E11）、MIS-01整机架构.md、parts_list.csv 不符：
    - 文首加提示，指明现行资料所在文件和主要不符之处（含仪表层为 ESP32-S3）。
    - 电源型号改为 LRS-200-24 / NID100-12。
2026-10-19 README：盖革管定为 J305（用户 2026-10-20 确认，不再二选一 HAC2311S）
2026-10-19 更正 Orange Pi 4 串口电平与接法：排针 IO 为 3.0 V，FPGA 串口接 UART4（19/21 脚）
    原文写"直接引到 Orange Pi 4 的 3.3 V UART"。按 Orange Pi 4 官方原理图 v1.3 与 Armbian
    rk3399-orangepi-4.dts 核实（2026-10-20）：40 针排针 GPIO1/GPIO4_C 组由 RK808 LDO8 供电，为 3.0 V；
    排针上唯一可用的通用串口是 UART4（19 脚 TX、21 脚 RX，需 rk3399-uart4 overlay，与 SPI1 互斥），
    UART2 是调试控制台。
    - 设计笔记 15.2/15.3/15.5：写明 UART4 脚位、/dev/ttyS4、3.0 V 电平及 FPGA→Pi 方向靠 RTX 串阻限流。
    - el_hdmi 使用说明：补 UART4 接线与 overlay 开法，示例命令改为 /dev/ttyS4。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
2026-10-19 新增 ESP32-S3 功能规格 v0.1（写程序的唯一依据）
    ESP32-S3 承担电源握手、高压使能、辉光钟、IV-18、表头、盖革、传感器等多项功能，且有几条写错会损坏
    器件的规则，用户要求先把功能记清楚，避免写程序时出错。按接线细化方案 D1–D4、D13 决定整理：
    - 第 0 节安全规则：IV-18 不许某位常亮（35 V 高于原厂 25 V 占空比门限，BLANK 板上默认上拉）、看门狗、
    HV_EN/HOLD 默认关与超时、PI_SHDN_REQ 只许开漏（Pi 排针 3.0 V）、灯丝方波不许停、先无管验证波形。
    - 第 1 节逐脚分配（N16R8 不可用 35–37；38/48 为板载灯）；IV-18 方案新增的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
2026-10-19 ESP32-S3 功能规格 v0.2：D9 定为加 DS3231 RTC（I2C 0x68），更新 F12 时间来源
2026-10-19 EL-IF RTX 100 Ω → 1 kΩ；ESP 规格 v0.3 预留 PCA9555 焊位（整机接线方案 D6、D7）
    D7 原因：Orange Pi 4 排针 IO 为 3.0 V，FPGA 发送的 3.3 V 高电平比其电源高 0.3 V，正好在输入极限上，
    经输入保护二极管倒灌。RTX 改 1 kΩ 把倒灌电流限到原来的 1/10，115200 波特率不受影响。
    - 嘉立创工程：原理图 RTX 实例的 Value/描述/商城名改为 1 kΩ 并保存，PCB 元件属性同步并保存；
    BOM 重新导出（1 kΩ ×12 含 RTX，100 Ω 只剩 RRX），制板文件已更新（本地）。
    API 放置新器件会卡住，所以只改实例属性，RTX 仍挂在"TH 100Ω"器件上，已在变更记录注明。
    - 设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
2026-10-19 设计笔记：J_PF 改为经 PCB-3 转接屏幕开关（整机接线方案 D12）
    屏幕钮子先接 PCB-3，再由 PCB-3 的 J_PF（3P，与 EL-IF J_PF 一一对应）送到 EL-IF，
    PCB-3 高阻读取开关状态给 ESP32-S3。原 15.3 写的线束在 PCB-1 侧合并作废；15.5 PCB-3 的 J_PF 由 2P 改 3P。
2026-10-19 ESP32-S3 功能规格 v0.4：接线方案 D11（Pi 22 脚关机请求）、D12 定稿，待定项移除
2026-10-19 ESP32-S3 功能规格：开发板为微雪 ESP32-S3-DEV-KIT（非乐鑫 DevKitC-1），排针中心距实测约 23.0 mm（按 22.86 设计）；标注引脚分配待按微雪原理图核对
2026-10-19 README：NID100-05 更正为明纬正式型号 NID100-5
2026-10-19 ESP32-S3 功能规格 v0.5：按微雪 ESP32-S3-DEV-KIT 原理图修正引脚
    问题：v0.1 把 IV-18 的 XL6009 开关和灯丝驱动放在 GPIO43/44，但微雪板上这两脚经 0 Ω 硬连
    板载 CH343P USB 串口芯片（插 USB 时 CH343 的 TXD 一直驱动 GPIO44），不能当输出。
    修正：IV18_PWR_EN 改 GPIO46（启动配置脚，底板下拉正好满足上电为低），IV18_FIL 改 GPIO48
    （微雪板 RGB 灯在 GPIO38，48 空闲）；43/44 保留作调试日志口。补充：排针与乐鑫 DevKitC-1 同序、
    单 USB-C 经板载 CH334F Hub 同时出原生 USB 与 CH343 串口、5V 排针经二极管可作输入。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
2026-10-19 整机建模与文档：按接线方案 v1.0 和原厂规格书更新 3D 模型、整机架构、零件清单
    3D 模型
    - 总装（布局 E11）：Orange Pi 4、FPGA Dock 从总装拿下，作为未安装模块，等第一版 PCB 出来再布置；后面板的电脑接口窗一并去掉。
    - 盖革管 SBM-20 改为 J305（Ø11×111），P31 模型随之改名。
    - 电源 LRS-150-24 换成 LRS-200-24，市电端子罩按新外形重画。
    - EL 屏 LJ64K052 按规格书 p.12 修正：厚 23.5，两组安装孔，CN5 位置；托架改用 Ø3.5 孔锁 M3。
    - 表头 85C1 按浦江 Enerdis 样本修正：原来画的 4 颗螺柱是错的，实为 2 颗 M3（孔距 52，在表心下方 13），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
    [parts_list.csv]
2026-10-19 PCB-3 电源板（PWR-DIST）原理图 D1：在嘉立创工程中补齐 4 页并接入原 PFAIL 三页
    按 PCB-3 电路方案 v1.0（P1–P5 已定）画出：
    - PWR1 24 V 输入（3557-2 片式保险座 10 A、SMBJ30A、470 µF）、NID100-12/-5（各 7.5 A 保险，R.C. 引到 J_RC，
    输出电容按明纬容性负载上限 68/100 µF 配）、ME6211 3.3 V。
    - PWR2 主机域：主机钮子（反相）与 ESP HOLD 二极管或成 EN_HOST，四颗 TPS259470L（Pi 680 Ω≈4.9 A、Hub 1.2 k、
    EL 12 V 910 Ω、EL 5 V 3.32 k），绿灯 AO3400。AUXOFF/FLT/ITIMER 按 TI 规格书悬空。
    - PWR3 高压域三路 P-MOS（钮子 + BSS138/HV_EN 串联才导通，断线即关）、J_PANEL、J_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
2026-10-19 PWR-DIST 设计记录：HV-A/HV-B 改接自制 UC3843 通用高压小板（不买 NCH6100HV 与 250 V 模块）
    用户 2026-10-20 定：辉光管 170 V 与 6E2 250 V 统一用一种 UC3843AN 直插升压小板（12 V 输入，150–280 V 可调，
    独立成板便于单独调试），做 3 块含 1 块备用。原定照搬 Jan Rychter TPS40210 设计作废。电源板电路不变。
2026-10-20 键盘转接小板 KBD-ADAPT D1：原理图 + PCB 完成（X1 Tablet Gen3 键盘 FPC → USB）
    按用户实测针位画板（面对座子开口从右数第 k 根）：k1–10 各引到 13 针测试排针，k11–40 GND、k41 单独、
    k42–51 +5V；XH 4P 输出 5V/D−/D+/GND，全部经 0603 0 Ω（可改接），D+/D− 对调位与检测脚 10 kΩ 下拉位默认不焊。
    座子 FH43BW-71S-0.2SHW(10)（C2840145）：按广濑图纸核实为底部接触、1 脚在开口朝向自己时的左端，
    故第 k 根 = 第 72−k 号脚；导入 PCB 后实测 71 号脚（k1）在左端前排，一致。
    PCB 40×30 mm 两层，四角 M2：0.2 mm 座子扇出手工计算并本地几何检查（0.1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
2026-10-20 PWR-DIST 原理图自查 + ngspice 仿真：修正高压开关关不断的问题，PFAIL 分压改 12k+1k
    用户委托自查。用嘉立创仿真引擎包自带的 ngspice 对两块模拟电路建模（网表 el_driver/PWR-DIST_D1/sim/*.cir）：
    1. 高压开关 bug：三路 P-MOS 栅极原共用一个 BSS138 下拉节点。HV_EN 关闭时该节点悬空，电流从 12 V 路栅极
    经公共节点流向 5 V 路栅极，HV-A 栅压被拉低约 2.7 V 而半导通（仿真输出 11.8 V）。
    修复：每路一个 BSS138（Q_HVEN_A/B/C，网络 HV_GATE_A/B/C_N），关闭时三路互相隔离；
    HV-C 栅极电阻 4.7k→1k（5 V 源下 Vgs −3.4→−4.5 V，NCE40P05Y 开启电压最大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
2026-10-20 PCB-3 电源板（PWR-DIST）D1 PCB 布局布线完成，DRC 通过，制板文件已导出
    - 板子：150×100 mm、2 层、1.6 mm、2 oz；四角 M3 孔离边 5，对准层板孔阵。
    - 布局：24 V 输入与模块保险在右，两个 NID100 横放中间，四颗 TPS259470L 电子保险和 Pi/EL/Hub 端子在左，
    XH 插座排上板边，备用输出在下板边和右板边；螺丝端子进线口朝板外，保险座夹片与电解/TVS 极性已按封装核对。
    - 布线：大电流主干按坐标手画（3 mm/2 mm/1.6 mm，脚本做 0.2 mm 间距检查），其余 69 个网络自动布线后
    电源线加宽到 0.4–0.8 mm；两层整板铺 GND，贴片地焊盘就近打过孔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
2026-10-20 PWR-DIST 设计记录：补 PCB-3 采购清单结论与交接事项
    - 对照第一单立创订单 BOM261019002514 与库存表，PCB-3 直插件只需另买 7 种（470µF 50V、3557-2 保险座、
    2P 端子、XH-8A、XH-4A、1×3 排针、Mini 7.5 A 片式保险），其余已够；贴片件由嘉立创随单贴装，不用单独买。
    - 记下 U_N12 库器件名显示为 NID100-24、实物用 NID100-12（封装引脚相同），避免照 BOM 误购。
    - 记下 STEP 已交 3D 模型会话。
2026-10-20 PWR-DIST 设计记录：更正铺铜卡死的原因（新建焊盘触发，非 isLast），去掉电源模块提示
    - 更正 e1fbc33 里的判断：rebuildCopperRegion 卡死并不是 isLast:false 写死造成（界面自身也传 false）。
    复现确认真正触发条件：当前会话里用 pcb_PrimitivePad.create 新建过焊盘后，主机端重建铺铜出错，
    其处理函数先把进度置 0、出错后没有复位，于是进度条停在 0%，界面 Shift+B 也一并卡住；
    保存后关闭再打开 PCB 页即恢复，增删过孔/导线不触发。另记接口返回的是第一个铺铜的结果。
    - 修复方式（绕过）：重建铺铜改为"保存 → 关闭并重开 P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
2026-10-20 PWR-DIST 设计记录：铺铜卡死问题在嘉立创 V4.1.78 上复测仍存在
    - 升级到客户端 V4.1.78 / pro-api 0.3.53 / pro-pcb 4.1.67 后，按原步骤（接口新建焊盘后重建铺铜）复测，
    仍报 L3() 读 undefined.length，主机处理函数 pcbRebuildCopperRegion 代码未改；继续使用重开页面后重建的绕过脚本。
2026-10-20 PWR-DIST 设计记录：补 PCB-3 装机方式（元件朝下倒挂在甲板下、LRS-200 上方）
    - 按用户确认的装法记下翻转方向、整机坐标、铜柱与四个孔位、与 LRS 和市电端子罩的距离。
    - 记下注意事项：端子螺钉、XH、保险都朝下，宜上架前接线；LRS-200 自然散热，热气直对元件面。
2026-10-20 整机建模与文档：机架/电木隔板加工图、IN-14 插接方案、6E2 开窗与亚克力、PCB-3 倒挂入模
    机架与隔板
    - 新增 frame_spec.py（型材下料、立柱打孔、隔板、五金的唯一数据源）、fig_frame_drawing.py（png/14 型材图、png/15 隔板图）、export_plates_dxf.py（4 块电木隔板 CNC DXF，CUT/NOTE 两层，文字用黑体 simhei.ttf 防 AutoCAD 乱码）。
    - 连接改端面攻丝：横梁 B、甲板/电脑层纵梁 C 两端攻 M5，立柱打 Ø5.5 沉孔；底/顶纵梁 D 与 B 同高螺丝会相撞，改 L 角码。
    - 层板全部改 4 mm 橘红色电木（PLATE_T=4），甲板面 z94；孔阵 Ø3.2 间距 10、孔心 10 的倍数 +5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
    [parts_list.csv]
2026-10-20 ESP32-S3 功能规格 v0.7：蜂鸣器改到盖革板，整机只用一只
    - 用户定：盖革板自带蜂鸣器发咔哒声，不用扬声器；原记作 Ø12 蜂鸣器的已有件实为 CZN-15E 驻极体麦克风，蜂鸣器另买。
    - 咔哒由盖革板硬件（脉冲触发）产生，ESP 只控制静音；报警（PFAIL、异常）由 ESP 经 BUZZER（GPIO18）驱动同一只蜂鸣器；
    静音只关咔哒不关报警。控制线数量与电平待盖革板设计定（已标待定）。改 F8、F9 与引脚表。
2026-10-20 P36 更正：Ø12 蜂鸣器实为 CZN-15E 驻极体麦克风；盖革咔哒声改由盖革板自带蜂鸣器
    - 原因：parts_list 把用户手上的 CZN-15E（驻极体麦克风，约 Ø10×7）误记成“Ø12 蜂鸣器，盖革咔哒声”，用户确认后更正。
    - P36 改为 electret_mic_czn15e()（参数化 Ø9.7×6.7，两根引线，尺寸到手实测），删掉旧 P36_Buzzer_12mm 零件 STEP；buzzer_12mm() 保留，等盖革板蜂鸣器型号定了再用。
    - 用户决定盖革咔哒声由盖革板自带蜂鸣器发（ESP32 GPIO 或跳线静音），不走整机扬声器；蜂鸣器型号待盖革板调研后进立创补单。ESP32 底板是否另留报警蜂鸣器待定，架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
    [parts_list.csv]
2026-10-20 蜂鸣器定案：整机一只，装在盖革板上（咔哒声 + ESP32 报警共用）
    - 用户决定：盖革咔哒声由盖革板硬件直接产生；报警声（PFAIL、异常）由 ESP32 经 BUZZER 线（GPIO18）驱动同一只蜂鸣器；静音只关咔哒声，不关报警；ESP32 底板上不放蜂鸣器（ESP32 功能规格 v0.7 已由 mis-01-56 同步）。
    - 架构文档蜂鸣器行、ESP32 底板行，面板方案 I/O 表，parts_list 备注随之更新；型号待盖革板调研后新买。前面板原本没有给蜂鸣器开孔，模型不用改。
    [parts_list.csv]
2026-10-20 实测数据落文件：6E2（北京产 EM87）方向与冷态电阻、ESP32 开发板实测；修正 6E2 缺口方向模型和过时文档
    - 6E2：parts_list 名称由“EM84 类”更正为“北京产，= EM87”；记入用户实测总高 62、发光条长约 39、“显示高度 48.3”（含义待确认）、冷态电阻（4–5 灯丝 2.98 Ω；2/6/8 管内相连都带 250 V；1–3、3–9 不通）、方向（正对显示屏缺口在右、荧光屏正对 7 脚）。
    - 6E2 模型 bug：tube_6e2 / noval_socket 的针位原来是 0°…288°，缺口落在 -36°，与实物不符；改为缺口在 +X、俯视从缺口逆时针 36°·k 为 k 号脚；assembly 新增 EYE_ROT=18（荧光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
    [parts_list.csv]
2026-10-20 ESP32 底板、6E2 板、盖革板：调研结论与用户实测数据入档；ESP32-S3 功能规格 v0.8
    - 新建 el_driver/ESP-BASE_D1、EYE-6E2_D1、GEIGER_D1 三个目录（.gitignore 放行 *.txt、*.net），
    各放设计记录与调研全文（含来源链接）。
    - 记录用户 2026-10-20 实测：
    · 6E2 为北京产（= EM87）：正对显示屏时缺口在右、荧光屏正对 7 脚；冷态 4–5 脚 2.98 Ω，2–6/2–8 约 0.1 Ω
    （2、6、8 管内相连带 250 V），1–3、3–9 不通；发光条长 39。
    · J305 总长 103.5、外径 10、电极 Ø6.3（圆柱段约 6）、两电极间距 94，正负极未知；HAC2311S 总长 91，电极同。
    · 开发板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
2026-10-20 盖革管/6E2/ESP32 实测入模 + 方案同步：J305 实测外形、夹子小板与盖革主板定位、6E2 后移让开 J305、ESP32 引脚按规格 v0.8
    实测（用户 2026-10-20，经 mis-01-56 转达）
    - J305：总长 103.5、管身 Ø10、两端电极 Ø6.3（长约 6.3，完整圆柱约 6）、两电极之间 94；j305() 由 Ø11×111 占位改为实测外形，管轴 x 186–289.5（GM_L 103.5）。HAC2311S 总长 91、电极同为 Ø6.3。
    - 6E2 发光条上端 48.3、下端约 9.3（确认）；7 脚在正前方，与 EYE_ROT=18 一致。
    - ESP32-S3-DEV-KIT 排针塑料座 2.6、板下针长 7（模型原为 2.5 / 8.5）。表头为正泰 85C1，未到货。
    盖革（方案：m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
    [parts_list.csv]
2026-10-20 蜂鸣器默认状态加硬件跳线 JP_BZ（ESP32 底板），程序控制静音不变
    - 用户要求：想改成默认静音时不必改程序。BZ（GPIO18）经 10 k 接 3 针跳线中脚，跳 3.3 V（出厂）= 引脚高阻时咔哒开，
    跳 GND = 开机前、刷固件、死机时也静音；运行中静音仍由程序（NVS 设置）控制。
    - 同步改 ESP-BASE、GEIGER 设计记录与 ESP32 功能规格引脚表和 F9。
2026-10-20 通用高压小板 HV-UNI D1：原理图完成（UC3843 断续升压 112–296 V 可调，独立过压保护）；6E2/盖革记录更新
    - 新建 HV-UNI_D1 板：UC3843AN 约 52 kHz 断续模式升压，100 µH / IRF840 / UF4007 / 4.7 µF 400 V，峰值限流约 2 A；
    反馈 1.41 MΩ /(12 k + 20 k 电位器)；TL431 + 2N3906 在约 322 V 把 ISENSE 拉高停管（主反馈开路时的保护）；440 k 泄放。
    接口：J1 1×4（12 V、GND）、J2 单针 HV（避免 2.54 间距下 HV 与 GND 间距不足），60×40、M3×11 叠在宿主板上。
    - 原理图 44 个元件，网表 97 脚与设计表比对 0 不符。修正：库中 UF4007、LED 1 脚为阳极，2N3906 脚序 C-B-E，首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
2026-10-20 FPGA 首次上板：修复 .fs 烧录失败，记录 Dock v3714 实测结果
    问题：apicula 生成的 .fs 用高云 Programmer SRAM Program 时进度走完报
    "Error found!"，芯片加载不完成（状态寄存器 0x20、UserCode=0），FPGA 回落到
    Flash 出厂程序。
    原因：gowin_pack 不写 .fs 开头的 // 注释头（CheckSum、UserCode 等），
    Programmer 依赖这段注释头完成加载。排查：换 GW2A-18C 芯片库、改配置寄存器
    命令行、改 CRLF 均无效；高云 EDA 编译的同一工程可正常加载；只给开源 .fs
    补上注释头后加载正常（状态 0x6020，DONE 置位）。配置数据一位未改。
    修复：新增 fpga/scripts/fs_header.py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
2026-10-20 设计笔记 v0.3.1：按 FPGA 首次上板实测更正 Dock HDMI 与 U12/U14/U18
    起因：v0.3 依据 Dock 3713 原理图写"接口侧 49.9Ω 上拉 = 接收端接"，并称
    "3714 小改，此处相同"（只看了 Sipeed Readme，没逐页对比）。实物 Dock 是 v3714，
    Orange Pi 接上后 FPGA 收不到 HDMI。
    核实：下载 3713、3714 原理图逐页对比。3714（2026-05-20，"DVI optimize,
    SW0 and KEY4 pins were swapped"）把 P004 的 R15–R22 由 49.9Ω 上拉 HDMI_3V3
    改为 499Ω 下拉 GND，没有接收端接；实测 RK3399 PHY_STAT0=0x03（RX_SENSE 全 0），
    FPGA TMDS 时钟脚无信号。另外 S4 改接 RECONFIG_N，1 号拨码改为普通 IO；
    PMOD/LED/HDMI 引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
2026-10-20 通用高压小板 HV-UNI D1：PCB 完成（80×40），DRC 只剩 TO-220 自身脚距一项
    - 板子由原估 60×40 改为 80×40：8 只高压分压电阻要 3 mm 间距，60 宽放不下。四角 M3 孔，排针朝下插宿主板，M3×11 铜柱。
    - 布局：上排功率级（J1→C1/C2→L1→Q1/RS1→D1→C8/C9→J2），中排 UC3843 与过压保护、RV1，下排竖放电阻，
    高压分压组与低压组分开并隔 3 mm。
    - 新建 1.3 mm 间距规则 HV13 用于 HV/SW/分压中间网络；开关节点、源极检测、高压主线按坐标手画并做间距检查
    （Q1 漏极从 G、S 中间用 0.4 mm 线引出才能两侧 ≥ 1.3）；其余自动布线 24/25，GATE、SNS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
2026-10-20 通用高压小板 HV-UNI D1 入模：170 V 插辉光驱动板后右、250 V 插 6E2 板管子后面
    - assembly 新增 hv_uni()：用 mis-01-56 导出的 80×40 整板 STEP，排针插宿主板叠高 11，四角 M3×11 铜柱。
    - 170 V 板放驱动板 x 85–165、y 77–117（避开前沿 IN-14 小板）；250 V 板转 -90° 放 x 252–292、y 50–130，HV 输出端朝 6E2 管子，最高点 z 133.4；碰撞检查通过。
    - parts_list、架构文档板子表更新尺寸与装法；料单（立创补单脚本 procurement/build_lcsc_bom_hvuni.py，与 PCB-3 补单共用 lcsc_bom_common.py 写表）不进仓库。
    [parts_list.csv]
2026-10-20 6E2 猫眼板 EYE-6E2 D1：原理图完成，实物管座自制封装
    - 原理图 31 个元件（两管座、两路 2N3904 栅压驱动、阳极 100 k 1 W、VK 滤波、HV-UNI 插座等），网表 76 脚比对 0 不符。
    - 管座封装：工程库里改写 GZC9-A 的封装为实物管座——7 个镀铜切向长槽（3.1×1.0，焊盘 3.4×1.5）在 Ø14 圆上，
    2、8 脚不镀铜槽（管内连荧光屏），两耳 Ø3.4 与中心屏蔽片不镀铜。焊盘相邻端部 1.02 mm 受焊片本身间距限制，记为焊后涂三防漆。
    - 记录：updateDocumentSource 对该封装无效，需在封装编辑器里按编辑器格式 setDocumentSource 再保存。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
2026-10-20 6E2 板定框 90×90、250 V 高压小板改横放、盖革主板后移
    - 原因：mis-01-56 提出 HV 小板竖放（y 50–130）时，其下方只能放 ≤9 mm 元件，470 µF 和 XH 插座放不下；他建议把 6E2 板拉长到 y 143，但会盖住甲板右后走线孔（x 284–298、y 120–170），右后安装孔正好落在孔上。
    - 改法：6E2 板 90×90 放 x 210–300、y 15–105（前沿让开 J305 与右夹子小板，后沿让开走线孔），M3×6 铜柱；250 V HV-UNI 不转向横放 x 215–295、y 50–90。板上空出前左 x 210–250、y 15–50（表头下限高约 18）和后条 y 90–105（不限高）放高元件和插座。
    - 盖革主板由 y 50–90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
    [parts_list.csv]
2026-10-20 6E2 猫眼板 EYE-6E2 D1：PCB 完成（90×90），盖革主板位置更新
    - 板框与孔位按 mis-01-90 定的 3D 位置（全局 x 210–300、y 15–105），HV-UNI 250 V 小板横放在上方，本板打 4 个铜柱孔。
    - 管座封装槽孔类型由 ROUND 改为 SLOT（原先导出钻孔变成圆孔，焊片插不进），重新导入后钻孔文件确认为 G85 长槽。
    - 自动布线后发现 VK 离 2 脚不镀铜焊片（250 V）仅 0.56–0.78 mm（规则管不到无网络焊片），VK/+12V/GND 改用网格 A* 重布，
    焊片按 250 V 留 1.3 mm、离铜柱孔 ≥ 3.2 mm；修正布线器跨层接线漏过孔、过孔离同网络孔太近两处问题。
    - 只在管座区之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
2026-10-20 盖革主板 GEIGER-MAIN D1：原理图完成；J305 夹持尺寸确认，夹子方案改为整条长板（待确认）
    - 原理图 74 个元件分两页（MightyOhm 单级反激 + LM393/TL431 闭环 + 9×10 MΩ 测试链 + 咔哒单稳 + 单线蜂鸣器控制），
    网表 169 脚比对 0 不符。LM393 的 B 路用子部件 LM393P.2 放置并把输入接地。
    - J305：94 为两端电极圆柱段最近端距离，每端可夹约 4.75；选 6.3 mm 夹（Littelfuse 102071），内边对齐圆柱段内端。
    - 原两块小夹子板在管子正下方放不下元件和螺丝，提议改为一条长板（两组夹位、检测电路在左端外、阳极电阻在右端外）。
    - 记录嘉立创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
2026-10-20 盖革夹子长板 GEIGER-CLIP D1：原理图完成；记录长板与 60×60 主板的机械位置
    - 夹子长板 15 个元件：两组 LS-601 夹位（J305 / HAC2311S）、右端 4.7 MΩ 阳极电阻与高压焊线盘、左端阴极检测
    （Q2 → GM 咔哒、Q5 → PULSE，均开集电极），XH-3 与主板 J3 对应；网表 32 脚比对 0 不符。
    - 记 mis-01-90 确认的长板位置、垫片与管轴高度、夹子中心坐标，以及主板 60×60 新位置。
2026-10-20 6E2 板 STEP 入模；盖革夹子改长条板、主板改 60×60；XL6009 占位右移
    - 6E2 板（EYE-6E2 D1，90×90）用 mis-01-56 导出的整板 STEP 替换占位，原点在全局 (210, 15)。
    - 盖革夹子：用户确认 J305 每头能夹的电极只有约 4.75，两块 20×12 小板在管子正下方放不下元件和螺丝，按 mis-01-56 方案改成一条 134×12 长条板（x 165–299、y 2–14），贴甲板垫 1.5 mm；Littelfuse 10207101009 夹子（宽 7、高 10.9，夹口中心估 6.7），夹子中心 x 187.25 / 288.25；管轴 z 由 103.5 改为 103.8（由垫片厚度推算）。新增 geiger_clip_strip()（P55）。
    - 盖革主板 60×40 → 60×60（x 180–240、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
    [parts_list.csv]
2026-10-20 parts_list：UC3843AN 用户自有、确认够 3 块高压小板用
    [parts_list.csv]
2026-10-20 采购说明更新：第一批自购清单已买完冻结，新增自购件进第二批；立创第二批补单合并 PCB-3 + HV-UNI + 6E2
2026-10-20 6E2 板、盖革板：ngspice 仿真入档并按仿真结果改原理图；盖革分压链改 22 MΩ
    仿真（网表、脚本、报告在各板 sim/，原始波形不进 git）：
    - 6E2：EM87 两段 Koren 模型复现原厂三点；D 0→100% 对应 Vgk −0.07→−11.9 V，闭合点约 D 79%，响应 48 ms，
    纹波、串扰、寄生耦合都可忽略。据此改：R_K 改 1 W（开高压给 470 µF 充电峰值约 13 W/32 mJ）；
    R_EA/R_EB 47 k→4.7 k（复位时内部上拉也拉不开三极管）；加 R_HA/R_HB 220 Ω 灯丝均衡位（默认不焊，冷阻差 7% 时分压 6.6/5.3 V）。
    - 盖革：闭环 394.5 V、纹波 3.4 Vpp、负载与 5 V 波动影响 < 0.3 V，关断到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
2026-10-20 6E2 板 PCB 改版：按仿真改的原理图重新导入，补摆 R_HA/R_HB、R_K 换 1 W 封装，重出制板文件
    - 原理图改动（b43d66a）导入 PCB 后：R_EA/R_EB（47 k→4.7 k）被 EDA 挪到板外，放回原位，原走线不变；
    R_K 换 1 W 封装（脚距 10.5→13 mm），同中心 (58,87.4)，+12V/VK 两头走线各接长 1.25 mm。
    - 新增 R_HA/R_HB 220 Ω（灯丝均衡，默认不焊）放 A 管下方前沿 (33.25,8)/(33.25,4.5)，丝印标 DNP；
    FMID、+12V 顶层用 A* 接到已有铜。R_HB 的 GND 起初 DRC 报未连接——原因：底层 GND 铺铜只在 y ≥ 34
    （管座区为避开 250 V 焊片不铺地）；修法：底层沿 x 31 拉 0.8 mm 线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
2026-10-20 盖革主板 60×60 → 60×70（mis-01-56：60×60 放不下全部元件，用户已同意）
    - assembly.py GEIGER_BOARD 改 (180,110,60,70)，占 x 180–240、y 110–180；四孔 (185/235, 115/175)，板底 z100、M3×6 不变。
    - 核对加长的那条 x 180–240、y 170–180：模型里甲板上方没有零件；XL6009 在 x 243–283 不冲突。
    - 注意：后两孔 y175 超出甲板孔阵（y 35–165），要自己钻；板左后角压住甲板后走线孔（中心 160,183，50×14）右端圆头约 4×4 mm，孔大部分仍可用。
    - PCB安装与空间规划建议.md 同步。
2026-10-20 盖革主板 GEIGER-MAIN D1：改 60×70，完成布局、布线、铺铜、丝印并导出制板文件
    - 板子 60×60 → 60×70（用户定）：元件外框合计约 2550 mm²，60×60 扣孔和高压隔离区后摆不下且无走线余地。
    全局 x 180–240、y 110–180，后两孔 (185,175)(235,175) 不在甲板孔阵上需自钻；mis-01-90 已核对 y 170–180 无干涉并改模型。
    - 布局：高压集中在右半边，两条 22 MΩ 链锯齿竖排，间距 3.2 mm（焊盘 Ø1.88，同端相邻差 200 V，间隙 1.32 ≥ IPC B2 1.25）；
    VR1 紧挨 Q1 发射极，TP1/TP2 并排；低压按电路分区自动摆放，400 V 焊盘对低压中心距 ≥ 4.9 mm。
    - 布线问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
2026-10-20 盖革主板 GEIGER-MAIN D1 STEP 入模，替换占位方块
    - assembly.py 新增 GEIGER_STEP（el_driver/GEIGER_D1/制板文件_主板/GEIGER-MAIN_D1.step，约 34 MB，不进 git），
    按 mis-01-56 给的原点平移到全局 (180,110)、板底 z100；铜柱不变。
    - 核对：板外形 x 180–240、y 110–180，元件最高 z113.1（压电片/电解电容/XH 座），引脚伸到板下 z96.6；
    与 M3×6 铜柱只有面接触（铜柱顶面 = 板底），与 XL6009、6E2 板等其他零件都没有干涉。
2026-10-20 HV-UNI 高压小板：仿真入档，按结论改补偿网络并改 PCB（加 C11），重出制板文件
    仿真（ngspice，sim/ 下网表、脚本、报告；原始波形与器件模型不进 git）：
    - 原补偿 R12 47 k + C10 100 nF 环路太慢（穿越 12–34 Hz）：开机过冲 15–30 %（296 V 档冲到过压点 327 V），
    负载变 15 mA 偏 ±10 V、20 mA 阶跃振 8 次。
    - 改为 R12 680 k + C10 22 nF + COMP–FB 100 pF：过冲 2.6–3.7 %，负载变化 ±1–2.8 V，不振荡；
    100 pF 把 FB 脚开关尖峰从 0.16 V 压到 0.002 V。功率级、限流、过压保护、余量都没问题，Q1 不需散热片。
    - 设计记录"2 A 时仍为断续"不成立（算上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
    [gen.py]
2026-10-20 新增 fig_front_panel.py：前面板现状简图（png/20_front_panel.png）
    - 正视：竖直前面板 320×332（EL 视窗、管龛、表头、6E2 窗、盖革窗、亚克力范围、M4 固定孔）
    + 斜面按 33° 压扁投影的操作件 + 底座条；虚线标出后面的 2020 立柱 / 横梁。
    - 侧视（x=160 剖开）：前面板、斜面、底座条、下底板、斜面电路板与甲板、电脑层、立柱的前后关系。
    - 坐标全部引用 assembly_panel.py / assembly.py，模型改了重跑即可。
2026-10-20 盖革夹子长条板改 L 形（mis-01-56 方案，用户已确认）
    - parts_modules.geiger_clip_strip：外形由 134×12 长条改为 CLIP_STRIP_OUTLINE 多边形（板坐标原点 = 全局 (153,2)）：
    长条 x 153–299、y 2–14，左端往后加宽到 x 153–186、y 2–38 放检测电路；只留 J305 一组夹子，HAC2311S 那组删掉。
    - assembly.geiger：板原点 gx0 由 165 改 153，J305 夹子中心仍是全局 x 187.25 / 288.25、y 8，板面 z97.1 不变；注释写明
    左端 x 153–164、y 18–36 元件顶 ≤ z108（上方是 IN-14 第 6 只引脚）、4.7 MΩ 贴片阳极电阻在管下、右端只留高压焊盘和自钻 M3 孔。
    - 干涉检查：与 J305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
2026-10-20 盖革夹子长条板 GEIGER-CLIP D1：改 L 形并完成 PCB，只留 J305 夹子，阳极电阻改贴片
    - 问题：管子盖住全局 x 186–289.5，管底离板面只有 1.7 mm，下面放不了直插件；原长条 y 2–14 两端：
    左端只剩约 16×12 放不下检测电路（直插外框约 280 mm²），右端只剩 4.5 mm（右边立柱，不能加长）放不下 4.7 MΩ 电阻和孔。
    - 修法（用户定，mis-01-90 核对空间并已改模型）：
    · 左端往后加宽成 L 形（x 153–186、y 2–40），检测电路全直插放加宽块；后沿 y 40 让两孔 (165,35)(175,35) 落在甲板孔阵上免钻。
    · R2 4.7 MΩ 改 Vishay CRCW2512（C1694257，500 V）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
2026-10-20 盖革夹子长条板 GEIGER-CLIP D1 STEP 入模，后沿改 y40、加孔位
    - parts_modules：占位外形后沿由 y38 改 y40（mis-01-56 选方案 A），加 CLIP_STRIP_HOLES：左 (165,35)/(175,35) 落在甲板孔阵上，
    右 (296.5,10.8) 自钻，均为 M3 尼龙螺丝。占位函数保留作参考。
    - assembly.geiger：改为读 el_driver/GEIGER_D1/制板文件_夹子板/GEIGER-CLIP_D1.step（约 9 MB，不进 git），原点全局 (153,2)，
    板底 z95.5（甲板面 + 1.5 mm 尼龙垫）。
    - 干涉检查：与 6E2 板、管座、铜柱、亚克力都不碰；保险丝夹与 J305 电极有少量重叠（夹持，正常）。
    问题：板底引脚最长伸出 3.4 mm，比 1.5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
2026-10-20 ESP32-S3 功能规格 v0.9：加入与 Pi 的通信协议和固件实现要求，可交给他人写固件
    - 新增第 6 节通信协议（USB CDC 行文本）：应答格式与错误码、显示件 AUTO/HOST 模式
    （Pi 关串口、PI_RUN 变低或 T= 超时都退回 AUTO，Pi 死机后显示件自动恢复）、全部命令表与主动上报。
    - 新增第 7 节实现要求（ESP-IDF、模块划分、SPI 共用规则、IV-18 扫描心跳兜底、安全输出只在专门模块写）；新增安全规则 S9（命令不能绕过安全条件）。
    - 定死辉光钟 595 位序（F4）和 MAX6921 输出分配（F5），之后的辉光驱动板、IV-18 板按此走线。
    - 按各板定稿更正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
2026-10-20 盖革夹子板改垫 3 mm 尼龙柱，J305 管轴升到 z105.3；文档同步 L 形夹子板
    - assembly.GM_SHIM 1.5 → 3.0（mis-01-56）：夹子板底面有 400 V 阳极焊盘和 R2 焊点，1.5 mm 垫片加剪脚后焊点的余量太小；
    3 个孔各一根 M3×3 尼龙柱，板底引脚仍剪到 1 mm 以内。SBM_Z 103.8 → 105.3，管顶 110.3 仍低于盖革窗上沿 113。
    - 干涉复查：夹子板（顶 z109.6）与 IN-14 第 6 只引脚、6E2 板/管座/铜柱都不碰。
    - parts_list.csv：J305 行装法改为 L 形夹子板、LS-601 夹子、3 孔位置；盖革板行改 60×70 主板、STEP、两种蜂鸣器、高压线直焊。
    - PCB安装与空间规划建议.md：夹子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
    [parts_list.csv]
2026-10-20 整机架构：加 USB 麦克风阵列（Pi 侧），蜂鸣器、BH1750、盖革板行更新
    - 2 节：Hub 第 4 口（原备用）接 USB 麦克风阵列（UAC 免驱），语音控制在 Pi 上做，音量经 EYE B 显示在 6E2 猫眼 B；
    新增 2.2 节写选型要求（2–4 麦、最好带 AEC/波束成形）和安装原则，型号、位置待用户选。总览主机层加“语音控制”。
    - 4.1：蜂鸣器“型号待选”改为 PS1740P02E 压电 / YS-MBZ12085C05R42 电磁二选一；BH1750 注明用于 IV-18 自动亮度（规格 F10）；
    引脚说明引用规格 v0.8 → v0.9。
    - 6 节盖革行：改为 D1 已画完、60×70 主板、L 形夹子板垫 3 mm 尼龙柱、LS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
2026-10-20 ESP32-S3 功能规格 v0.9.1：辉光钟驱动 IN-14 右小数点（用户定）
    - 辉光驱动板加第 4 片 74HCT595 + 6 只 MPSA42 驱动 6 个右小数点，左小数点不接。
    - 辉光帧由 3 字节改 4 字节：字节 0 为 6 个右小数点（bit5..0 = 管 1..6），其后 H、M、S 三字节 BCD 不变。
    - AUTO 时管 2、管 4 的右小数点作时分秒分隔、每秒闪一次；协议 NIX SHOW 支持 "." 点亮前一位小数点。
2026-10-20 辉光驱动板 NIXIE-DRV D1 与 IN-14 管座小板 IN14-SOCK D1：原理图、PCB、制板文件完成
    - 驱动板 150×80：4 片 74AHCT595（秒/分/时/右小数点，位序按 ESP 规格 v0.9.1 F4）→ 6 片 K155ID1（DIP 插座，
    脚序按 chipdip 规格书，文字表 11 脚误写已按图更正）；右小数点经 MPSA42 + 47 k；HV-UNI 170 V 插在后右；
    前沿 6 个 2×7 排母插 IN-14 小板（1 = HV，2/3 空，4 = 小数点，5–14 = 0–9）。
    - IN-14 小板 21×40：IN-14 管脚按 tube-tester（1 阳极、2/13 小数点、3–11 = 1–9、12 = 0），自制 PCD12 圆周 13 孔封装；
    22 k 阳极电阻；小数点 0805 0 Ω 二选一（编号方向未实证，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
2026-10-20 辉光驱动板、IN-14 小板 STEP 入模；加 ESP32 底板占位，XL6009 挪到表头下面
    - 辉光驱动板 NIXIE-DRV D1、IN-14 小板 IN14-SOCK D1（mis-01-56 导出）替换原占位。
    IN-14 小板 STEP 里有代替管子的 1×13 排针，新增 vendor_parts.load_abs_within 按 X 范围把它去掉，管子仍用自己的模型。
    - 新增 esp_base()：ESP32-S3 底板占位 90×60，放在 x 40–130、y 120–180（驱动板后面），
    含 2×22 排母、开发板（USB-C 朝左）、DS3231；M3×6 铜柱，后两孔 y175 不在孔阵上要自钻。
    - XL6009 放不上 IV-18 板（管下只有 0.5 mm，管后那条限高 10），
    由 x 243–283、y 166–196 挪到甲板 x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
    [parts_list.csv]
2026-10-20 ESP32 底板占位改 90×50（x 40–130、y 120–170），四孔都在孔阵上
    mis-01-56 定底板尺寸 90×50：四孔 (45,125)(125,125)(45,165)(125,165) 都落在甲板孔阵上，不用自钻（原提议 90×60 后两孔 y175 要钻）。
    占位里开发板后移到 y 142–167，DS3231 改竖放在开发板右边（x 106–128）；parts_list、整机架构、PCB 安装建议同步。
    [parts_list.csv]
2026-10-20 斜面电路板 SLANT D1：原理图、PCB、制板文件完成
    - Pico（背面邮票孔）按接线方案 5.1：GP2–7 按键（10 k/1 k/100 nF）、GP8–13 → ULN2803 → 12 V 键灯、
    GP14–22 三个 EC11（10 k/10 k/10 nF）、GP26/27 推子比例式、GP28 模式开关 7×1 k 分压链；网表 248 脚 0 不符。
    - 外形按 mis-01-90 给的斜面几何：x 17–166、u 0–78，两个 USB 缺口、模式开关 Ø34 开孔、左上避立柱；
    编码器与推子在顶层（朝面板，限高 6.5），其余在背面。
    - EDA 自动布线 61/61，两层 GND 铺铜，DRC 0 错误；孔 (90,8) 的铜环缩到 Ø5.6 避开 J_K1。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
2026-10-20 斜面电路板设计记录：更正 J_12V 与 Pico 位置的表述
2026-10-20 新增各板上电测试清单（el_driver/上电测试清单.txt）
    按板列出单独上桌测试的步骤与预期读数（数值取自各板设计记录与仿真）：PCB-3、斜面板、HV-UNI ×3、
    辉光驱动 + IN-14、6E2、盖革两板、EL-IF（引用已有验收文档），以及整机联调顺序；ESP 底板、IV-18 板待画完补。
2026-10-20 ESP32 底板 ESP-BASE D1：原理图、PCB、制板文件完成；IV-18 调研入库
    ESP-BASE D1（插微雪 ESP32-S3-DEV-KIT，引脚按功能规格 v0.9.2）
    - 原理图三页，网表 195 脚与设计表比对 0 不符（ESP-BASE_D1.net）；
    PCB 206 个焊盘网络与设计表 0 不符。
    - 板子由 90×50 改为 110×50（全局 x 40–150、y 120–170），四个 M3 孔
    (45,125)(145,125)(45,165)(145,165) 都在孔阵上。
    原因：插座加上竖插的 DS3231（两侧各需 11 mm）在 90 宽里放不下。
    - 布局：开发板 USB-C 朝左；前排 J_NIX/J_CTL/J_INST，后排
    J_IV18/J_I2C/J_LD/J_GM，右沿 J_E2/J_MTR，J_RTC 在右侧。
    开发板和 DS3231 投影下只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
2026-10-20 斜面板、ESP 底板 STEP 入模；IV-18 调头并加端板占位
    斜面电路板 SLANT D1（assembly_panel.py）
    - slant_pcb() 改读 mis-01-56 导出的整板 STEP：绕 X 转 +90° 后平移到 (17, 10.1, 0)，再按斜面 −33° 放置；Pico 模型保留（STEP 里没有）。
    - _slant_drop() 去掉 STEP 里两类实体：模式开关孔里多出来的 Ø34 圆片、EC11 本体和轴（模型继续用自带旋钮的 P.ec11，避免重复）。
    - 碰撞检查通过：除焊脚穿板外无干涉，最紧处左上角离左前立柱 1.0 mm、离模式开关 0.9 mm。
    vendor_parts.py
    - 新增 load_abs_drop(rel, drop)：按包围盒条件去掉实体；load_abs_within 改为调用它。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
    [parts_list.csv]
2026-10-21 IV-18 板：主板 IV18 D1 与端板 IV18-END D1 画完，电荷泵仿真；斜面板 C12A 换料
    IV18 D1 主板（130×37，全局 x 22–152、y 3–40，孔 (45,35)(135,35)(148,8)）
    - 原理图按调研第 8 节，网表 152 脚与设计表 0 不符。
    22 个管脚网络在原理图里是单脚网络，PCB 上用 T 形焊盘接到端板。
    - 自动布线 53/53（GND 一起走），两层铺铜，DRC 0。
    - 修过一处：右后扎带槽压到 MAX6921 的 13、14 脚。
    原因：U1 是固定件，自动布局没查它和槽的距离。
    修法：槽收窄到 1.4 mm，离脚 0.36 mm。
    - 改料：C4 22 µF/100 V 电解改 2×2.2 µF/100 V 1210（C86054），
    C7 100 µF 电解改 22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
2026-10-21 IV-18 设计记录：更正灯丝先行时序
    原记录写固件"先开 FIL、约 20 ms 后再开 PWR_EN"够用，不对：
    固件原来 fil_start() 后紧接着拉高 PWR_EN，只早几微秒；20 ms 是台架轮询间隔。
    电荷泵仿真要 5.2 ms 才判定有方波，所以 FIL 至少要早 10 ms。
    mis-01-be 已在固件加 FIL_LEAD_MS=20（实测早 29.8–29.9 ms），规格 S6/F5 同步。
2026-10-21 IV-18 主板、端板 STEP 入模，替换占位
    - assembly.py：IV18_STEP 主板（板原点 = 全局 (22, 3)，板底 z 95）直接平移；IV18_END_STEP 端板导出时平放，
    按 mis-01-56 给的换算 (X,Y,Z) → (143 + Z, X, 96.6 + Y) 先绕 X 转 90° 再绕 Z 转 90°（循环换轴，不是镜像），黑色。
    - 碰撞检查（加了三颗 M3 螺丝头）：端板离 IN-14 #6 小板 1.8 mm、#5 小板 2.6 mm，离 (148,8) 螺丝头 0.63 mm；
    主板三颗螺丝头周围无元件；端板两榫正好穿过主板到板底。
    - 发现：主板 J1 XH-14、J2 XH-4、5 根测试针的焊脚在板底伸出 1.4–1.9 mm，而板下只有 1 mm 尼龙垫片，
    模型里会顶到甲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
    [parts_list.csv]
2026-10-21 架构文档：自制板元件改为已进第二批立创补单，线束进自购清单第二批
    原文“还没进任何清单”已过时：斜面板、ESP32 底板、IV-18 主板的料单已合进 build_lcsc_bom_order2.py，
    写明不在单里的自有/已买件和线束所在清单。
2026-10-21 IV-18 主板：直插件焊脚剪平到 ≤0.8 mm（清单与设计记录）
    mis-01-90 入模发现 J1、J2 和 5 根测试针的焊脚伸到板底下 1.4–1.9 mm，
    板下只有 1 mm 尼龙垫片，会顶到甲板，板子放不平。
    不改厚垫片：管顶 z 116.1，抬 0.5 mm 就碰 IN-14 小板底面 z 116.6。
    修法：焊完剪平到 ≤0.8 mm，写进上电测试清单第 8 节和设计记录第五节。
2026-10-21 ESP32-S3 仪器层固件 v0.1.0 初版；功能规格更新到 v0.9.2
    固件 firmware/esp32s3/mis01_fw（ESP-IDF 5.5.5，C）：按规格逐条实现，每个功能一个模块。
    - 电源 power（F1/F3）：OFF/WAIT/RUN/SHUT 状态机，PI_RUN 低 5 s 确认关机、60 s 兜底；PFAIL 中断里立即关高压与 IV-18。
    - 高压 hv（F2）：钮子 × 需要 × PFAIL × 再开间隔；无人/夜间关；辉光管每日修复期间保持开。
    - IV-18 vfd_scan/vfd/vfd_font/vfd_fx（F5、S1、S6）：GPTimer 三段中断扫描，数据装好才放开 BLANK，每位最长点亮 890 µs；
    20 ms 心跳判故障；日期/CPM/温度轮换 + 擦除动画；开机跑马灯 → 全段自检 →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
    [partitions.csv]
2026-10-21 电脑层暂定布置 Orange Pi 4 和 Dock，HDMI 软排线两头小板与排线占位
    mis-01-56 要画 HDMI 软排线两头小板，需要 Pi、Dock 的 HDMI 口位置；之前两块板都不在总装里，现按“HDMI 边朝后”暂定布置（待用户确认）。
    - parts.orangepi4()：按官方 orangepi-4-LTS-V1.1_top.dxf 重做板框 91×55.7、四孔、HDMI/耳机/Type-C/DC/USB/网口/排针平面位置
    （原模型孔位、HDMI 位置是猜的）；接口高度为估计值。
    - 新增 assembly_computers.py：Pi 在左（网口朝左，板 x 70–161），Dock 在右（板 x 170–265），HDMI 口面都在 y 172.7，
    M2.5×6 铜柱、板底 z 270，HDMI 口中心 (136.4/202.4, 1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
    [parts_list.csv]
2026-10-21 HDMI 软排线两头小板：HDMI-PI D1 与 HDMI-DOCK D1 画完（两头都在嘉立创贴片）
    背景：Dock v3714 的 HDMI 口没有接收端接（R15–R22 改成 499 Ω 下拉），FPGA 收不到 Pi 的 TMDS；
    Dock 18 脚 5 V 会反灌 Pi。原计划 Pi 端买现成转接套件、Dock 端照套件脚序画，要等到货量脚序；
    改为两头都自己画、嘉立创贴片，脚序自定，不用等套件。
    - 排线 0.5 mm 20P 同向（A 型）：20 cm 立创 C11107，30 cm 淘宝备件；立式 FPC 座 C11073，
    Dock 端座子相对 Pi 端转 180°（排线在两口之间拱过去），两块板上同一导体在同一位置。
    导体 c(k) = HDMI 第 k 脚，c18、c20 接地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
2026-10-21 HDMI 小板上电验证步骤细化（按 fpga-8c 核对意见）
    - 上电测试清单 9b 第 4 步拆成 4a/4b：4a 只看端接，Pi 上运行 hdmi_diag2.sh 看 PHY_STAT0 = 0xF3
    （RX_SENSE 全 1 + HPD + PHY 锁定，无端接时为 0x03）；4b 看 FPGA 串口 HDMI=1 VID=1 H=280 V=1E0。
    4a 不过查板子和排线，4a 过 4b 不过归 FPGA 解码，不用改板。插拔排线须两边都断电。
    - 设计记录补 fpga-8c 的电路核对：3713/3714 只差 R15–R22，隔直电容在 FPGA 侧，加端接板后与 3713 等效。
2026-10-21 HDMI 软排线两头小板 STEP 入模，替换占位；核对梯形朝向、插入深度和侧向净空
    - assembly_computers.py：HDMI-PI D1（18×26）、HDMI-DOCK D1（25×26）用 mis-01-56 的 STEP，只平移。
    插入深度取自 Dock 3713 STEP 截面：插座口面 y 73.7，壳内到 y 66.9 是插座本体，插头进 6.8 mm；
    插头壳前端在小板坐标 y −12.42 → 板前沿落在世界 y 178.3，FPC 座中心 y 195.3（原估 192，离后面板还有 19 mm，不用挪）。
    插口中心高按截面改为 Dock 板底 +5.375（外壳 z 2.75–8.0；原按 +4.85 估），小板板底 z 274.6。
    排线起点改为 STEP 里 FPC 座顶（座高 4.4，不是 5.65），拱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
    [parts_list.csv]
2026-10-21 HDMI 小板设计记录：补 mis-01-90 入模核对结果
    - 插头梯形朝向与 Dock 3713 插座一致（宽边朝上），不用翻；Orange Pi 4 无模型，待用户看实物斜角是否在下。
    - 落点：插座口面内 6.8 mm 为本体，板前沿在口面外 5.5 mm；两块板原点坐标、FPC 座中心 y 195.3 记入。
    - 侧向余量：Pi 板到耳机插头 0.1/1.1 mm（耳机插头须用 ≤Ø8 细头），Dock 板到 Type-C 0.43/1.05 mm。
    - C11073 STEP 高 4.4（规格书 5.65），排线拱顶 z 358，20 cm 够。
2026-10-21 架构文档采购段：HDMI 软排线进立创补单，两块 HDMI 小板走嘉立创 PCBA
    - 立创第二批补单加 C11107（LX FFC 0.5 mm 20P 20 cm 同向）×5：用 1 根，立创 5 根起订、按 5 的倍数卖，所以不是 ×2；
    30 cm 同向排线 ×1 进自购第二批作备件（procurement/ 不进仓库）。
    - 写明 HDMI-PI D1、HDMI-DOCK D1 走嘉立创标准 PCBA、双面贴装，元件随板配料不进补单，并列出 BOM 料号。
2026-10-21 架构文档：6E2 板状态由“未画”改为 D1 已画完、STEP 已入模
    第 6 节板子表 6E2 板一行漏改（EYE-6E2 D1 早已画完，assembly.py 已用其 STEP），mis-01-56 发现后指出。
2026-10-21 架构文档：补项目名称含义
    MIS-01 原先没有任何文档说明名字由来。经用户确定，MIS 解释为 Multi-Indicator Station（多指示器工作站），对应整机集合 EL 屏、IV-18、IN-14、6E2 等多种显示器件；-01 表示一号机。写在文档开头。
2026-10-21 HDMI 小板设计记录：用户确认 Orange Pi 4 HDMI 口斜角朝下
    用户 2026-10-22 看实物确认 Pi 的 HDMI 插座梯形斜角在下面（靠板子），
    与 HDMI-PI D1 的 J1 放置（奇数脚宽边在顶层朝上）一致，不用改板；两块小板均可下单。
2026-10-21 IV-18 定为 тип 2；上电测试清单补 MAX6921 真伪测试步骤（8a）
    1. IV-18 类型：用户 2026-10-22 看管子最左位只有一个大圆点和一短横，是 тип 2
    （管上 XII-83 是 1983 年 12 月生产日期，与类型无关）。
    调研_IV18 第 11 节待定项、设计记录_IV18_D1 装配第 5 条写明 R17–R19 不焊；
    功能规格 F5 注明用默认 IV18_TYPE=2，删去第 5 节对应待定项。
    2. 上电测试清单新增 8a：淘宝 MAX6921AWI 焊上主板前的单独测试——
    外观、二极管档查脚、上电电流、全 1/全 0 移位 + LOAD、BLANK、
    LOAD 常高时逐个打 CLK 看高电平从 OUT0 推进到 OUT19 且与 DOUT 同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
2026-10-21 采购核对：HV-UNI R3 用库存 20 Ω；IV-18 灯丝假负载可用 4×220 Ω 并联
    逐板 BOM 与立创两张单、自购两批、库存表交叉核对时发现：
    1. HV-UNI 设计记录写 R3 22 Ω 用"库存色环"，但库存表只有 20 Ω 和 33 Ω，没有 22 Ω。
    R3 是 UC3843 到 IRF840 的栅极串阻，20 Ω 与 22 Ω 无差别，改为用库存 20 Ω，不另买。
    2. 上电测试清单第 8 节第 2 步的 56 Ω/1 W 假负载不在任何采购单里；
    注明可用库存 4 只 220 Ω（1/4 W）并联得 55 Ω，每只约 0.1 W，不另买。
2026-10-21 新增整机爆炸图、下巴+后仰键盘座连接方案剖面；修正前面板图 IN-14/IV-18 画法
    - fig_exploded.py（新）：按 assembly.build() 分组整体平移出爆炸图，前等轴 / 后等轴两张（png/22_exploded_*）。
    前面板/斜面往前拉、EL 屏往前上抬（让开甲板层）、后面板往后、电脑层和顶板往上、下舱往下；只改显示位置不改装配坐标。
    前后视各用一组标签位置；可带参数 front / rear 只出一张。
    - fig_chin_dock_section.py（新）：键盘座随斜面后仰的连接方案剖面草图（png/23，待用户确认）：
    键盘座屏幕面与斜面共面接在斜面下沿，长 316 两端锁三角板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
    [fig_chin_dock_section.py, fig_exploded.py, fig_front_panel.py, render_closeups.py]
2026-10-21 PCB-3 补上两个 NID100 模块（插拔式，排母 8.5）并核对离 LRS-200 的高度
    模型里原来只有 PCB-3 板子的 STEP，不含 U_N12 / U_N5 两个 NID100，高度检查查不到模块本体。
    新增 pcb3_nid_modules()：按坐标文件 1 脚焊盘（板本地 x 41.87，y 63 / 37）把明纬 NID100 模型针朝上插在倒挂的板下；
    NID_SOCKET = 8.5 为用户 2026-10-22 提的插拔式排母塑高（0 = 直焊），排母按 1×13 占位块画。
    结果：模块本体全局 x 120.4–171.7、y 90–102 / 116–128，最低 z 42.8，离 LRS-200 顶面（z 30）12.8 mm；
    离市电端子罩（x ≥ 213）水平 41 mm，不碰 PCB-3 其他元件。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
2026-10-21 新增 Pico Micro-USB 插头干涉局部图（png/24_pico_usb_iso / _side）
    mis-01-56 复查发现斜面电路板上 Pico 的 USB 口（朝斜面下沿，口在 u 20.6、x 72.5）可能插不进线，原模型里没有插头查不到。
    render_pico_usb.py 在斜面坐标（放平）里画：Pico 按实际装法元件面朝里，口前加 11×8×19 直头插头占位，
    标出与 USB2 面板延长线本体（x 58–76、u 5–15）和斜面电路板的重叠（红）。侧视只截 x 66–79 一条。
    结论：口到延长线本体只剩 5.6 mm，直头、弯头都放不下。
2026-10-21 EL-IF D1.3：P1–P3 改奇偶编号与 Dock 一致；J_PF/J_LAMP 换 HCTL XH；RRX 改 1k
    下单前独立复查发现的问题：
    1. P1–P3（接 Dock J5/J6/J14）的封装是 U 形编号（一排 1–6、另一排 7–12 倒回），
    而 Dock 是奇偶交错（1、2 隔排相对都是 3V3，3、4 都是 GND）。用 2×6 成排延长线直插会让 3V3 对地短路。
    修复：工程库封装焊盘重新编号为奇偶交错（位置不变）；原理图按"新脚号 = Dock 脚号"重分网络，
    尽量让原走线留在原焊盘：每个插座只改 2–3 根线（3V3 主线从两排中间 x 4.2 绕开新 GND 脚，
    P1 的 LD3/LD2、P3 的 UART_TX/RX、SCR_EN 改接到空出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
2026-10-21 PWR-DIST D1.1：NID100 改排母插拔并加扎带孔；U_N12 孔径修正；C_DVC 改 3.3 nF
    下单前独立复查与用户要求：
    1. 两个 NID100 改插拔式（用户要求）：板上焊 1×6+1×7 排母，模块插上。
    U_N12 原用库里 NID100-24 器件（C5691337），封装孔 0.9 mm 小于模块 0.64 方针对角 0.905 mm，插不进，
    且按编号配单会买成 24 V 款。改用与 U_N5 相同的 PWRM-TH_NID100-5 封装（孔 1.1），型号改 NID100-12、清掉立创编号。
    每个模块两侧各开 2 个 1.5×3.5 mm 非金属化长条孔用扎带固定（板子倒挂，针只插进约 3 mm）；
    为此删 9 个 GND 缝合过孔（含 U_N12 扩孔后孔距不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
2026-10-21 6E2 / 辉光驱动板 D1.1：管座空脚槽宽与单针排母孔径改 1.0 mm；R_H 改 1/2 W；更正 D1.3 的 FPGA 球号说明
    下单前独立复查：
    1. 6E2 管座封装 2、8 脚非金属化槽宽 0.9 mm，低于嘉立创下限 1.0 mm → 改 1.0 mm。
    2. J_HH 单针排母封装孔 0.9 mm（按 Mill-Max 定），实物是从 PM254 排母剪的针，同系列孔 1.0–1.1 → 改 1.0 mm/焊盘 1.7 mm，
    6E2 板与辉光驱动板共用此封装；BOM 去掉 Mill-Max 料号（塑高 2.79，照买会接不上高压）。
    3. 6E2 灯丝均衡电阻 R_HA/R_HB 1/4 W 在拔管故障时约 0.64 W → 改小体积 1/2 W（C385474），封装不变。
    DRC 与改前相同（只剩管座焊片 8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
2026-10-21 复查结论落文档：上电测试清单、功能规格 v0.9.3、面包板脚号与各板记录更正
    按下单前独立复查（10 份报告）只改文档、不改板的部分：
    上电测试清单：
    - 第 0 节：库存三极管焊前定脚（S8050 有 EBC/ECB 两种，C1815 是 ECB）；成品线到货先核色序。
    - 第 1 节 PCB-3 D1.1：NID100 插排母 + 扎带；电子保险锁死后要关主机钮子重开。
    - 第 2 节 ESP 底板：USB 刷固件会倒灌 +5V；J_RTC 可反插；BH1750、LD2410B 线必须做交叉/转接；表头 R16 按内阻换；Pi 22 脚上拉。
    - 新增 3b 键盘转接板：成品 USB-A 转 XH 线先量 5V/GND。
    - 第 4 节 HV-UNI：过压保护测试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
2026-10-21 新增 Pico Micro-USB 插头空间示意图（png/25）
    用户没看懂“插不进去”和“顶上有什么”，画 x 72.5 处真实倾角剖面对比：
    左：现在 USB 朝斜面下沿，插座口 u 20.6 到 USB2 延长线本体只有 5.6 mm，直头（伸出约 19）和弯头（伸出约 10 才拐弯）都撞本体；
    右：Pico 转 180° 后 USB 口在板子上沿，直头约 13 mm 处顶到甲板底面（z 90），弯头或公头转接板（伸出 10–12）放得下。
2026-10-21 模型换用 mis-01-56 下单前复查后的新版 STEP：PWR-DIST D1.1、EYE-6E2 D1.1、NIXIE-DRV D1.1
    PWR-DIST D1.1 加了 8 个扎带孔、U_N12 封装换成与 U_N5 相同（坐标文件里 1 脚焊盘位置不变）；EYE-6E2、NIXIE-DRV 只是孔改大。
    换版后对这几块板做实体相交检查：只剩 NID100 针插在排母里、IN-14 小板排针插驱动板、管座焊片穿 6E2 板这类本应重叠的项，没有新碰撞。
2026-10-21 外壳改为两件铝钣金 + 后仰键盘座；背板改 IEC 小板；补保护地方案
    按用户 2026-10-22 确认的方案（png/23 + 两件拆法 + 前面板加宽）：
    - 前壳 front_shell_alu：竖直前面板加宽到 324（x −2..322，盖住下巴托侧板），和斜面是一块 2 mm 铝板折 33°；
    斜面宽 320，两侧往里折 10 mm 翻边（u 8–64，再往上翻边后角会伸进前立柱），各 2 个 M3 压铆螺母锁侧板；斜面下沿 3 个 M3 沉头孔锁键盘座舌片。
    - 下巴托 chin_tray_alu：底板 + 两侧板一件。侧板在机架外侧（x −2..0 / 320..322），外形沿斜面线到键盘座底面；
    往后盖到 y 75，每侧 M4 ×6 锁前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
    [parts_list.csv]
2026-10-21 SLANT D1.1：Pico 转 180° 让 USB 口朝上沿，重新布线
    下单前复查发现 Pico 的 Micro-USB 插头插不进去：USB 口朝下沿，离 USB2 面板延长线本体只剩约 5 mm
    （原碰撞检查没有插头模型）。按用户与 mis-01-90 商定的方案 a 修改：
    - Pico 转 180°（旋转 270°，仍贴背面），中心斜面 (72.5, 52.0)，板边离上沿 0.5 mm，USB 插座口伸出板边约 0.1 mm；
    退 0.5 mm 是因为齐平时 1/40 脚和 USB 测试焊盘离板边只有 0.13–0.25 mm。配 90° 弯头 Micro-USB 线。
    - CE1B、RS1S 被压到，挪到 Pico 原 USB 端空出的位置。
    - Pico 的 30 根信号网络拆掉重新自动布线（30/30），删掉贴着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
2026-10-21 斜面电路板换 SLANT D1.1（Pico 掉头）；新增全高侧板和整块背板（纯盖板，可不装）
    - SLANT D1.1（mis-01-56 6d54690）：Pico 中心斜面 (72.5, 52.0)、转 270°、仍贴背面，USB 朝斜面电路板上沿；
    pico_on_slant() 按 Pico 板身定位（u 26.5–77.5，离板上沿退 0.5），元件面朝里。
    核对：USB 座外壳口 u 78.2（唇边到 78.8），90° 弯头插头本体按 11×8×10 / 11×7×10 / 10.5×6.5×9 都不碰板边（离 0.21，插到底约 0.8）、不碰甲板。
    - assembly_covers.py（新）：左右全高侧板（x −2..0 / 320..322，左下前角让出下巴托侧板）、整块背板（右下角让出 IEC 小板）。
    用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
2026-10-21 FPGA 引脚约束按 EL-IF D1.3 新脚序重排（el_hdmi、el_test）
    原因：EL-IF D1.2 的 P1–P3 用了 U 形编号封装，与 Dock J5/J6/J14 的奇偶交错编号不一致，
    2×6 延长线直插会让 3V3 对地短路。D1.3（mis-01-56，bc3b069）改成与 Dock 相同编号、1 脚对 1 脚，
    并为少改走线重排了各信号所在针位，FPGA 球号必须跟着换。
    改法（球号按 Dock 3714 原理图总图逐根连线核对，并与 EL_IF_D1.3.net 的 P1–P3 网络比对一致）：
    - J5：5 LD3=L9，6 LD1=N8，7 LD2=N9，8 LD0=N7，9 UD0=N6，10 UD3=D11，11 UD1=A11，12 UD2=B11
    - J6：6 VD_HI_N=C12，8 VD_ON_N=A14，9 CP2=B14，10 OE_N=A15，11 CP1=D14，12 S=E15；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
2026-10-21 架构文档：SCR_EN 送 Dock 的脚号随 EL-IF D1.3 改为 J14-7
    EL-IF D1.3 把 P1–P3 改成与 Dock 相同的奇偶编号并调整了信号脚位，SCR_EN 由 J14-12 移到 J14-7
    （fpga-8c 已按新表改 .cst，013a8d9）。只提交这一行，文件里其他未提交改动不属于本次。
2026-10-21 EL-IF D1.3 变更记录：注明 FPGA .cst 已按新脚表改完（013a8d9）
2026-10-21 喇叭改两只腔体喇叭（立体声）装在底层左右前角；下巴托两侧板开喇叭网
    用户 2026-10-22：有两只喇叭、喇叭不要固定在侧板上、价格合适就买带安装孔的。
    - parts_modules：新增 cavity_speaker_3070()（3 W 4 Ω “3070” 腔体喇叭，17×70×30，耳孔 63×24，尺寸按商品图待实测）
    和 speaker_cradle()（打印支架，底座贴下层 Y 梁内侧面用 M4 T 螺母锁 T 槽，不在层板上打孔）。
    - assembly.lower()：删掉单只 Ø40 占位，左右各一只腔体喇叭，出声面朝外侧（x 20 / 300），声音从下层与甲板层 Y 梁之间出去；
    左 y 35–... 中心 y 45（再往后碰 LRS-200），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
    [parts_list.csv]
2026-10-21 固件跟进规格 v0.9.3；规格 v0.9.4 限定 FIL_HZ ≥ 10 kHz
    1. 辉光钟消隐位清小数点（nixie.c make_frame）
    问题：某位发 0xF 消隐时，该位的小数点位照样输出（如 NIX SHOW " .123" 或滚动/修复中途），
    数字全灭只亮小数点时电流经 22 k + RDP 约 0.35–0.5 mA，超过 IN-14 小数点规格 0.3 mA（v0.9.3 F4 复查结论）。
    修：组帧时凡数字码 > 9（K155ID1 全灭）就清掉该位的 dp bit，所有显示路径都经过 make_frame，一处覆盖。
    2. CFG FIL_HZ 范围由 100–20000 改为 10000–20000（规格 v0.9.4，F5、6.9）
    原因：IV-18 板 FIL_OK 检测（C8/R7）在 10 kHz 以下判不出翻转，会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
    [cfg.c, nixie.c, nixie.h, pins.h, util.h]
2026-10-21 前壳、下巴托按嘉立创钣金规则重建成真实折弯；新增外壳加工文件导出
    嘉立创钣金要折好弯的 3D STEP（自己展开，不收展开图）；2 mm 板外 R 3.7 / 内 R 1.7（官方 Guidelines 2.4 表）。
    - assembly_shell.py（新，从 assembly_panel 挪出）：
    前壳 = 前面板平板（z 88.5 起）+ 33° 折弯（圆心在面板前面，外表面在内侧）+ 斜面平板 + 两侧 90° 翻边（翻边段开 1 mm 让位口）；
    前面板两侧 2 mm 耳朵从 z 90 开始（让开折弯）。下巴托 = 底板 + 两侧 90° 折弯 + 侧板 + 后 90° 折弯 + 后翻边，转角处留让位口；
    侧板下沿 = 折弯切点 z 1.7，外形函数 side_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
2026-10-21 上电测试清单 8a：MAX6921 测真伪改用免焊翻盖测试座
    用户不想先把芯片焊到转接板、测完再拆下来，器材改为 SOP28 宽体（300 mil）翻盖测试座，
    测完直接取出焊到 IV-18 主板。采购单同步由 mis-01-90 修改。
2026-10-21 电脑层补齐 EL 接口板、USB Hub、Pi 散热；顶板加吊装孔；新增装配说明
    - assembly_computers.build_extras()（2026-10-22 暂定，待用户确认）：
    EL-IF D1.3 元件朝下吊在顶板下（x 160–260、y 40–140，M3×10 铜柱）——层板上 Pi、Dock 已占满，放这里离 Dock J5/J6/J14 和 EL 屏近，
    在 HDMI 排线拱顶（z 358）和 Pi 风扇上方；USB Hub 按 70×30×12 占位放电脑层前沿；RK3399 散热片 20×20×10 + 40×10 风扇。
    - frame_spec.EXTRA_M3 / export_plates_dxf：顶板 P3 加 EL-IF 4 个 M3 孔（离通风孔中心 ≥ 7.07），DXF 已重出；模型顶板同步。
    - MIS-01装配说明.md（新，用户要求）：从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
2026-10-21 render_views：可选侧板 / 背板分组处理，新增 07 全装视图
    01、05 不画全高侧板（纯盖板、可不装），02 / 03 / 06 去掉侧板看机内，04 / 07 全部装上。
2026-10-21 Orange Pi 4 改用 M2.5×25 铜柱架高：用户的 Pi 排针在板子背面朝下
    问题：用户反馈（2026-10-22）手上的 Orange Pi 4 的 40 针排针焊在板子背面、朝下。原来 Pi 用 6 mm 铜柱平放在电脑层板上，
    板下只有 6 mm，杜邦插头（约 14 mm）插不上。用户在 4 个方案里选了“加高铜柱”。
    修改：
    - Pi 铜柱 6 → 25（板底 z 289，比 Dock 高 19）：排针塑料座 2.5 + 杜邦插头 14 → 插头下沿离板底 16.5，再留约 8 让线弯；
    parts.orangepi4 排针改画在板底（ORANGEPI4_HEADER，DXF 量的长 34，实物 2×20 约 51 待实测），装配里加杜邦插头占位块。
    - Pi 端 HDMI 小板跟着抬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
    [assembly_computers.py, render_closeups.py]
2026-10-21 斜面板 Pico 改插针装（记录与装配步骤）；HDMI 小板记录随 Pi 架高更新
    1. SLANT：用户没有焊台、不焊贴片，Pico 由邮票孔平贴改为插针装——工程库封装 1–40 脚改通孔（孔 1.0、排距 17.78），
    板背面焊两条 1×20 排母，Pico 焊排针插上；Pico 网络重新布线，DRC 0 间距/连接错误。
    设计记录与上电测试清单第 3 节补装配顺序（先焊排母，再焊推子编码器；排针短头从 Pico 背面插）。
    制板文件导出时 EDA 崩溃，待重开后重新导出（现有 SLANT_D1.1 Gerber 仍是平贴版，勿用）。
    2. HDMI_FPC_D1：Orange Pi 4 改用 M2.5×25 铜柱架高 19 mm，两头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
2026-10-21 Orange Pi 4 背面排针高度按用户实测改为 8.6（原估 8.5）
2026-10-21 Orange Pi 4 背面排针按官方 DXF 焊盘定准：2×13 = 26 针 + 3 针调试串口，都画在板底
    用户说明（2026-10-22）：排针和 3 针调试串口都反焊在板子背面。从 orangepi-4-LTS-V1.1_top.dxf 数焊盘：
    排针两排 y 51.96 / 54.5、x 24.55–55.03，节距 2.54 → 2×13 = 26 针，长 33（原占位 34）；
    另一排 3 个焊盘 y 54.39、x 16.82 / 19.36 / 21.9 是调试串口，紧挨排针一头。两组都画在板底（连塑料座 8.6），
    装配里各加杜邦插头占位（25 mm 铜柱下够插）。
2026-10-21 Orange Pi 4 排针改为 2×20 = 40 针（用户的是非 LTS 版）
    上一个提交按 4 LTS 图纸数成 2×13 = 26 针，但用户的板子是 Orange Pi 4 非 LTS，40 针（整机架构文档写的 40 针是对的）。
    排针按 LTS 图 1 脚位置往网口端延长到 20 位（Pi 局部 x 23.3–74.1），杜邦插头占位跟着变长；调试串口位置沿用 LTS 图，实物核对。
2026-10-21 架构文档：贴片件全部改走嘉立创 PCBA（用户没有焊台）
    采购段写明 2026-10-22 起自制板贴片件随板配料贴装，补单只留直插件；第二批补单删掉 IV-18 主板全部贴片（21 行）、
    HV-UNI C10150 / C27777、盖革夹子板 C1694257、0 Ω C17477，共 74 行（procurement 不进 git）。
2026-10-21 斜面板 Pico 改插针装：抬到两条 1×20 排母上（SLANT D1.1 06:28 版）
    用户 2026-10-22 定 Pico 插针装（mis-01-5d 改板）：Pico 焊排针，插在斜面电路板背面两条 1×20 排母上（塑高 8.5 + 排针塑料座 2.5），
    Pico 板底离斜面电路板背面 11（t 21.1），USB 座中心 t 23.4、口在 u 78.2。新增 pico_sockets()：两排通孔间距 17.78、沿 u 中心 52.33（孔位 u 28.2–76.46）。
    SLANT D1.1 STEP 里没有 Pico 实体，不用过滤。
    复查：Pico、排母、排针座、90° 弯头插头（11×8×10 + 线尾）与整机都不相交；插头与 Pico 2.6 mm³ 是占位从座子外壳口算起、实际顶在唇边，不是碰撞；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
2026-10-21 面包板实验不做，改在 EL-IF D1.3 PCB 上验收；清单第 9 节补接屏前两项检查
    用户确认：EL-IF D1.3 PCB 直接下单，面包板实验 0–4 省掉。保留其中仍有效的两条，改在 PCB 上做：
    接屏前先不接屏用示波器看 CP1/CP2/S/数据线的 5 V 电平与时序、VD 开关顺序；确认屏线 1 脚实物方向。
2026-10-21 新增嘉立创下单清单：15 块板的文件、参数、数量和贴片套数
    打板与贴片同一订单；逐块列出 Gerber/贴片文件路径、特别参数（电源板 2 oz、HDMI 小板 1.6 mm、IV-18 端板黑色阻焊）、
    下单数量与贴片套数（HV-UNI 贴 3、IN-14 小板做 10 贴 7），以及贴片预览要核对的极性器件。
    两块 HDMI 小板补出 JLC_SMT_BOM/CPL（制板文件不进 git）。
2026-10-21 下单清单：HDMI 夹板插头两面焊盘需在备注说明
2026-10-21 下单清单：IN-14 小板贴 7 套为装机 6 块加 1 块备用（用户 IN-14 管子是 6 支）
2026-10-21 新增交互式焊接图生成脚本 make_solder_map.py
    从各板制板文件（Gerber 丝印/板框、飞针表焊盘坐标、BOM、JLC_SMT_CPL）生成单文件 HTML：
    左边板图（正/背面切换，1 脚焊盘偏亮），右边按型号分组的焊接清单；点一行高亮对应位置，勾选记录在本机浏览器。
    同型号里嘉立创已贴、不焊、自己焊的位号分开成行（如 IV-18 的 0Ω：R15/R16 已贴、R17–R19 不焊）。
    输出 el_driver/焊接图/*.html（生成物，不进 git）。
2026-10-21 ESP32 固件 0.2.0 联网（规格 v0.9.6）；新增 Orange Pi 侧服务 mis01d（规格 v0.9.5）
    一、Pi 侧程序 pi/（服务 mis01d，Python，systemd）
    - 关机握手：22 脚 PI_SHDN_REQ（GPIO1_D0，开内部上拉）持续低 ≥ 500 ms 或 ESP 上报 !SHUTDOWN → poweroff；
    连上 ESP 时它已在 SHUT（钮子在 Pi 开机途中就关了、!SHUTDOWN 已错过）也关机，免得 60 s 后被硬断电。
    - 保护：22 脚上电默认内部下拉（原理图 _d），必须先读到过一次高、之后的低才算关机请求；否则上拉没生效时服务一启动就会关掉 Pi。
    - PI_RUN（16 脚 GPIO1_C6）改用设备树 gpio-hog 拉高到断电（overlay/），不交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
    [partitions.csv]
2026-10-22 Pi 22 脚上拉改由设备树设置（规格 v0.9.7）；修安装脚本 user_overlays 被覆盖
    问题 1：PI_SHDN_REQ（40 针 22 脚，GPIO1_D0）在 Pi 上实测一直读 0。
    原因：这个脚上电默认内部下拉；mis01d 用 libgpiod 请求上拉，gpioinfo 也显示 [pull-up]，
    但 rockchip GPIO 驱动的 set_config 不支持 bias，请求被静默忽略。（先见高才认低的保护生效，没有误关机。）
    修：在用户 overlay 里加 pinctrl 组 mis01-shdn-pu（bank1 pin24、GPIO 功能、pcfg_pull_up），
    挂在一个空的 regulator-fixed 节点 mis01-pullups 上，它探测时套用默认 pinctrl 状态。
    不挂在 gpio1 节点上：PMIC、触摸、F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
2026-10-22 焊接图网页纳入版本管理，便于换电脑焊板调试
    - 原因：el_driver/焊接图/*.html（12 块板的交互式焊接图）被 .gitignore 的
    /el_driver/* 整体忽略；生成脚本 make_solder_map.py 虽在仓库里，但它读取的
    各板「制板文件」（Gerber/BOM，约 480 MB）不进仓库，换电脑后既拿不到网页也无法重新生成。
    - 做法：.gitignore 白名单放行 el_driver/焊接图/*.html（纯文本自包含，共约 1.6 MB），
    其余文件仍忽略。以后重新生成焊接图后需一并提交。
2026-10-22 下单清单：补四张单总览（PCB+SMT / 立创补单 / 淘宝 / 外壳暂缓）与贴片面说明
    - 新增"零"节：本轮订单 A 嘉立创打板贴片、B 立创商城补单 74 行、C 淘宝自购 40 项（27–32 外壳件除外）、
    D 外壳钣金/CNC 建议等板子和喇叭到货试装后再下
    - 第一节补充：所有贴片板的贴片件都在顶层，贴片面选顶层；只上传 JLC_SMT_BOM/CPL，
    "_全部"文件不传；不贴片的板只传 Gerber
2026-10-22 新增元器件库存系统 Part-DB 的 NAS 部署文件
    - 背景：元器件越买越多，Excel 库存表手工对账易漏买 / 重复买，台式机、笔记本、手机也看不到同一份。
    选开源 Part-DB（专管电子元器件，单容器 + SQLite，内置立创数据源和料袋扫码，有中文界面）。
    - inventory/nas/docker-compose.yml：jbtronics/part-db1:2.20.2，端口 8088，数据放 NAS
    /volume2/docker/partdb/{db,uploads,public_media}；中文、上海时区、基准货币 CNY；
    开立创数据源；TRUSTED_HOSTS 只放行局域网两个 IP 和 Tailscale IP（$ 用 $$ 转义）。
    - inventory/nas/deploy.sh：需 root 运行。建目录并 chown 给容器 www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
2026-10-22 立创第二批补单换料：订货 / 在途 / 下架件换成现货（设计记录同步料号）
    原因：立创 BOM 配单（BOM261022006975）里 5 行显示"订货 7–10 个工作日"、保险座只有在途货、
    2 个编号已下架被系统自动换成别的料（其中 1 nF 换成了 2.54 脚距，焊不上 5.08 的孔）。
    换料（封装 / 脚距 / 参数按板子核对过）：
    - HV-UNI C10 22 nF X7R：C1622400 → Vishay K223K15X7RF5UL2 C1624981（脚距 2.5，焊时掰到 5.0 孔）
    - HV-UNI C11 100 pF C0G：C1624554 → 同系列 K101J15C0GF5TH5 C3694165（P5.0）
    - HV-UNI R12 680 k 1%：C119385 → 华星 MF1/4W-680KΩ±1%T52 C714049
    - 辉光驱动板 Q1–Q6 MPSA42：KEC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
2026-10-22 元器件库：旧库存表导入 Part-DB 的脚本（已导入 157 种）
    - inventory/partdb_client.py：Part-DB REST 客户端。令牌和地址读 partdb_local.conf（不进 git）；
    自动翻页；分类/存放位置/厂家等按“名字 + 父节点”查找，找不到就建（ensure / ensure_path）；
    封装立创信息提供者接口 /api/info_providers/details；支持 --dry-run 不写库。
    - inventory/value_parse.py：把“1 MΩ”“470 μF / 16 V”“10 A / 250 V”等解析成基本单位参数
    （阻值、容值、耐压、电感量、稳压值、额定电流/电压），网页上可按参数筛选。
    - inventory/lcsc_enrich.py：立创件挂“立创商城 + C 编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
2026-10-22 元器件库：立创订货合同入库脚本，两张合同已入在途库存
    - inventory/lcsc_contract.py：解析立创商城《订货合同》PDF（或装多份 PDF 的 zip），取订单号、
    下单日期、合同总计和每行 C 编号/数量/含税单价/金额。合同表格提取时中文和小数点顺序会乱
    （“19.4334”读成“19 4334”），所以只取这四栏，并用 数量×单价≈金额 逐行校验。
    - inventory/lcsc_categories.py：补单表“分类”→ 库里（大类, 子类），与旧库存表分类树一致；
    XH/排针/排母/NPN·PNP 按型号和描述细分，未知的放“其他/未归类”。
    - inventory/import_lcsc_order.py：按 C 编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
2026-10-22 电源板 PWR-DIST 下单改 1 oz 铜（2 oz 加价约 300 元，复核后 1 oz 够用）
    复核方法：从 EDA 读出各电源网络走线宽度，按 IPC-2221 外层 1 oz 估温升：
    - 24 V 主干 3 mm：6 A 约 +13 ℃，LRS 满载 8.8 A 约 +32 ℃
    - 模块输入 2 mm @3.9 A 约 +10 ℃；+5V 母线 2.5 mm @6 A 约 +18 ℃
    - 电子保险输出 1.6–2 mm @3 A 约 +8 ℃；+12V 1.5 mm @4 A 约 +17 ℃
    - +5V_PI 主路为 1.6/2 mm，0.4 mm 那段只接指示灯电阻
    实际负载远低于最坏值。改 1 oz 后 TPS259470 0.19 mm 焊盘间隙的工程问询也不再存在。
    丝印"Cu 2oz"字样不改；下单清单与设计记录同步。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
2026-10-22 贴片范围缩减省加工费 + 按嘉立创库存换 7 个缺货贴片料
    原因：嘉立创贴片每款收工程费（经济型 50 元、标准型 150 元），原方案 7 经济 + 2 标准共 650 元；
    另外查嘉立创贴片库存，7 种料缺货或刚够。
    贴片范围（加工费降到 6 × 50 = 300 元）：
    - 08 HV-UNI、09 IN-14 小板、13 盖革夹子板不再贴片：只有 1–2 个大焊盘件，用户烙铁自焊
    - 04/05 HDMI 两块改经济型：J1 夹板 HDMI 插头从贴片 BOM/坐标删除，用户拖焊（每面 1 mm 脚距）
    - 自焊件另出立创第三单（procurement，不进 git），HDMI 插头买 10 个
    - 原贴片文件移到各板 制板文件\贴片已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
2026-10-22 架构文档：同步贴片范围缩减（跟 0dbbc5b）
    画板会话为省嘉立创贴片工程费（经济型 50 元/款、标准型 150 元/款）缩了 PCBA 范围，
    文档立创下单一节原来写的是“所有自制板贴片件都走 PCBA”“HDMI 标准 PCBA、双面贴装”，已过时：
    - HDMI-PI / DOCK 改经济型单面贴，J1 夹板 HDMI 公头用户拖焊，贴片 BOM 去掉 C711355
    - 走 PCBA 的只剩 EL-IF、PWR-DIST、KBD-ADAPT、HDMI-PI、HDMI-DOCK、IV-18 主板 6 块
    - HV-UNI ×3、IN-14 小板、盖革夹子板的贴片件改烙铁自焊
    - 新增立创第三单（自焊贴片件，build_lcsc_bom_order3.py，5 行）说明
    - 自制板元件一段同步改写
    Co-A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
2026-10-22 元器件库：补单分类映射加贴片电阻、功率电感、HDMI 连接器
    立创第三单（自焊贴片件）用到这三个分类，原映射没有，会落到“其他”大类下。
    现在分别归到 电阻/贴片电阻、电感/功率电感、连接器/HDMI 连接器，和已有分类树一致。
2026-10-22 01/02/06 改自己钢网回流焊，不再交嘉立创贴片（省扩展库换料费）
    原因：嘉立创贴片除每款 50 元工程费外，扩展库元件每种另收约 20 元换料费且每款单独收。
    02 PWR-DIST 有 17 种扩展料，贴 2 套报价约 540 元（换料费 320）；01/02/06 三款换料费合计约 660 元。
    改法：
    - 01 EL-IF、02 PWR-DIST、06 IV18 不勾贴片，改订顶层钢网，用户刷锡膏 + 加热台回流；
    贴片料走立创商城第四单（procurement/build_lcsc_bom_order4.py，54 种，2 套 + 备件，不进 git）。
    立创商城无货换同规格件：1uF 0805 → C91185、10k 0603 → C98220、ME6211C33M5G-N → AP2112K-3.3TRG1 C51118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
2026-10-22 架构文档：同步 EL-IF / 电源板 / IV-18 改自己回流焊（跟 296af7a）
    画板会话发现嘉立创扩展库元件每种另收约 20 元换料费（电源板一款贴 2 套约 540 元），
    把 01/02/06 改成订钢网、用户刷锡膏加热台回流焊。文档立创下单一节按此改：
    - 贴片范围：只剩 KBD-ADAPT、HDMI-PI、HDMI-DOCK 三块嘉立创经济型贴；EL-IF、PWR-DIST、IV-18 钢网自焊；
    HV-UNI / IN-14 / 盖革夹子板仍烙铁自焊
    - 新增立创第四单（自贴三板贴片料，54 种，2 套 + 备件）说明和 4 个无货换料
    - PCB-3 贴片件、自制板元件两处旧说法同步；回流焊工具指向自购清单第二批 41–47 项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
2026-10-22 元器件库：第四单“贴片件”按型号细分分类
    立创第四单（自贴三板贴片料）分类一栏全写“贴片件”，原映射会把 54 种都塞进“其他/贴片件”。
    加 SMD_PREFIX 型号前缀表（TVS、稳压/肖特基二极管、自恢复保险丝、MOSFET、PNP、电子保险丝、
    电压监控、LDO、逻辑 IC、电机驱动），其余按规格末尾 Ω / F 归贴片电阻、贴片电容。
    用第四单 54 行试过，全部落到具体子类。
2026-10-22 下单清单：淘宝第二批改买 1–47 项（含回流焊工具），第四单改 49 种
    - memory-69 在淘宝第二批末尾加了 41–47 项回流焊工具（fc9b2d5 同步），第零节 C 改为"买 1–26、33–47 项"。
    - 第四单按 memory-69 核对合并同规格不同编号的料（100nF 0805 统一 100 V 款 C106243、1uF 0805 统一 C91185、
    BZT52C12 统一 C173429、BAT54WS 统一 C124205），0Ω 0805 C17477 第三单已买 100 个、本单不再重复；54 → 49 种。
    换过料的行"参数/规格"改写新件规格（原来 C51118 一行还写着 ME6211）。脚本 procurement/build_lcsc_bom_order4.py 不进 git。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
2026-10-22 第四单改 49 行后同步：分类规则认英文规格写法，架构文档改种数
    98ce984 画板会话合并了第四单的同规格重复编号（54 → 49 行，0 Ω 改用第三单），换料行的“参数/规格”
    改成立创英文描述（如“CAP CER 1uF 50V X7R 0805”“RES 10kΩ ±1% 100mW 0603”）。
    原规则只认规格末尾是 Ω / F，这 3 行会落到“其他/贴片件”。
    修法：规格以 RES / CAP 开头，或末尾是阻值 / 容值，都算贴片电阻 / 贴片电容；新表 49 行全部归类。
    架构文档第四单说明改为 49 种，注明 100 nF 统一 100 V 的 C106243、0 Ω 用第三单的。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
2026-10-22 元器件库：修合同解析把“±1%”的 1 读进数量（100 读成 1100）
    现象：第四单合同 SO2610232955 有 4 行 1% 电阻数量解析成 1100，数量 × 单价 ≠ 金额，
    商品合计 676.46 比合同总计还多。
    原因：PDF 表格里描述栏“厚膜电阻 1kΩ ±1% …”换行时，“1”被 PyMuPDF 归到相邻的数量格，
    数量格原文是“1\n100个”；原代码先去掉换行再取最后一串数字，拼成 1100。
    修法：数量只取格子里最后一行带数字的那一行。四份合同重新解析，商品合计 + 运费都等于合同总计。
2026-10-22 钢网改三板拼一张：新增 make_stencil_panel.py 合并 01/02/06 顶层锡膏层
    原因：嘉立创钢网最小 30×40 cm，01 EL-IF、02 PWR-DIST、06 IV18 各订一张太浪费。
    做法：脚本从三块板 Gerber 压缩包取 GTP（顶层锡膏）和 GKO（板框），宏名加板名前缀、光圈 D 码重新编号，
    按 Y 方向依次平移（间隔 15 mm，从下往上 PWR-DIST、EL-IF、IV18），合并成一个 GTP + GKO，
    输出 下单文件_20261022/00_钢网_三板合一/钢网_EL-IF+PWR-DIST+IV18.zip（下单文件不进 git）。
    拼板外形 150×267 mm；合并后图形语句数 2749 = 1637+192+920，渲染预览核对过焊盘位置。
    圆弧的 I/J 是相对偏移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
2026-10-22 钢网拼板文件改名 Stencil_ELIF_PWRDIST_IV18.zip
    原因：嘉立创钢网上传提示文件名不能含特殊字符，原名里的 + 号（和中文）被拒。
    改法：make_stencil_panel.py 输出名改纯英文下划线，重新生成；下单清单同步。
2026-10-22 架构文档：01/02/06 钢网改为一张拼板钢片（跟 4f309ed）
    画板会话把 EL-IF、PWR-DIST、IV-18 三块的顶层钢网拼在一张 30×40 cm 简易钢片上单独下单
    （make_stencil_panel.py），PCB 订单不再勾钢网。原文“各订一张顶层钢网”改为拼板钢网说明。
2026-10-22 HDMI-DOCK U1 改 AP2112K-3.3TRG1（嘉立创 ME6211 无货）
    原因：05 HDMI-DOCK 下单贴片时 U1 ME6211C33M5G-N（C82942）嘉立创已搜不到库存，系统提示缺料。
    改法：贴片 BOM（制板文件与下单文件夹三份，不进 git）U1 换 Diodes AP2112K-3.3TRG1 C51118（库存约 1.5 万），
    SOT-23-5 脚位与 ME6211 相同（1 VIN 2 GND 3 EN 4 NC 5 VOUT），Vin ≤ 6 V，输入约 4.65 V 够；
    输出 C2 1 µF 陶瓷满足稳定要求。与第四单 PWR-DIST U_LDO 用同一颗。设计记录补一行。
2026-10-22 盖革夹子板垫高改用尼龙螺母 + 垫片（M3×3 尼龙柱买不到）
    用户发现尼龙隔离柱最短只有 M3×5。改 5 mm 会把夹子板和 J305 抬高 2 mm，管顶到 z 112.3，
    贴着前面板盖革窗上沿（113），左端加宽处还要重查 IN-14 管座下方的空间。
    改法：高度不变（GM_SHIM 仍 3），每孔 M3×12 尼龙螺丝 + 板下 1 颗尼龙螺母（约 2.4）+ 1 片尼龙垫片垫高，
    甲板下再拧 1 颗螺母；三处孔甲板下层型材只在两侧，不挡。assembly.py 注释、架构文档盖革一行同步。
2026-10-22 EL-IF ↔ Dock 连接线改为 2×6 公对母（原写母对母是错的）
    原因：用户看实物，Dock 上的 J5/J6/J14 是 2×6 母座（黑色带孔），不是排针；EL-IF 的 P1–P3 才是公排针。
    原记录写"2×6 母对母延长线"两头都插不上 Dock。
    改法：D1.3 变更记录与上电测试清单改为"2×6 公对母双排杜邦线，公头插 Dock 母座、母头套 P1–P3，两头 1 脚对 1 脚"。
    淘宝第二批表里该行仍写母对母，用户已在购买阶段，按用户要求不改表，购买时按公对母买。
2026-10-22 下单清单：淘宝第二批改买 1–26、32–47 项
    第 32 项由 memory-69 从「腔体喇叭支架」改为 5151 喇叭固定用 M3 锤头螺母 + M3×8 螺丝（喇叭改直锁 Y 梁），本次就要买；
    另注明用户买二合一拆焊台后第 41 项烙铁、43 项热风枪不用另买。
2026-10-22 喇叭换 5151 腔体喇叭，取消打印支架，耳朵直接锁 Y 梁内侧槽
    用户要音质更好的喇叭，选了 5151 款 4 Ω（本体 51×51×39.5，耳朵总长 82、孔距 69）。
    3070 只有 70×30×17、后腔很小，低音出不来；5151 音腔约 4 倍。
    摆法：出声面贴左右下舱 Y 梁内侧（x 20 / 300），耳朵朝上下——本体 51 高正对下层与甲板层
    Y 梁之间 z 20–70 的空档，耳孔 z 10.5 / 79.5 对两根梁内侧槽心 z 10 / 80（差 0.5，槽宽 6 能吃下），
    M3 + 2020 锤头螺母直接锁，原打印支架 speaker_cradle 删除。
    左 y 22–73（离前立柱 / 前横梁 2）、右 y 24–75（离灯按钮 2.8），整机求交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
2026-10-22 装配说明：喇叭改 5151 后去掉打印支架，T 螺母预埋改为 M3 锤头螺母锁喇叭
2026-10-22 Pi / Dock 位置定稿并微调躲孔；新增层板手钻孔位图
    层板已按 DXF 做好（只有 10 mm 孔阵和固定孔），Pi、Dock、XL6009 等不在孔阵上的孔要手钻。
    核对发现原位置下 Pi 3 个、Dock 2 个孔离孔阵孔中心 2.2–3.6 mm，钻下去会和孔阵孔连成缝；
    先试的“两块一起后移 3.5”又让后排孔压到电脑层板后走线长孔边上。
    改法（用户确认 Pi/Dock 布置）：Pi 后移 1.5、Dock 左移 2.5（Dock 不前后挪），8 个孔离孔阵孔 ≥ 3.8、
    离走线孔 ≥ 2.6。两块 HDMI 口面不再同 y（Pi 174.2、Dock 172.7），assembly_computers 拆成
    Y_PORT / Y_PORT_PI，HDMI 小板各按自己的口面放，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
2026-10-22 新增零件实测记录（外购件到货后要量的尺寸）
    前壳 / IEC 小板开孔还是按估计尺寸画的，下单前要用实物核对。按零件列出要量的项目、
    模型现在用的值和留空的实测栏，★ 标出影响钣金开孔、下单前必须量的项；
    用户量完由 Claude 填入并改模型，状态栏记到哪个提交。.gitignore 放行此文件。
2026-10-22 键盘座由 POM CNC 改为尼龙 MJF 打印，螺丝孔改热熔铜螺母孔
    键盘座长 320、厚 8.9，槽底板 0.8、筋 1.2，背面敞开空腔，至少 3–4 次装夹，CNC 难做且贵，
    用户决定改嘉立创 3D 打印尼龙 MJF（PA12 染黑），一整件打。
    - parts_dock：新增 INSERT_R，舌片 3 个、两端 4 个 M3 孔由 Ø2.5 攻丝底孔改 Ø4.0，压 M3×4 热熔铜螺母
    - export_enclosure 下单说明第 6/7 条、架构文档、装配说明同步；外壳加工/ 已重新导出（不进 git）
    - 槽底板 0.8 mm 未改，报价若提示壁厚不足再处理
2026-10-22 实测记录：加键盘座打印前要量的排线 01AY247、POGO 小板、转接小板
    键盘座背盖还没开出线槽、转接小板位置未定；槽底 0.8 想加厚到 1.0 要先确认 POGO 触点伸出高度。
2026-10-22 外壳导出：键盘座和背盖加出 STL（嘉立创 3D 打印建议 STL），下单说明写明壁厚下限
    嘉立创 3D 打印要求壁厚 > 1.2、最薄处 ≥ 0.8；键盘座槽底板 0.8、磁铁开孔横筋 0.8 正好在下限，已在说明里标出。
2026-10-22 键盘座 CNC 询价图：同名 STEP + 2D PDF（POM，M3 攻丝版）
    用户想同时问 CNC 价（CNC 可做表面处理）。嘉立创 CNC 询价要 3D STEP（必须）+ 2D 图纸，文件名一致。
    - parts_dock.keyboard_dock(hole_r)：7 个 M3 孔半径可选，打印件 Ø4（热熔铜螺母），CNC 版 Ø2.5（攻 M3）
    - 新增 fig_dock_drawing.py → 外壳加工/键盘座_CNC询价/（不进 git）：
    键盘座_keyboard_dock.step/.pdf：第 1 页 A3 1:1 正 / 底 / 背视图 + 4:1 端视图 + 技术要求，
    第 2 页 2:1 右半详图（零件左右对称，槽内各孔、磁铁槽、加强筋坐标标注）；
    视图用 OCC HLR 从 3D 模型投影，尺寸从 parts_dock.SP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
2026-10-22 钣金件询价包：每件 STEP + 同名 2D PDF，打包 zip；出图公用代码抽到 drawing2d.py
    嘉立创钣金询价要 3D STEP（必须）+ 同名 2D（dwg/dxf/pdf），可整包上传。
    - 新增 drawing2d.py：OCC 隐藏线投影 hlr()、按投影范围摆位 place()、A3 图纸 Sheet
    （视图、总体尺寸 overall、标注、坐标标注、引线、技术要求、标题栏）；fig_dock_drawing 改用它，输出不变
    - 新增 fig_sheet_drawing.py → 外壳加工/钣金询价/（不进 git）：前壳、下巴托、IEC 小板、全高侧板、背板
    各一份 STEP + PDF（视图 + 总体尺寸 + 技术要求：5052 2 mm、内 R1.7、拉丝 + 透明阳极 / 清漆两种报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
2026-10-22 表头 85C1 内阻测法一更正：改 5 V 串 4.7k + 10k 电位器
    原因：原写 1.5 V 电池串 ≥10 kΩ，最大电流只有 0.15 mA，到不了 1 mA 满偏，按此方法测不出内阻。
    改法：5 V 串 4.7 kΩ 固定 + 10 kΩ 电位器，电位器最大时约 0.34 mA、拧到 0 最多约 1.06 mA，能调到满偏又不明显过流。
2026-10-22 ESP32 规格：表头 85C1 内阻实测 164 Ω，定微调初值
    用户按串联 10 kΩ 法实测内阻 164 Ω（不带分流器）。F6 写入实测值；微调装机先拧到约 100 Ω，
    满偏占空比约 90%（FS≈3680），不要超过约 430 Ω（2.7k+微调+164 > 3.3 kΩ 时 100% 也到不了 1 mA）。
    默认 FS=3350 仍保守（约 0.91 mA），保持不变，靠 MTR CAL 校准。待定项删去「表头内阻」。
2026-10-22 ESP32 规格：表头内阻记为约 160 Ω（两种测法 164 / 160）
    用户又用万用表直接量得约 160 Ω，与串 10 kΩ 法的 164 Ω 一致；微调初值和 FS 估算不变。
2026-10-24 元件柜收纳规划：抽屉分格规则 + A4 标签 + 收纳对照表
    用户买了两个元件柜（A 柜 18 小 + 6 大，B 柜 30 小 + 9 大，B 的大抽屉放工具），
    每个抽屉分前后两格，按类别给 Part-DB 里全部 279 种料分了格子。
    - storage_plan.py：抽屉编号（A01–A18、AL1–AL6、B01–B30）与每格内容；assign() 按分类、
    封装、数值把每种料分到格子（旧 T-01～T-06 三极管整格搬；电阻按量级分 6 格不逐值分；
    贴片按 0603/0805 分；电解按容量耐压分大小格；五金集中在 B17–B20、AL6）；
    空着的抽屉留作备用。
    - partdb_parts.py：从 Part-DB 取全部零件（分类路径、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
2026-10-25 零件实测记录：表头螺柱位置改成可直接量的项
    原来写「螺柱在表心下方多少」，表心在表头内部量不到。改为都从面框边量：
    螺柱中心到面框下边（模型 15）、凸台上下左沿到面框边（模型 3.5 / 3.5 / 7.5），
    由这几项反推表心和螺柱的相对位置；螺柱间距注明用外侧到外侧减螺柱直径量。
2026-10-25 表头 85C1 按实测改模型和前面板开孔
    用户实测（零件实测记录.txt）：凸台 Ø48、凸台中心比面框中心低 1.75、M3 螺柱孔距 53、
    螺柱中心离面框下边 12.4（面框中心下 15.6）、面框厚 9.6、板后 32（含接线螺丝 42）。
    - parts_panel：尺寸提到模块级 METER_SPEC，原点改为面框中心，凸台 / 表体按 boss_z 下移，加接线螺丝
    - assembly_panel：METER 定义为面框中心（6E2 窗与面框上下齐平的排版不变），开孔中心、螺柱孔
    从 METER_SPEC 算；开孔 Ø50 → Ø49
    - 右螺柱外移 0.5，M3 螺母 + 垫片到 x 244，6E2 窗后亚克力左边 244 → 245 让开
    - fig_sheet_drawing：钣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
2026-10-25 零件实测记录：填入表头 85C1 实测值，状态改为已改模型（2a2743a）
2026-10-25 斜面板左 USB 缺口加高示意图；实测记录填按钮 / 钮子 / 指示灯 / USB
    - USB 改成 1 个上下叠放双口延长线（本体 23 × 19.2 × 深 30，耳孔距 30、M3），放左缺口（斜面 x 28、u 10）。
    本体高 19.2 超出 SLANT D1.1 左缺口顶 u 17，板已下单：查 Gerber，板本地 x 0–24、y 17–20.5 只有 GND 铺铜，
    到货焊元件前手工切掉这条（美工刀划断）。新增 fig_slant_pcb_cut.py → png/28_slant_pcb_cut.png（顶面 / 背面 + 放大标尺寸）。
    - 实测记录：带灯按钮与模型一致（四爪垫片防转，螺纹 11.5 / 螺母 9.3 够夹 2 mm）；钮子不装保护盖；
    指示灯灯头 19（模型 19.5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
2026-10-25 斜面板设计记录：左 USB 缺口到货后手工加高 3.5 mm
    原因：斜面两个单口 USB 延长线改为 1 个上下叠放双口件（宽 23 × 高 19.2），
    放左缺口（斜面 x 28、u 10），本体高出原缺口顶 u17（memory-69 通知，示意图 png/28，fc780f0）。
    处理：板已下单不改设计，焊元件前切掉本地 x 0–24、y 17–20.5；该条只有两层 GND 铺铜，
    无走线/过孔/元件。补记注意事项：切后模式开关 Ø34 孔与缺口之间只剩约 2.5 mm 板筋，
    要锯/剪后锉平，不能掰。右缺口以后空着，原 S-1 的 Pico 插头靠近延长线问题随之消失。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
2026-10-25 斜面板切缺口示意图：改为锯 / 剪后锉平，不能掰
    mis-01-5d 指出：模式开关 Ø34 孔下缘在板本地 y 23，切到 y 20.5 后孔和缺口之间只剩约 2.5 mm 板筋（x 3–24），
    原说明写的「美工刀划深后钳子掰断」会把板筋掰裂。改为细齿锯条 / 拉花锯或斜口钳剪，再锉到线；多切不超过 0.5。
2026-10-25 推子按实测改面板开槽 62 → 67
    用户实测 PTA6043 推子：拨杆沿槽宽 5（模型原 4）、厚 1.2；本体槽长 67、总长 75、两端螺丝孔距 70。
    原面板槽 62 比「行程 60 + 拨杆宽」还短，拨杆推到两头会被面板挡住约 2.5 mm（建模时开槽是估的）。
    改为与本体槽同长 67 × 2：斜面开孔表（assembly_panel）、推子模型 SPEC（parts_panel）、钣金图技术要求同步。
    推子焊在斜面板上，位置、本体尺寸与板一致，板不用动。
2026-10-25 零件实测记录：推子状态写提交号；编码器旋钮 Ø15 带指示尖角，与模型一致；中心距说明改清楚（不用量）
2026-10-25 LRS-200-24 按规格书安装孔对齐底板孔阵；实测记录填 IEC / Hub / XL6009 / 功放 / SMA
    - 明纬 LRS-200 规格书（Case 207）：底面 4-M4，离端子端 32.5、孔距 150，离长边 32.5、孔距 50，螺丝伸入壳内 ≤ 3。
    电源位置 (22, 83) → (22.5, 82.5)，四孔正好落在底板孔阵 (55/205, 115/165)，只需把这 4 个 Ø3.2 孔扩成 Ø4.5，
    不用另画线钻孔；用 M4×6 沉头、底板背面锪窝（盘头约 3.1 高，比 3 mm 脚垫还高会顶到桌面）。frame_spec.DRILL P4 同步，png/27 重出。
    - 实测记录：IEC 插座与模型一致；Hub 实为 66×50×16、M3 孔距 58×44；XL6009 43×25×13、对角孔离边 6/3；
    PAM84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
2026-10-25 脚垫改铝脚垫 6 高、装在四根立柱底下；底板钻孔表加 4 个 Ø6.5；实测记录补排线 / POGO / 脚垫
    - 用户定铝合金脚垫：高 6 + 1 mm 垫圈，按 6 算（宁可键盘连接条离桌面多 0.5，不能比脚垫先着地）。
    assembly_panel.FEET_H 3 → 6；新增 FEET_XY（四根立柱中心 10/10）、FEET_D（Ø20，直径待量）。
    - 装法：底板四角钻 Ø6.5，M6×16 顶丝穿底板拧进立柱底端（用户量横梁端面螺丝外径 6，型材中心孔是 M6，
    不是文档写的 M5；frame_spec 的 M5 / 通孔 Ø5.5 待用户量完再改）。frame_spec.DRILL P4 加 4-5～4-8，png/27 已重出。
    - 原 3 mm 脚垫时底板 M4 内六角头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
2026-10-25 Part-DB 库位改成收纳格：新增 apply_storage_locations.py
    用户扫立创袋子二维码时零件页显示“待入库（在途）”，看不出该放哪格，
    要求直接按收纳规划入库、扫码照着放。
    - apply_storage_locations.py：建 A柜/B柜 下 A01前…B30后 各格及 层架/文件袋/大盒子，
    按 storage_plan.assign() 把每个批次的库位改到目标格；已在目标格的不动，可重复运行；
    默认只列出改动，--apply 才写入。已执行：285 个批次全部改完，再跑一次为 0 改动。
    - storage_plan.assign()：三极管原来靠旧库位 T-01…T-06 映射到 A01前…A03后，挪完后旧名不存在，
    补上“已在 A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
2026-10-25 按零件实测统一改模型：斜面加长、下巴下移、键盘座背盖、USB 双口、Hub/升压/功放/天线定位
    起因：零件实测基本量完（零件实测记录.txt），用户要求量完后一次改完、统一跑干涉，再出最终模型图和加工图。
    外壳 / 键盘
    - 铝脚垫 6 mm（含垫圈 7，按 6 算）比原来 3 mm 高，桌面低 3，键盘连接条够不到桌面。
    按用户提议把整个下巴往下延伸：斜面 83 → 90.8（SLANT_EXT 7.8，u 0 仍是斜面电路板下沿，器件坐标不变），
    键盘座 15 高不变跟着下移 6.5、前移 4.2；连接条最低点离桌面 0.2。
    - 下巴托底板下移到 z −7.7..−5.7（TRAY_Z）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
    [parts_list.csv]
2026-10-25 设计记录：补记整机模型实测修改对三块板的影响（板均不改）
    依据 memory-69 按零件实测统一改整机模型（867bc78）的通知：
    - KBD-ADAPT D1：记安装位置——下巴托底板全局 x 170–210、y −36…−6，板转 180° 使 J_FPC 朝前
    对键盘座背盖 46 宽出线口，前留约 9 mm 插排线；四角 M2 孔配 M2×5 铜柱；J_USB 在 x≈179。
    - ESP-BASE D1：天线改为甲板 (120,187) Ø6.5 装 1 个 SMA，取消 IEC 小板 2 个 SMA 孔；
    开发板自带 20 cm IPEX→SMA 线经后走线孔下到甲板底再接上来。
    - SLANT D1.1：斜面钣金 83→90.8，加长部分在电路板下沿以下，板及面板件相对 u0 位置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
2026-10-25 淘宝自购件入库：新增 import_taobao_lists.py，补分格规则；TPS3808 改为单买 12 个
    用户发现淘宝买的料没入 Part-DB（扫不到/查不到），要求按两张自购清单把电子件入库，工具类自己归类。
    - import_taobao_lists.py：从第一批（全买）和第二批（1–26、32–47）人工挑出 33 种电子件，
    新建零件（标签“淘宝”）或给已有零件加批次（K155ID1 +2），库位直接按 assign() 分格；
    管子同时补“手上原有”批次（IN-14 6、IV-18 1、6E2 2、J305 1，原来不在旧库存表里）。
    已执行，可重复运行（同说明的批次跳过）。
    - storage_plan：新增规则——表头/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
2026-10-25 键盘转接小板分组 keyboard → front：爆炸图里跟下巴托走，不跟键盘飞出去
    KBD-ADAPT 和 M2 铜柱装在下巴托底板上，原来放进 keyboard 组，爆炸图把它和 X1 键盘一起往前移，看起来像键盘上的件。
2026-10-25 收纳标签加大字号并加宽小标签，新增字超出格子检查
    用户要求标签重做一版、字体放大。
    - 字号：小标签编号 7→8 pt、内容 6.5→7.5 pt；大标签编号 9→10.5 pt、内容 7.5→9.5 pt。
    - 放大后 30 mm 宽的小标签有 12 张放不下（A04、B05、B18 等），小标签改成 35×10 mm（抽屉内宽 4 cm），
    每行 5 张；空白标签减到小 37 / 大 6，整页仍是一张 A4。
    - 新增 check_overflow()：Edge 渲染时页面脚本给字超出格子的标签加 over 类，--dump-dom 读回并打印编号，
    以后改标签文字跑一次就能知道有没有截字。
2026-10-26 焊接图显示每组料在元件柜哪一格：新增 inventory/bom_locate.py
    用户要求焊接对照网页能对应到收纳盒坐标。
    - bom_locate.Locator：按 BOM 行查 Part-DB，返回所在格子、库存、匹配方式。顺序：
    1) 立创编号（先按 procurement/build_lcsc_bom_order*.py 的 SUBST 换料表换成新编号，ast 只解析字面量）；
    2) 型号（相同/互为前缀/一方完整出现在另一方里，如“明纬 NID100-5”“从 PM254-1-20-Z-8.5 剪 1 针”）；
    3) 按数值：电阻电容按直插/贴片、封装、数值找同规格料（旧库存表的料没有立创编号），
    功率电阻和高压/薄膜电容格子排后；贴片料名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
2026-10-26 UC3843AN 入库（淘宝自购 DIP-8），归 A08后 DIP 模拟 IC
    焊接图查库时发现 HV-UNI 的 UC3843AN 在 Part-DB 里没有：采购脚本注明用户已自购，但不在两张淘宝清单里。
    用户确认买的是直插款（与 BOM 的 DIP-8 一致）。
    - import_taobao_lists.py 加一条 UC3843AN，数量按“够 3 块用”记 3，批次说明注明实际数待核；已执行。
    - storage_plan：UC3843 归入 ANALOG_IC，放 A08后（原规则会落到 A08前 DIP 数字 IC）。
    - 重新生成 HV-UNI 焊接图，U1 现在显示 A08后、库存 3。
2026-10-26 HV-UNI 焊接图：R3 22Ω 指向库存 20Ω
    焊接图查库时 R3（22Ω 1/4W）显示“库里没找到”。设计记录（2026-10-22 采购核对）早已定为用库存 20Ω 代替：
    R3 是 IRF840 栅极串阻，20/22Ω 无区别，用户也确认手上有 20Ω。
    STAND_IN 加 HV-UNI R3 → 固定电阻 20 Ω（B01前，库存 20），页面上注明是代用。
2026-10-26 新增“非立创料位置表”：没有立创二维码的料按原盒子分组列出该放的格子
    用户收纳时，立创袋子能扫码看格子，旧库存表里的料和淘宝件没有二维码，要一张表照着放。
    - make_nonlcsc_list.py：取 Part-DB 里没有立创订单编号的零件，按“原来在哪”分组——旧盒号从旧库存表
    （import_legacy_xlsx.build_rows 的收纳位置）取，淘宝/手上原有一组；组内按新格子顺序排，
    明纬电源（层架）不列。输出 收纳/非立创料位置表.html + .pdf（155 项，5 页）。
    - partdb_parts.fetch_parts 多返回 lot_desc（各批次说明），用来区分同一零件的旧库存批次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
2026-10-26 MAX6921AWI 库存按用户清点改为 4 片（自购清单写 2）
    Part-DB 批次数量 2→4，备注写在批次 comment 里；批次说明保持“淘宝第一批（自购清单）”不变，
    因为 import_taobao_lists.py 按说明判断是否已导入，改了说明重跑会重复加批次。脚本里数量同步改 4。
2026-10-26 前壳丝印设计稿：米白喷粉 + 黑色丝印，只印确定不变的内容
    用户 2026-10-27 定：表面处理由拉丝阳极改为米白喷粉 + 黑色丝印；功能未定的件不印字，以后贴标签。
    - silkscreen.py：丝印图形定义（Bahnschrift 字体转填充多边形，带孔）。
    前面板：机名 MIS-01 + MULTI-INDICATOR STATION（EL 视窗上方，左右与视窗边对齐）。
    斜面：模式旋钮档位 1–5（45° 一格，1 在左）、两根推子 0–10 刻度（上根在槽上方、下根在槽下方）、
    三个钮子名称 HOST / HV / DISPLAY 和 ON（上）/ OFF（下）。方键、编码器、推子用途、USB 不印。
    check() 查丝印离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
2026-10-26 UC3843AN 库存按用户清点改为 6 个
    原按“够 3 块 HV-UNI 用”估记 3 个，用户清点实有 6。Part-DB 批次数量改 6、说明去掉“实际数待核”，
    脚本里同步改（说明保持一致，免得重跑重复建批次）。
2026-10-26 修复 import_taobao_lists.py 语法错误（79ff62e 引入）
    上一笔用替换改 UC3843AN 数量时，行尾注释写在了元组的右括号前，把 ')' 吞进注释，脚本无法运行。
    把注释挪到 '),' 之后；重跑确认无改动。
2026-10-26 焊接图加“元件作用 + 电路分块原理”说明；网页模板拆到 solder_map_template.py
    用户在学电子，要求焊接图能介绍每个元件的作用和所在部分的电路设计。
    - 内容：el_driver/焊接图/说明/<板名>.json（12 块板，共 625 个位号、93 个电路块），
    每块板 overview + blocks（名称、位号、原理、焊接/上电注意）+ parts（每个位号一句话作用）。
    依据各板设计记录、网表、BOM、上电测试清单写成；按电路推断、资料没写理由的标“（推断）”；
    下单换过的料按实装写并点出 BOM 型号。每份都用脚本核对：BOM 位号全覆盖、块里无多余位号。
    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
2026-10-26 模式开关 MFR01 按 6 档用：文档、零件名、丝印档位 1–5 改 1–6
    用户 2026-10-27 确认（mis-01-5d 转告）：斜面模式开关 MFR01 1 刀 6 位全用，软件也按 6 档；电路本来就是 6 触点 + 7 只 1 kΩ 分压链，不改板。
    - 零件实测记录.txt 第 44 行、面板方案.md 第 27/48 行：「5 档波段开关」改为「6 档旋转开关 MFR01」，
    直接接数字输入的备选改成 6 路。
    - MIS-01整机架构.md 第 78 行：软件先用 5 档 → 软件也用 6 档；第 286 行立创 BOM 说明改为 6 档旋转开关 MFR01 ×2（1 个备用）。
    - assembly_panel.py：装配零件名 Rotary_selector_5pos → Rotary_selector_6pos（仓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
2026-10-26 斜面板设计记录：模式开关 6 档档位约定与压线方法
    用户确认 MFR01 按 6 档用，前壳丝印改为 1–6 档（1 左下、6 右下，memory-69 4aa2e1d）。
    约定 1 档 = J_MODE 2 脚（触点 0，约 1/7 VREF）… 6 档 = 7 脚（约 6/7），读数随档位单调上升，
    写 Pico 固件时直接按此映射；压线时旋到 1 档用万用表找与公共片相通的焊片接 2 脚，顺时针依次接 3–7。
2026-10-26 直插电阻统一放“电阻盒”，B01–B03 空出
    用户反馈小抽屉放不下，已把 B01–B03 的直插金属膜电阻全部挪进单独一个盒子。
    - storage_plan：B01–B03 标签改为空（备用）；OUTSIDE 加“电阻盒”；_resistor 里按量级分 6 格的规则
    改为有阻值的直插电阻一律去电阻盒（功率电阻 B04前、0Ω B04后、贴片 B05 不变）。
    - Part-DB：apply_storage_locations 执行，64 个批次 B01前…B03后 → 电阻盒，重跑 0 改动。
    - 重新生成收纳标签/对照表/非立创料位置表和 12 块板焊接图（电阻行格子显示“电阻盒”）。
2026-10-26 设计记录/上电测试清单：按网表与 BOM 核对更正 14 处过时或矛盾的文字
    写焊接说明时发现，逐条对照网表、BOM、仿真报告核实后改（原句保留，加“2026-10-27 核对更正”）：
    - HV-UNI：料单 10 k、1 k 各是 3 只（R4/R16/R18、R7/R17/R20）不是 2 只；过压保护以仿真为准——
    Q2 线性导通把输出稳在约 324 V，不是“每周期立即关断”。
    - EYE-6E2：进板高压电容是 100 nF/630 V CBB + R_BL1/R_BL2 2×470 k（原写 400 V 薄膜 + 1 MΩ）；
    J_HH 从 1×20 排母剪（原写 1×40）；“J_HH 显示为 Mill-Max”已过时。
    - NIXIE-DRV：两处“HV-UNI 调到 170 V”指向 D1.1 复查后的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
2026-10-27 焊接图加认料辅助：立创商品图、电阻色环、瓷片代码、电解极性
    用户想在网页上看元件长什么样，方便分辨同容值不同耐压/介质的料。
    - bom_locate：读 Part-DB 图片附件（立创导入时存的外链，155 种料有图），locate() 返回 img。
    - 页面：每组料右侧 80px 缩略图（立创 224×224 图，懒加载，加载失败自动隐藏），
    点开看 900×900 大图（坐标纸实拍，可看实物尺寸）；需要联网。
    - 直插电阻按阻值画五色环（1% 金属膜：3 位有效数字 + 倍率 + 棕色误差环，倍率 <1 用金/银），
    直插瓷片/薄膜给出表面三位码（如 100 nF = 104），直插电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
2026-10-27 贴片分立件/阻容/IC 各放一个单独盒子，A04后、A06后、A09、B05、B06 空出
    用户反馈小抽屉放不下，已把贴片料分成三个盒子。
    - storage_plan：OUTSIDE 加“贴片分立件盒”（贴片三极管/MOS/二极管，原 A04后、A06后）、
    “贴片阻容盒”（原 B05、B06）、“贴片IC盒”（原 A09，含 MAX6921）；对应规则改指这三个盒子，
    空出的格子标签改为空；删掉已过时的 EXTRA “MAX6921 到货放 A09前”。
    贴片电感（A13后）、1812 自恢复保险（A12后）用户没提，不动；核对过剩下直插格里没有贴片管子。
    - Part-DB：50 个批次改库位，重跑 0 改动。重新生成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
2026-10-27 新增装配调试流程页：13 个阶段串起焊接、上电测试、固件和整机联调
    电路板全部到货，用户要一份完整的组装/调试流程。
    - build_guide_steps.py：流程内容（每阶段：为什么排这里、焊接图、要嵌的清单节、逐步勾选项；
    “（叫我）”标出要我在电脑上做的编译烧录/配置）。顺序：准备（工具、切斜面缺口、MAX6921 测真伪）
    → 直插热身（键盘板、IN-14 小板）→ HV-UNI ×3 → 回流焊 IV18/电源板/EL-IF → 电源板上电
    → ESP 底板 + 固件 → 辉光/6E2/盖革/IV-18 → 斜面板 → EL 屏链路（最后，屏买不到）→ 整机。
    - make_build_guide.py：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
2026-10-27 下单前审核：按嘉立创钣金 / MJF 规则改孔距、开窗、背盖厚度，出丝印 DXF，表面处理改喷粉
    用户 2026-10-27 定稿丝印（英文、钮子顺序 主机/高压/屏幕、窗口不印字），要求审核全部钣金件和打印件、出最终下单版本。
    对照嘉立创公开规则（T2.0：圆孔离折弯 ≥ 6.0、开窗离折弯 ≥ 8.0、翻边 ≥ 8；丝印字高 ≥ 2、线宽 ≥ 0.2、字间隙 ≥ 0.3；
    MJF 100 mm 以上零件壁厚 ≥ 2.0、最小孔 1.5）。“离折弯”的量法官方没写，按到相邻面外表面量，图上注明请嘉立创审图确认。
    改模型：
    - 键盘座 3 颗 M3 螺丝：孔心离斜面下沿 3.3 → 5.0（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
2026-10-27 键盘座打印件颜色改为 PA12 天然灰（不染色）
    用户 2026-10-27 选嘉立创 3D 打印材料“PA12”（HP MJF）不染色。天然色是中灰，不是灰黑（灰黑色的是 3201PA-F）。
    整机架构、parts_dock 说明、export_enclosure 下单说明和参考图标题里的“染黑”改为“天然灰、不染色”，背盖同材料同色。
2026-10-27 键盘座背盖防翘：上沿加 T 形加强（外肋 3×2 + 内翻边 2×2）
    嘉立创审单反馈背盖（320×12×2 平片，只两端 4 颗 M2 固定，中间下沿还有 46 宽出线口）MJF 打印易变形。
    整体加厚不行：往外加 1 mm 就碰下巴托（探测重叠 24 mm³）。改为截面加强：
    - 上沿外肋：往外凸 3、高 2，|X| ≤ 145（让开上排 M2 螺丝头 X 150.5），探测与整机零件无干涉；
    - 上沿内翻边：伸进座子 2、高 2，贴在顶板下面兼作定位；座子内 10 道横筋处开缺口（每边留 0.3），
    横筋位置提成 RIB_X 常量，座子和背盖共用。
    截面惯性矩约为原平板的 5 倍以上。新背盖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
2026-10-27 前壳压铆螺母方向改正：从翻边内侧压入，外侧平齐
    嘉立创工程师核对：2D 图写“从外侧压入”，与功能相反。CLS 压铆螺母凸台留在压入面、另一面平齐；
    翻边外侧要紧贴下巴托侧板（螺丝从侧板外面拧入），所以必须从内侧压、外侧平齐。图纸引线、技术要求第 7 条
    和下单说明同步改正，并写明前壳无攻牙、沉孔 3 个（原第 7 条“开孔尺寸已按实测核对”是内部记录，删去）。
2026-10-27 钣金图纸接地点写明具体孔位：侧板两面遮蔽，背板、IEC 小板指定孔
    原侧板、背板只写“一个 M4 孔背面遮蔽”，没指明哪个孔；侧板左右同件、装另一侧要翻面，单面遮蔽会落错面。
    - 侧板：后边一列最下面的 M4（孔心离后边 12、离下边 44），两面 Ø12 遮蔽；写明 M4 ×8、长孔 ×24。
    - 背板：离 IEC 缺口最远一侧的下角 M4（离侧边 10、离下边 40），内侧遮蔽；写明长孔 ×18。
    - IEC 小板：三个 M4 占三个角，接地点是与空角成对角那个；注明 IEC 座 M3 孔为 Ø3.5（STEP 实际值）。
    孔位、孔数均用 STEP 逐个统计核对过。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
2026-10-27 焊接图标出旧库存件和原盒号（用户部分旧库存没收进柜子）
    用户说部分旧库存件（主要是三极管）没有收进元件柜，要在焊接图上区分库存件和新买的件。
    - import_legacy_xlsx.legacy_boxes()：从旧库存表读“零件名 → 原盒号”（在途的不算），
    原 make_nonlcsc_list.old_boxes 挪过来共用。
    - bom_locate：Locator 读旧表（读不到只是不标），locate() 多返回 old（[零件名, 原盒号]）和 allOld。
    - 页面：格子旁加橙色标签“旧库存 · 原 T-01 盒”；同一行既有新买又有旧库存的显示“含旧库存”，
    悬停看是哪几种料。辉光驱动板备注补 K155ID1 是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
2026-10-27 MAX6921 脚位与测真伪接线示意图（png/31），装配流程里引用
    用户看上电测试清单 8a 时分不清 SOIC-28 的脚怎么数。
    - fig_max6921_pinout.py → png/31_max6921_pinout.png：左图芯片俯视，1 脚圆点 / 倒角长边，
    1–14 沿左边往下、15–28 沿右边往上（逆时针）；右图同一芯片标出测试座在面包板上每只脚接什么
    （VCC 3.3 V、VBB 12 V 限流、CLK/LOAD 10 k 下拉、DIN 跳线、DOUT 与 OUT0–19 量对地电压），
    脚位按清单 8a，与 IV18 网表一致。
    - .gitignore：png/ 默认仍不进仓库，单独放行这张（用户要求推送）。
    - 装配调试流程阶段 0 的 MAX6921 一步指向这张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
2026-10-27 放行装配流程与装配说明引用的示意图进仓库
    用户要求把网页相关的示意图都推送。装配调试流程直接引用 png/28（斜面板切缺口）、png/31（MAX6921，
    上一笔已加）；阶段 9 指向的 MIS-01装配说明.md 引用 png/20 前面板、22 爆炸图、26 下巴、27 钻孔图。
    .gitignore 逐个放行这 9 张（约 4 MB），其余渲染图仍不进仓库。
2026-10-27 MAX6921 测真伪接线图（png/32）：测试座针插不进面包板时用杜邦线母头套针
    用户实测 SOP28 翻盖测试座底下的针插不进面包板（针粗/短），问有没有测试电路图。
    - fig_max6921_test.py → png/32_max6921_test_circuit.png：只画要接线的 8 只脚（1 VBB、2 DOUT、13 BLANK、
    14 GND、15 CLK、16 LOAD、27 DIN、28 VCC），杜邦线母头直接套座子针，面包板只放 100 nF、两只 10 kΩ
    下拉和电源；OUT0–19 不接线、表笔直接点针；标明公共地和上电顺序。
    - 上电测试清单 8a 器材说明、装配调试流程阶段 0 都指向这张图；.gitignore 放行 png/32。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
2026-10-27 装配调试流程页直接嵌入示意图（缩略图 + 点开看大图）
    用户希望示意图直接放进网页，不用另找文件。
    - build_guide_steps：阶段加 figs 字段；阶段 0 嵌 png/28 斜面缺口、31 MAX6921 脚位、32 测试接线，
    阶段 9 嵌 22 爆炸图、26 下巴、27 钻孔图、20 前面板。
    - make_build_guide：按 figs 生成缩略图网格（相对路径 ../../png/，仓库里已放行这几张，
    文件不存在直接报错），点击全屏看大图。
2026-10-27 MAX6921 脚位图补“半圆缺口”认 1 脚法，测试座说明改为杜邦线套针 + 通断确认
    用户的 MAX6921 没有圆点、只有一头半圆缺口，且首次测试 VBB 电流 40 mA、DOUT 恒 0，疑似芯片在座里放反。
    图上加缺口示意与文字（缺口朝上、左边第一只是 1 脚）；右侧去掉已不适用的“插面包板”说明，
    改为指向 png/32 杜邦线接法，并提示合盖后用通断档确认 1、28 号针通到芯片对应脚。
2026-10-27 零件实测记录：IN-14 电木底座直径 18.5（用户 2026-10-28 实测）
    底座贴小板焊会压到 IN14-SOCK 正面 R_A（离管心 8.6，压约 0.65），R_A 改从小板背面装。
    整机模型核对：6 块小板背面 R_A 位置（y 34.35–36.85、z 114.1–116.6）都没有零件；正下方最高是 IV-18 板元件 z 105.1（管 4），
    IV-18 玻壳在 y ≤ 22、驱动板从 y 40 起、IV-18 端板 x ≤ 146.6，都不碰。底座厚、引线伸出长度仍未量。
2026-10-27 IN-14 小板返工改版 D1.1：正面只装管子（电木底座平贴），R_A/R_PR/R_PL 全部移到背面
    用户实物 IN-14 带电木底座（Ø18.5、全高 55）。D1 按“光玻壳悬空 4 mm”设计，R_A 卧装在玻壳下、
    R_PR/R_PL 0805 在管心 7.4–9.2 mm 内，R_A 正面焊点也在底座圈内，全部被底座压住，D1 板作废。
    （10-22 复查 G3 已提示随管垫子可能压 R_A，当时只核了引线圆就结案，未追问垫子尺寸。）
    - PCB（EDA，DRC 0 错误）：R_A、R_PR、R_PL 翻到背面；R_A 挪到 (7.25,22.6)，焊点离管心 10.8/13.6 mm 在底座外；
    重布 HV/AN/DP/PR/PL/K0–K9：高压 1.3 mm，DP/PR/PL 对阴极 ≥0.5 mm、M3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
2026-10-27 斜面电路板补固定：两根 M3 铜柱粘在斜面内表面（前壳已下单，不开孔）
    问题（mis-01-5d 复查 SLANT-KBD N3）：前壳斜面没给斜面电路板留任何固定孔，板子只靠推子拨杆和编码器套筒挂着，
    按编码器会把板往后推。下单前审核时只核了孔的工艺规则，没核“每个装在斜面上的件怎么固定”，漏掉了。
    前壳已在嘉立创下单。补救不改钣金：板上沿两个 M3 孔 (12,68)(142,72)（斜面 (29,68)(159,72)）各拧 M3×6 铜柱 + 垫片，
    垫片用 AB 胶粘在斜面内表面（先打毛喷粉），板装上时由编码器轴和推子拨杆自动对位。下沿两个板孔不用（螺丝头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
2026-10-27 复审“焊前必看”写进焊接图和装配流程（assembly_issues.py）
    用户要求把 10-28 全板复审查出的问题都写进网页。板子除 IN-14 小板外都不用重做，但这些事项不照做
    会装不上、装错或有隐患：
    - assembly_issues.py：按板子列出焊前/装配必看（共约 80 条，每条写做什么 + 原因），另有线束通用条目。
    要点：EL-IF 2×6 线必须做镜像线并量信号脚、DIP-20 座孔距差 0.16；电源板保险座试插、NID100 防反插数针、
    TPS259470 IN–OUT 连锡检查；IV-18 端板榫头锉窄、不用扎带改硅胶、装机顺序；辉光 C12 卧装；
    HV-UNI 先热风焊 L1/RS1、板底剪脚 ≤1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
    [assembly_issues.py, build_guide_steps.py, make_build_guide.py, make_solder_map.py]
2026-10-27 IN-14 小板 D1.1：用户用旧板试插确认孔位没问题，引线孔保持 0.9，可以下单
    去掉焊前必看里“下单前试插”一条，设计记录写明结论，装配流程阶段 1 同步。
    [assembly_issues.py, build_guide_steps.py]
2026-10-27 EL-IF 新安装位置写进焊前必看：电脑层板下、屏背后，屏线约 12 cm
    用户确认模型会话的方案（无干涉即可）和屏 CN5 实物位置：M3×30 铜柱吊在层板孔阵下，层板自开 Ø25 过线孔；
    用户问是否必须沉头：香橙派（架高 25）和空位两孔普通圆头即可，Hub、Dock（架高 6、板底有焊点）两孔装前比一下，
    顶到焊点才锪沉头或换薄头螺丝。写明各线长度与 J_PF 绕开高压区的走法。
2026-10-27 EL-IF 焊前必看与模型会话的加工图对齐：4 个吊装孔都锪沉头，EL-IF 先于 Pi/Dock/Hub 安装
    模型会话已把 P2 层板加工图改为 2-13 Ø25 过线孔 + 2-14～2-17 四孔锪沉头，用户也准备买 90° 倒角器，
    所以不再写“比一下再决定”，统一锪沉头配 M3×8 沉头螺丝；补上装配顺序（EL-IF 要先吊上去、线先插好）。
2026-10-27 EL 接口板改吊电脑层板下、屏幕正后方（用户 2026-10-28 确认）
    原因：原暂定吊在顶板下（x 160–260、y 40–140、z 410），到屏 CN5 的 DF11 线要 40–45 cm；用户手上只有一根 20 cm，
    屏规格书最长 50 cm、设计笔记建议 10–20 cm（5.4 MHz）。新位置：
    - 元件朝上、绕 Z 转 180°（全局 = (240 − lx, 160 − ly)），板占 x 140–240、y 60–160，板面 z 230；
    4 根 M3×30 母母铜柱挂在层板孔阵孔 (145/235, 65/155) 上，层板上面锪沉头（3 颗在 Hub、Dock、Pi 下面）。
    - J_EL 在 (149.3, 113)、插头朝 −x，DF11 从板左边外面到 CN5（x 160、y 26.5、z 229，用户确认）约 12 cm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
    [parts_list.csv]
2026-10-27 重出爆炸图 22 和下巴图 26：EL 接口板移到电脑层板下（87f8166）后的整机
    EL-IF 不再画在顶板下，改为吊在电脑层板下；下巴图同时带上斜面电路板两根粘接铜柱（b0ca528）。
    01–07 也已重出（不进 git）。
2026-10-28 ESP 固件 0.2.1 / 规格 v0.9.8：IV-18 显示网络电台（VFD RADIO）
    用户要求加网络电台：Pi 播放，ESP 只负责在 IV-18 上显示。
    - 规格：F5 AUTO 轮换末尾加"电台"项，G1 点亮表示在播；6.8 新增 VFD RADIO "<文本>" [T=s] / VFD RADIO OFF；
    第 4 节加 Pi 侧 mis01radio 服务的要求（每 30 s 重发 T=90 续期、调音量发 VFD SHOW "UOL nn" T=2）。
    - vfd.c：新增 vfd_radio()；电台项不切 HOST，Pi 的 VFD SHOW 仍优先；新设或换了文字时立即切到该项（擦除动画），
    同样文字重发只续期、不打断轮换；T= 到期或全部退回 AUTO（DTR 掉、PI_RUN 低）时去掉。
    - dispmode：加 dm_reset_count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
2026-10-28 Pi 新增网络电台服务 mis01radio：mpv / Chromium 播放，管理网页可改每台的 IV-18 文字
    声音走 Pi 耳机口 → PAM8403 → 两只喇叭；放的时候经 esp.sock 发 VFD RADIO 让 IV-18 显示电台。
    - 管理网页 :8080：电台表增删改排序启用、IV-18 文字边输边出七段预览并可在实物上试显示、播放/换台/音量、
    设置（声卡、代理、浏览器模式、开机续播、网页密码；局域网要 Basic 认证，本机免）。
    - 电台类型可扩展（players/，按 FIELDS 自动生成输入框）：
    stream = 直链，mpv 播放，读 ICY 曲目名；预置 Radio Caroline。
    browser = 只能网页播放的，Pi 上 Chromium（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
2026-10-31 焊接图标明每个元件的正面/背面，修正 IN-14 R_A 与 KBD 排针的焊接面
    - 焊接图每个位号加面标签：贴片件“正面贴/背面贴”；直插件“X 面装 · Y 面焊”（本体在一面、焊点在另一面）。
    位号行、展开说明、焊盘悬停都显示；页面顶部加“正面/背面”图例。
    - 新增“成品示意”开关：按封装外形画出焊好的样子（L/W、0805/0603、焊盘包围盒、XH 座按 7.5 mm），
    正面蓝、背面橙、不焊虚线；IN-14 管子按电木底座 Ø18.5 画圆。
    - 修正 IN-14 小板：R_A、J1 本体在背面、焊点在正面（原写“从背面焊”，与设计记录“正面焊点”及
    “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
    [build_guide_steps.py, make_solder_map.py]
2026-10-31 焊接图给特殊焊法的元件加“特殊焊法”标签
    - 新增 weld_special.py：按板/位号记录不照做会装不上或装错的元件级焊法，例如
    NIXIE-DRV C12 朝 −x 卧倒、HV-UNI C10/C6/C7 掰脚到 5.0 mm、SLANT C12A 抬高 1 mm 往 +y 掰、
    PWR-DIST C_IN5/C_IN12 贴板略偏、EL-IF C1/C2 立正、Q1 立装套热缩、L1/RS1 大焊盘先焊、
    6E2 管座焊片剪短、GEIGER J_HV 焊点套热缩等。
    - make_solder_map.py 把特殊焊法挂到组和位号；页面行里显示橙色“特殊焊法”标签，
    展开行和焊盘悬停提示里有具体做法。
    - 重新生成全部焊接图和装配调试流程。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
2026-10-31 HV-UNI 过压保护实测：Q2 未过压微导通，207 V 提前钳位
    - 实测：RV1 减到约 5.2 kΩ 后输出停在 207 V；U1-2 VFB=1.726 V（分压比正确）、U1-3 ISENSE=0.897 V、
    12 V 输入仅 42 mA；断开 R20（Q2 集电极到 ISENSE）后输出可到 300 V。
    - 原因：TL431 关断时阴极不是硬 5 V，实测 U2 的 1/2/3 脚=1.58/0/4.2 V；4.2 V 经 R19 2.2 k 与 R18 10 k
    分压把 Q2 基极抬到约 4.35 V，Vbe≈0.65 V，2N3906 微导通（Ic≈0.9 mA），经 R20 把 ISENSE 抬到 0.9 V。
    OVP 分压本身正确（1.58 V 对应 207 V，门限仍 322 V）。
    - 修法：U2 3 脚到 VREF 5 V 加一只 10 kΩ 上拉（或 R19 2.2 k 改 10 k；R18 10 k 改 4.7 k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
2026-10-31 HV-UNI 仿真报告补记：Q2/TL431 关断偏置未被行为模型捕捉
    - 实测 207 V 提前钳位：TL431 关断时阴极只有约 4.2 V（不是理想高阻 5 V），2N3906 在 Vbe≈0.65 V 时
    已有约 0.9 mA 集电极电流（亚阈值导通），经 R20 把 ISENSE 抬到 0.9 V。
    - 仿真模型把 TL431 当理想高阻、Q2 当理想开关，且只验证了 OVP 在 R8 开路时的 324 V 钳位，
    没验证正常 207/296 V 时 Q2 必须截止；以后这类保护要加关断漏电流/最坏 Vbe/温度检查。
    - 与设计记录 2026-11-01 的实测条对应。
2026-10-31 焊接图点击焊盘显示位号；页面布局改为 flex，底部提示不再被裁掉
    - 点击任意焊盘：左下角显示“位号.脚号 · 值 · 网络（正面/背面）”，该焊盘加白边高亮，
    同时选中对应元件行并滚动到那一行；点空白处恢复“滚轮缩放，拖动平移”。
    用来解决丝印位号和元件位置对不上时认不出焊盘的问题。
    - 页面布局改成 body flex：header 高度随两行说明自动变化，main 填满剩余高度，
    #tip 不会被挤出窗口；手机宽度下恢复整页滚动。
    - 重新生成除 KBD 外的全部焊接图（KBD 页面含另一会话未提交的 KBD 改动，留给那边一起提交）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
2026-10-31 HV-UNI OVP 实测补记：R19 单独改 10 k 不够，必须加 10 k 上拉
    - 用户把 R19 2.2 k 改 10 k 后输出仍 205 V；U2 1/3 脚 = 1.59/3.69 V，阴极从 4.2 V 反而降到 3.69 V，
    Q2 仍微导通。原因：TL431 关断时阴极是高阻，Q2 基极电流经 R19 把阴极拉低，Vbe 仍约 0.65 V；
    R19 10 k 单独不能把 Q2 关死。
    - 修法改为：U2 3 脚（阴极）到 VREF 5 V 加 10 kΩ 上拉；R18 10 k 改 4.7 k 可作无飞线备选，需实测。
    - 更新 HV-UNI 焊接图说明、设计记录、assembly_issues 焊前必看；装配调试流程含另一会话 KBD 改动，未重新生成。
2026-10-31 HV-UNI 改装说明补全：10 k 上拉跨焊 R19.2(OVK)—R18.1(VREF)，R19 10 k 可保留
    - 不用碰 U2 的 TO-92 小脚：R19 的 2 脚（OVK，U2 阴极同网络）与 R18 的 1 脚（VREF 5 V）并排，
    底部焊盘相距约 2.6 mm，10 kΩ 直接跨焊即可。
    - 明确 R19 已改 10 k 可保留，不必换回 2.2 k；导通基极电流约 0.15 mA，仍够。
    - 更新 HV-UNI 页面顶部说明、过压保护段、R18/R19 元件说明、设计记录和焊前必看；
    装配调试流程含另一会话 KBD 改动，未重新生成。
2026-10-31 焊接图把改装飞线当成一个零件：HV-UNI 10 k 上拉显示 R18.1—R19.2 两个焊盘
    - 数据里新增 MODS：HV-UNI 的改装项“10 kΩ 上拉（改装）”，from=R18.1、to=R19.2。
    - 页面顶部新增“改装 / 飞线”一栏，像零件一样列出：
    * 名称“10 kΩ 上拉（改装）”，网络 R18.1 · VREF ↔ R19.2 · OVK；
    * 点中这一行，板上只高亮这两个焊盘（黄边）并画一条虚线，直接看出要飞的两个点；
    * 带复选框，可标记改装完成。
    - 页头说明也写了这两个焊盘并排、底部相距约 2.6 mm，R19 保持 10 k 不用换回。
    - 只重新生成 HV-UNI 页面；其他板没有改装项。
    Co-Authore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
2026-10-31 HV-UNI 上拉改为 2.2 k：10 k 时 TL431 阴极电流仅约 0.5 mA，低于 1 mA 最小值
    - 电流核算：未过压时上拉两端都是 5 V，电流≈0；过压时 TL431 阴极约 2 V。
    10 kΩ 只贡献约 0.3 mA，加 R19 约 0.15 mA，合计约 0.5 mA，低于 TL431 手册的 1 mA 最小阴极电流；
    2.2 kΩ 贡献约 1.36 mA，合计约 1.5 mA，落在 TL431 的 1–100 mA 范围内，电阻功耗约 4 mW。
    - 2.2 kΩ 正好可以复用从 R19 拆下来的那只直插电阻；10 kΩ 贴片库存 0805 100 只、0603 100 只，
    但这里不是合适值。R19 保持 10 k 不用换回。
    - 更新改装项名称/说明、HV-UNI 页面、设计记录和焊前必看。
    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
2026-10-31 HV-UNI 上拉补充：2.2 k 用直插（R19 拆下来的那只），没有 2.2k 贴片
    - Part-DB 没有 2.2 kΩ 贴片；2.2 kΩ 直插有 100 只，R19 拆下来的那只正好复用。
    - 如坚持贴片：2×4.7k 0603 并联≈2.35k（4.7k 0603 库存 100），或 4×10k 0805 并联=2.5k；
    单个 10k/4.7k 贴片对 TL431 的 1 mA 最小阴极电流偏小。
    - 更新改装项说明、HV-UNI 页面、设计记录和焊前必看。
2026-10-31 HV-UNI 其余板明确：R19 保留 2.2 k 或 10 k 都行，只加上拉，不用拆
    - 用户已在一块板上飞好 2.2 k 上拉，电压正常。其余板不需要把 R19 的 2.2 k 拆掉；
    上拉负责关断，R19 2.2 k 反而给 Q2 略多的基极驱动（约 0.245 mA，10 k 约 0.15 mA）。
    - 三块板唯一必须做的改装都是在 R18.1(VREF) 与 R19.2(OVK) 之间加 2.2 kΩ 上拉。
    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
2026-10-31 HV-UNI 上拉说明更正：TL431AILP 最小阴极电流是 400 µA；记录新版本 R24
    - 查 EDA 里这颗 TL431AILP 的参数：Minimum Cathode Current = 400 µA，不是 1 mA。
    10 k 上拉约 0.46 mA 刚过最小值（余量小），2.2 k 约 1.5 mA 余量大，仍选 2.2 k。
    - 新版本 EDA 已改：原理图加 R24 2.2 k（OVK—VREF），PCB 导入并放在 R17/R13 之间
    （x1735、y275.6 mil），R19 保持 2.2 k。PCB 新线在底层与 OVB/OVS/GND 铺铜有 DRC 冲突，
    下一版走顶层或重铺铜后再确认；当前三块板用飞线 2.2 k。
    - 更新 HV-UNI 页面、设计记录和焊前必看。
2026-11-02 HV-UNI 补 J2 单针输出理由：载流余量大、单针分开爬电、与 J1 1×4 防反插
    - J2 只走 ≤20 mA 高压，2.54 针载流约 3 A；回流走 J1 的 GND，HV/GND 不在一排。
    - 单针 + J1 1×4 不对称布局防反插；四根 M3×11 铜柱承力，针不承力。
    - 2.54 排针额定通常 250 V：180–185 V、250 V 正常；296 V 是调压上限，不建议长期。
    - XT30/XT60 是 30 A 航模电池接头，电流余量过大、体积大、2 针把 HV/GND 放一起，不适合；
    要换接头选 ≥300 V、爬电 ≥3 mm 的带键位高压接头（JST VH、Molex Mini-Fit 等），需改宿主板。
2026-11-02 HV-UNI J1/J2 装配面修正：塑料座在底面、短针穿到正面焊（HTML 原标反了）
    - 飞针表按 EDA 元件层把 J1/J2 记成 T，焊接图跟着标成“正面装·背面焊”；
    实际 HV-UNI 是排针从底面插入、塑料座在底面、短针穿到正面焊，叠高 11 = 宿主排母 8.5 + 排针塑料座 2.5。
    - make_solder_map.py 加 MOUNT_OVERRIDE：HV-UNI 的 J1/J2 本体面覆盖为 B，焊点面自动取 T。
    - J2 与 TP1/TP2 同型号，组标签显示“正面+背面（见位号）”，J2 自己的说明是“背面装·正面焊”。
    - 更新 HV-UNI 页面、J1/J2 元件说明和设计记录。
    [make_solder_map.py]
2026-11-02 前面板观察窗亚克力 ×3 加工图；不做市电 / 高压防护罩；记下实际下单与到货试装事项
    用户 2026-11-02 定：亚克力只做前面板三个观察窗，每窗一块；市电端子罩、高压板绝缘罩不做。
    - assembly_panel：ACRYLIC 三块（管龛 152.5×86、6E2 54×59.75、盖革 121.5×22.25，四角 R1，无孔），
    原右边 L 形一块拆成 6E2 / 盖革两块，在两窗之间 5 mm 横条 z 115.5 处分开（各压 2.25）。
    厚 2 → 1.5：窗口下沿 z 96.5 后面就是甲板、盖革夹子板前沿（y 2），2 mm 加胶层会顶上；
    按胶厚 0 / 0.2 / 0.4 用整机零件核对，三块都无重叠（最近：甲板 / 夹子板 0.1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
    [parts_list.csv]
2026-11-02 交接文档补充：已下单几何冻结、外壳加工文件位置、亚克力装在内部、未答复复查项与未实测项
2026-11-03 新增 HDMI 小板焊接方向页，并把测试页链接到各板焊接图
    - HDMI-PI D1 / HDMI-DOCK D1：J1 夹板式 HDMI 公头正反（宽边朝上、奇数脚顶层）；J2 90°/270°；A 型 20P FPC 脚号、J1↔J2 通断和 J1-18 处理
    - MIS-01_上电与联调.html：00–11 阶段、71 个打勾项、阶段门/读数/失败先查；每阶段链接对应焊接图和装配流程 §X，页尾增加全部焊接图索引
    - 说明焊接顺序与测试顺序不同：焊接按工艺，测试按依赖/风险；页面在 el_driver/焊接图/，链接为相对路径
    - 本地链接已校验；打勾只存 localStorage，不上传
2026-11-03 HDMI 方向图改为正交示意：J1 端面、J2 顶视与排线
    - J1 端面改成平坦的正视梯形：宽边朝上、奇数脚顶层、偶数脚底层；去掉透视/板边延伸
    - J2 改成两块板并排的顶视：Pi 90°/Dock 270°、触点面相反、A 型排线平顶走线
    - 保留 J1↔J2 脚号表、J1-18 处理、通断和上电判据
2026-11-03 新增 KBD-ADAPT 排线方向测试页（2026-10-31 实测）
    - 只插排线、不接键盘和 USB，先用蜂鸣挡查 H13-H11 不短路
    - 触点 1–6 与 H_TEST 对照：1 GND/H11、2 +5V/H13、3 D+/H10、4 D−/H8、5 检测/H5、6 GND/H4
    - 记录 R_C6 使 H4/H11 互通、R_DET 不需要、XH 线序和 USB-A 触片认线法
    - 依据设计记录第七节、上电测试清单 3b
2026-11-03 KBD-ADAPT 实测修正与装配流程同步
    - KBD：实测 J_USB-2 = 键盘 D+、3 = D−；K08_DP/K10_DM 网络名与实际相反，更新焊接图、JSON 和装配流程的旧线序
    - KBD 设计记录/上电测试清单 3b：补 2026-10-31 实测、触点与 H_TEST 对照、R_C6/R_DET 结论
    - 装配流程 HV-UNI：10 kΩ 上拉改为 2.2 kΩ，并说明 10 k 单独不够；同步 assembly_issues.py 的 KBD 条目
    - KBD-ADAPT_D1_测试2_排线方向.html 的交叉引用已在 f9729f3 提交
    [assembly_issues.py]
